SnoBotics981/CAD-MfgResources/ThingiVerse/Soldering_Iron_Stand_-_DotScott1_Remix-2088796/images/182017c3a1575a4c88928a121a70b45b_preview_featured.jpg

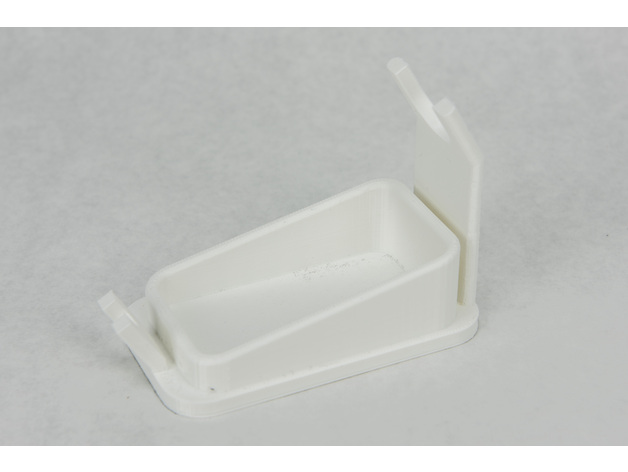
ThingiVerse/Soldering_Iron_Stand_-_DotScott1_Remix-2088796/images/182017c3a1575a4c88928a121a70b45b_preview_featured.jpg
