SnoBotics981/CAD-MfgResources/ThingiVerse/Soldering_Iron_Stand_-_DotScott1_Remix-2088796/images/7b276ec3d47ab2f74ebd15a16277fafa_preview_featured.jpg

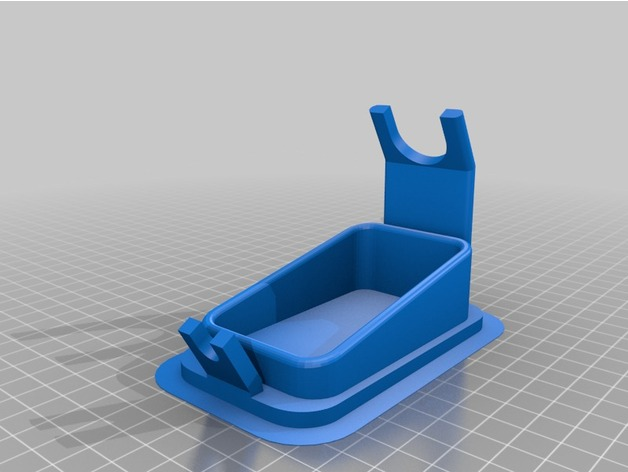
ThingiVerse/Soldering_Iron_Stand_-_DotScott1_Remix-2088796/images/7b276ec3d47ab2f74ebd15a16277fafa_preview_featured.jpg
