SnoBotics981/CAD-MfgResources/README.md

# CAD-MgfResources
This will contain all of the part files from manufactures, which would include Andy-Mark, BostonGears, McMaster-Carr, etc.
