SnoBotics981/CAD-MfgResources/VexRobotics/2017 3CimBallShifter/JVN-DesignCalc.20160126.xlsx

Sheet: READ-ME
JVN DesignCalc - Gearing & Motor Calculator
Release 1/26/2016
Note, this calculator is provided as a design reference ONLY.
I can NOT guarantee the performance of every specific configuration designed by a team.
Contact jvn@vex.com for assistance.
Notes:
 | Drop down cells, used to choose between specifically available options. Click and choose from a list.
 | Entry cells, used to input values specific to the designer's robot. Type custom data.
Release History: |  | http://www.chiefdelphi.com/media/papers/3188?
2015-12-27 | Initial 2016 Release
 | Incorporates the "tested" motor values from motors.vex.com
 | Includes drop-downs to select motors directly from gearing sheets (or you can still enter your own numbers).
 | Includes sheets for design of drivetrains using VEXpro and WCP gearboxes (with drop-down selection of gearing options)
 | Includes a sheet for articulated drives (Butterfly, Octocanum, etc) with different wheel types, and varied gearing between wheels.
 | Some sheets have been simplified for inexperienced users.
 | Sheets have been tweaked to make it easier to have "multiple iterations" on the same worksheet.
2016-01-26 | Added RS-550 Motor Data from motors.vex.com
 | Changed the Motor selection lookup formula on the "non VEXpro" sheets to better allow for multiple iterations on the same sheet
 | Added additional "All MiniCIM" motor selection options on VEXpro sheets
 | Fixed some formatting that no one else would notice but was driving me nuts
 | Added a release history

Sheet: Custom 2-Speed Drive
2-Speed Drivetrain
 |  | Free Speed (RPM) | Stall Torque (N*m) | Stall Current (Amp) | Free Current (Amp) | "Real Life" Speed Loss Constant | Drivetrain Efficiency
 | CIM | 5330 | 2.41 | 131 | 2.7 | 81% | 90%
 | # Gearboxes in Drivetrain | # Motors per Gearbox |  | Total Robot Weight (lbs) | Weight on Driven Wheels | Wheel Dia. (in) | Wheel Coeff
 | 2 | 2 |  | 154 | 100% | 4 | 1.1
 | Driving Gear | Driven Gear |  | High Speed Driving Gear | High Speed Driven Gear | Drivetrain High Gear Free-Speed | Drivetrain High Gear "Real Life" Speed | "Pushing" Current Draw per Motor
 | 12 | 40 |  | 40 | 44 | 12.69 ft/s | 10.28 ft/s | 79.89 Amps
 | 1 | 1 |  |  |  | 7.33 : 1 | <-- High Gear
 | 12 | 24
 |  |  |  | Low Speed Driving Gear | Low Speed Driven Gear | Drivetrain Low Gear Free-Speed | Drivetrain Low Gear "Real Life" Speed | "Pushing" Current Draw per Motor
 | 2.27 x | <--Shifter Spread |  | 24 | 60 | 5.58 ft/s | 4.52 ft/s | 36.66 Amps
 |  |  |  |  |  | 16.67 : 1 | <-- Low Gear

Sheet: VEXpro 3-CIM Ball Shifter
VEXpro 3-CIM Ball Shifter Drivetrain
 |  |  |  |  |  | http://www.vexrobotics.com/vexpro/motion/gearboxes/3cimballshifter.html
 | Choose Gearbox Motors: | Free Speed (RPM) | Stall Torque (N*m) | Stall Current (Amp) | Free Current (Amp)
 | 2 CIM | 5330 | 4.82 | 262 | 5.4
 |  | Wheel Dia. (in) | Wheel Coeff of Friction | Total Robot Weight (lbs) | Weight on Driven Wheels
 |  | 4 | 1.1 | 154 | 100%
 | Select VEXpro Gearbox Options:
 | Choose Motor Pinions: | Standard 12-tooth Pinion [50:12]
 | Choose Low Gear Option: | Low Gear Option 1 (2.16x Shifter Spread) [50:34]
 | Choose 3rd Stage Gearing: | 3rd Stage Option 1 [64:20]
 |  | Driving Gear | Driven Gear
 | External Reduction: | 1 | 1
 | Drivetrain Outputs:
 |  | Drivetrain Free-Speed | Drivetrain "Real Life" Speed | "Pushing" Current Draw per Gearbox | Overal Ratio
 | High Gear Outputs: | 10.26 ft/s | 8.31 ft/s | 130.27 Amps | 9.07 : 1
 | Low Gear Outputs | 4.74 ft/s | 3.84 ft/s | 63.14 Amps | 19.61 : 1
 | Chosen Gearing Config:
 |  | Driving Gear | Driven Gear
 | Initial Gearing Stage: | 12 | 50
 | High Gear Stage: | 50 | 34
 | Low Gear Stage: | 34 | 50
 | 3rd Gearbox Stage: | 20 | 64
 | External Stage: | 1 | 1
 | High-Low Spread: | 2.16 x

Sheet: VEXpro 2-CIM Ball Shifter
VEXpro 2-CIM Ball Shifter Drivetrain
 |  |  |  |  |  | http://www.vexrobotics.com/vexpro/motion/gearboxes/ball-shifter.html
 | Choose Gearbox Motors: | Free Speed (RPM) | Stall Torque (N*m) | Stall Current (Amp) | Free Current (Amp)
 | 2 CIM | 5330 | 4.82 | 262 | 5.4
 |  | Wheel Dia. (in) | Wheel Coeff of Friction | Total Robot Weight (lbs) | Weight on Driven Wheels
 |  | 4 | 1.1 | 154 | 100%
 | Select VEXpro Gearbox Options:
 | Choose Motor Pinions: | Standard 12-tooth Pinion [40:12]
 | Choose 3rd Stage Gearing: | 3rd Stage Option 1 [50:34]
 |  | Driving Gear | Driven Gear
 | External Reduction: | 1 | 1
 | Drivetrain Outputs:
 |  | Drivetrain Free-Speed | Drivetrain "Real Life" Speed | "Pushing" Current Draw per Gearbox | Overal Ratio
 | High Gear Outputs: | 17.25 ft/s | 13.97 ft/s | 215.36 Amps | 5.39 : 1
 | Low Gear Outputs | 7.59 ft/s | 6.15 ft/s | 97.78 Amps | 12.25 : 1
 | Chosen Gearing Config:
 |  | Driving Gear | Driven Gear
 | Initial Gearing Stage: | 12 | 40
 | High Gear Stage: | 40 | 44
 | Low Gear Stage: | 24 | 60
 | 3rd Gearbox Stage: | 34 | 50
 | External Stage: | 1 | 1
 | High-Low Spread: | 2.27 x

Sheet: WCP DS
WCP DS Gearbox Drivetrain
 |  |  |  |  |  | http://www.vexrobotics.com/vexpro/motion/gearboxes/wcp-ds.html
 | Choose Gearbox Motors: | Free Speed (RPM) | Stall Torque (N*m) | Stall Current (Amp) | Free Current (Amp)
 | 3 CIM | 5330 | 7.23 | 393 | 8.1
 |  | Wheel Dia. (in) | Wheel Coeff of Friction | Total Robot Weight (lbs) | Weight on Driven Wheels
 |  | 4 | 1.1 | 154 | 100%
 | Select WCP DS Gearbox Options:
 | Choose Initial Reduction: | 12:42
 | Choose Low Gear Option: | 24:50
 | Choose High Gear Option: | 30:44
 |  | Driving Gear | Driven Gear
 | External Reduction: | 1 | 1
 | Drivetrain Outputs:
 |  | Drivetrain Free-Speed | Drivetrain "Real Life" Speed | "Pushing" Current Draw per Gearbox | Overal Ratio
 | High Gear Outputs: | 18.12 ft/s | 14.68 ft/s | 228.65 Amps | 5.13 : 1
 | Low Gear Outputs | 12.76 ft/s | 10.33 ft/s | 163.37 Amps | 7.29 : 1
 | Chosen Gearing Config:
 |  | Driving Gear | Driven Gear
 | Initial Gearing Stage: | 12 | 42
 | Low Gear Stage: | 24 | 50
 | High Gear Stage: | 30 | 44
 | External Stage: | 1 | 1
 | High-Low Spread: | 1.42 x

Sheet: Custom 1-Speed Drive
1-Speed Drivetrain
 |  | Free Speed (RPM) | Stall Torque (N*m) | Stall Current (Amp) | Free Current (Amp) | Speed Loss Constant | Drivetrain Efficiency
 | CIM | 5330 | 2.41 | 131 | 2.7 | 81% | 90%
 | # Gearboxes in Drivetrain | # Motors per Gearbox |  | Total Weight (lbs) | Weight on Driven Wheels | Wheel Dia. (in) | Wheel Coeff
 | 2 | 2 |  | 154 | 100% | 4 | 1.1
 | Driving Gear | Driven Gear |  | Drivetrain Free-Speed | Drivetrain Adjusted Speed | "Pushing" Current Draw per Motor
 | 12 | 40 |  | 6.66 ft/s | 5.39 ft/s | 43.23 Amps
 | 14 | 40 |  | 13.97 : 1 | <-- Overall Gear Ratio
 | 15 | 22
 | 1 | 1

Sheet: VEXpro SS,DR
VEXpro Single Speed, Double Reduction Drivetrain
 |  |  |  |  |  | http://www.vexrobotics.com/vexpro/motion/gearboxes/single-speed-double-reduction.html
 | Choose Gearbox Motors: | Free Speed (RPM) | Stall Torque (N*m) | Stall Current (Amp) | Free Current (Amp)
 | 2 CIM | 5330 | 4.82 | 262 | 5.4
 |  | Wheel Dia. (in) | Wheel Coeff of Friction | Total Robot Weight (lbs) | Weight on Driven Wheels
 |  | 4 | 1.1 | 154 | 100%
 | Select VEXpro Gearbox Options:
 | Choose Motor Pinions: | Standard 12-tooth Pinion [40:12]
 | Choose 2nd Stage Gearing: | Standard 2nd Stage [40:14]
 |  | Driving Gear | Driven Gear
 | Additional External Reduction: | 1 | 1
 | Drivetrain Outputs:
 |  | Drivetrain Free-Speed | Drivetrain "Real Life" Speed | "Pushing" Current Draw per Gearbox | Overal Ratio
 |  | 9.77 ft/s | 7.91 ft/s | 124.27 Amps | 9.52 : 1
 | Chosen Gearing Config:
 |  | Driving Gear | Driven Gear
 | Initial Gearing Stage: | 12 | 40
 | 2nd Gearbox Stage: | 14 | 40
 | External Stage: | 1 | 1

Sheet: WCP SS
WCP SS Gearbox Drivetrain
 |  |  |  |  |  | http://www.vexrobotics.com/vexpro/motion/gearboxes/wcp-ss.html
 | Choose Gearbox Motors: | Free Speed (RPM) | Stall Torque (N*m) | Stall Current (Amp) | Free Current (Amp)
 | 3 CIM | 5330 | 7.23 | 393 | 8.1
 |  | Wheel Dia. (in) | Wheel Coeff of Friction | Total Robot Weight (lbs) | Weight on Driven Wheels
 |  | 4 | 1.1 | 154 | 100%
 | Select VEXpro Gearbox Options:
 | Choose Motor Pinions: | 11-tooth Pinion [50:11]
 | Choose 2nd Stage Gearing: | 2nd Stage Option 1 [40:34]
 |  | Driving Gear | Driven Gear
 | Additional External Reduction: | 1 | 1
 | Drivetrain Outputs:
 |  | Drivetrain Free-Speed | Drivetrain "Real Life" Speed | "Pushing" Current Draw per Gearbox | Overal Ratio
 |  | 17.40 ft/s | 14.09 ft/s | 219.81 Amps | 5.35 : 1
 | Chosen Gearing Config:
 |  | Driving Gear | Driven Gear
 | Initial Gearing Stage: | 11 | 50
 | 2nd Gearbox Stage: | 34 | 40
 | External Stage: | 1 | 1

Sheet: Articulating Drive
Articulating Drivetrain
 |  | Free Speed (RPM) | Stall Torque (N*m) | Stall Current (Amp) | Free Current (Amp) | Speed Loss Constant | Drivetrain Efficiency
 | CIM | 5330 | 2.41 | 131 | 2.7 | 81% | 90%
 | # Gearboxes in Drivetrain | # Motors per Gearbox |  | Total Weight (lbs) | Weight on Driven Wheels | Robot (lbs) | Bumpers (lbs) | Battery (lbs)
 | 4 | 1 |  | 154 | 100% | 120 | 20 | 14
 | Drivetrain Config:
 | Primary Wheel Dia. (in) | Primary Coeff |  | Driving Gear | Driven Gear | Primary Free-Speed (ft/s) | Primary Adjusted Speed (ft/s) | "Pushing" Current Draw per Motor
 | 4 | 1.1 |  | 12 | 64 | 17.44 | 14.13 | 108.84 Amps
 |  |  |  | 1 | 1
 | Secondary Wheel Dia. (in) | Secondary Coeff |  | Driving Gear | Driven Gear | Secondary Free-Speed (ft/s) | Secondary Adjusted Speed (ft/s) | "Pushing" Current Draw per Motor
 | 4 | 1.2 |  | 12 | 64 | 7.48 | 6.05 | 52.32 Amps
 |  |  |  | 18 | 42 | 2.333333333 | <--"Shifter" Spread

Sheet: Rotary Mechanism
Rotary Mechanism
 |  | Free Speed (RPM) | Stall Torque (N*m) | Stall Current (Amp) | Free Current (Amp)
 | BAG Motor | 13180 | 0.43 | 53 | 1.8
 | # Motors per Gearbox | Gearbox Efficiency |  | Arm Load (lbs) | Arm Length (in)
 | 1 | 65% |  | 10 | 40
 | Driving Gear | Driven Gear |  | Arm Rotational Speed | Arm Time to move 90-degrees
 | 1 | 10 | No Load: | 169.5 deg/s | 0.53 sec
 | 1 | 10 | Loaded: | 110.7 deg/s | 0.81 sec
 | 18 | 84
 | 1 | 1
 | 466.67 : 1 | <-- Overall Ratio |  | Current Draw per Motor (loaded) | Stall Load
 |  |  |  | 13.33 amps | 28.86 lbs

Sheet: Linear Mechanism
Linear Mechanism
 |  | Free Speed (RPM) | Stall Torque (N*m) | Stall Current (Amp) | Free Current (Amp)
 | BAG Motor | 13180 | 0.43 | 53 | 1.8
 | # Motors per Gearbox | Gearbox Efficiency | Travel Distance (in) | Applied Load (lbs) | Pulley Diameter (in)
 | 1 | 80% | 48 | 154 | 2
 | Driving Gear | Driven Gear |  | Elevator Linear Speed | Arm Time to move Travel Distance
 | 1 | 10 | No Load: | 13.8 in/s | 3.48 sec
 | 1 | 10 | Loaded: | 6.8 in/s | 7.04 sec
 | 1 | 1
 | 1 | 1
 | 100.00 : 1 | <-- Overall Ratio |  | Current Draw per Motor (loaded) | Stall Load
 |  |  |  | 22.52 amps | 304.45 lbs

Sheet: Intake Mechanism
Intake Mechanism
 |  | Free Speed (RPM) | Stall Torque (N*m) | Stall Current (Amp) | Free Current (Amp)
 | BAG Motor | 13180 | 0.43 | 53 | 1.8
 | # Motors per Gearbox | Gearbox Efficiency | Travel Distance (in) | # Intake Sides (1 or 2) | Roller Diameter (in) | Drag Load (lb)
 | 1 | 80% | 40 | 1 | 2 | 10
 | Driving Gear | Driven Gear |  | Intake Linear Speed | Intake Time to move Travel Distance
 | 1 | 10 | No Load: | 138.0 in/s | 0.29 sec
 | 1 | 1 | Loaded: | 92.6 in/s | 0.43 sec
 | 1 | 1
 | 1 | 1
 | 10.00 : 1 | <-- Overall Ratio |  | Current Draw per Motor (loaded) | Stall Drag Load
 |  |  |  | 28.71 amps | 30.45 lbs

Sheet: DATA
Motor Specifications
All specifications listed at 12V based on empirical testing by VEX Robotics, "combined motor" specs calculated using Paul Copioli's "Useful Calculations" spreadsheet.
For testing details refer to: motors.vex.com |  |  |  |  |  | Specs used for VEXpro & WCP Gearbox Calculators
 | Free Speed (RPM) | Stall Torque (N-m) | Stall Current (Amp) | Free Current (Amp) | Power (W) |  | Free Speed (RPM) | Stall Torque (N*m) | Stall Current (Amp) | Free Current (Amp) | Power (W)
CIM | 5330 | 2.41 | 131.00 | 2.70 | 336.29 | 1 Mini CIM | 5840 | 1.41 | 89.00 | 3.00 | 215.58
Mini CIM | 5840 | 1.41 | 89.00 | 3.00 | 215.58 | 1 CIM | 5330 | 2.41 | 131.00 | 2.70 | 336.29
BAG Motor | 13180 | 0.43 | 53.00 | 1.80 | 148.37 | 2 Mini CIM | 5840 | 2.82 | 178.00 | 6.00 | 431.15
775pro | 18730 | 0.71 | 134.00 | 0.70 | 348.15 | 1 CIM + 1 Mini CIM (Copioli) | 5508 | 3.82 | 220 | 8.16 | 550.84
AM 775 | 5800 | 0.28 | 18.00 | 1.60 | 42.52 | 3 Mini CIM | 5840 | 4.23 | 267 | 9 | 646.73
AM 9015 | 14270 | 0.36 | 71 | 3.7 | 134.49 | 2 CIM | 5330 | 4.82 | 262.00 | 5.40 | 672.58
1 CIM + 1 Mini CIM (Copioli) | 5508 | 3.82 | 220 | 8.16 | 550.84 | 1 CIM + 2 Mini CIM (Copioli) | 5593 | 5.23 | 309 | 9.62 | 765.80
1 CIM + 2 Mini CIM (Copioli) | 5593 | 5.23 | 309 | 9.62 | 765.80 | 2 CIM + 1 Mini CIM (Copioli) | 5437 | 6.23 | 351 | 9.15 | 886.78
2 CIM + 1 Mini CIM (Copioli) | 5437 | 6.23 | 351 | 9.15 | 886.78 | 3 CIM | 5330 | 7.23 | 393.00 | 8.10 | 1008.87
BB RS-775-18 | 13050 | 0.72 | 97.00 | 2.70 | 245.99
BB RS-550 | 19000 | 0.38 | 84.00 | 0.40 | 189.02
 |  |  |  |  | 0.00 | 1 Mini CIM | 5840 | 1.41 | 89.00 | 3.00 | 215.58
 |  |  |  |  | 0.00 | 1 CIM | 5330 | 2.41 | 131.00 | 2.70 | 336.29
 |  |  |  |  | 0.00 | 2 Mini CIM | 5840 | 2.82 | 178.00 | 6.00 | 431.15
 |  |  |  |  | 0.00 | 1 CIM + 1 Mini CIM (Copioli) | 5508 | 3.82 | 220 | 8.16 | 550.84
 |  |  |  |  | 0.00 | 2 CIM | 5330 | 4.82 | 262.00 | 5.40 | 672.58
WCP - DS Gear Options
Input Stage
11:42 | 11 | 42
12:42 | 12 | 42
13:42 | 13 | 42
13:40 | 13 | 40
14:42 | 14 | 42
14:40 | 14 | 40
Low Gear Options
14:60 | 14 | 60
24:50 | 24 | 50
High Gear Options
24:50 | 24 | 50
30:44 | 30 | 44
34:40 | 34 | 40
3-CIM Ball Shifter
Initial Stage
Standard 12-tooth Pinion [50:12] | 12 | 50
Optional 11-tooth Pinion [50:11] | 11 | 50
High Gear | 50 | 34
Low Gear Option 1 (2.16x Shifter Spread) [50:34] | 34 | 50
Low Gear Option 2 (2.65x Shifter Spread) [54:30] | 30 | 54
Low Gear Option 3 (3.68x Shifter Spread) [60:24] | 24 | 60
NO 3rd Stage Gearing | 1 | 1
3rd Stage Option 1 [64:20] | 20 | 64
3rd Stage Option 2 [60:24] | 24 | 60
3rd Stage Option 3 [54:30] | 30 | 54
3rd Stage Option 4 [50:34] | 34 | 50
2-CIM Ball Shifter
Initial Stage
Standard 12-tooth Pinion [40:12] | 12 | 40
Optional 11-tooth Pinion [40:11] | 11 | 40
NO 3rd Stage Gearing | 1 | 1
3rd Stage Option 1 [50:34] | 34 | 50
3rd Stage Option 2 [54:30] | 30 | 54
3rd Stage Option 3 [60:24] | 24 | 60
3rd Stage Option 4 [64:20] | 20 | 64
Standard 2nd Stage [40:14] | 14 | 40
Optional 2nd Stage [34:20] | 20 | 34
Optional 2nd Stage [30:24] | 24 | 30
WCP - SS Gear Options
Input Stage
11-tooth Pinion [50:11] | 11 | 50
12-tooth Pinion [50:12] | 12 | 50
13-tooth Pinion [50:13] | 13 | 50
14-tooth Pinion [50:14] | 14 | 50
Second Stage
2nd Stage Option 1 [40:34] | 34 | 40
2nd Stage Option 2 [44:30] | 30 | 44
2nd Stage Option 3 [50:24] | 24 | 50
2nd Stage Option 4 [54:20] | 20 | 54
2nd Stage Option 5 [60:14] | 14 | 60
