SnoBotics981/CAD-MfgResources/Andy-Mark/Pixy Camera/PixyCam+Pinout+Graphic.pdf

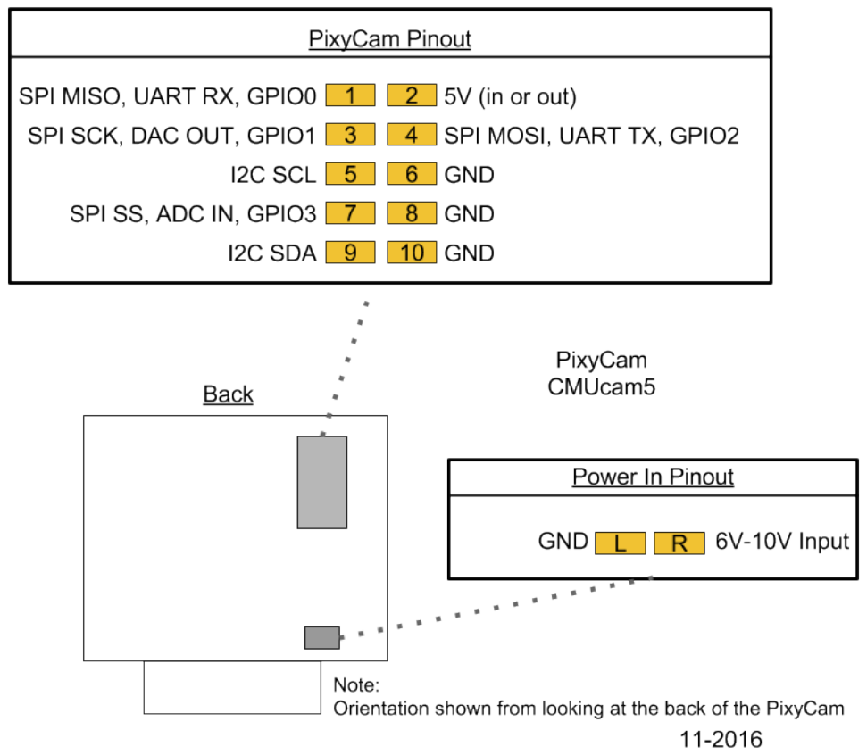
[picture p6: page 1]
