SnoBotics981/CAD-MfgResources/Andy-Mark/2018 Kit Bot/AM14U3_2018BumperAttach.pdf

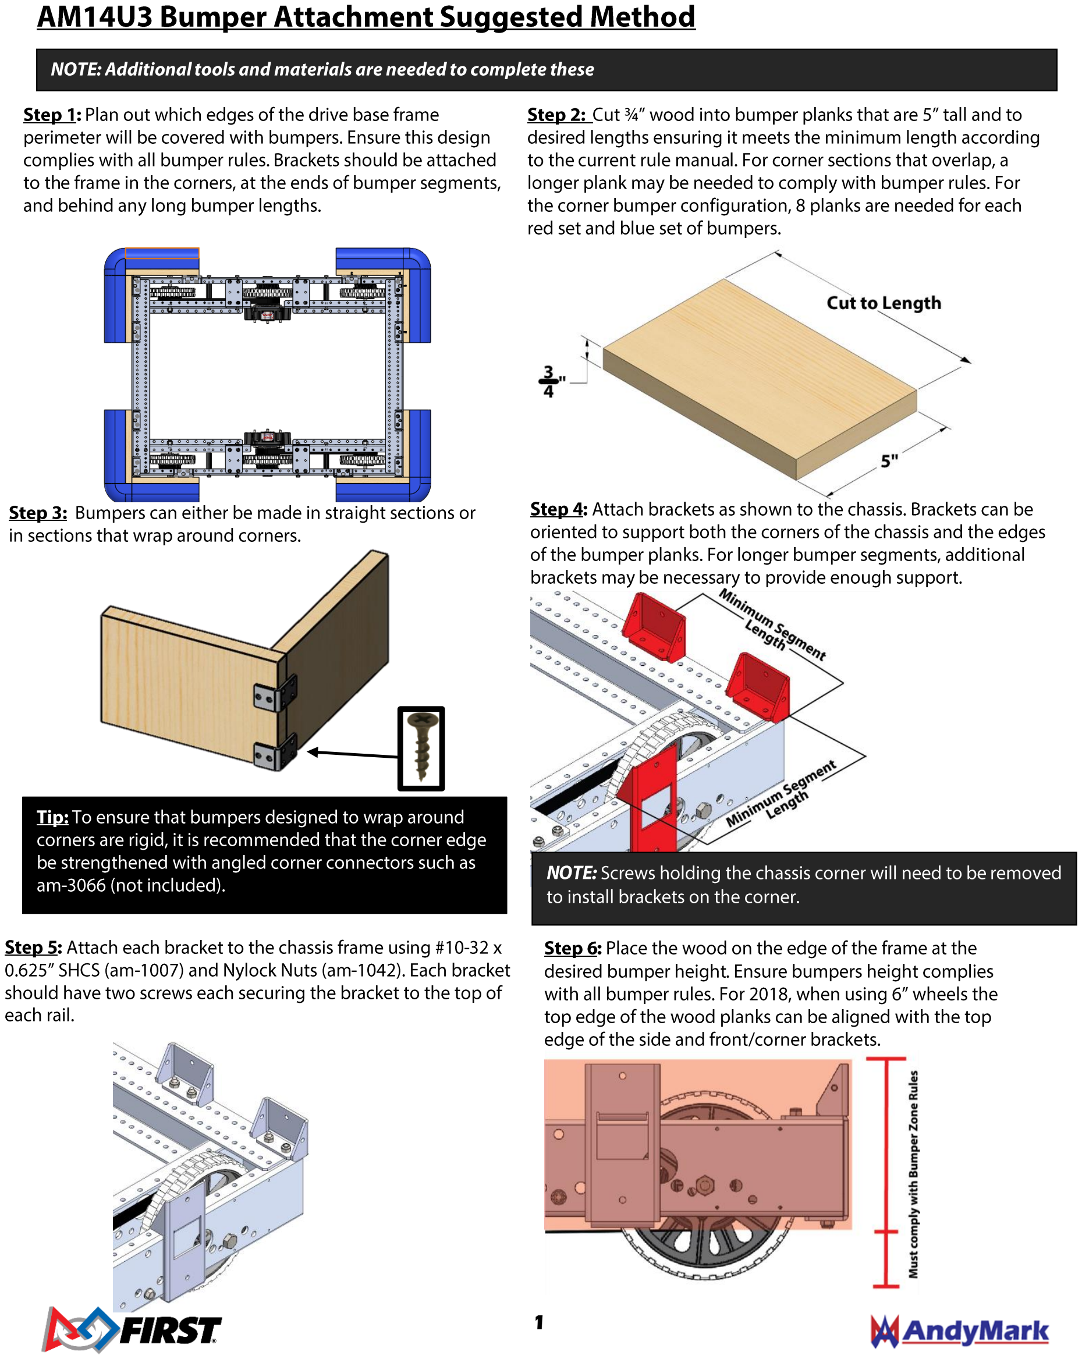
[picture p7: page 1]

1

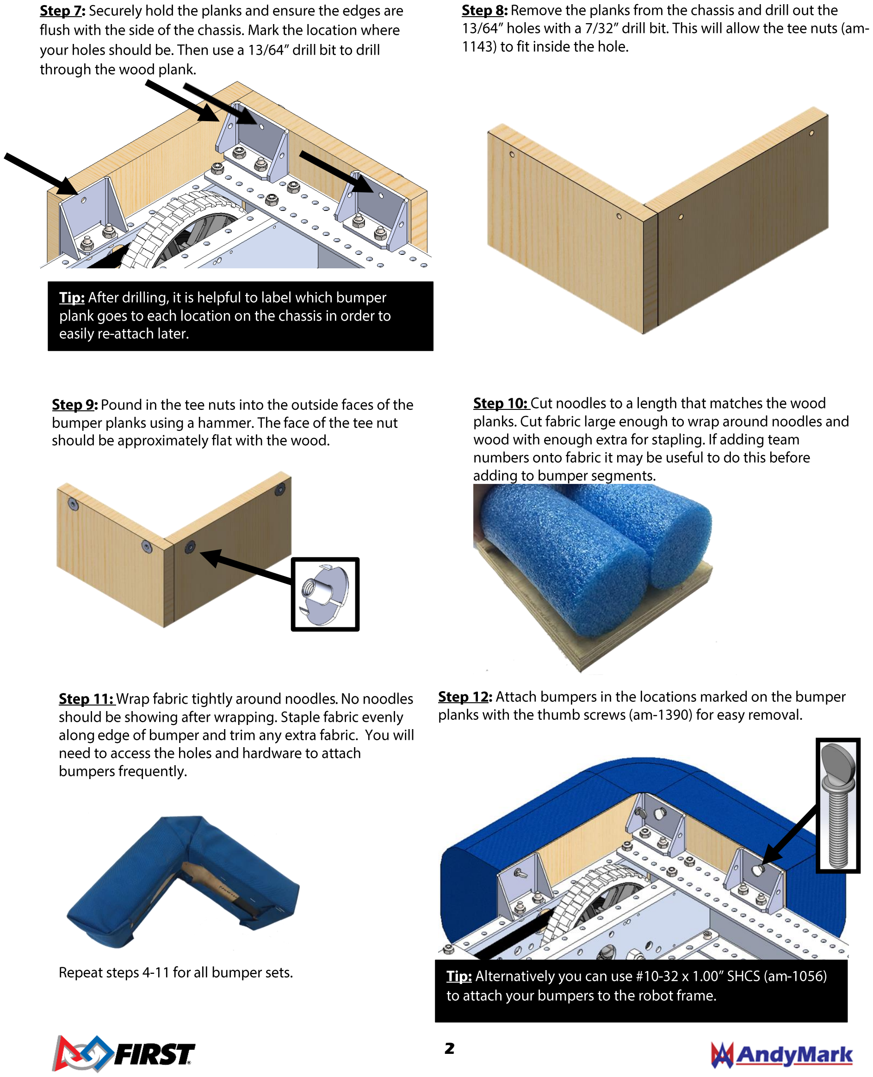
[picture p8: page 2]

2
