SnoBotics981/CAD-MfgResources/Andy-Mark/AM14U3BumperKit/am-3676+AM14U3_2018BumperAttach.pdf

1


2
