SnoBotics981/CAD-MfgResources/Andy-Mark/Pixy Camera/ProgramExample.pdf

Pixy_Example.png (PNG Image, 445 × 234 pixels) | http://files.andymark.com/Graphics/Pixy_Example.png

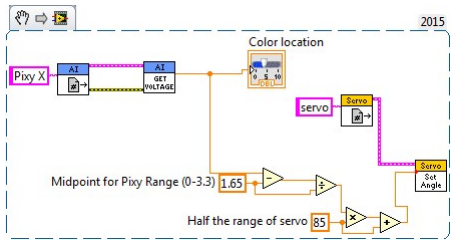
[picture p9: figure]

1 of 1 | 8/9/2017 7:49 AM
