SnoBotics981/CAD-MfgResources/Andy-Mark/2017 Kit Bot Chassis/16-01.png

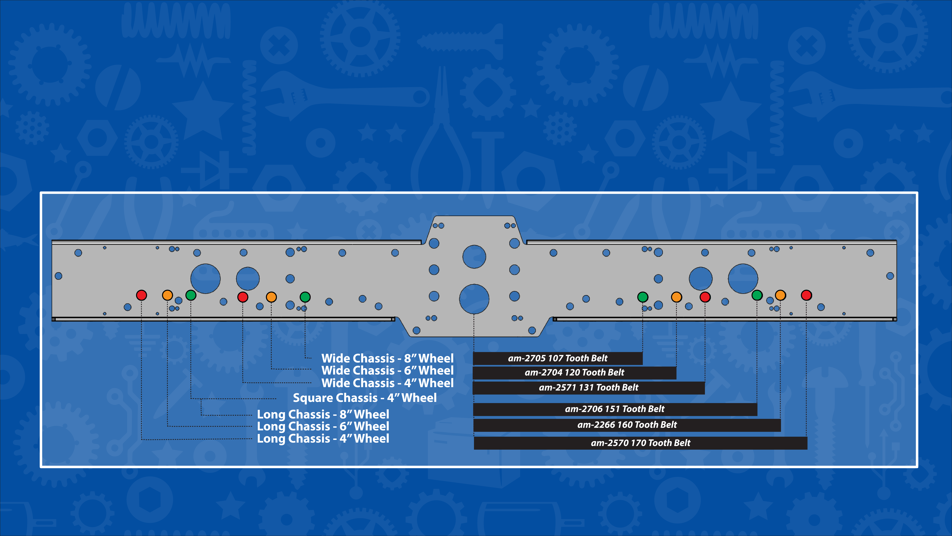
Andy-Mark/2017 Kit Bot Chassis/16-01.png
