SnoBotics981/CAD-MfgResources/McMaster-Carr/Aluminum Slip-On Rail Fitting/4699t291s.gif

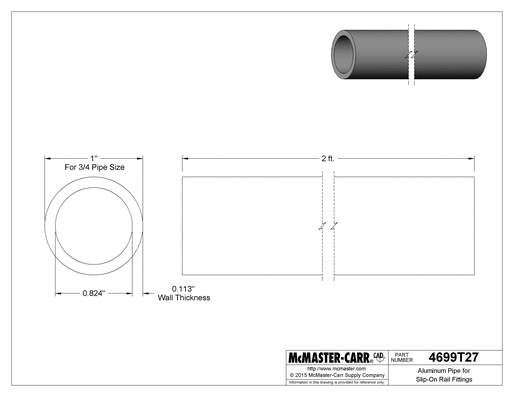
McMaster-Carr/Aluminum Slip-On Rail Fitting/4699t291s.gif
