SnoBotics981/CAD-MfgResources/McMaster-Carr/Nut/8_32_Nut/Low-Strength Steel Hex Nut, Zinc-Plated, 8-32 Thread Size _ McMaster-Carr_files/90480a009l.gif

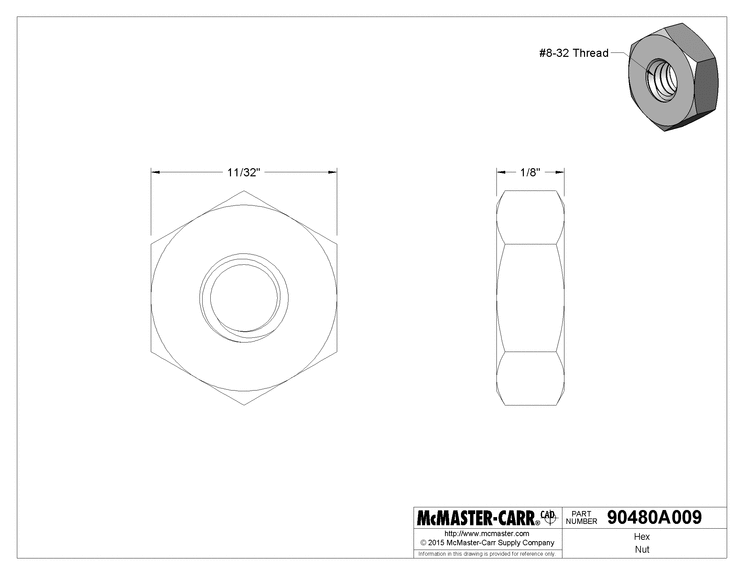
McMaster-Carr/Nut/8_32_Nut/Low-Strength Steel Hex Nut, Zinc-Plated, 8-32 Thread Size _ McMaster-Carr_files/90480a009l.gif
