SnoBotics981/CAD-MfgResources/ThingiVerse/2019_FRC_Battery_Handle/images/206ea4fa08b359686b6bfd9d1267fd34_preview_featured.jpg

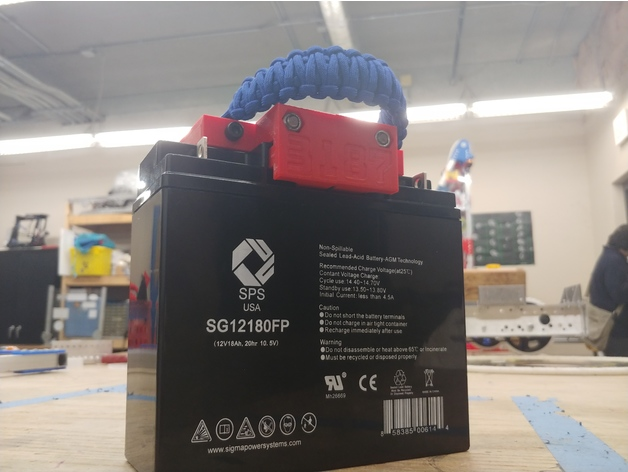
ThingiVerse/2019_FRC_Battery_Handle/images/206ea4fa08b359686b6bfd9d1267fd34_preview_featured.jpg
