SnoBotics981/CAD-MfgResources/ThingiVerse/2019_FRC_Battery_Handle/images/f3ccdd27d2000e3f9255a7e3e2c48800_preview_featured.jpg

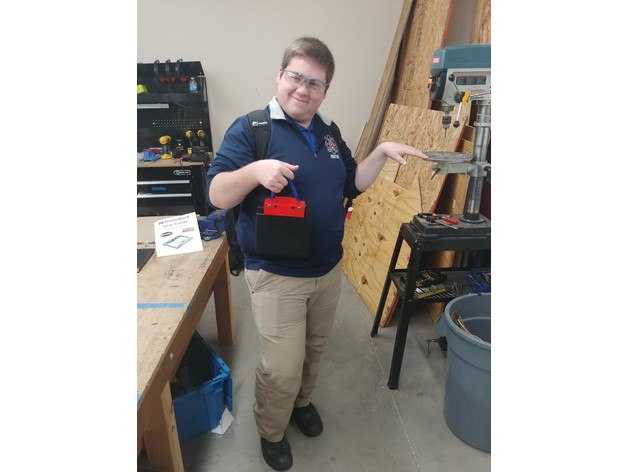
ThingiVerse/2019_FRC_Battery_Handle/images/f3ccdd27d2000e3f9255a7e3e2c48800_preview_featured.jpg
