SnoBotics981/CAD-MfgResources/ThingiVerse/Customized Containers/images/1cbbcfded8d56e56f810397a6b7f5251_preview_featured.jpg

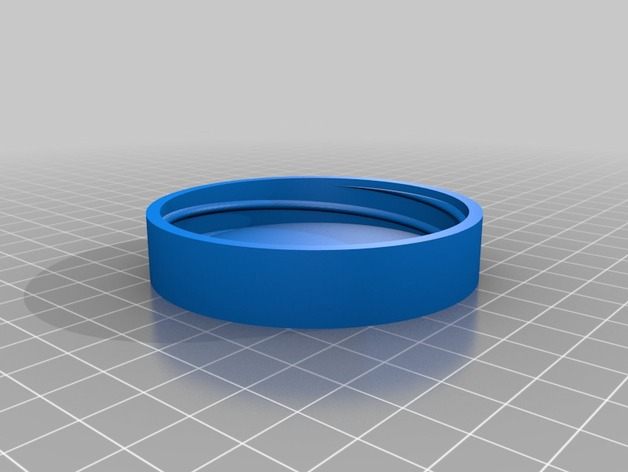
ThingiVerse/Customized Containers/images/1cbbcfded8d56e56f810397a6b7f5251_preview_featured.jpg
