SnoBotics981/CAD-MfgResources/ThingiVerse/Customized Containers/images/7fcee140ac5466b9864879e9003e2eb7_preview_featured.jpg

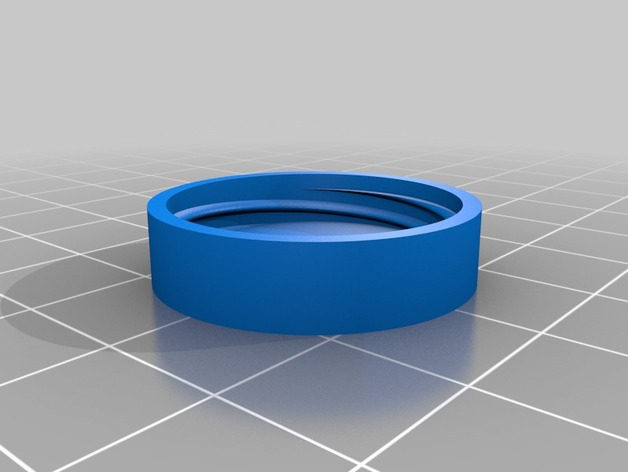
ThingiVerse/Customized Containers/images/7fcee140ac5466b9864879e9003e2eb7_preview_featured.jpg
