SnoBotics981/CAD-MfgResources/ThingiVerse/Customized Containers/images/40x30_cut_preview_featured.jpg

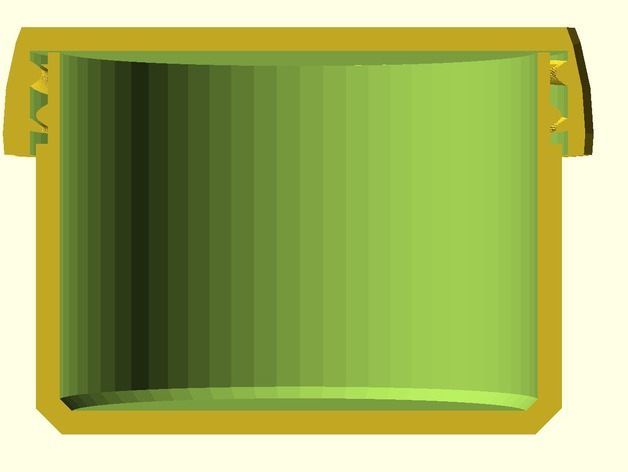
ThingiVerse/Customized Containers/images/40x30_cut_preview_featured.jpg
