SnoBotics981/CAD-MfgResources/ThingiVerse/Customized Containers/images/81c618c97ff7945d2bcece413d6ca728_preview_featured.jpg

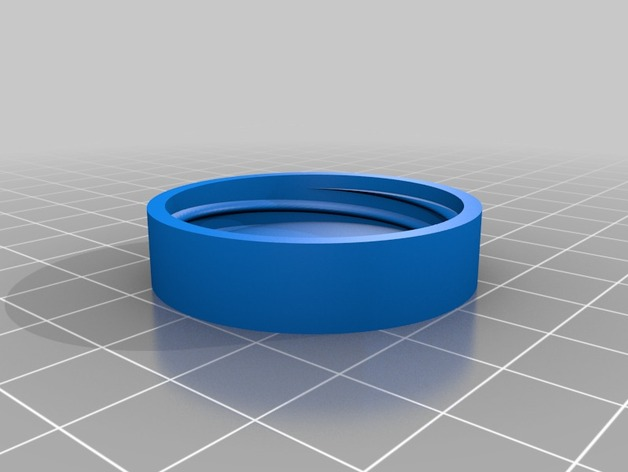
ThingiVerse/Customized Containers/images/81c618c97ff7945d2bcece413d6ca728_preview_featured.jpg
