SnoBotics981/CAD-MfgResources/ThingiVerse/Customized Containers/images/00589475ceabfa14e679b2aa7c6348ed_preview_featured.jpg

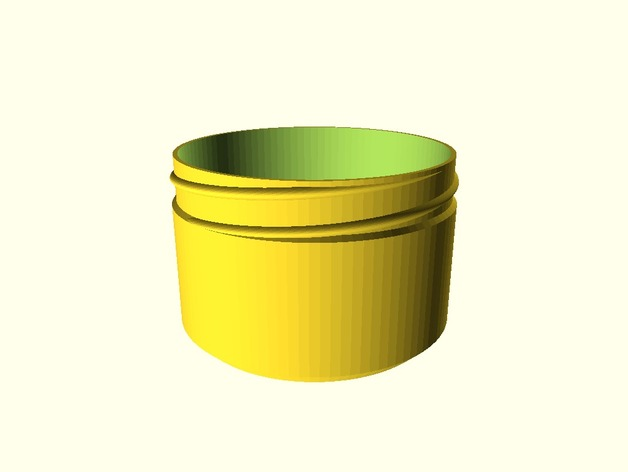
ThingiVerse/Customized Containers/images/00589475ceabfa14e679b2aa7c6348ed_preview_featured.jpg
