SnoBotics981/CAD-MfgResources/ThingiVerse/Customized Containers/images/6516588138d93ec0d59faace3177b5e7_preview_featured.jpg

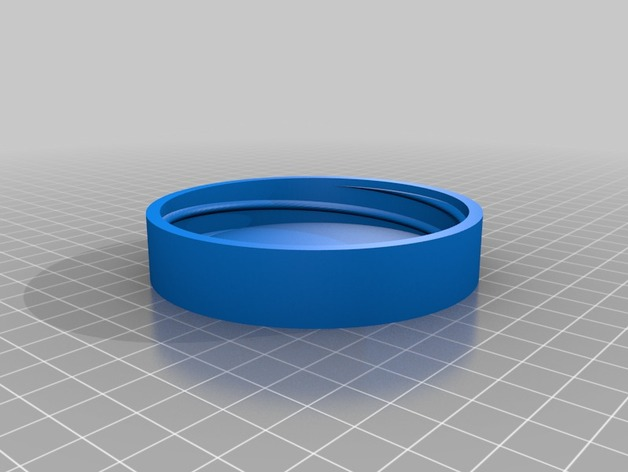
ThingiVerse/Customized Containers/images/6516588138d93ec0d59faace3177b5e7_preview_featured.jpg
