SnoBotics981/CAD-MfgResources/ThingiVerse/Customized Containers/images/Container20x20_preview_featured.jpg

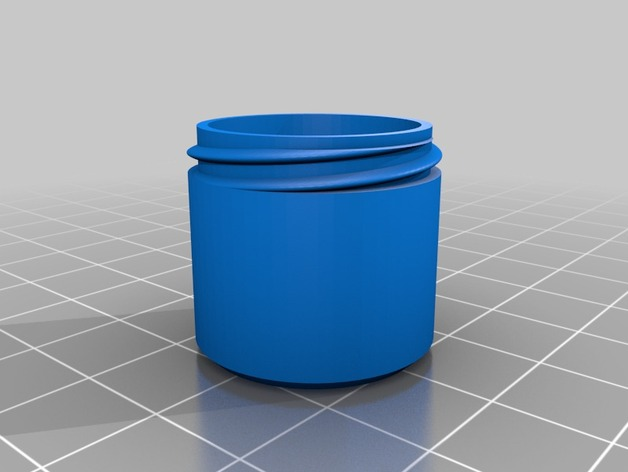
ThingiVerse/Customized Containers/images/Container20x20_preview_featured.jpg
