SnoBotics981/CAD-MfgResources/ThingiVerse/Customized Containers/images/Container20x30_preview_featured.jpg

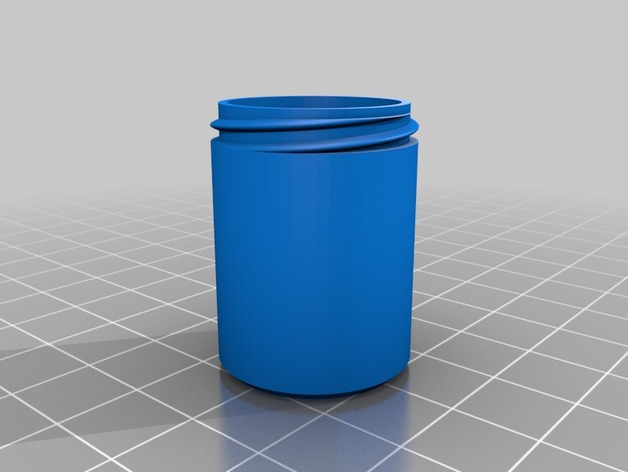
ThingiVerse/Customized Containers/images/Container20x30_preview_featured.jpg
