SnoBotics981/CAD-MfgResources/ThingiVerse/Customized Containers/images/DSC01001_preview_featured.JPG

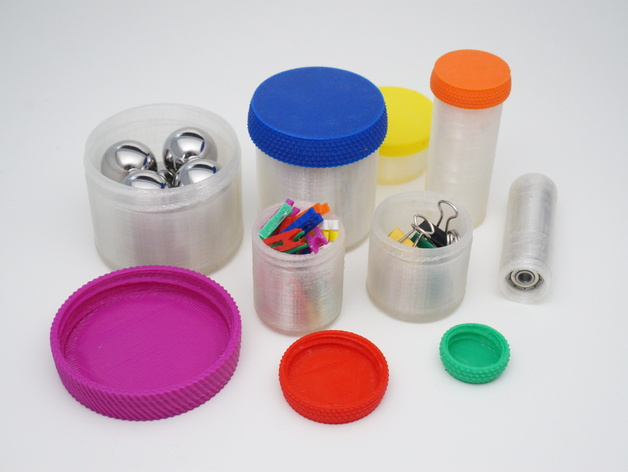
ThingiVerse/Customized Containers/images/DSC01001_preview_featured.JPG
