SnoBotics981/CAD-MfgResources/ThingiVerse/Customized Containers/images/DSC01179_preview_featured.JPG

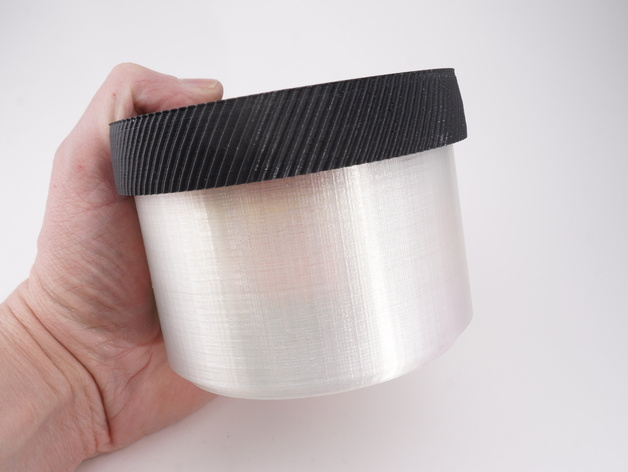
ThingiVerse/Customized Containers/images/DSC01179_preview_featured.JPG
