SnoBotics981/CAD-MfgResources/ThingiVerse/Customized Containers/images/FireShot_Screen_Capture_001_-_App__Customizer_-_Thingiverse_-_www_thingiverse_com_apps_customizer_run_thing_id612709code03528fcbb53eafbcb6782c053b501a66_preview_featured.jpg

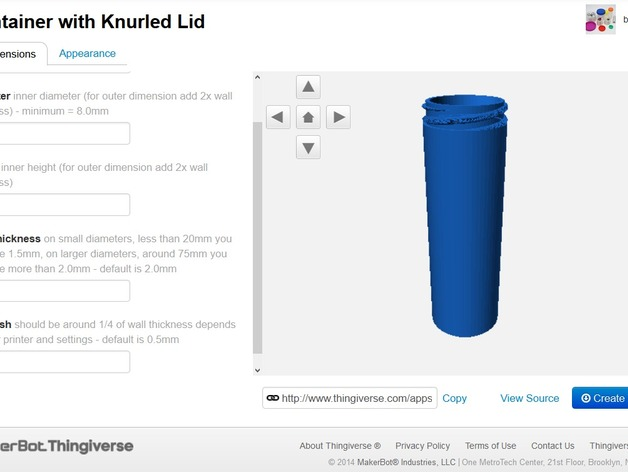
ThingiVerse/Customized Containers/images/FireShot_Screen_Capture_001_-_App__Customizer_-_Thingiverse_-_www_thingiverse_com_apps_customizer_run_thing_id612709code03528fcbb53eafbcb6782c053b501a66_previ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
