SnoBotics981/CAD-MfgResources/ThingiVerse/Customized Containers/images/Lid25_double_knurled_preview_featured.jpg

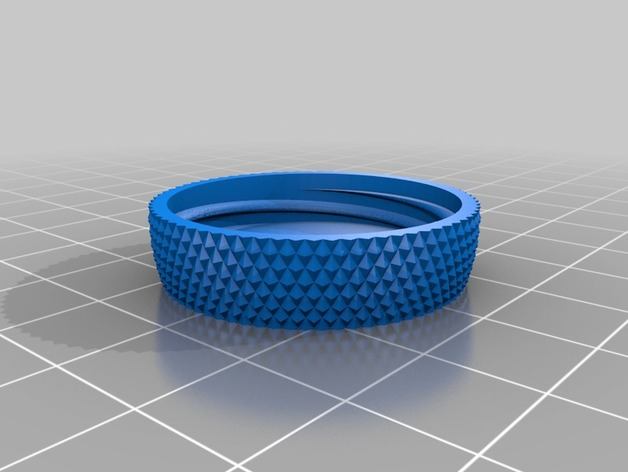
ThingiVerse/Customized Containers/images/Lid25_double_knurled_preview_featured.jpg
