SnoBotics981/CAD-MfgResources/ThingiVerse/Customized Containers/images/Lid40_double_knurled_preview_featured.jpg

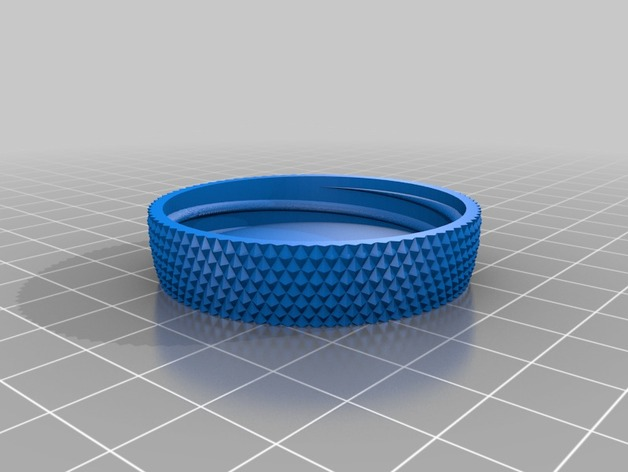
ThingiVerse/Customized Containers/images/Lid40_double_knurled_preview_featured.jpg
