SnoBotics981/CAD-MfgResources/ThingiVerse/FIRST RobotRio Mounting Bracket/images/IMG_1240_preview_featured.JPG

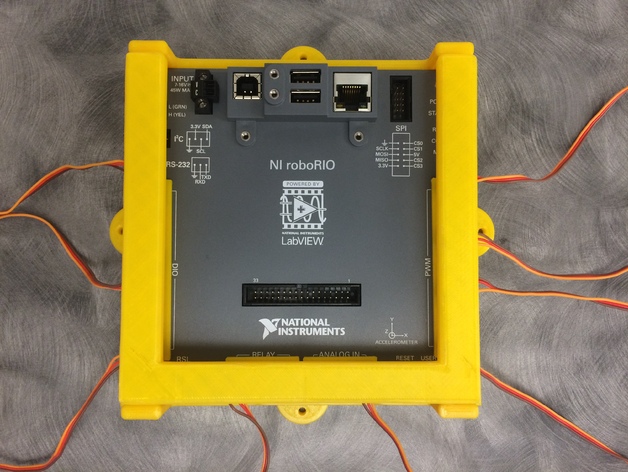
ThingiVerse/FIRST RobotRio Mounting Bracket/images/IMG_1240_preview_featured.JPG
