SnoBotics981/CAD-MfgResources/ThingiVerse/FIRST RobotRio Mounting Bracket/images/IMG_1242_preview_featured.JPG

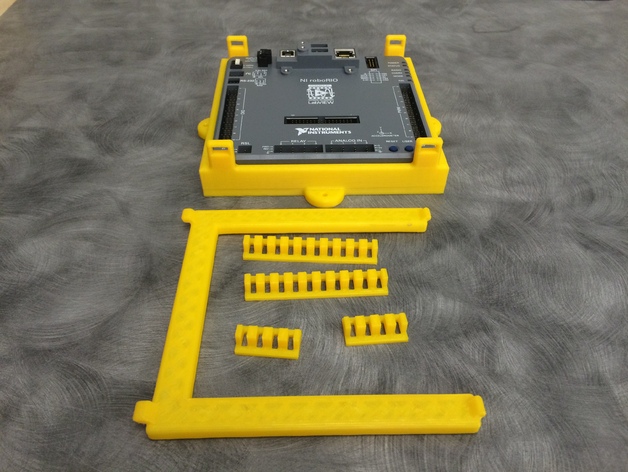
ThingiVerse/FIRST RobotRio Mounting Bracket/images/IMG_1242_preview_featured.JPG
