SnoBotics981/CAD-MfgResources/ThingiVerse/FIRST RobotRio Mounting Bracket/images/Robo_Rio_Mount_preview_featured.jpg

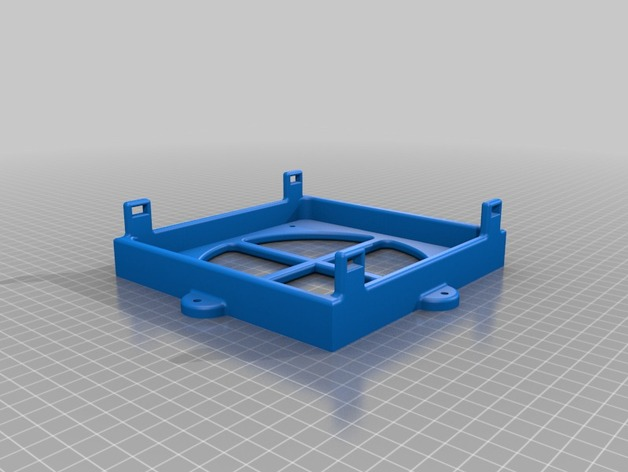
ThingiVerse/FIRST RobotRio Mounting Bracket/images/Robo_Rio_Mount_preview_featured.jpg
