SnoBotics981/CAD-MfgResources/ThingiVerse/FIRST RobotRio Mounting Bracket/images/Robo_Rio_S_Cable_Alignment_preview_featured.jpg

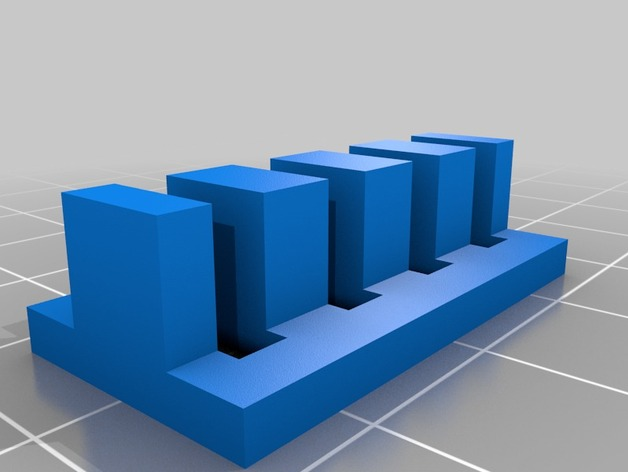
ThingiVerse/FIRST RobotRio Mounting Bracket/images/Robo_Rio_S_Cable_Alignment_preview_featured.jpg
