SnoBotics981/CAD-MfgResources/ThingiVerse/Grinder-double_gear-V2.0/images/0a725a010b92bdbcccfef97328199cdc_preview_featured.jpg

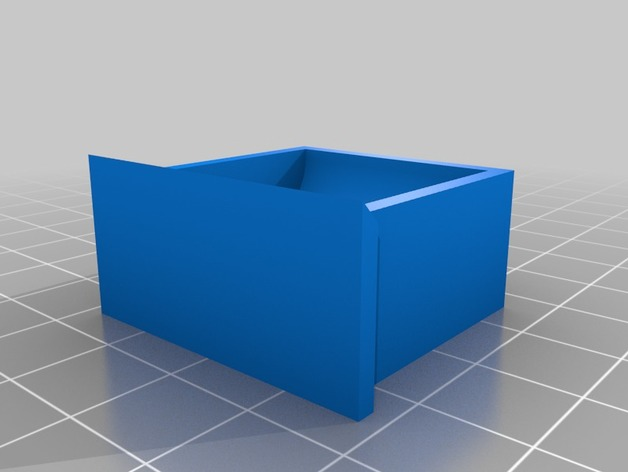
ThingiVerse/Grinder-double_gear-V2.0/images/0a725a010b92bdbcccfef97328199cdc_preview_featured.jpg
