SnoBotics981/CAD-MfgResources/ThingiVerse/Grinder-double_gear-V2.0/images/2de40e0d504f583cda7465979f958a98_preview_featured.jpg

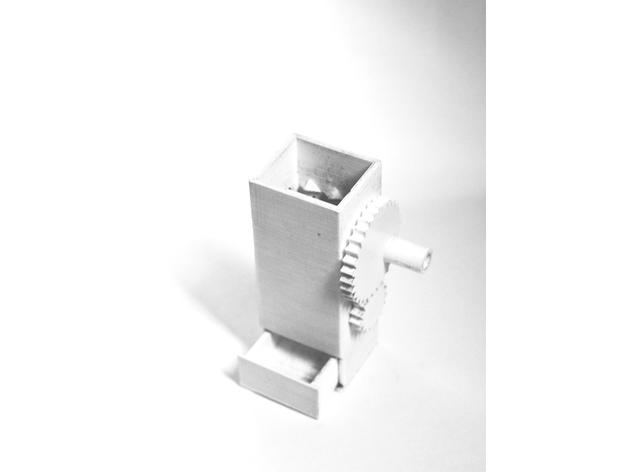
ThingiVerse/Grinder-double_gear-V2.0/images/2de40e0d504f583cda7465979f958a98_preview_featured.jpg
