SnoBotics981/CAD-MfgResources/ThingiVerse/Grinder-double_gear-V2.0/images/3fb5ed13afe8714a7e5d13ee506003dd_preview_featured.jpg

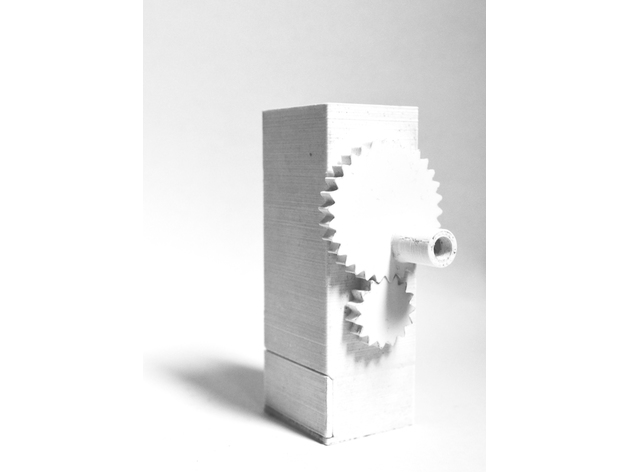
ThingiVerse/Grinder-double_gear-V2.0/images/3fb5ed13afe8714a7e5d13ee506003dd_preview_featured.jpg
