SnoBotics981/CAD-MfgResources/ThingiVerse/Grinder-double_gear-V2.0/images/4efdd2f969559e8b1c92e99f32ded48e_preview_featured.jpg

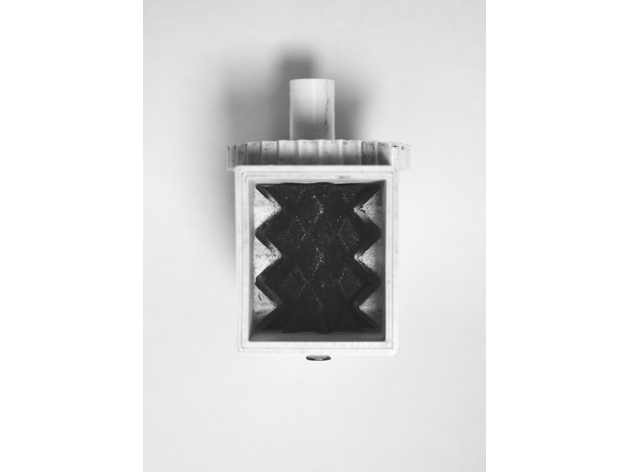
ThingiVerse/Grinder-double_gear-V2.0/images/4efdd2f969559e8b1c92e99f32ded48e_preview_featured.jpg
