SnoBotics981/CAD-MfgResources/ThingiVerse/Grinder-double_gear-V2.0/images/58f7d8c99e5e17ae856188f63aca0ae0_preview_featured.jpg

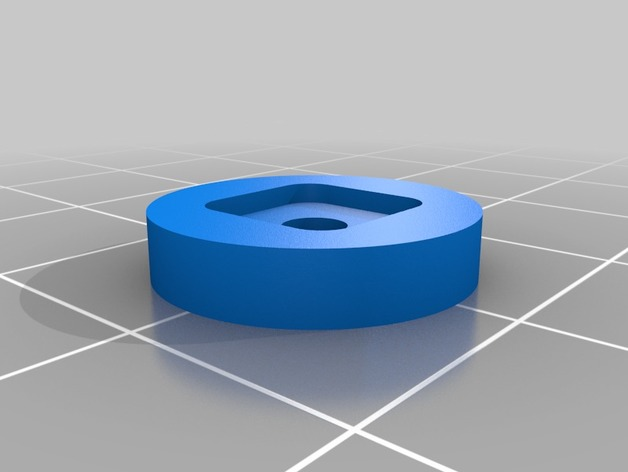
ThingiVerse/Grinder-double_gear-V2.0/images/58f7d8c99e5e17ae856188f63aca0ae0_preview_featured.jpg
