SnoBotics981/CAD-MfgResources/ThingiVerse/Grinder-double_gear-V2.0/images/afde334444551083962e0342d9d4b11c_preview_featured.jpg

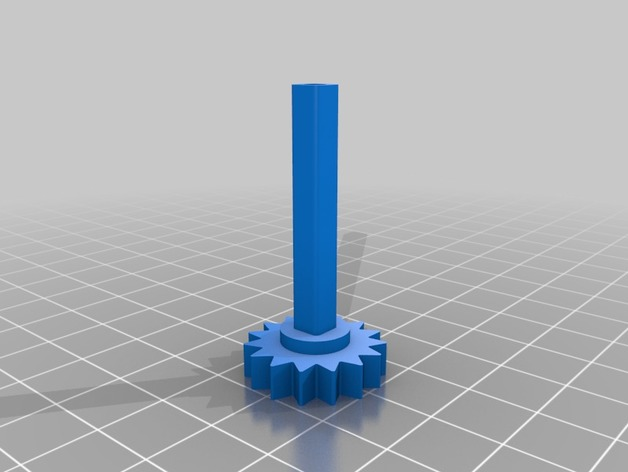
ThingiVerse/Grinder-double_gear-V2.0/images/afde334444551083962e0342d9d4b11c_preview_featured.jpg
