SnoBotics981/CAD-MfgResources/ThingiVerse/MoreNutsAndBolts/images/bc195ffd0f0c1a2eec79d7846d707670_preview_featured.jpg

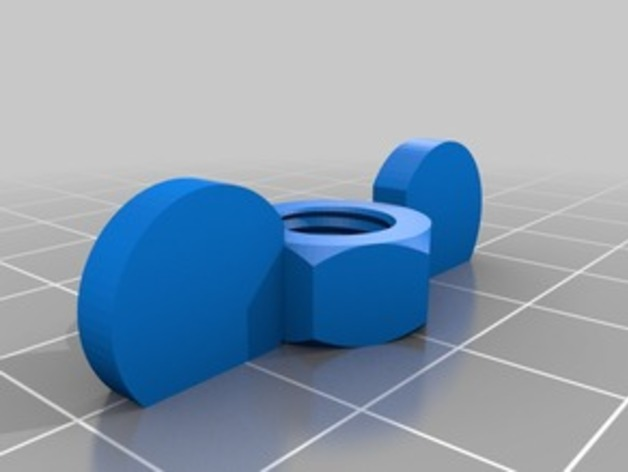
ThingiVerse/MoreNutsAndBolts/images/bc195ffd0f0c1a2eec79d7846d707670_preview_featured.jpg
