SnoBotics981/CAD-MfgResources/ThingiVerse/MoreNutsAndBolts/images/d94c9a457e7840ba6ab9e169804fac46_preview_featured.jpg

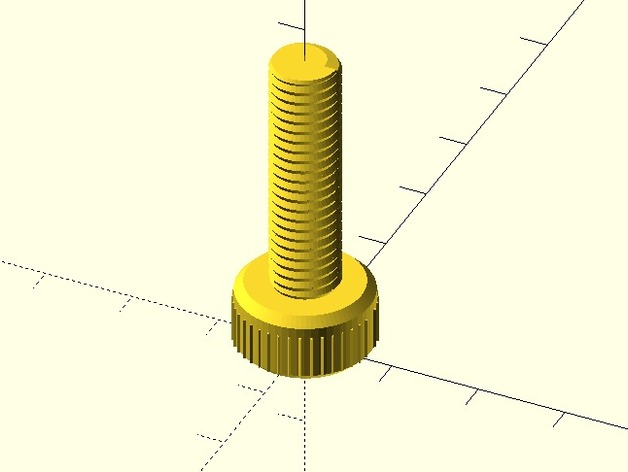
ThingiVerse/MoreNutsAndBolts/images/d94c9a457e7840ba6ab9e169804fac46_preview_featured.jpg
