SnoBotics981/CAD-MfgResources/ThingiVerse/Raspberry_Pi_Camera_Module_v2.1_Model/images/39dfe9fc88fe56e69931ca8c697a2412_preview_featured.jpg

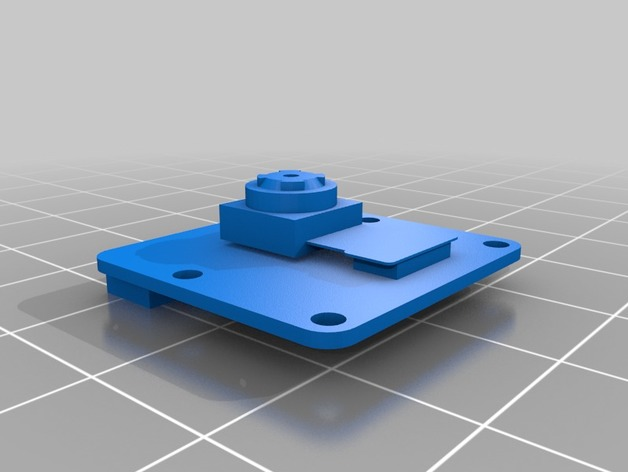
ThingiVerse/Raspberry_Pi_Camera_Module_v2.1_Model/images/39dfe9fc88fe56e69931ca8c697a2412_preview_featured.jpg
