SnoBotics981/CAD-MfgResources/ThingiVerse/Raspberry_Pi_Camera_Module_v2.1_Model/images/eb591de792d66d9c783585bb06df0e10_preview_featured.jpg

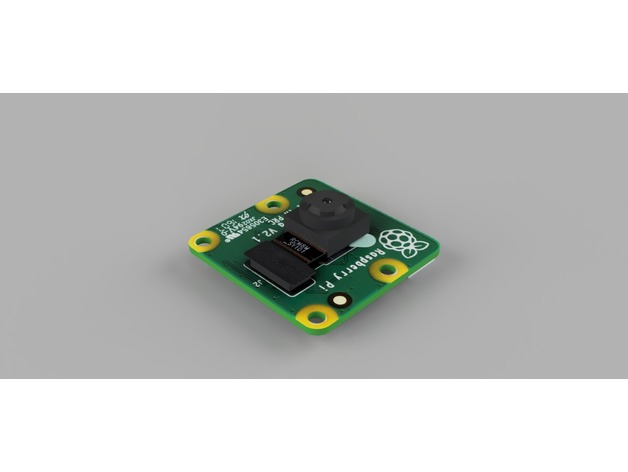
ThingiVerse/Raspberry_Pi_Camera_Module_v2.1_Model/images/eb591de792d66d9c783585bb06df0e10_preview_featured.jpg
