SnoBotics981/CAD-MfgResources/ThingiVerse/Raspberry_Pi_Camera_Telescope_Mount/images/0fc412980b228b62bb257dc644bc2367_preview_featured.JPG

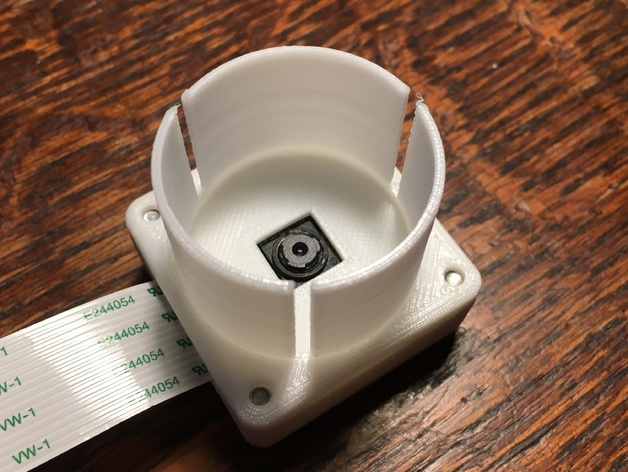
ThingiVerse/Raspberry_Pi_Camera_Telescope_Mount/images/0fc412980b228b62bb257dc644bc2367_preview_featured.JPG
