SnoBotics981/CAD-MfgResources/ThingiVerse/Raspberry_Pi_Camera_Telescope_Mount/images/540ac28b406e892bbc70e56524d75db1_preview_featured.jpg

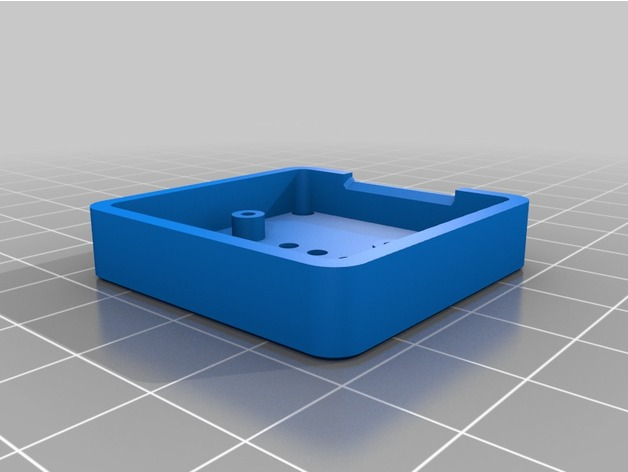
ThingiVerse/Raspberry_Pi_Camera_Telescope_Mount/images/540ac28b406e892bbc70e56524d75db1_preview_featured.jpg
