SnoBotics981/CAD-MfgResources/ThingiVerse/Raspberry_Pi_Camera_Telescope_Mount/images/c668496a40904934d6a608dfb324cf0f_preview_featured.JPG

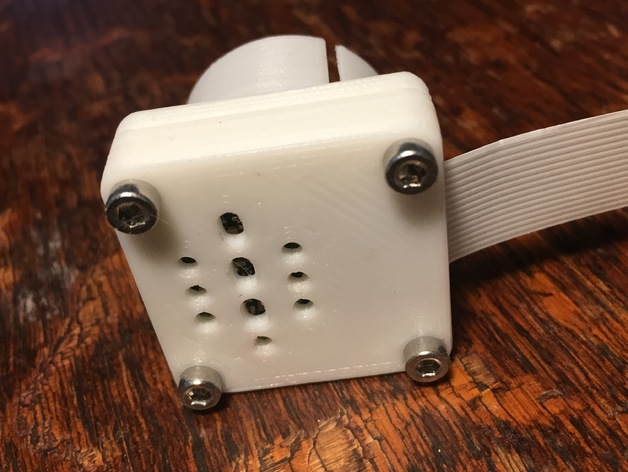
ThingiVerse/Raspberry_Pi_Camera_Telescope_Mount/images/c668496a40904934d6a608dfb324cf0f_preview_featured.JPG
