SnoBotics981/CAD-MfgResources/ThingiVerse/Raspberry_Pi_Camera_Telescope_Mount/images/ef5b00c8dafa852a0fbb97d20bc246e7_preview_featured.jpg

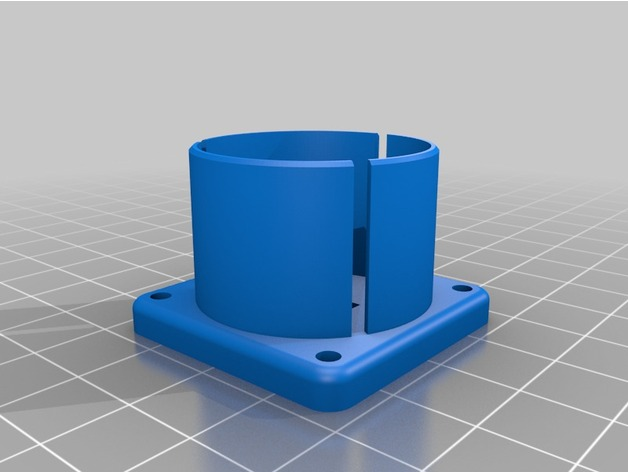
ThingiVerse/Raspberry_Pi_Camera_Telescope_Mount/images/ef5b00c8dafa852a0fbb97d20bc246e7_preview_featured.jpg
