SnoBotics981/CAD-MfgResources/ThingiVerse/Raspberry_Pi_Camera_Telescope_Mount/images/f875ba27d6fd900ded62d3f79e951cb3_preview_featured.JPG

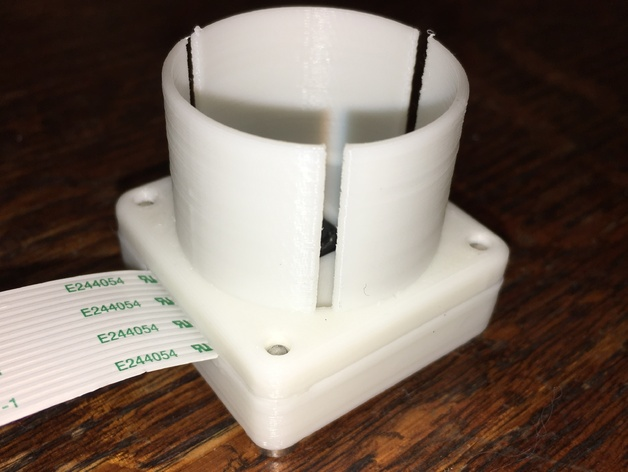
ThingiVerse/Raspberry_Pi_Camera_Telescope_Mount/images/f875ba27d6fd900ded62d3f79e951cb3_preview_featured.JPG
