SnoBotics981/CAD-MfgResources/ThingiVerse/Raspberry_Pi_Camera_V2.1_Lens_Adjustment_Spanner/images/482ab2ae203172da16afec6aaf31dfed_preview_featured.jpg

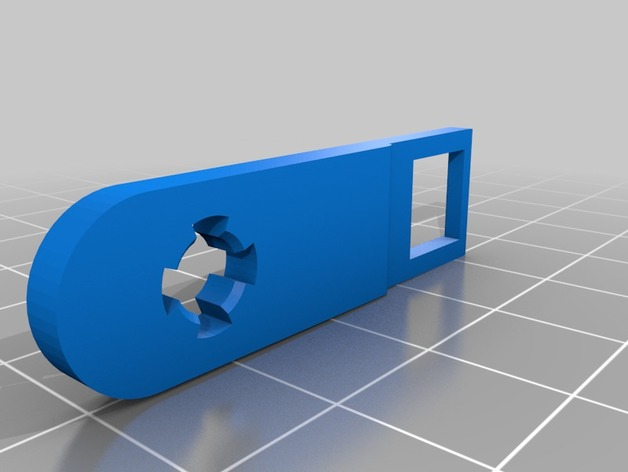
ThingiVerse/Raspberry_Pi_Camera_V2.1_Lens_Adjustment_Spanner/images/482ab2ae203172da16afec6aaf31dfed_preview_featured.jpg
