SnoBotics981/CAD-MfgResources/ThingiVerse/Raspberry_Pi_Camera_V2.1_Lens_Adjustment_Spanner/images/bbb03b292dd03d1585be57fd5368ff41_preview_featured.jpg

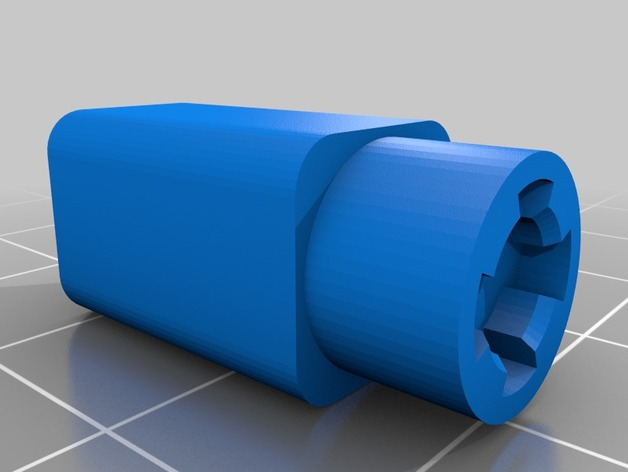
ThingiVerse/Raspberry_Pi_Camera_V2.1_Lens_Adjustment_Spanner/images/bbb03b292dd03d1585be57fd5368ff41_preview_featured.jpg
