SnoBotics981/CAD-MfgResources/ThingiVerse/Raspberry_Pi_Camera_v.2_Focus_Tool/images/951f12eb1faea14d5e273cb0fa5fc984_preview_featured.jpg

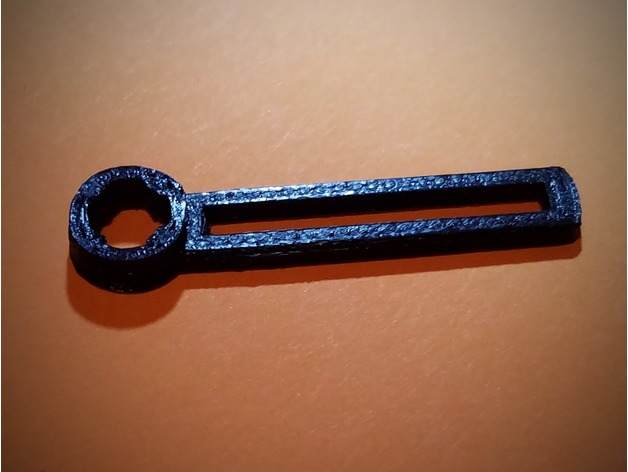
ThingiVerse/Raspberry_Pi_Camera_v.2_Focus_Tool/images/951f12eb1faea14d5e273cb0fa5fc984_preview_featured.jpg
