SnoBotics981/CAD-MfgResources/ThingiVerse/Raspberry_Pi_Camera_v.2_Focus_Tool/images/b0d9536b075a41105d3452cc18c7a461_preview_featured.jpg

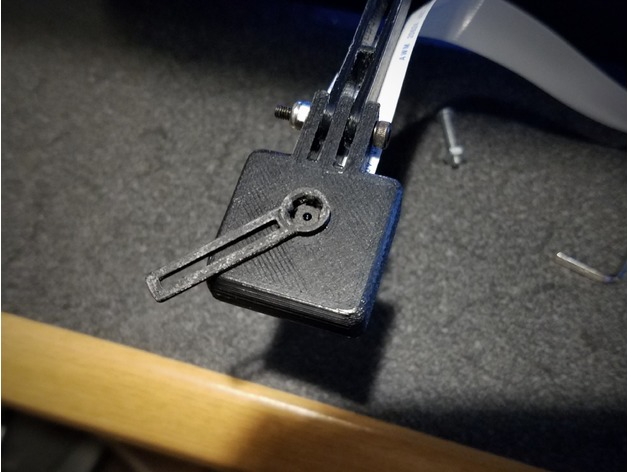
ThingiVerse/Raspberry_Pi_Camera_v.2_Focus_Tool/images/b0d9536b075a41105d3452cc18c7a461_preview_featured.jpg
