SnoBotics981/CAD-MfgResources/ThingiVerse/Raspberry_Pi_Camera_v.2_Focus_Tool/images/b174944eaf3dacd31da5442d577cf97e_preview_featured.jpg

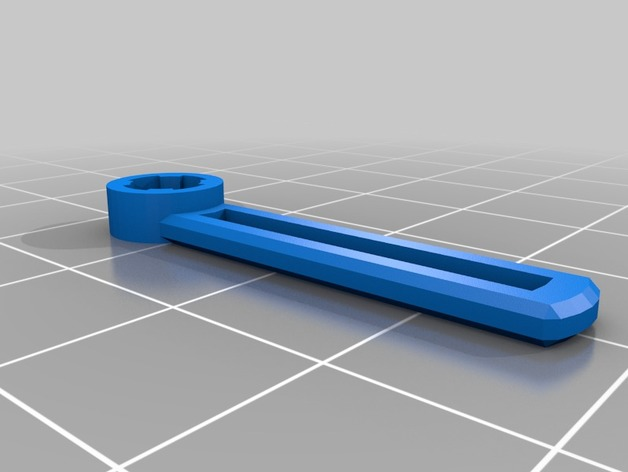
ThingiVerse/Raspberry_Pi_Camera_v.2_Focus_Tool/images/b174944eaf3dacd31da5442d577cf97e_preview_featured.jpg
