SnoBotics981/CAD-MfgResources/ThingiVerse/ScadThreadingLibrary/images/41be3a376b82c9bed386450634c8cf01_preview_featured.jpg

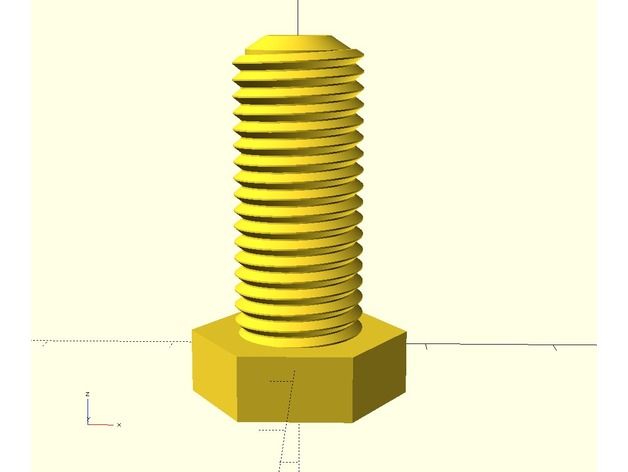
ThingiVerse/ScadThreadingLibrary/images/41be3a376b82c9bed386450634c8cf01_preview_featured.jpg
