SnoBotics981/CAD-MfgResources/ThingiVerse/ScadThreadingLibrary/images/251e2f2e2748fd65d6e557c3c6b60952_preview_featured.jpg

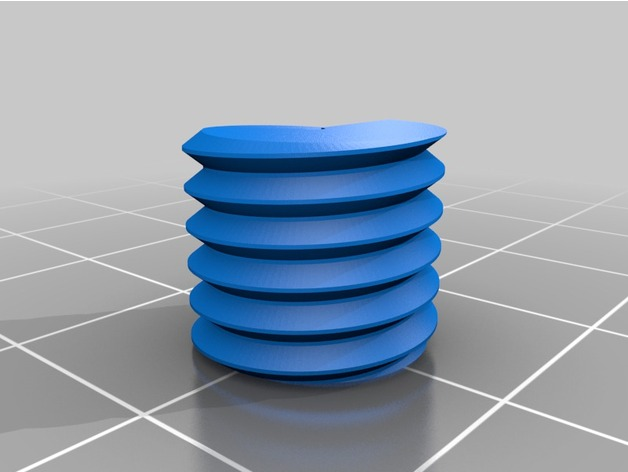
ThingiVerse/ScadThreadingLibrary/images/251e2f2e2748fd65d6e557c3c6b60952_preview_featured.jpg
