SnoBotics981/CAD-MfgResources/ThingiVerse/ScadThreadingLibrary/images/319fb829a406aa7a3d282b7b3a396705_preview_featured.jpg

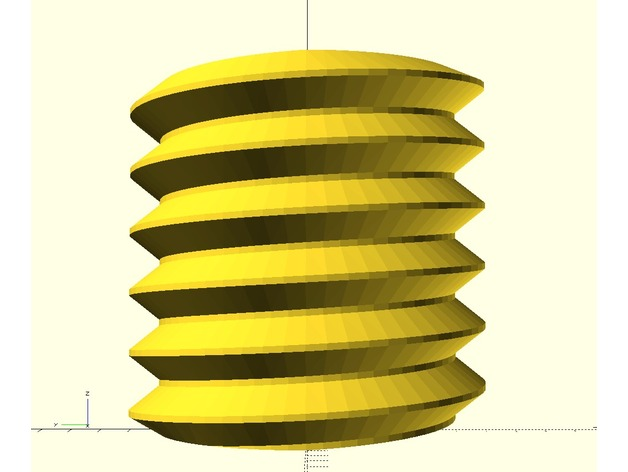
ThingiVerse/ScadThreadingLibrary/images/319fb829a406aa7a3d282b7b3a396705_preview_featured.jpg
