SnoBotics981/CAD-MfgResources/PTC/FTC 2014/Base_Set_Parts_List.xlsx

Sheet: Modeled
Matrix Base Kit
Part Number | Part Description | Model Name
01-0003 | L shaped beam – 3 hole | matrix_01-0003_2012.prt
01-0005 | L shaped beam – 5 hole | matrix_01-0005_2012.prt
01-0007 | L shaped beam – 7 hole | matrix_01-0007_2012.prt
01-0009 | L shaped beam – 9 hole | matrix_01-0009_2012.prt
01-0021 | L shaped beam – 21 hole | matrix_01-0021_2012.prt
01-0029 | L shaped beam – 29 hole | matrix_01-0029_2012.prt
01-0037 | L shaped beam – 37 hole | matrix_01-0037_2012.prt
02-0003 | Flat beam – 3 hole | matrix_02-0003_2012.prt
02-0005 | Flat beam – 5 hole | matrix_02-0005_2012.prt
02-0009 | Flat beam – 9 hole | matrix_02-0009_2012.prt
02-0011 | Flat beam – 11 hole | matrix_02-0011_2012.prt
03-0001 | Beam joiner – straight | matrix_03-0001_2012.prt
03-0004 | Beam joiner – right angle - 4 hole | matrix_03-0004_2012.prt
03-0005 | Beam joiner – 3D right angle - 4 hole | matrix_03-0005_2012.prt
03-0031 | Large beam joiner - Straight | matrix_03-0031_2012.prt
03-0032 | Large beam joiner - right angle | matrix_03-0032_2012.prt
03-0033 | Large beam joiner - 3D | matrix_03-0033_2012.prt
04-0303 | 3 x 3 gusset plate | matrix_04-0303_2012.prt
04-0305 | 3 x 5 gusset plate | matrix_04-0305_2012.prt
04-0307 | 3 x 7 gusset plate | matrix_04-0307_2012.prt
04-0309 | 3 x 9 gusset plate | matrix_04-0309_2012.prt
04-0505 | 5 x 5 gusset plate | matrix_04-0505_2012.prt
04-0921 | 9 x 21 gusset plate | matrix_04-0921_2012.prt
05-0303 | 3 x 3 flanged plate - short edge | matrix_05-0303_2012.prt
05-0307 | 3 x 7 flanged plate - short edge | matrix_05-0307_2012.prt
05-0309 | 3 x 9 flanged plate - short edge | matrix_05-0309_2012.prt
06-0005 | 3 x 5 flanged plate - long edge | matrix_06-0005_2012.prt
06-0009 | 3 x 9 flanged plate - long edge | matrix_06-0009_2012.prt
06-0013 | 3 x 13 flanged plate - long edge | matrix_06-0013_2012.prt
06-0017 | 3 x 17 flanged plate - long edge | matrix_06-0017_2012.prt
06-0021 | 3 x 21 flanged plate - long edge | matrix_06-0021_2012.prt
06-0029 | 3 x 29 flanged plate - long edge | matrix_06-0029_2012.prt
06-0037 | 3 x 37 flanged plate - long edge | matrix_06-0037_2012.prt
06-0049 | 3 x 49 flanged plate - long edge | matrix_06-0049_2012.prt
07-0002 | Servo plate – short edge flanged | matrix_07-0002_2012.prt
07-0004 | Bearing plate | matrix_07-0004_2012.prt
07-0005 | Motor plate - double flanged | matrix_07-0005_2012.prt
07-0006 | Connector Plate - 32mm | matrix_07-0006_2012.prt
07-0007 | Motor plate brace | matrix_07-0007_2012.prt
08-0003 | Axle collar | matrix_08-0003_2012.prt
08-0005 | Thin 4 hole wheel | matrix_08-0005_2012.prt
09-0001 | 32mm x M4 hex standoff spacer | matrix_09-0001_2012.prt
09-0003 | 16mm x M4 hex standoff spacer | matrix_09-0003_2012.prt
09-0004 | 3 hole joiner block | matrix_09-0004_2012.prt
10-0052 | 52mm D shaft | matrix_10-0052_2012.prt
10-0080 | 80mm D shaft | matrix_10-0080_2012.prt
10-0132 | 132mm D shaft | matrix_10-0132_2012.prt
10-0164 | 164mm D shaft | matrix_10-0164_2012.prt
11-3104 | 4mm M3 button head cap screw | matrix_11-3104_2012.prt
11-3204 | 4.5mm M3 set screw - flat point | matrix_11-3204_2012.prt
11-3304 | 4mm M3 shoulder screw | matrix_11-3304_2012.prt
11-3305 | 5mm M3 shoulder screw | matrix_11-3305_2012.prt
11-3306 | 6mm M3 shoulder screw | matrix_11-3306_2012.prt
11-3401 | 3mm washer | matrix_11-3401_2012.prt
11-3501 | M3 hex nut | matrix_11-3501_2012.prt
11-4108 | 8mm M4 button head cap screw | matrix_11-4108_2012.prt
11-4116 | 16mm M4 button head cap screw | matrix_11-4116_2012.prt
11-4402 | 4mm nylon washer | matrix_11-4402_2012.prt
11-4501 | M4 hex nut | matrix_11-4501_2012.prt
11-4502 | M4 hex nut with tooth washer | matrix_11-4502_2012.prt
11-4503 | M4 hex nut with nylon lock | matrix_11-4503_2012.prt
11-6001 | Snap rivet black- short | matrix_11-6001_2012.prt
11-6002 | Snap rivet white- medium | matrix_11-6002_2012.prt
11-6003 | Snap rivet black- long | matrix_11-6003_2012.prt
12-0024 | 24 tooth gear | matrix_12-0024_2012.asm
12-0040 | 40 tooth gear | matrix_12-0040_2012.asm
12-0056 | 56 tooth gear | matrix_12-0056_2012.asm
13-0001 | 96mm tired wheel | matrix_13-0001_2012.asm
13-0002 | Servo horn wheel | matrix_13-0002_2012.prt
13-0003 | 48mm caster Wheel | matrix_13-0003_2012.prt
13-0004 | 8mm spacer - molded | matrix_13-0004_2012.prt
13-0005 | 4mm spacer - molded | matrix_13-0005_2012.prt
13-0006 | Set screw alignment ring | matrix_13-0006_2012.prt
14-0001 | Motor | matrix_motor_2012.asm
14-0002 | Servo | matrix_servo_2012.prt
14-0003 | Controller | matrix_14-0003_2012.prt
14-0004 | Battery | matrix_14-0004_2012.prt
31-0013 | XL L beam - 13 hole | matrix_31-0013_2012.prt
31-0017 | XL L beam - 17 hole | matrix_31-0017_2012.prt
31-0021 | XL L beam - 21 hole | matrix_31-0021_2012.prt
31-0029 | XL L beam - 29 hole | matrix_31-0029_2012.prt
31-0037 | XL L beam - 37 hole | matrix_31-0037_2012.prt
31-0049 | XL L beam - 49 hole | matrix_31-0049_2012.prt
KITS (The kits consist of parts from the above list)
50-0001 | Motor Kit
50-0002 | Servo Kit
50-0003 | Fastner Kit
50-0004 | Gear Kit
50-0005 | Caster Wheel Kit
50-0006 | Axle Collar Kit
50-0007 | 4 Hole Wheel Kit
50-0008 | 96mm Wheel Kit
50-0014 | Axle Kit
50-0015 | Tool Kit
50-0016 | Joiner Block Kit
50-0018 | Snap Rivet Kit - Short
50-0019 | Snap Rivet Kit - Medium
50-0020 | Snap Rivet Kit - Long
50-0021 | Servo Ext. Wire Kit

Sheet: Not Modeled
Part Number | Part Description | Notes
14-0005 | Battery charger | NOT NEEDED
14-0006 | Servo ext wire - 200mm | NOT NEEDED
14-0007 | Servo ext wire - 450mm | NOT NEEDED
15-0006 | Nut driver - 7mm | NOT NEEDED
15-0007 | Ball driver - 1.5mm | NOT NEEDED
15-0008 | Ball driver - 2.0mm | NOT NEEDED
15-0009 | Ball driver - 2.5mm | NOT NEEDED
15-0010 | Metric Combination Wrench- 7mm | NOT NEEDED
15-0011 | Metric Combination Wrench- 5.5mm | NOT NEEDED
