SnoBotics981/CAD-MfgResources/Andy-Mark/2013 Chassis/Long Design/Design Data/GOST/en-US/PartsListGroup1.xls

Sheet: Лист 1
Инв. № подл |  |  |  | Подп. и дата | Взам. инв. № | Инв. № дубл. |  |  | Подп. и дата
Формат | Зона | Поз. | Обозначение |  |  |  | Наименование |  |  |  |  |  | Кол. на исполнение
 |  |  |  |  |  |  |  |  |  |  |  | Лит.
 |  |  |  |  |  |  |  |  |  |  |  | Код
 |  |  |  |  |  |  |  | Изм. | Лист | № докум | Подпись |  | Дата
 |  |  |  |  |  |  |  | Разраб.
 |  |  |  |  |  |  |  | Пров.
 |  |  |  |  |  |  |  | Н.контр
 |  |  |  |  |  |  |  | Утв.
 |  |  |  |  |  |  |  |  |  |  |  |  |  | Копировал

Sheet: Лист 2
Инв. № подл |  |  |  | Подп. и дата | Взам. инв. № | Инв. № дубл. |  |  | Подп. и дата
Формат | Зона | Поз. | Обозначение |  |  |  | Наименование |  |  |  |  | Кол. на исполнение
 |  |  |  |  |  |  |  | Изм. | Лист | № докум. | Подп. | Дата
 |  |  |  |  |  |  |  |  |  |  |  |  | Копировал
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
