SnoBotics981/CAD-MfgResources/Andy-Mark/LiftMechanism/am-3844+2x1+Elevator+Assembly+Example.STEP

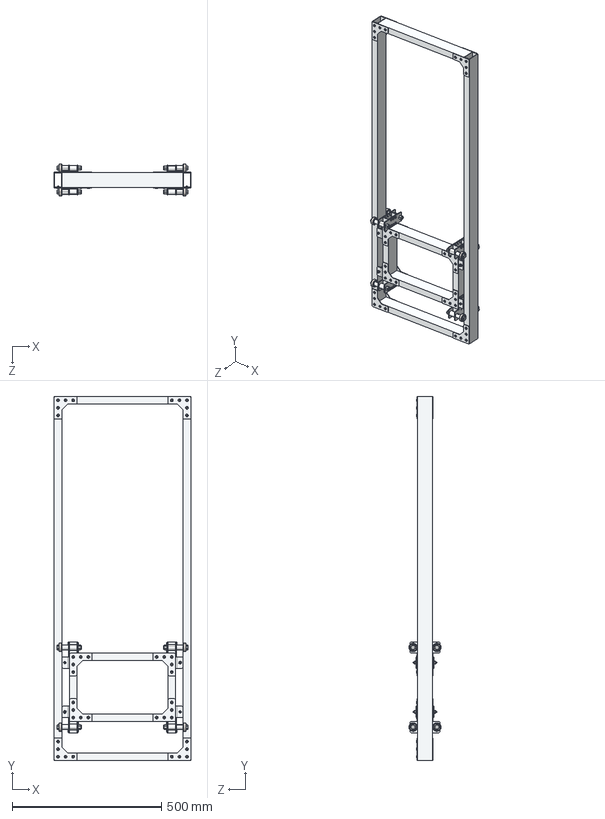
[picture p62: CAD file, 2018-06-26]
Andy-Mark/LiftMechanism/am-3844+2x1+Elevator+Assembly+Example.STEP
457.2 x 1219.2 x 108.2 mm
Example Fixed Tube x 2
Large Bearing Block Plate x 4
Small Bearing Block Plate x 4
1614Z Bearing x 8
AS75-18-64 Aluminum Spacer x 8
187 pop rivet x 88
3-8-16 NyLock Nut - Mcm 95615A140_95615A140 x 8
am-0602 .250 x .192 x 2.14 Brass Tube x 4
13RS075051 .750 x .260 x 1.00 Spacer x 8
0.25 Flat Washer_Preferred Wide FW 0.25 x 8
10-32 Nylock Nut x 4
SHCS 10-32 x 2.75_HX-SHCS 0.19-32x2.75x0.875-C x 4
AS62-18-56 Aluminum Spacer x 8
375-16 x 3 Hex Bolt_HFBOLT 0.375-16x2.5x1-C x 8
Example Bearing Tube x 2
Example Cross Carriage Tube x 2
Example Cross Frame Tube x 2
REV-21-1002 90 Degree Bracket x 16
