SnoBotics981/CAD-MfgResources/Andy-Mark/Wheels/8 in Diameter/Pneumatic Hub Asm.STEP

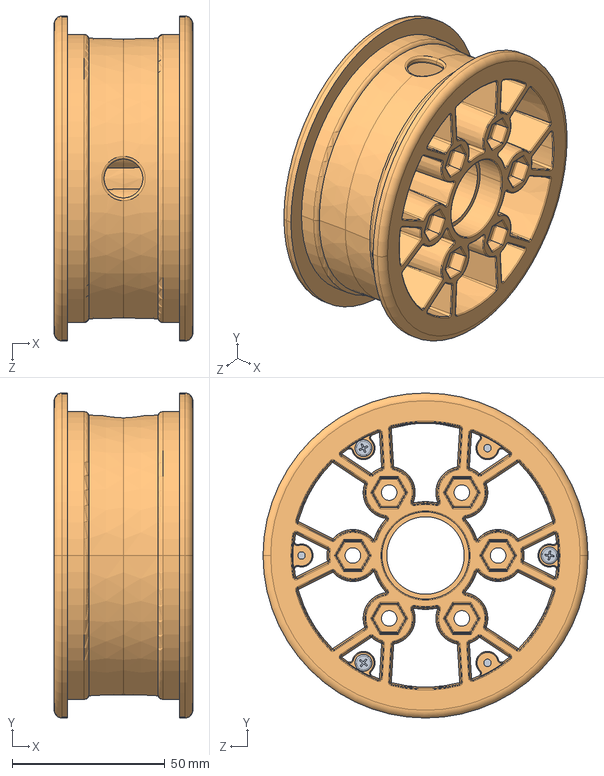
[picture p63: CAD file, 2018-06-26]
Andy-Mark/Wheels/8 in Diameter/Pneumatic Hub Asm.STEP
45.5 x 106.6 x 106.6 mm
#4x1.00, Plastic Thread Rolling Screw, Pan Head, Cross Recessed, Zinc Plated (Plastic Applications)_Fastenal__5E0B_15FCAA x 6
Hub x 2
