SnoBotics981/CAD-MfgResources/VexRobotics/Gear Kit PN 276-2184/DIFFERENTIAL-ASSY.STEP

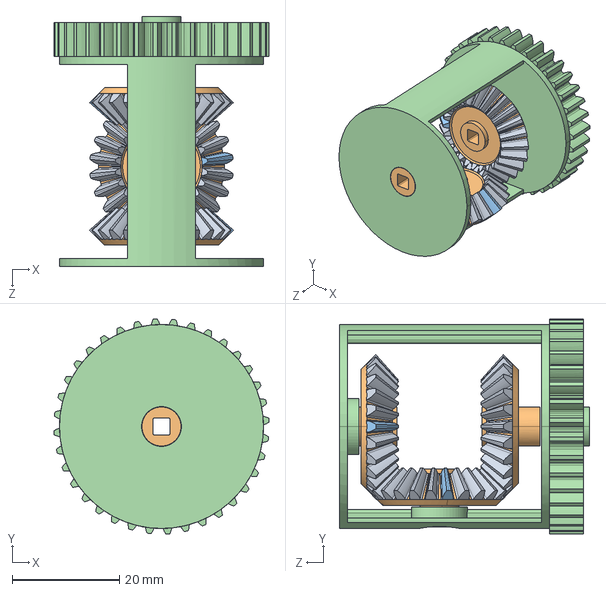
[picture p64: CAD file, 2015-07-15]
VexRobotics/Gear Kit PN 276-2184/DIFFERENTIAL-ASSY.STEP
40.2 x 40.2 x 46.8 mm
Bevel-Gear x 3
Differential-Housing
