SnoBotics981/CAD-MfgResources/VexRobotics/Gear Kit PN 276-2184/WORM-ASSY.STEP

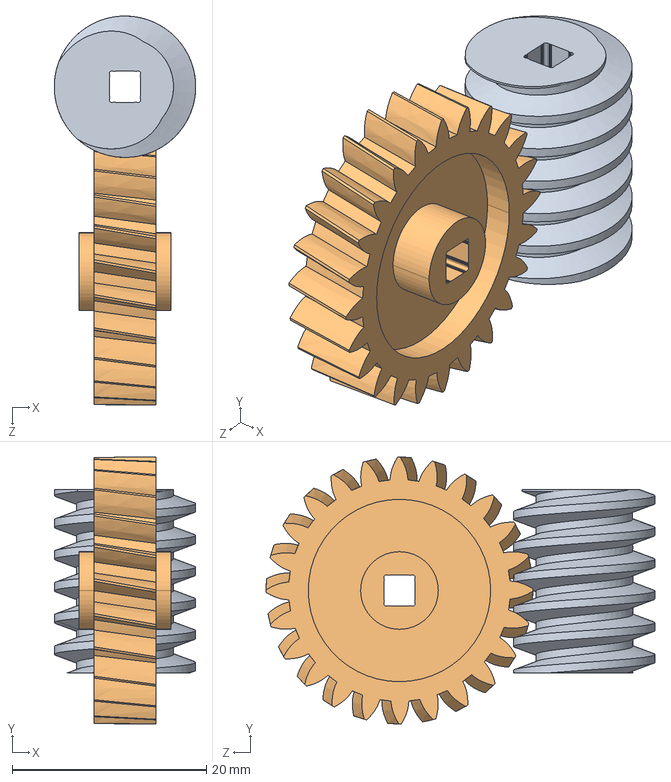
[picture p65: CAD file, 2015-07-15]
VexRobotics/Gear Kit PN 276-2184/WORM-ASSY.STEP
14.6 x 27.5 x 40.1 mm
WORM
Worm-Wheel
