SnoBotics981/CAD-MfgResources/VexRobotics/Gear Kit PN 276-2184/Vex Advanced Gear Kit/BEVEL-ASSY.STEP

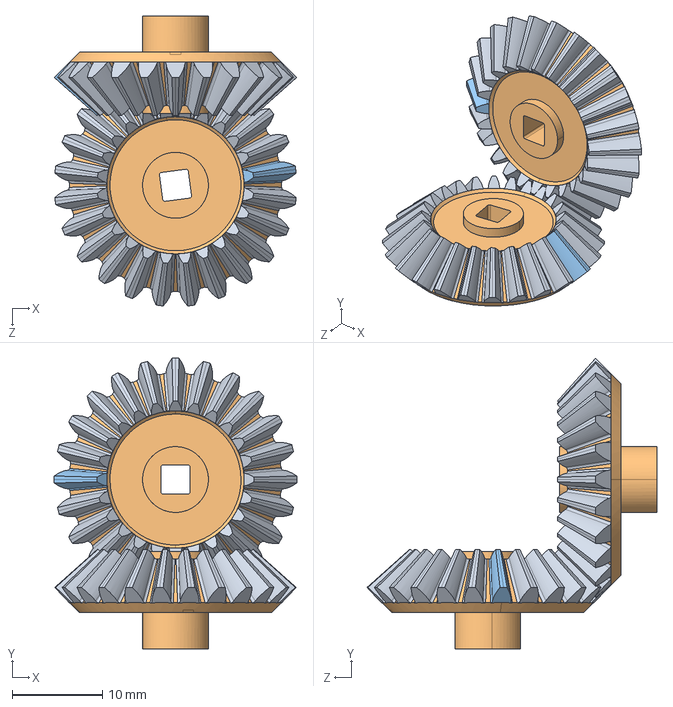
[picture p66: CAD file, 2015-07-15]
VexRobotics/Gear Kit PN 276-2184/Vex Advanced Gear Kit/BEVEL-ASSY.STEP
26.9 x 32.2 x 32.1 mm
Bevel-Gear x 2
