SnoBotics981/CAD-MfgResources/VexRobotics/Gear Kit PN 276-2184/RACK-ASSY.STEP

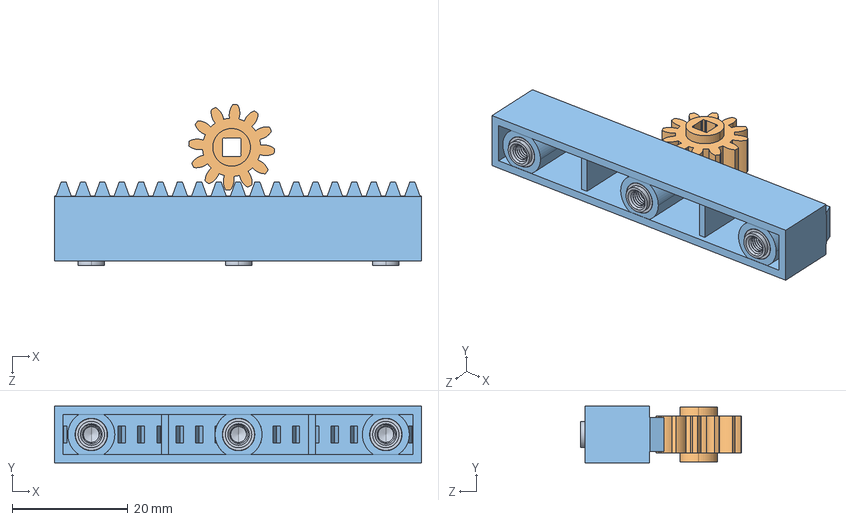
[picture p67: CAD file, 2015-07-15]
VexRobotics/Gear Kit PN 276-2184/RACK-ASSY.STEP
63.3 x 9.80 x 27.8 mm
INSERT-NUT x 3
12-TOOTH-GEAR
RACK
