SnoBotics981/CAD-MfgResources/Andy-Mark/2017 RhinoBumperKit/am-3358BumperKitforRhino.STEP

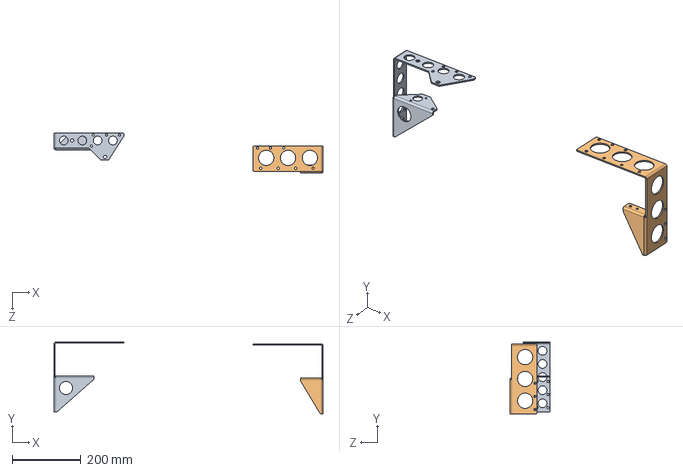
[picture p68: CAD file, 2018-06-26]
Andy-Mark/2017 RhinoBumperKit/am-3358BumperKitforRhino.STEP
782.3 x 208.6 x 117.2 mm
am-3352 Rhino Front Left Bumper Bracket
am-3354 Rhino Back Left Bumper Bracket
