SnoBotics981/CAD-MfgResources/Andy-Mark/2020 Kit Bot/am-2954 AM14U2 2x3 Hole Bracket.STEP

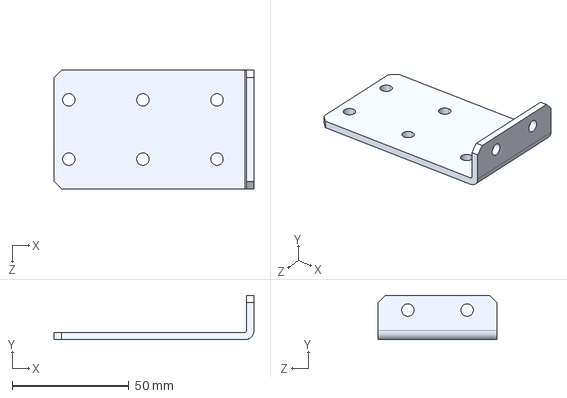
[picture p69: CAD file, 2020-01-10]
Andy-Mark/2020 Kit Bot/am-2954 AM14U2 2x3 Hole Bracket.STEP
85.7 x 19.1 x 50.8 mm
