SnoBotics981/CAD-MfgResources/Andy-Mark/625-key-hub.stp

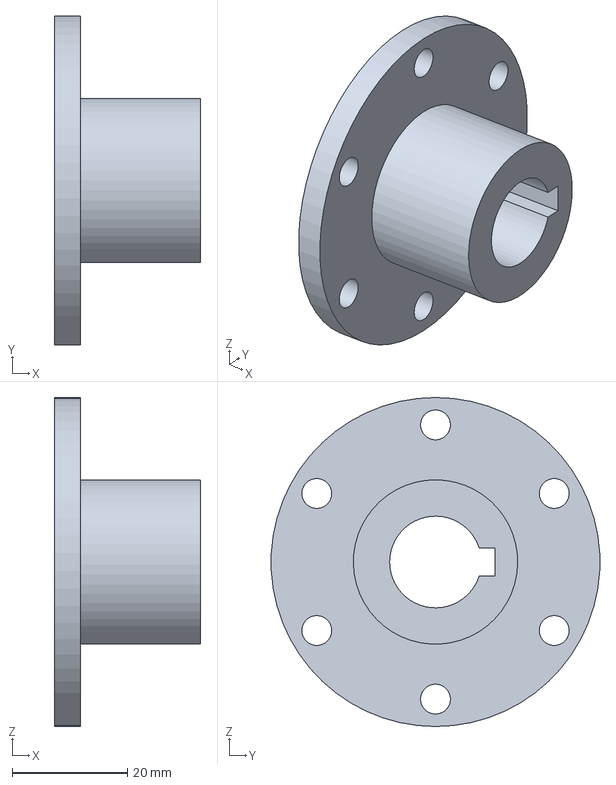
[picture p70: CAD file, 2015-07-15]
Andy-Mark/625-key-hub.stp
25.4 x 57.1 x 57.1 mm
