SnoBotics981/CAD-MfgResources/Andy-Mark/ArmJointForPvcPipe/am-2699ArmJointForPVC_Pipe.STEP

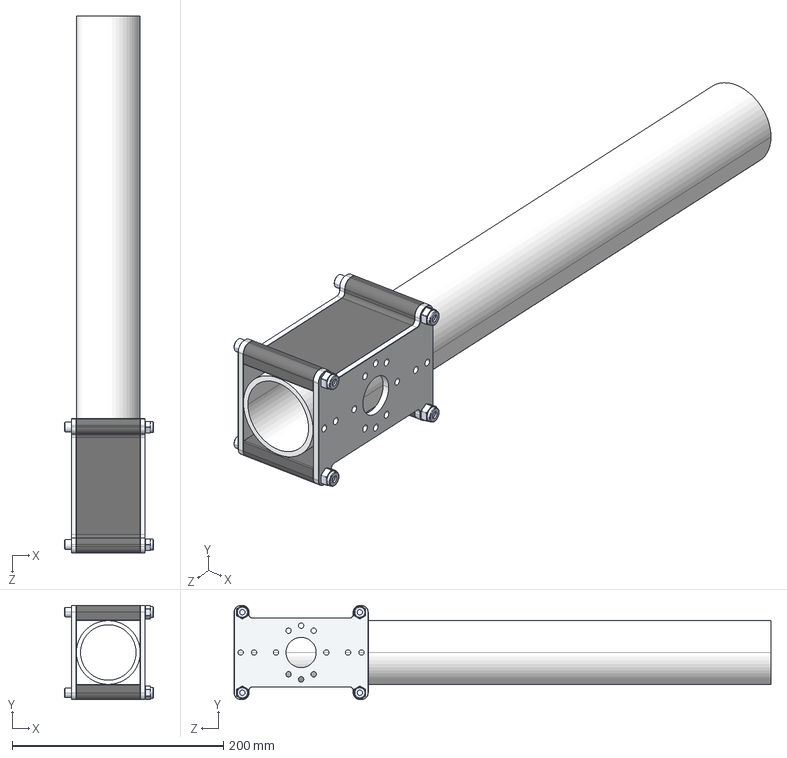
[picture p71: CAD file, 2018-06-26]
Andy-Mark/ArmJointForPvcPipe/am-2699ArmJointForPVC_Pipe.STEP
83.9 x 89.0 x 508.0 mm
2in PVC
EX Spacer Plate x 2
Joint Plate x 2
SHCS 14-20 x 3 x 4
14-20_nylock_nut x 4
