SnoBotics981/CAD-MfgResources/Andy-Mark/Ball Intake Systems/Ball Intake System AM-3312/am-3311a Intake Motor Mount Bracket.STEP

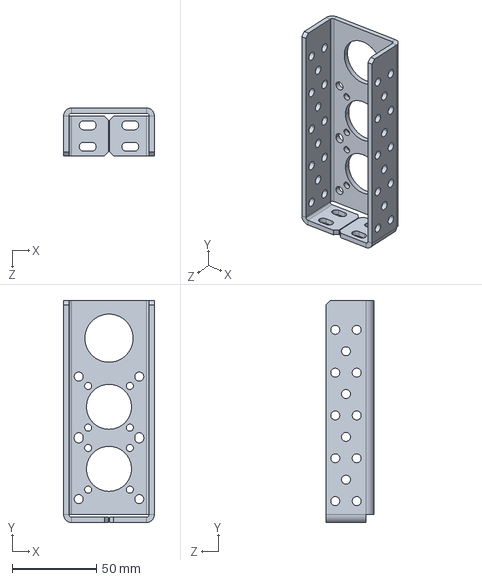
[picture p72: CAD file, 2020-01-10]
Andy-Mark/Ball Intake Systems/Ball Intake System AM-3312/am-3311a Intake Motor Mount Bracket.STEP
53.8 x 131.7 x 28.6 mm
