SnoBotics981/CAD-MfgResources/Andy-Mark/BatterBracket/am-2718-Battery+Tray.STEP

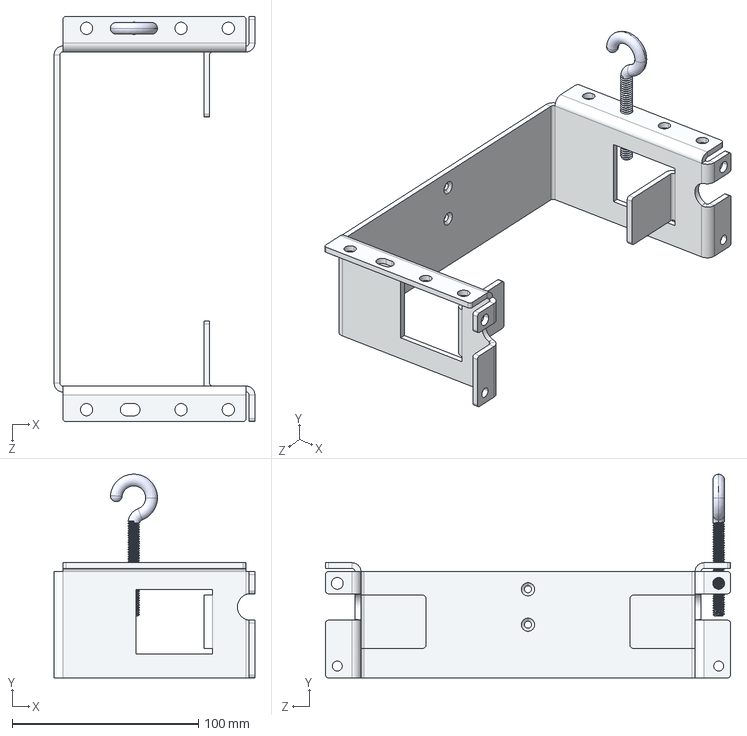
[picture p73: CAD file, 2018-06-26]
Andy-Mark/BatterBracket/am-2718-Battery+Tray.STEP
108.0 x 109.5 x 217.7 mm
Battery Bracket
14-20 Open Eye Bolt 9490T4
