SnoBotics981/CAD-MfgResources/Andy-Mark/Bearing/am-2986 FR8ZZ Hex Bearing.STEP

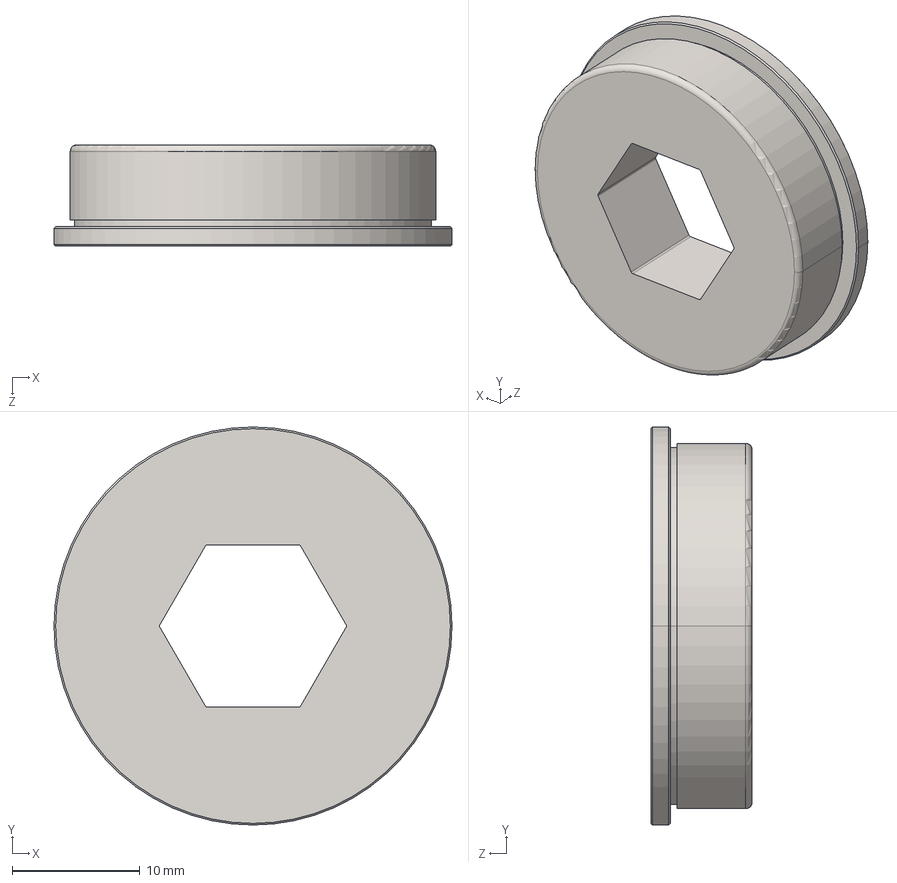
[picture p74: CAD file, 2020-01-07]
Andy-Mark/Bearing/am-2986 FR8ZZ Hex Bearing.STEP
31.1 x 31.1 x 7.93 mm
