SnoBotics981/CAD-MfgResources/Andy-Mark/Collar/am-2099+Collar+Clamp,+0.5''+Bore,+Aluminum.STEP

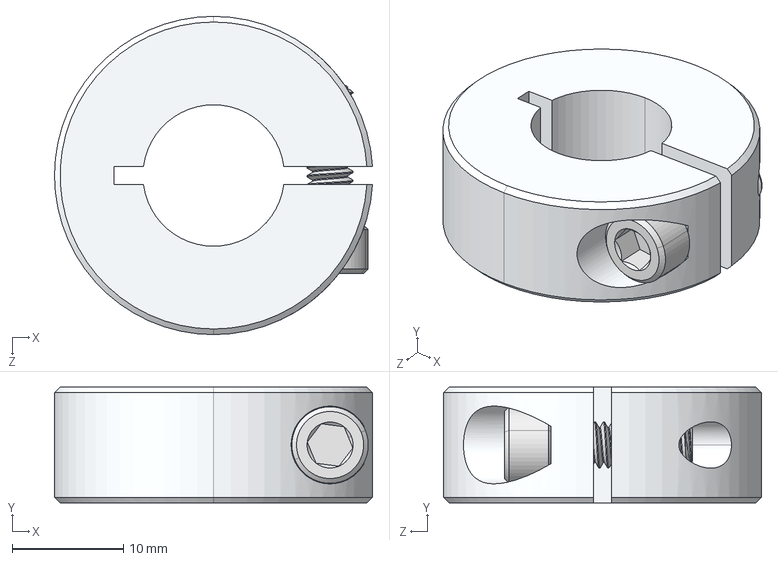
[picture p75: CAD file, 2018-06-26]
Andy-Mark/Collar/am-2099+Collar+Clamp,+0.5''+Bore,+Aluminum.STEP
28.6 x 10.4 x 28.6 mm
am-2099 Clamp Only
am-2099 Screw Only_91251A194
