SnoBotics981/CAD-MfgResources/Andy-Mark/GearBox/am-2923+PG27+With+Encoder.STEP

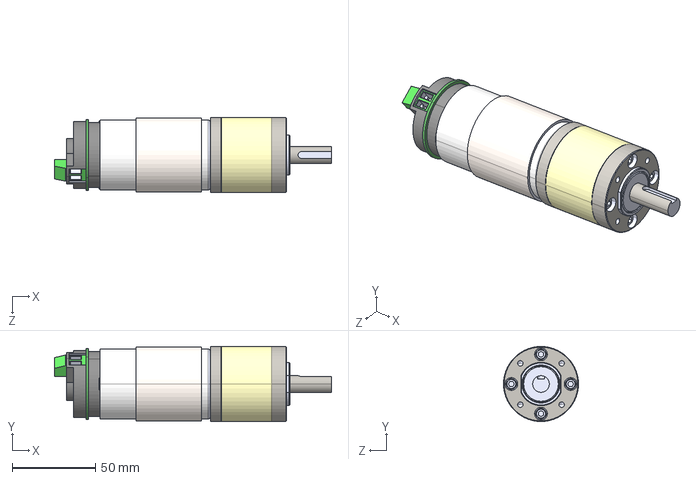
[picture p76: CAD file, 2018-06-26]
Andy-Mark/GearBox/am-2923+PG27+With+Encoder.STEP
166.1 x 45.0 x 45.0 mm
PG27 with longer backshaft
Hall Effect Encoder for PG Gearboxes
