SnoBotics981/CAD-MfgResources/Andy-Mark/GearBox/BevelBox/am-3840+1.1+LJ+BevelBox+Gearbox.STEP

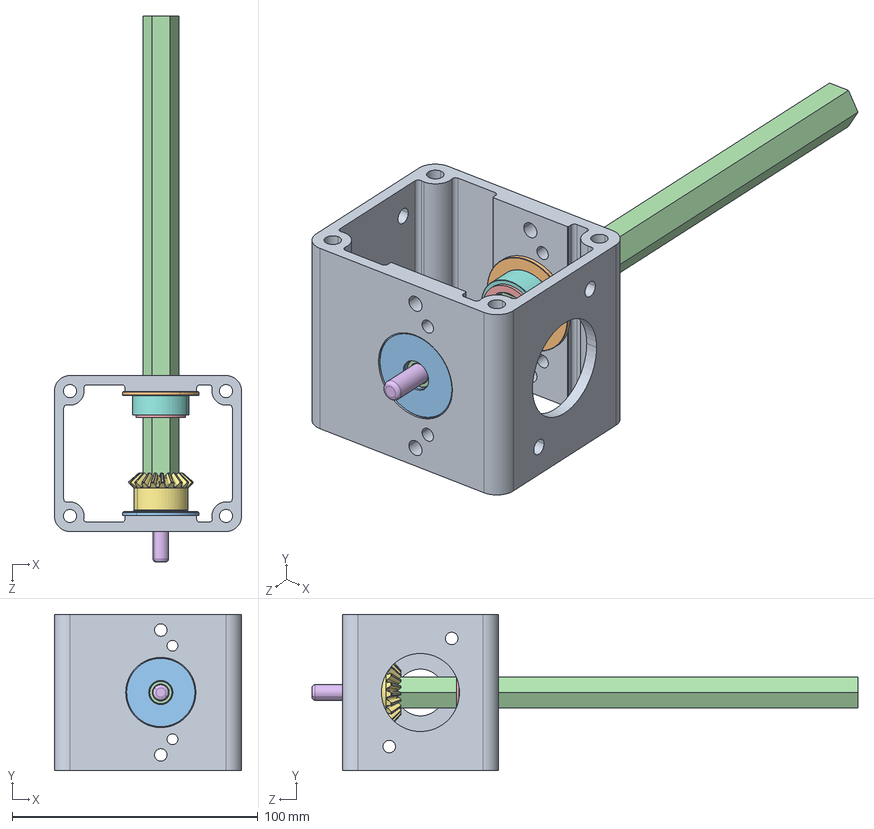
[picture p77: CAD file, 2018-06-26]
Andy-Mark/GearBox/BevelBox/am-3840+1.1+LJ+BevelBox+Gearbox.STEP
76.2 x 63.5 x 222.2 mm
LJ Housing V2
FR8ZZ Hex Bearing
FR6ZZ-L Bearing
3 Stage Evo Shifter Long Hex Output Shaft
.500 in 97431A340_SIDE-MOUNT EXTERNAL RETAINING RING E-STYLE_97431A340
dowel pin_ai_Magnet
am-3772 1.25, 20T, 500 Hex Bore
am-1445 1.1 LJ BevelBox Output Shaft Spacer
am-1444 Shim Washer For Shortening .625in Dia Screw Shoulder_0.016 Thick_18-8 Stainess Steel_94773A691
