SnoBotics981/CAD-MfgResources/Andy-Mark/GearBox/CIM-Sport/am-3785+-+CIM+Sport+16T+Pinion+Gear.STEP

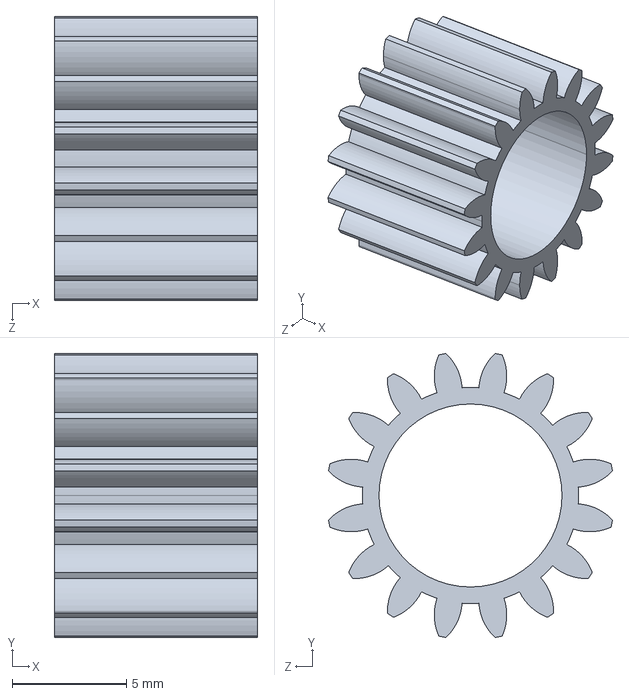
[picture p78: CAD file, 2018-08-28]
Andy-Mark/GearBox/CIM-Sport/am-3785+-+CIM+Sport+16T+Pinion+Gear.STEP
8.89 x 12.4 x 12.4 mm
