SnoBotics981/CAD-MfgResources/Andy-Mark/GearBox/DeCiMate-AM-3745/am-3745+DeCIMate+Ver1.3.STEP

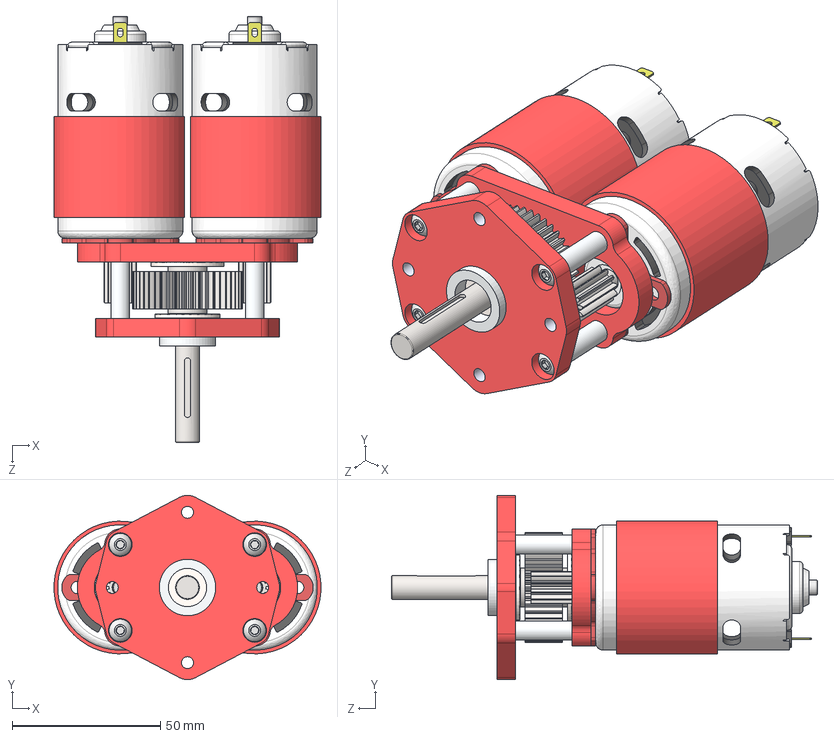
[picture p79: CAD file, 2018-06-26]
Andy-Mark/GearBox/DeCiMate-AM-3745/am-3745+DeCIMate+Ver1.3.STEP
90.1 x 62.3 x 143.9 mm
2 775 to CIM Output Motor Plate
2 775 to CIM Output Output Plate
775 RedLine x 2
12T 32dp 775Pro Pinion Gear x 2
8mm Round Bearing
775 Vent Plate Spacer x 2
45T 32DP Gear 375 Hex Bore
.172 ID .25 OD .75 Long Aluminum Spacer x 4
.375 Round Flanged Bearing
2 775 to CIM Output Output Shaft
.509 ID .75 OD .1875 Long Aluminum Spacer
BHCS M4-0.7 x 35 - McM 91239A158_91239A158 x 4
