SnoBotics981/CAD-MfgResources/Andy-Mark/GearBox/LJBevelGearbox-AM-2622/am-2622 LJ Bevelbox.STEP

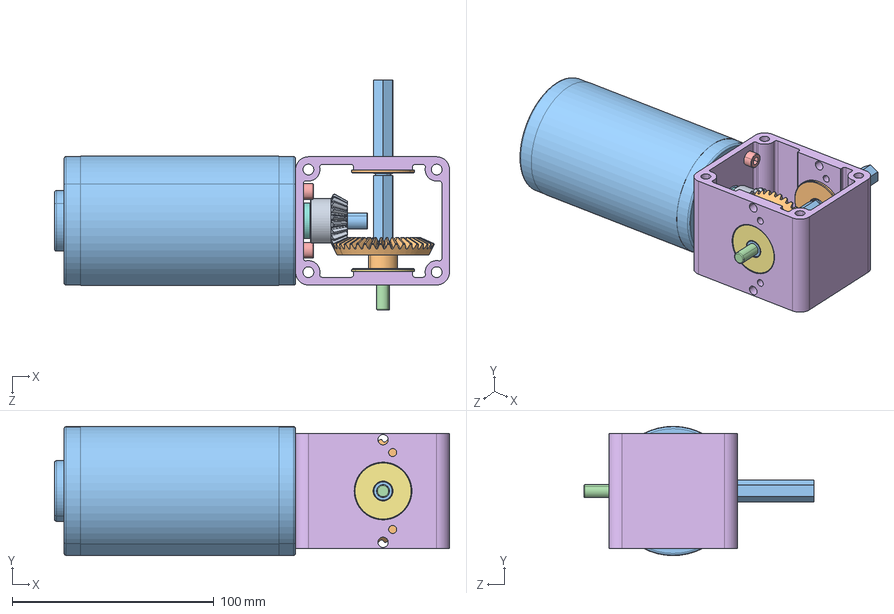
[picture p80: CAD file, 2018-06-26]
Andy-Mark/GearBox/LJBevelGearbox-AM-2622/am-2622 LJ Bevelbox.STEP
195.6 x 64.0 x 114.1 mm
20t 1-25mod bevel gear
40t 1-25mod bevel gear
CIM Motor SW
250x1000 dowel
SHCS 10-32 x 0.75 x 2
LJ Housing
FR6ZZ-L Bearing
5-16 thick brass washer 11128567
8mm_spring_clip am-0033
FR6ZZ-L Hex Bearing
375 Hex Output Shaft
