SnoBotics981/CAD-MfgResources/Andy-Mark/GearBox/SuperSonicShifter-AM-3039_45/am-3039_Super_Sonic_Shifter.STEP

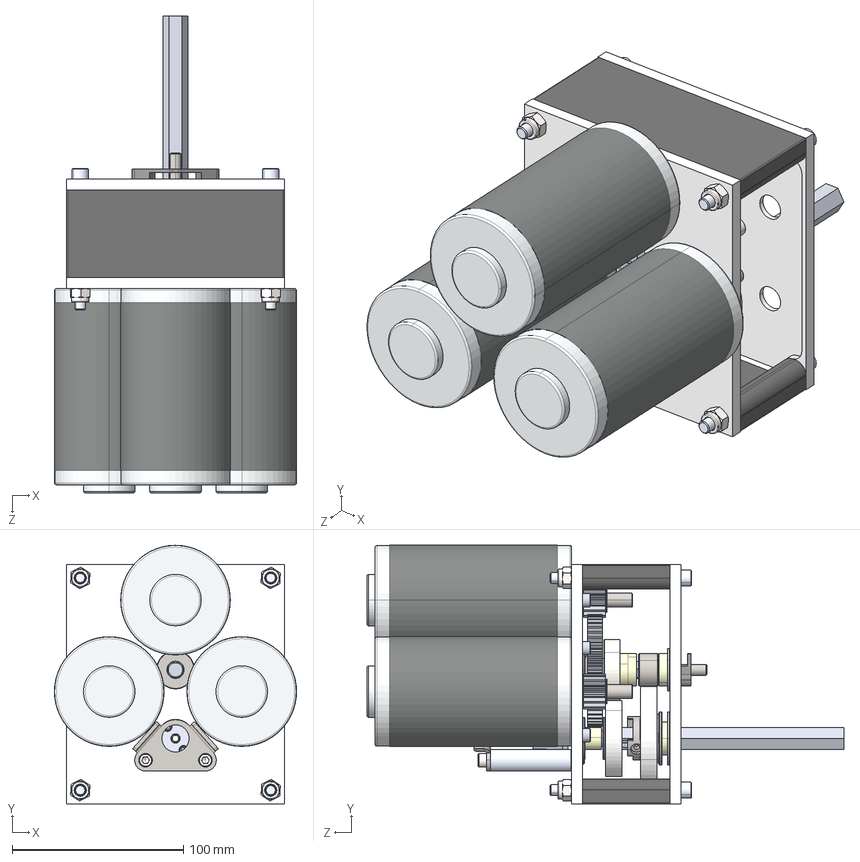
[picture p81: CAD file, 2018-06-26]
Andy-Mark/GearBox/SuperSonicShifter-AM-3039_45/am-3039_Super_Sonic_Shifter.STEP
141.3 x 150.9 x 278.3 mm
CIM Motor SW1 x 3
FR6ZZ Bearing1 x 3
Toughbox 50T Large Cluster
28T Medium Cluster Gear
15T Hex Bore Gear
35T Small Output Gear am-0023
48T Large Output Gear am-0022
fr6
Dog Gear
FR8ZZ Hex Bearing b x 2
Motor plate
Spacer Rev1-2 x 2
SHCS 14-20 x 3 x 4
250-20 Nylock Nut x 4
Shaft Plate w- 3rd stage opt
Output shaft
1.867 Spacer x 2
Cylender mount plate
10-32x2250_shcs_HX-SHCS 0.19-32x1.375x1-C x 2
500-e-klip
0.125t x 500 hex spacer
375ID x 375t spacer - SPS-0500-0375-0375
Spacer am-1181 x 3
Shift Block 2
Shift Cap
Shifter Shaft Rev1 3CIM Shifter
0.1875 e-clip_97431A280
R3 Bearing_smart
4-40x0250_shcs_smart x 2
Shift Shaft Spacer am-0300
Toughbox d29a
input-encoder shaft
250x1000 dowel
8mm spring clip x 3
5-16 washer x 6
SHCS 10-32 x 0.625 x 6
Toughbox d09 x 3
