SnoBotics981/CAD-MfgResources/Andy-Mark/GearBox/ToughBoxMini/am-2566a Short 500 Hex Steel Output Shaft with Magnet for Toughbox Series.STEP

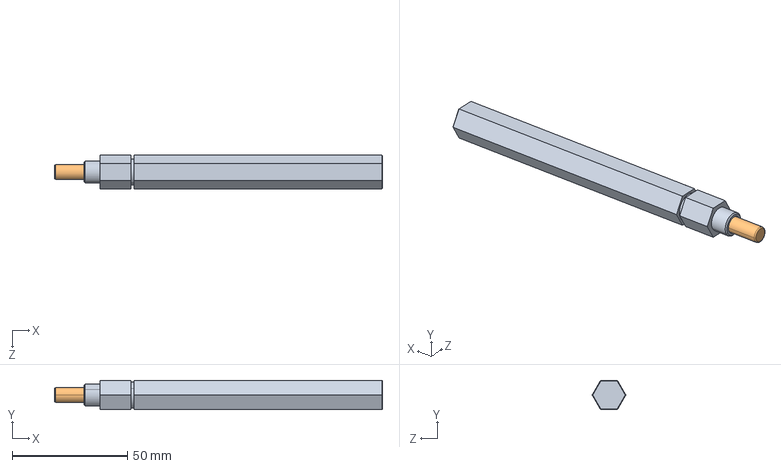
[picture p82: CAD file, 2020-01-26]
Andy-Mark/GearBox/ToughBoxMini/am-2566a Short 500 Hex Steel Output Shaft with Magnet for Toughbox Series.STEP
142.3 x 12.7 x 14.7 mm
sc-2566a TB Output Shaft Hex AM14U mag
250x1000 dowel
