SnoBotics981/CAD-MfgResources/Andy-Mark/GearBox/WormBox-AM-0917/WD Worm Shaft.stl

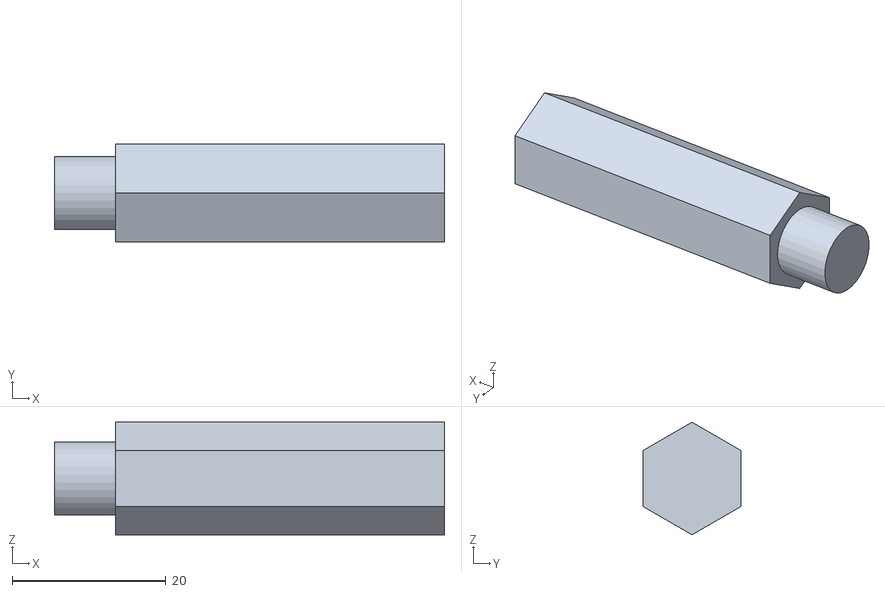
[picture p83: CAD file, 2018-06-26]
Andy-Mark/GearBox/WormBox-AM-0917/WD Worm Shaft.stl
50.8 x 12.7 x 14.7
