SnoBotics981/CAD-MfgResources/Andy-Mark/Hubs/am-0320a_8mm_Key_Hub.STEP

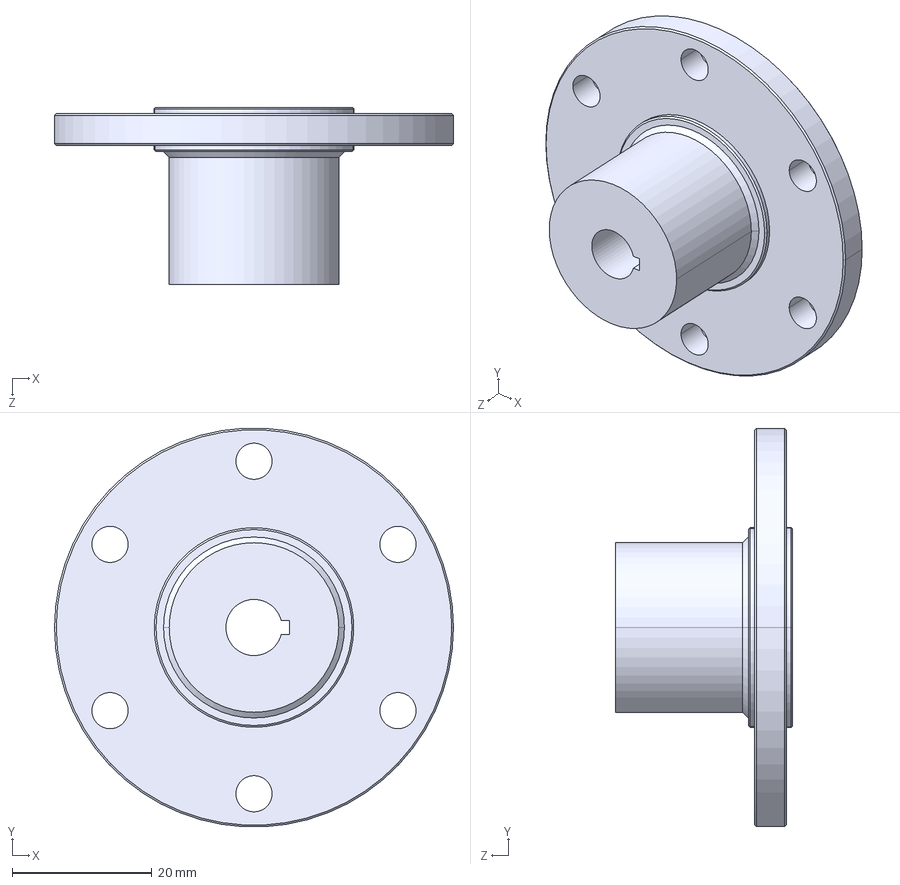
[picture p84: CAD file, 2018-06-26]
Andy-Mark/Hubs/am-0320a_8mm_Key_Hub.STEP
57.2 x 57.1 x 25.4 mm
