SnoBotics981/CAD-MfgResources/Andy-Mark/LightRing/am-3596LedRing.STEP

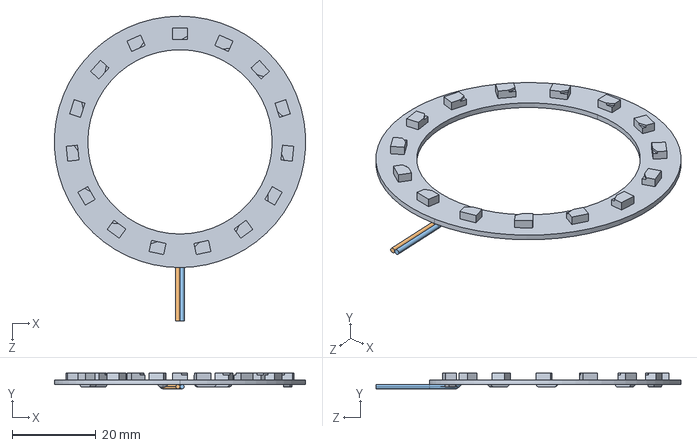
[picture p85: CAD file, 2019-11-12]
Andy-Mark/LightRing/am-3596LedRing.STEP
59.9 x 3.73 x 72.7 mm
