SnoBotics981/CAD-MfgResources/Andy-Mark/MotorMounts/am-4244 1IN Bent Bearing Side Mount Gusset.STEP

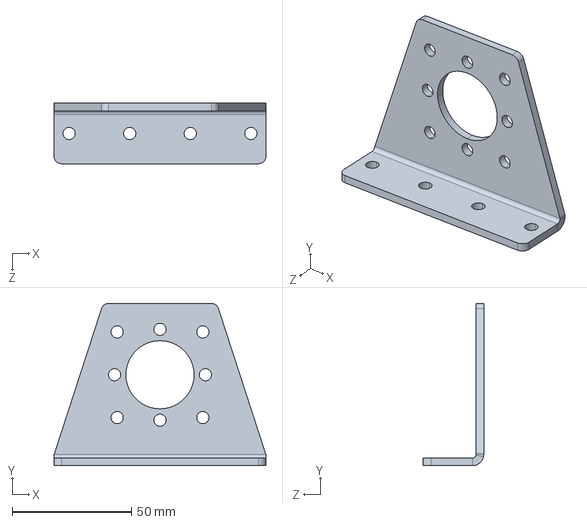
[picture p86: CAD file, 2022-01-17]
Andy-Mark/MotorMounts/am-4244 1IN Bent Bearing Side Mount Gusset.STEP
88.9 x 68.0 x 25.4 mm
