SnoBotics981/CAD-MfgResources/Andy-Mark/Motors/am-0255 2.5inch CIM Motor.STEP

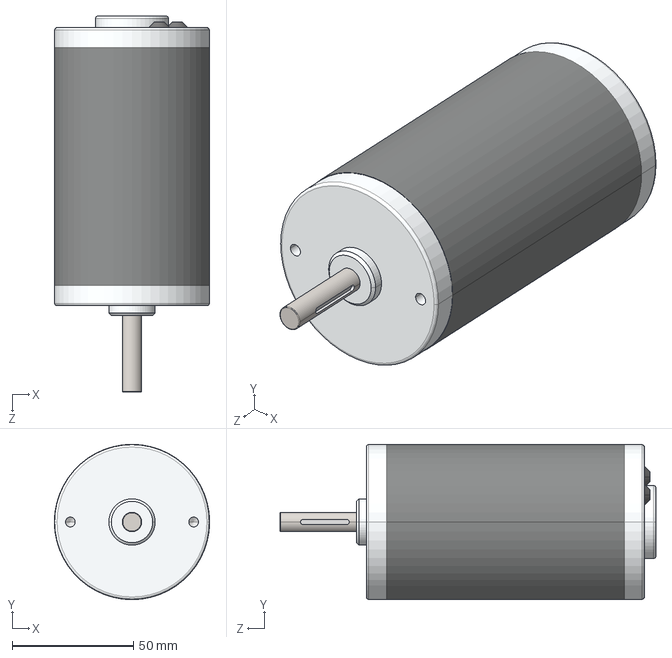
[picture p87: CAD file, 2018-06-26]
Andy-Mark/Motors/am-0255 2.5inch CIM Motor.STEP
64.0 x 64.0 x 154.9 mm
