SnoBotics981/CAD-MfgResources/Andy-Mark/Motors/SnowBlowerMotor/am-2235a Snow Blower Motor With Hex Shaft.STEP

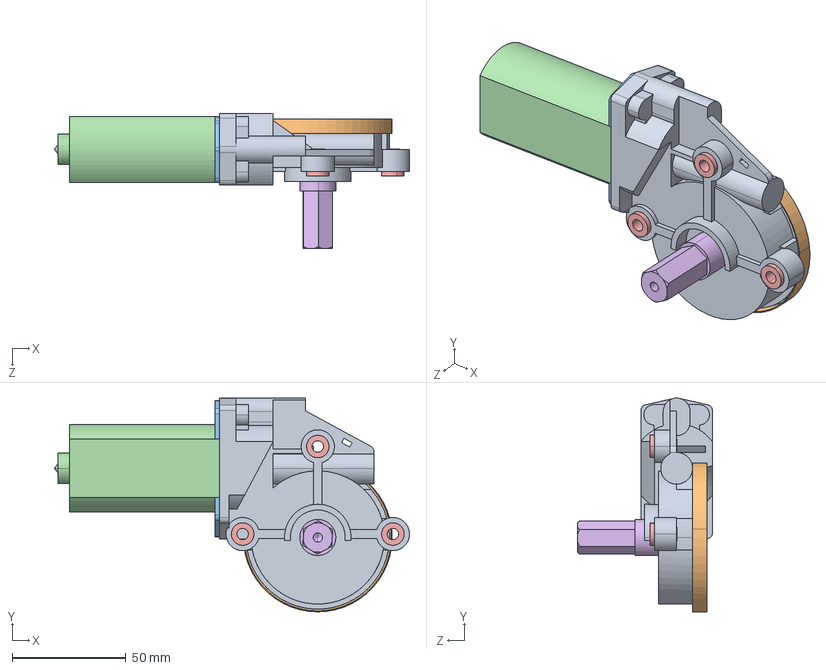
[picture p88: CAD file, 2020-01-15]
Andy-Mark/Motors/SnowBlowerMotor/am-2235a Snow Blower Motor With Hex Shaft.STEP
156.0 x 93.9 x 59.3 mm
AM-2235 gearbox housing
AM-2235 gear cap
AM-2235 motor
AM-2235 threaded insert x 3
AM-2235a hex output shaft
