SnoBotics981/CAD-MfgResources/Andy-Mark/Pixy Camera/Thingiverse-820353-Case/Pixy_Case_Back.stl

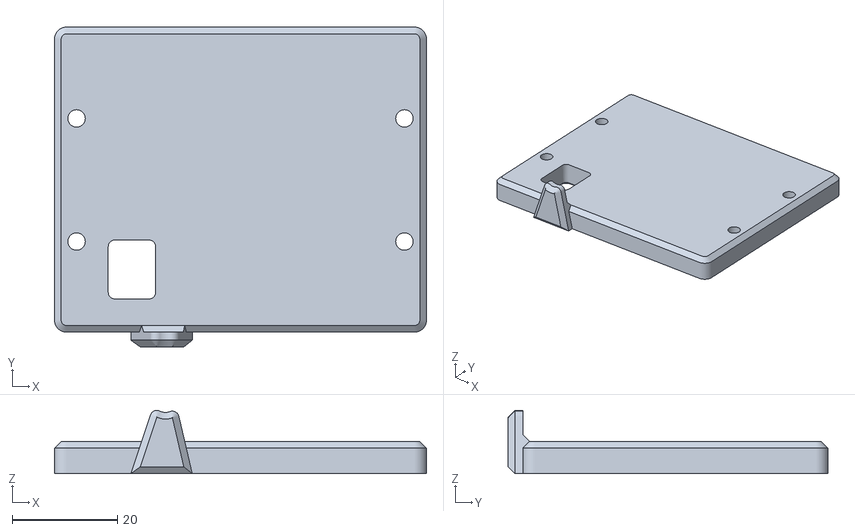
[picture p89: CAD file, 2018-06-26]
Andy-Mark/Pixy Camera/Thingiverse-820353-Case/Pixy_Case_Back.stl
70.6 x 60.7 x 12.0
