SnoBotics981/CAD-MfgResources/Andy-Mark/RatchetingGearbox/Modulox Winch_rev3.stp

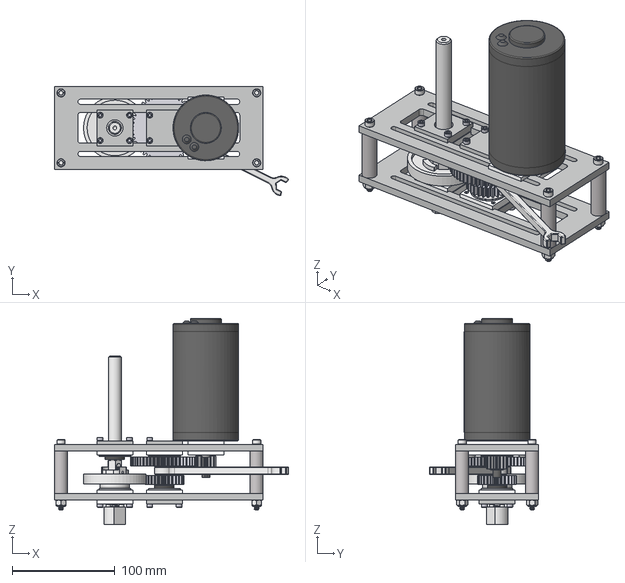
[picture p90: CAD file, 2018-06-26]
Andy-Mark/RatchetingGearbox/Modulox Winch_rev3.stp
227.8 x 106.4 x 200.8 mm
