SnoBotics981/CAD-MfgResources/Andy-Mark/Sprockets/35 Chain/1_2_inch_hex_hub/s35-15he-500h.STEP

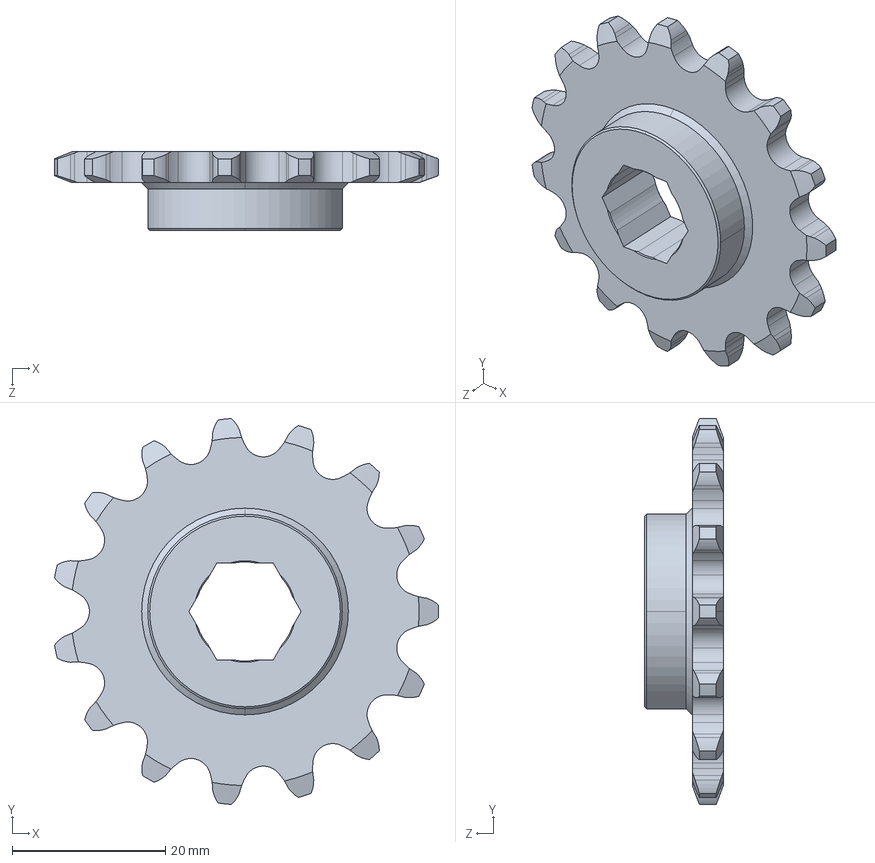
[picture p91: CAD file, 2018-06-26]
Andy-Mark/Sprockets/35 Chain/1_2_inch_hex_hub/s35-15he-500h.STEP
50.1 x 50.4 x 10.3 mm
