SnoBotics981/CAD-MfgResources/Andy-Mark/Wheels/4 in Diameter/am-3480+4IN+500Hex+Bore+Compliant+Wheel.STEP

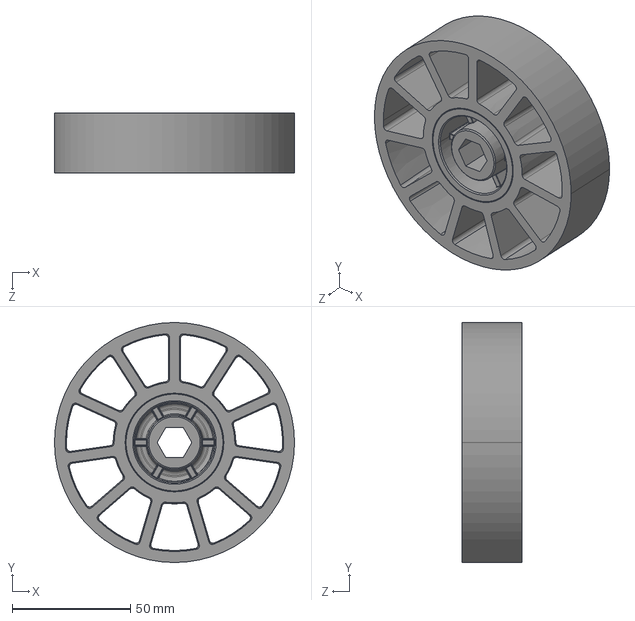
[picture p92: CAD file, 2018-06-26]
Andy-Mark/Wheels/4 in Diameter/am-3480+4IN+500Hex+Bore+Compliant+Wheel.STEP
101.6 x 101.6 x 25.4 mm
4IN Compliant Wheel FINAL Overmold
2in Wheel Intergrated 0500 HEX Hub
