SnoBotics981/CAD-MfgResources/BostonGear/miterGears/L112Y.stp

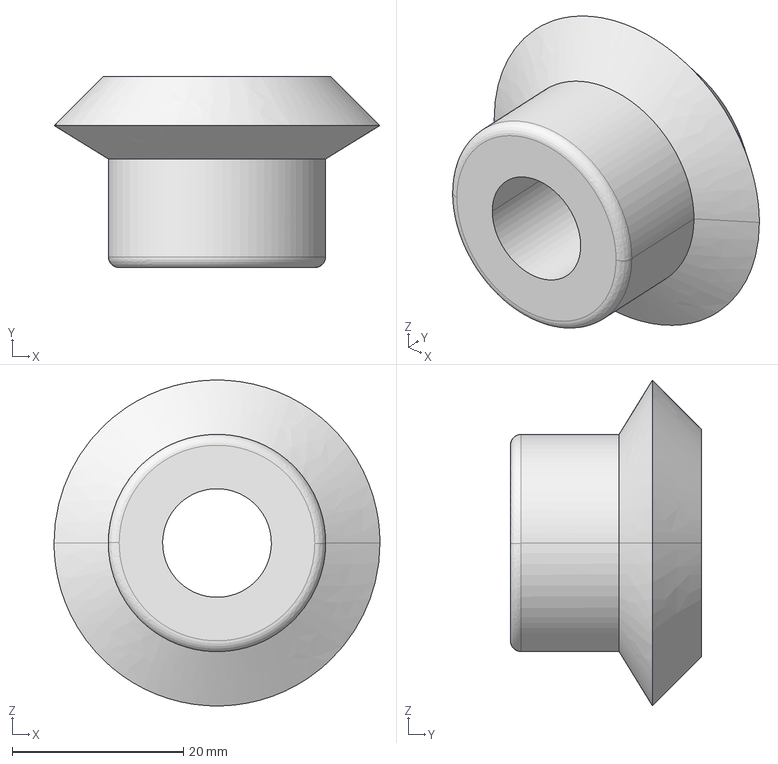
[picture p93: CAD file, 2015-07-15]
BostonGear/miterGears/L112Y.stp
38.1 x 22.4 x 38.1 mm
