SnoBotics981/CAD-MfgResources/BostonGear/wormAndWormGear/LUHB.stp

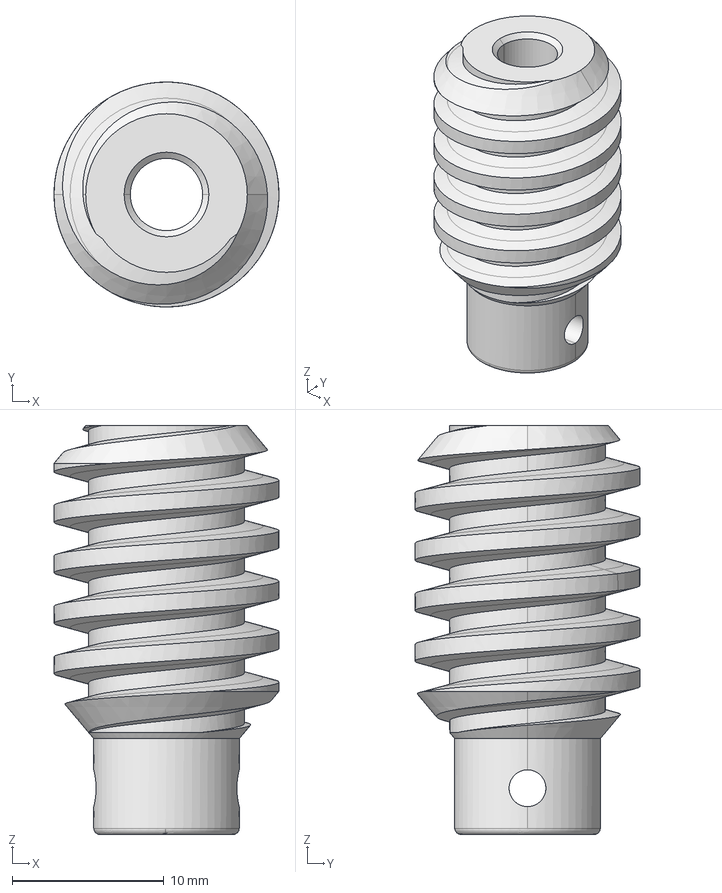
[picture p94: CAD file, 2015-07-15]
BostonGear/wormAndWormGear/LUHB.stp
14.8 x 14.8 x 26.9 mm
