SnoBotics981/CAD-MfgResources/RevRobotics/cadParts/REV-29-1221.STEP

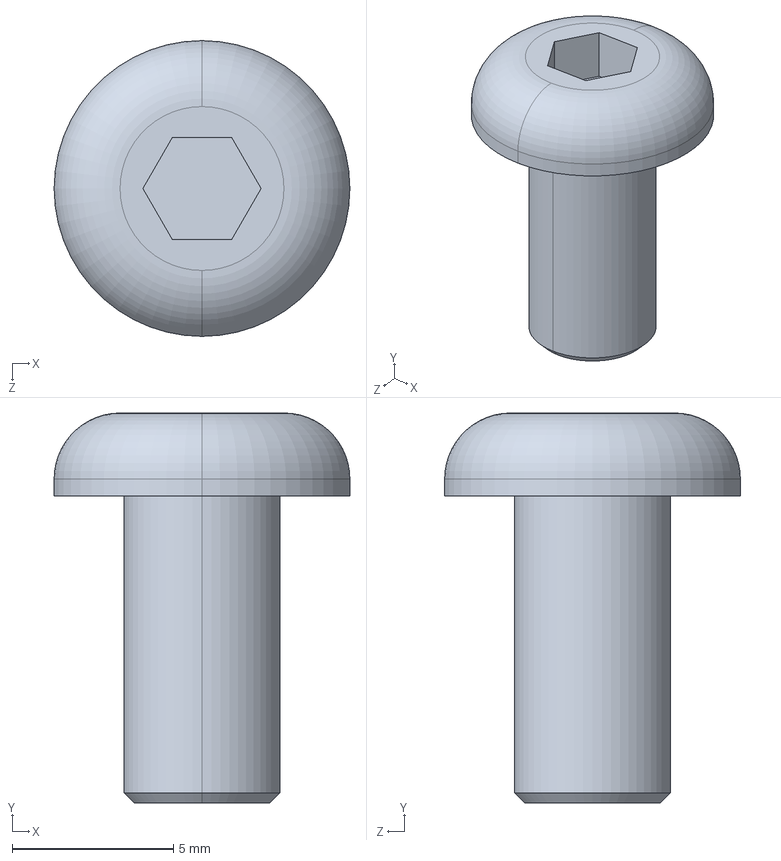
[picture p95: CAD file, 2019-02-25]
RevRobotics/cadParts/REV-29-1221.STEP
9.17 x 12.1 x 9.17 mm
