SnoBotics981/CAD-MfgResources/RevRobotics/LiftMechanism/3DPrintableLiftAccessories/MagneticLimitSwitchOffsetPlate.STEP

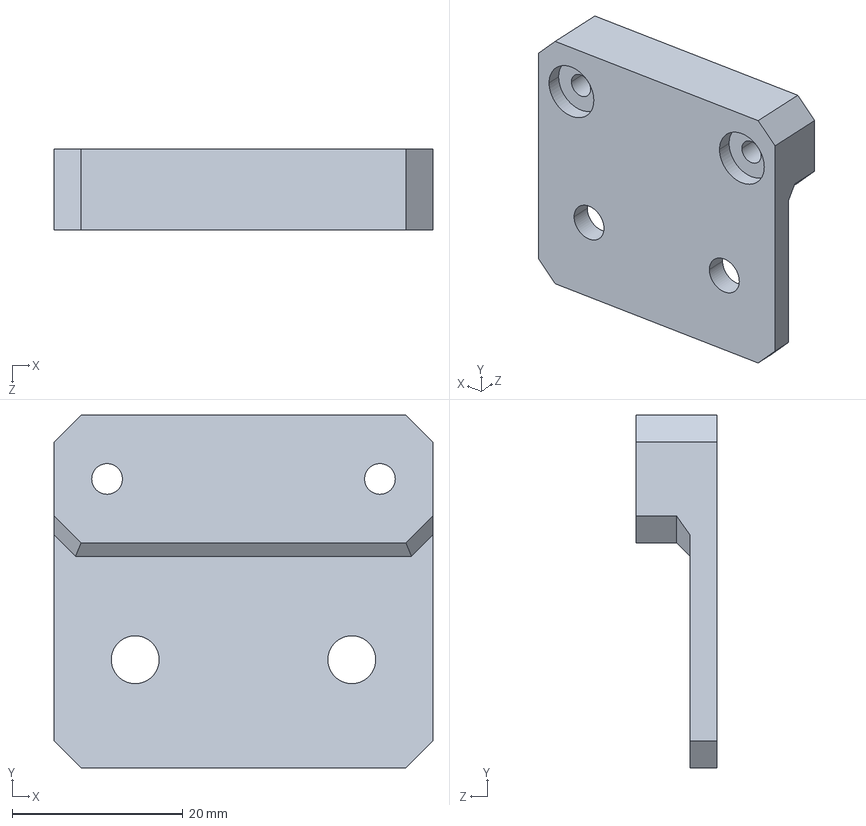
[picture p96: CAD file, 2018-06-25]
RevRobotics/LiftMechanism/3DPrintableLiftAccessories/MagneticLimitSwitchOffsetPlate.STEP
44.5 x 41.4 x 9.52 mm
