SnoBotics981/CAD-MfgResources/RevRobotics/LiftMechanism/REV-21-1578.STEP

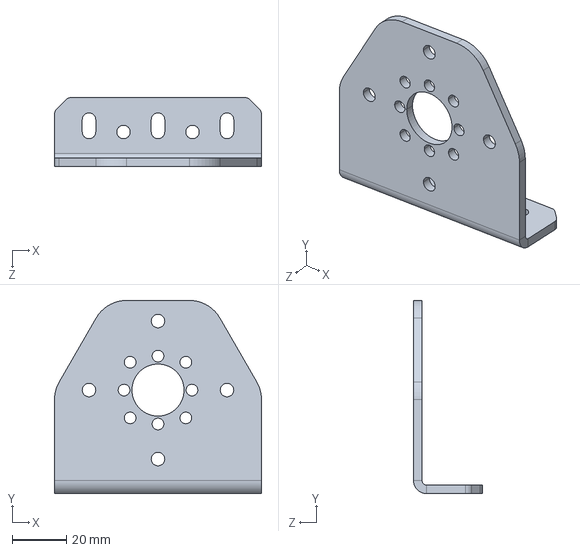
[picture p97: CAD file, 2019-02-06]
RevRobotics/LiftMechanism/REV-21-1578.STEP
76.2 x 71.1 x 25.4 mm
