SnoBotics981/CAD-MfgResources/ThingiVerse/2019_FRC_Battery_Handle/files/Center_Spacer.STL

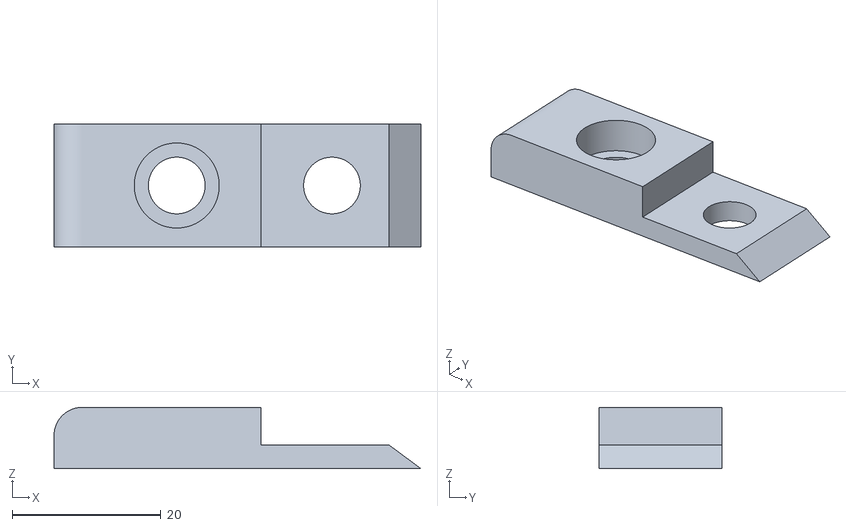
[picture p98: CAD file, 2019-12-20]
ThingiVerse/2019_FRC_Battery_Handle/files/Center_Spacer.STL
49.4 x 16.5 x 8.26
