SnoBotics981/CAD-MfgResources/ThingiVerse/Aveeno_Lotion_Bottle_Coupling/Aveeno_Lotion_Bottle_Coupling.stl

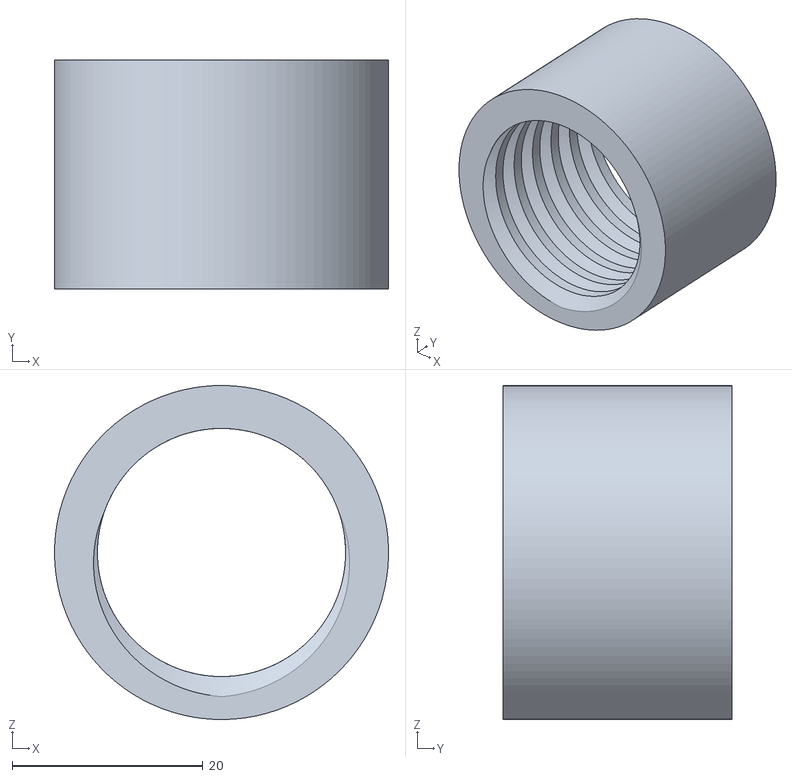
[picture p99: CAD file, 2018-06-25]
ThingiVerse/Aveeno_Lotion_Bottle_Coupling/Aveeno_Lotion_Bottle_Coupling.stl
35.0 x 24.0 x 35.0
