SnoBotics981/CAD-MfgResources/ThingiVerse/Battery Cap/files/Positive_Cap_545.stl

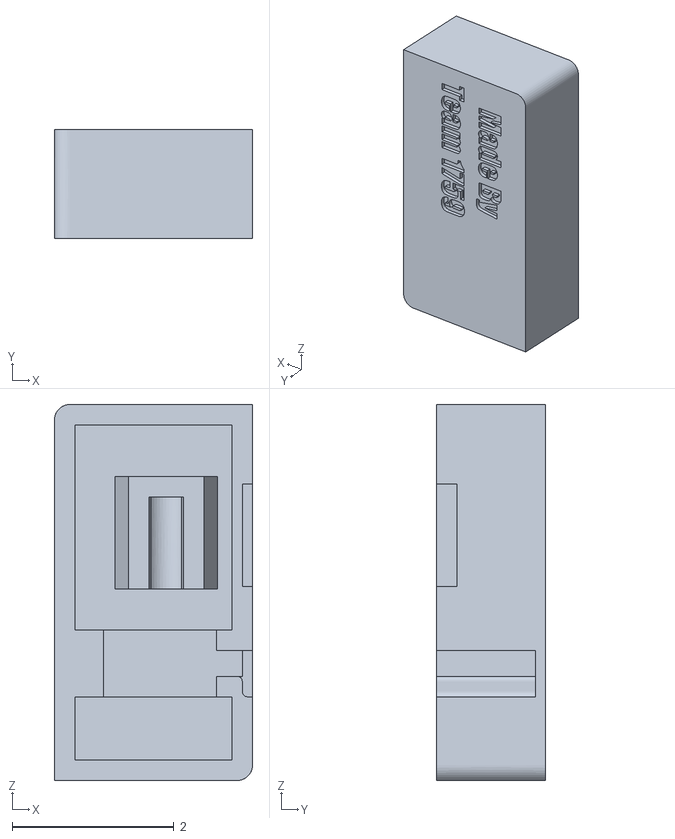
[picture p100: CAD file, 2018-06-25]
ThingiVerse/Battery Cap/files/Positive_Cap_545.stl
2.45 x 1.35 x 4.66
