SnoBotics981/CAD-MfgResources/ThingiVerse/Battery Flag - Cap/Battery_Cap_Blank.stl

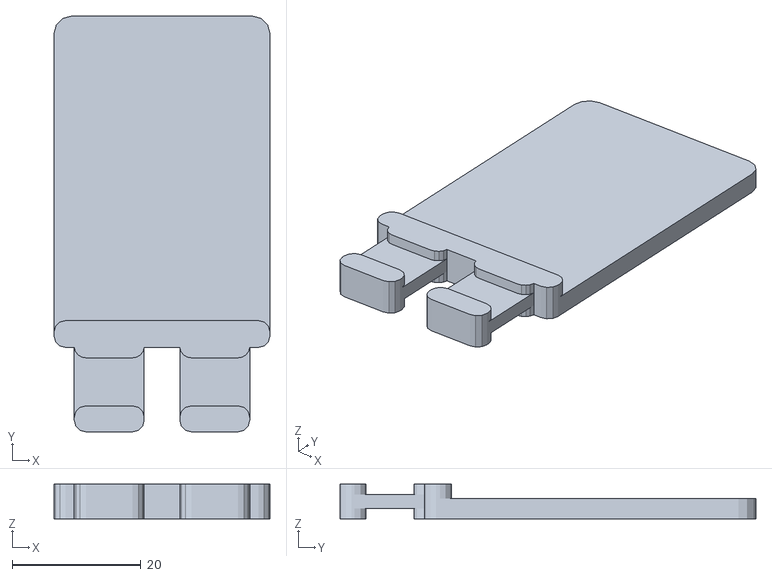
[picture p101: CAD file, 2018-06-25]
ThingiVerse/Battery Flag - Cap/Battery_Cap_Blank.stl
33.6 x 64.7 x 5.39
