SnoBotics981/CAD-MfgResources/ThingiVerse/CakeDecoratingStand-845304/rotor_2.stl

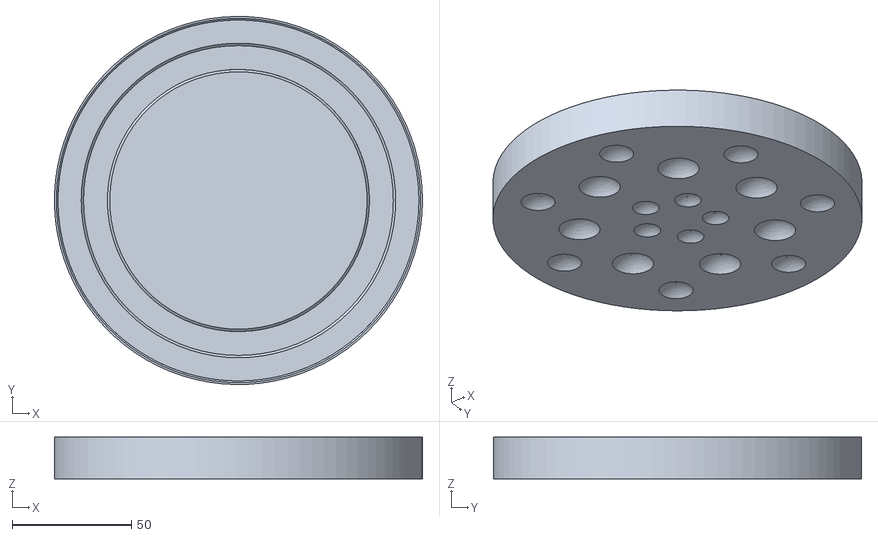
[picture p102: CAD file, 2018-06-25]
ThingiVerse/CakeDecoratingStand-845304/rotor_2.stl
154.4 x 154.5 x 17.5
