SnoBotics981/CAD-MfgResources/ThingiVerse/Customizable_Smooth_One_Two_Ended_Measuring_Spoon/two-ended-measuring-spoon_10ml_4ml.stl

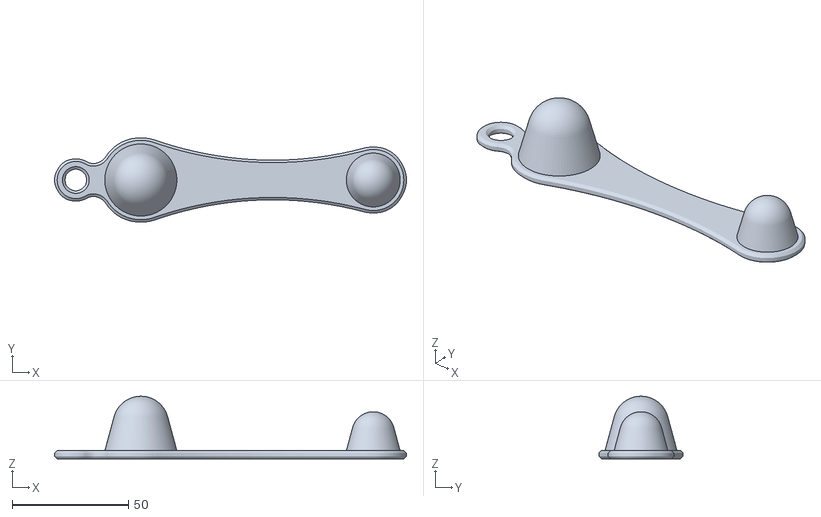
[picture p103: CAD file, 2018-07-29]
ThingiVerse/Customizable_Smooth_One_Two_Ended_Measuring_Spoon/two-ended-measuring-spoon_10ml_4ml.stl
151.5 x 36.2 x 26.9
