SnoBotics981/CAD-MfgResources/ThingiVerse/Customized Containers/files/Lid25_right_knurled.stl

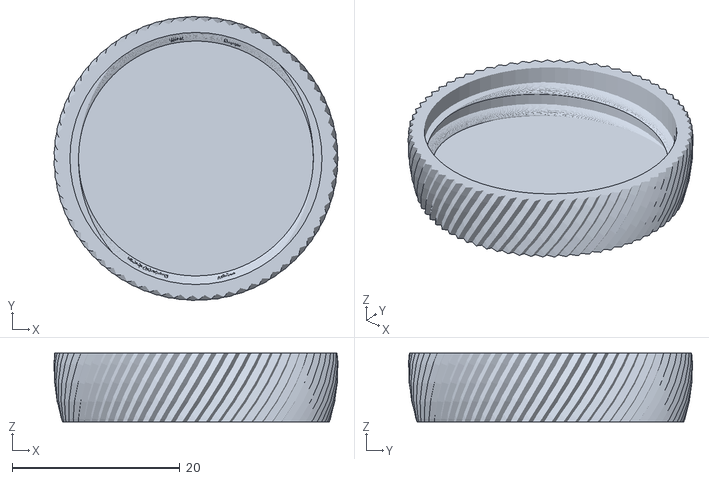
[picture p104: CAD file, 2019-01-23]
ThingiVerse/Customized Containers/files/Lid25_right_knurled.stl
33.8 x 33.8 x 8.17
