SnoBotics981/CAD-MfgResources/ThingiVerse/FIRST RobotRio Mounting Bracket/files/Robo_Rio_Bracket.stl

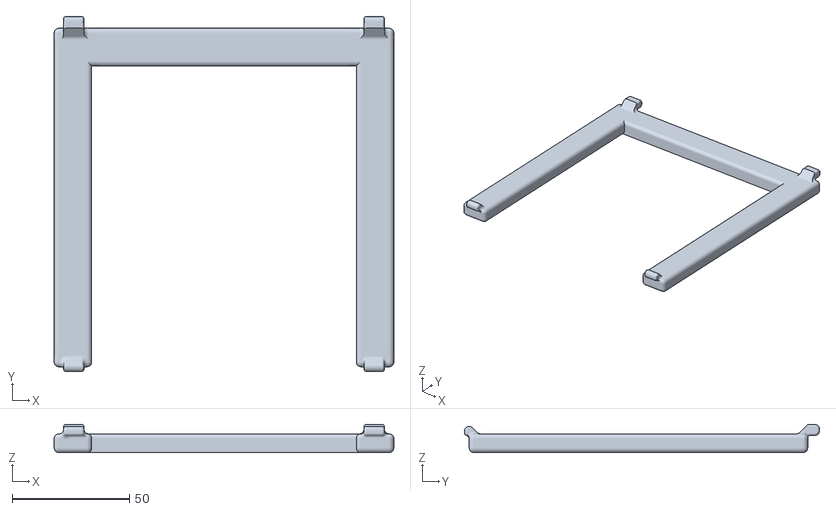
[picture p105: CAD file, 2018-06-25]
ThingiVerse/FIRST RobotRio Mounting Bracket/files/Robo_Rio_Bracket.stl
144.7 x 151.2 x 12.0
