SnoBotics981/CAD-MfgResources/ThingiVerse/Grinder-double_gear-V2.0/files/07_bout_haut.stl

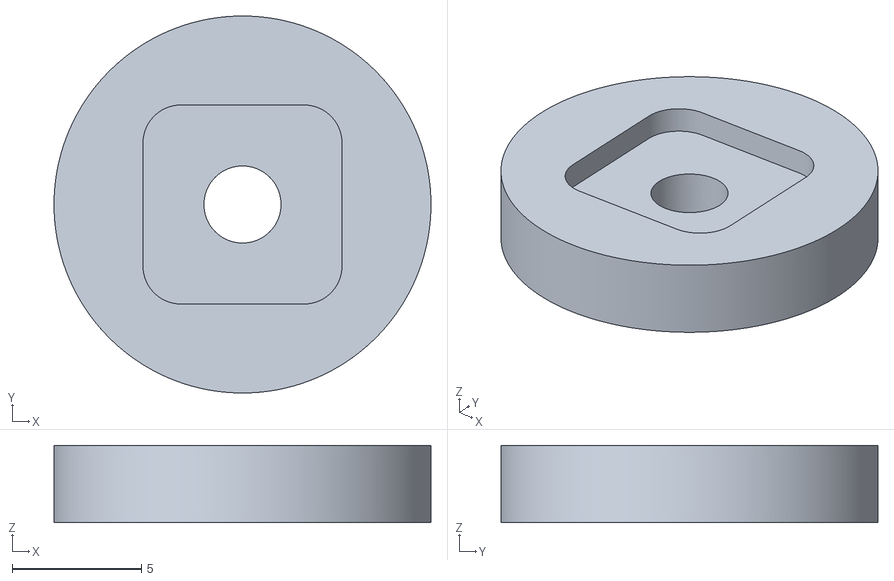
[picture p106: CAD file, 2018-08-04]
ThingiVerse/Grinder-double_gear-V2.0/files/07_bout_haut.stl
14.6 x 14.6 x 3.00
