SnoBotics981/CAD-MfgResources/ThingiVerse/Meade_motorized_focus_system-3557659/files/SmallGear_M4.stl

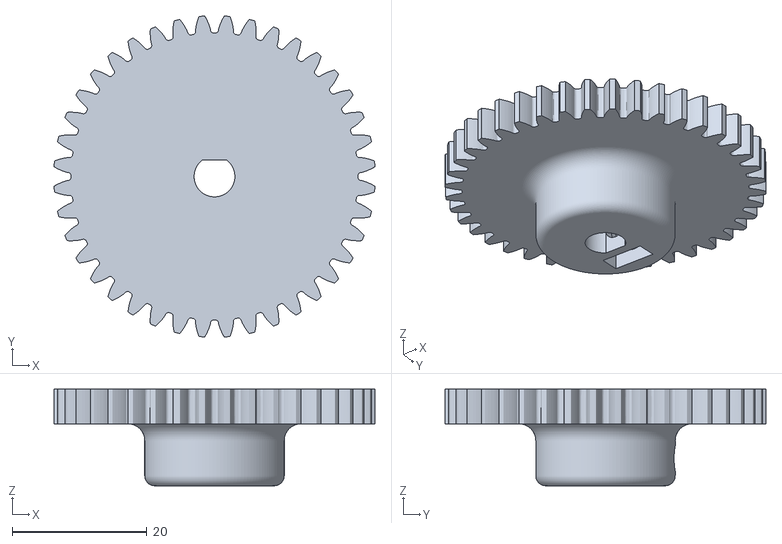
[picture p107: CAD file, 2019-07-18]
ThingiVerse/Meade_motorized_focus_system-3557659/files/SmallGear_M4.stl
47.6 x 47.6 x 14.3
