SnoBotics981/CAD-MfgResources/ThingiVerse/Measuring_Cup/150_ml.stl

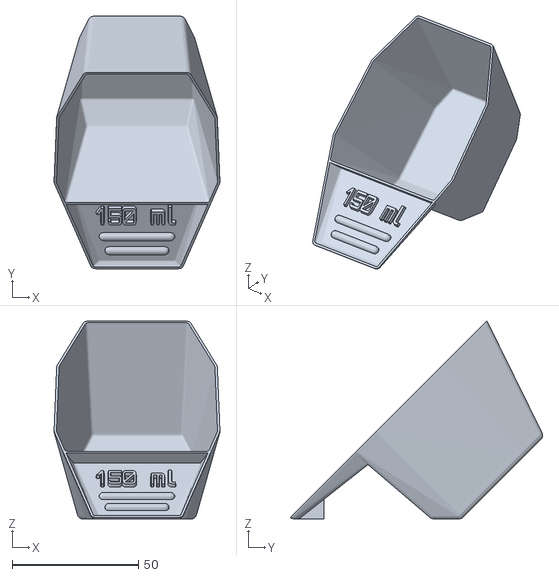
[picture p108: CAD file, 2018-07-29]
ThingiVerse/Measuring_Cup/150_ml.stl
65.7 x 100.1 x 78.4
