SnoBotics981/CAD-MfgResources/ThingiVerse/Parametric_Measuring_Spoon/MeasSpoon_3_5tsp_150_handle.stl

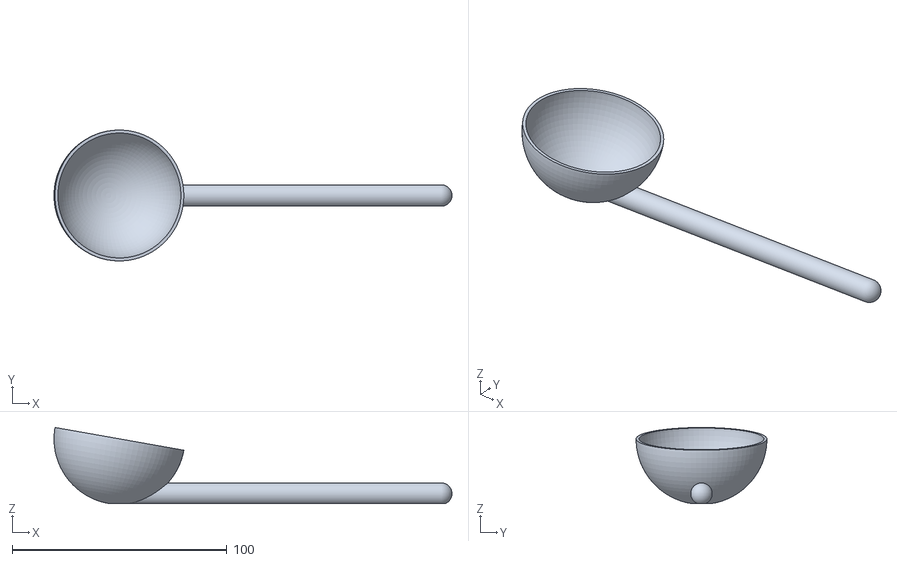
[picture p109: CAD file, 2022-03-09]
ThingiVerse/Parametric_Measuring_Spoon/MeasSpoon_3_5tsp_150_handle.stl
185.5 x 61.0 x 35.4
