SnoBotics981/CAD-MfgResources/ThingiVerse/RachetAndPawls/thinkfun_ratchet_set_WHEEL.stl

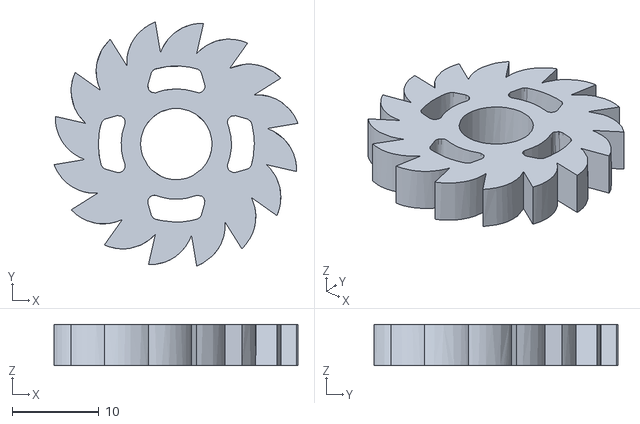
[picture p110: CAD file, 2018-06-25]
ThingiVerse/RachetAndPawls/thinkfun_ratchet_set_WHEEL.stl
28.2 x 28.2 x 4.77
