SnoBotics981/CAD-MfgResources/ThingiVerse/Raspberry_Pi_Camera_Module_v2.1_Model/files/RPi_Camera_V2.1.stl

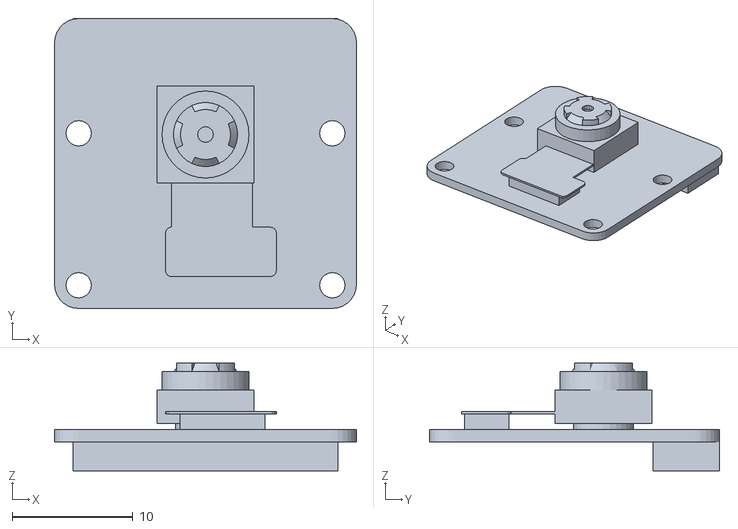
[picture p111: CAD file, 2019-01-23]
ThingiVerse/Raspberry_Pi_Camera_Module_v2.1_Model/files/RPi_Camera_V2.1.stl
25.0 x 24.0 x 8.90
