SnoBotics981/CAD-MfgResources/ThingiVerse/Raspberry_Pi_Camera_Telescope_Mount/files/rpi-cam-tube.stl

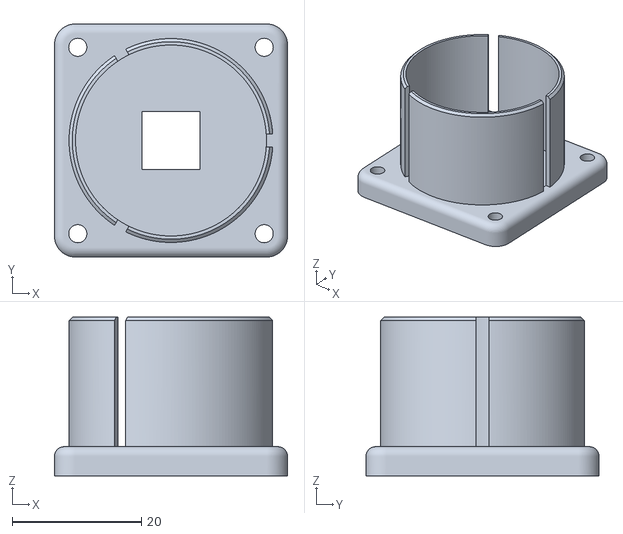
[picture p112: CAD file, 2018-12-05]
ThingiVerse/Raspberry_Pi_Camera_Telescope_Mount/files/rpi-cam-tube.stl
36.0 x 36.0 x 24.5
