SnoBotics981/CAD-MfgResources/ThingiVerse/Raspberry_Pi_Camera_v.2_Focus_Tool/files/RPi_Camera_Focus_Tool.stl

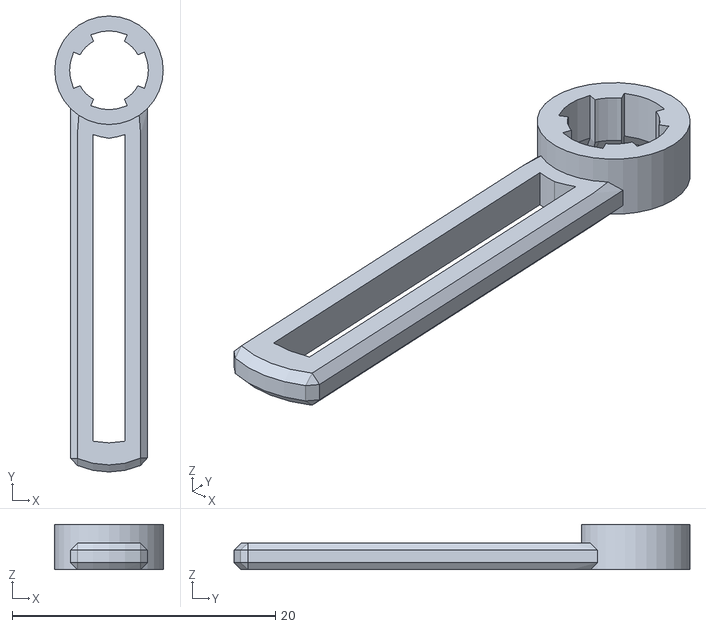
[picture p113: CAD file, 2018-12-05]
ThingiVerse/Raspberry_Pi_Camera_v.2_Focus_Tool/files/RPi_Camera_Focus_Tool.stl
8.25 x 34.7 x 3.43
