SnoBotics981/CAD-MfgResources/ThingiVerse/Raspberry_Pi_Camera_V2.1_Lens_Adjustment_Spanner/files/raspy_cam_wrench_C.6a.obj

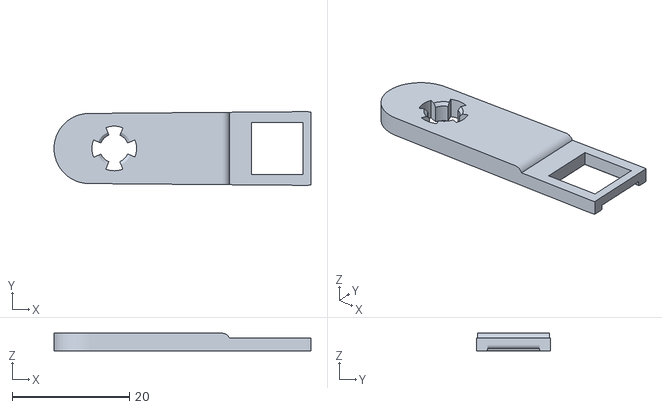
[picture p114: CAD file, 2018-12-05]
ThingiVerse/Raspberry_Pi_Camera_V2.1_Lens_Adjustment_Spanner/files/raspy_cam_wrench_C.6a.obj
43.8 x 12.6 x 3.00
