SnoBotics981/CAD-MfgResources/ThingiVerse/RoboRio/files/Robo_Rio_Mount.stl

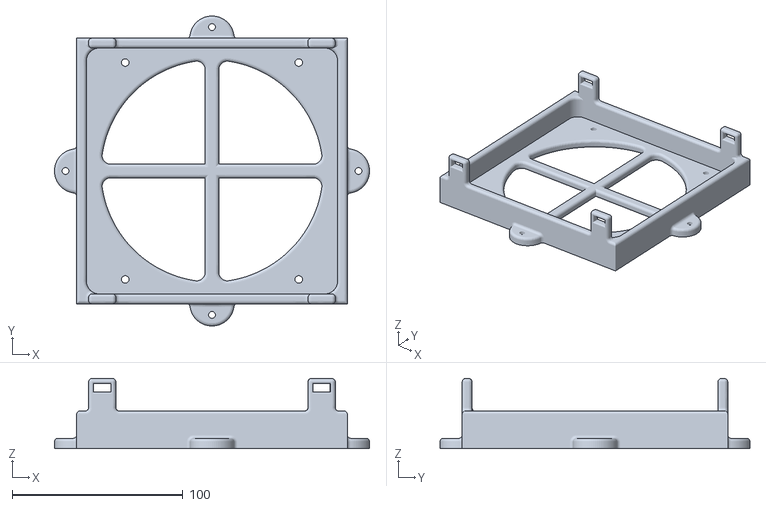
[picture p115: CAD file, 2018-06-25]
ThingiVerse/RoboRio/files/Robo_Rio_Mount.stl
184.5 x 181.5 x 41.0
