SnoBotics981/CAD-MfgResources/ThingiVerse/ScadThreadingLibrary/files/M12.stl

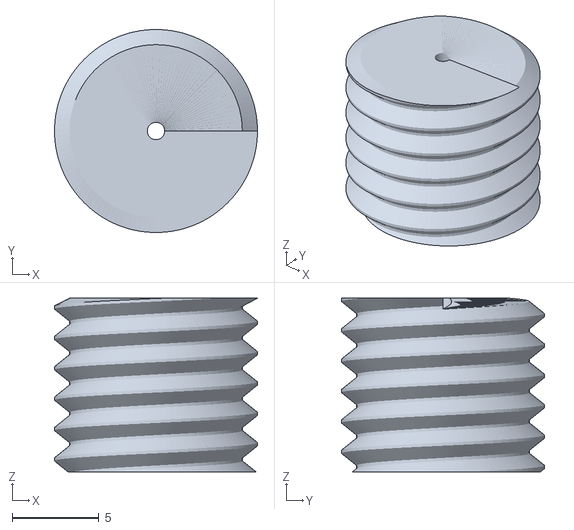
[picture p116: CAD file, 2018-06-25]
ThingiVerse/ScadThreadingLibrary/files/M12.stl
11.7 x 11.7 x 10.0
