SnoBotics981/CAD-MfgResources/ThingiVerse/Soldering_Iron_Stand_-_DotScott1_Remix-2088796/files/Soldering_Iron_Stand_WithSupport.STL

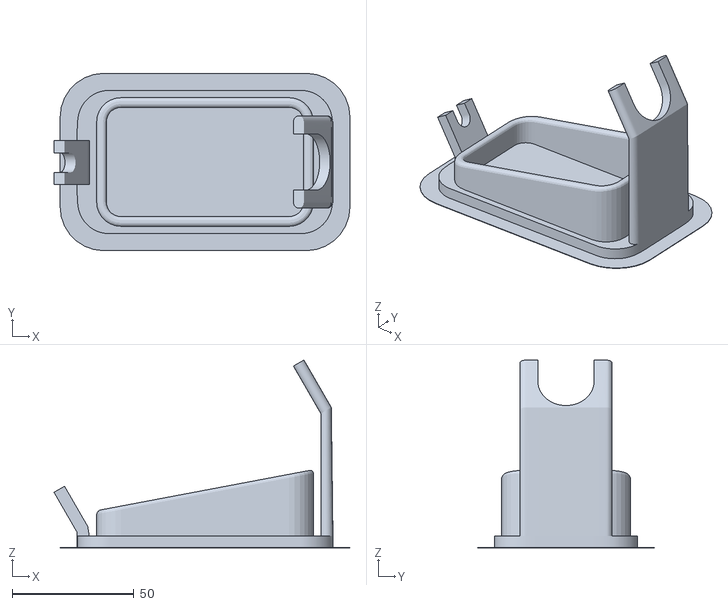
[picture p117: CAD file, 2019-02-17]
ThingiVerse/Soldering_Iron_Stand_-_DotScott1_Remix-2088796/files/Soldering_Iron_Stand_WithSupport.STL
121.5 x 72.8 x 77.2
