SnoBotics981/CAD-MfgResources/ThingiVerse/SprayCanNozzels/spraycan_cap.stl

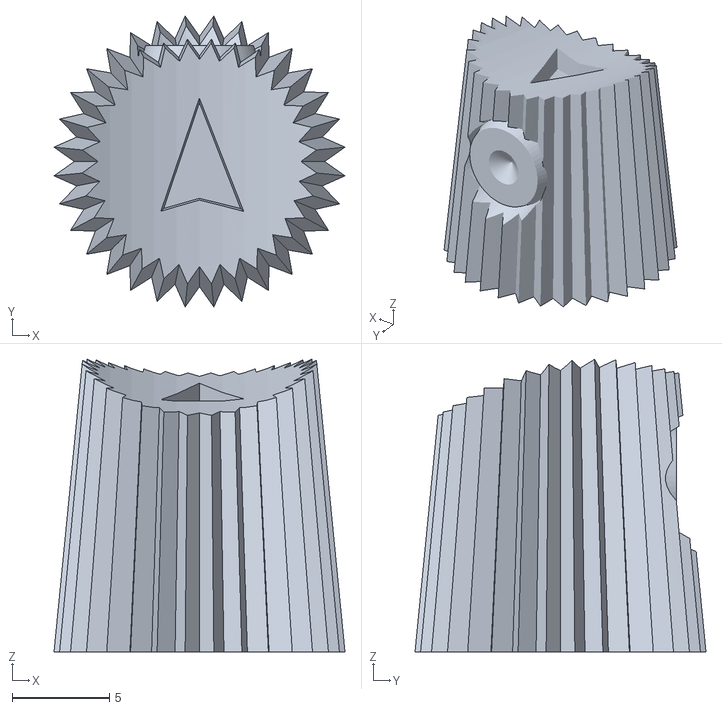
[picture p118: CAD file, 2018-07-13]
ThingiVerse/SprayCanNozzels/spraycan_cap.stl
14.9 x 14.9 x 15.0
