SnoBotics981/CAD-MfgResources/ThingiVerse/WindowMotorAdapter/0981-rds-WA-0002-v003.stl

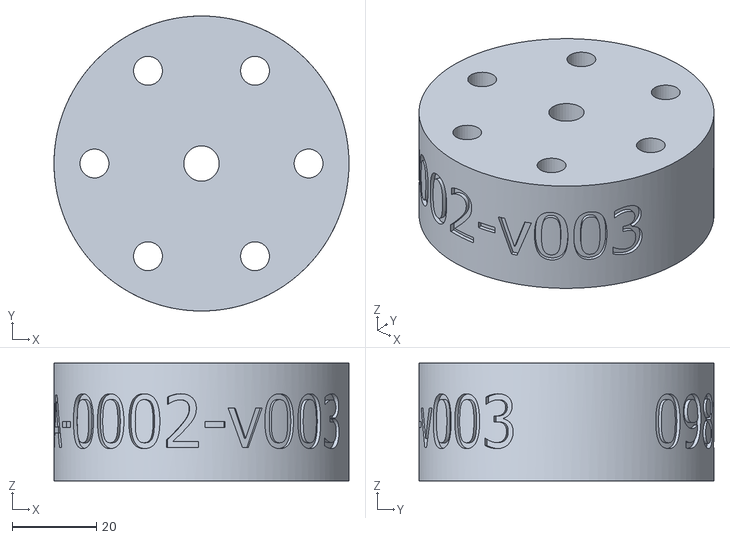
[picture p119: CAD file, 2018-07-29]
ThingiVerse/WindowMotorAdapter/0981-rds-WA-0002-v003.stl
70.0 x 70.0 x 28.0
