SnoBotics981/CAD-MfgResources/VexRobotics/#25 Sprockets/16 Teeth/217-2642-STEP-20140807.STEP

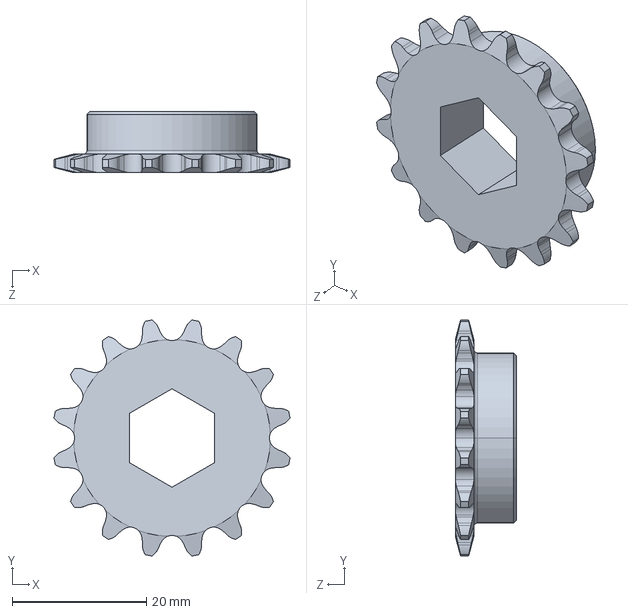
[picture p120: CAD file, 2018-06-25]
VexRobotics/#25 Sprockets/16 Teeth/217-2642-STEP-20140807.STEP
35.2 x 35.2 x 9.18 mm
