SnoBotics981/CAD-MfgResources/VexRobotics/#25 Sprockets/18 Teeth/217-3488-STEP.STEP

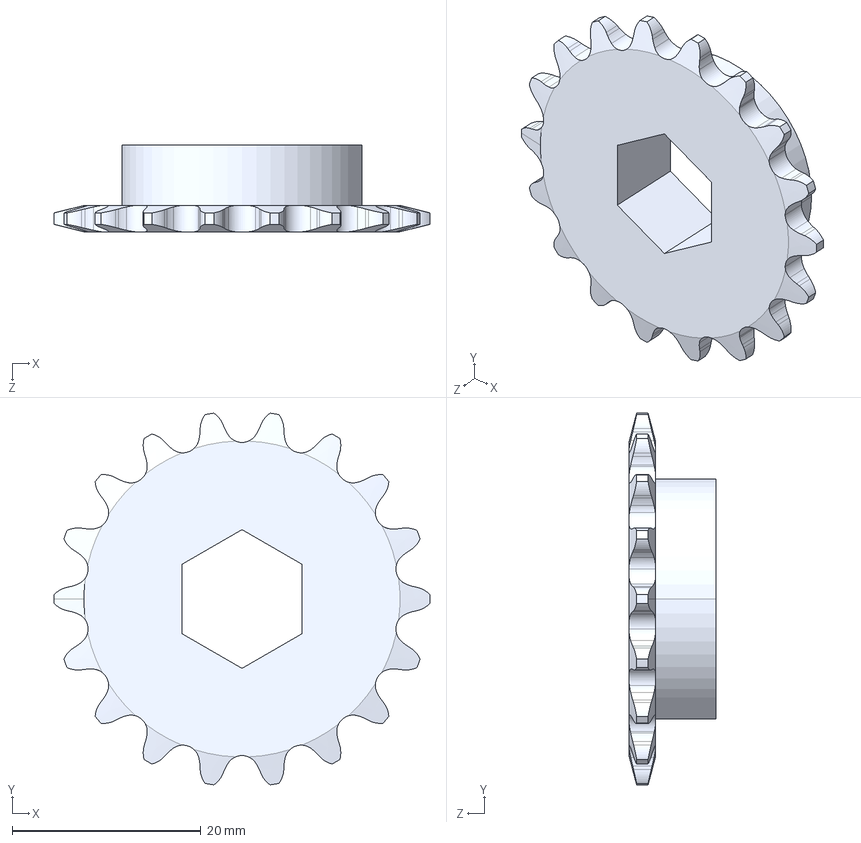
[picture p121: CAD file, 2018-06-25]
VexRobotics/#25 Sprockets/18 Teeth/217-3488-STEP.STEP
39.8 x 39.4 x 9.18 mm
