SnoBotics981/CAD-MfgResources/VexRobotics/#25 Sprockets/66 Teeth/217-2628.20121204.STEP

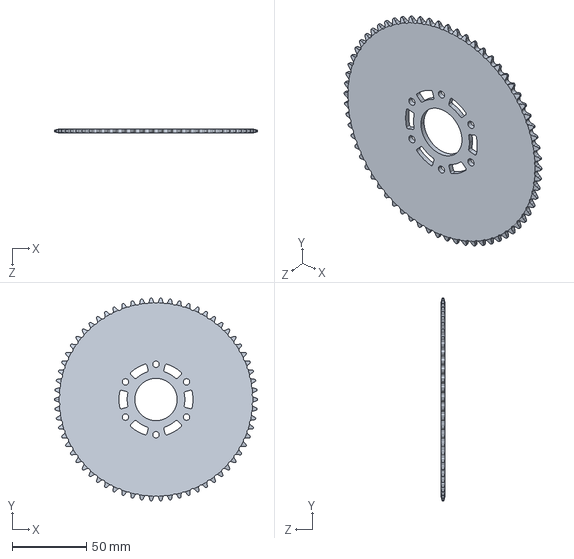
[picture p122: CAD file, 2018-06-25]
VexRobotics/#25 Sprockets/66 Teeth/217-2628.20121204.STEP
137.1 x 137.0 x 2.79 mm
