SnoBotics981/CAD-MfgResources/VexRobotics/#25 Sprockets/72 Teeth/217-2627.20121204.STEP

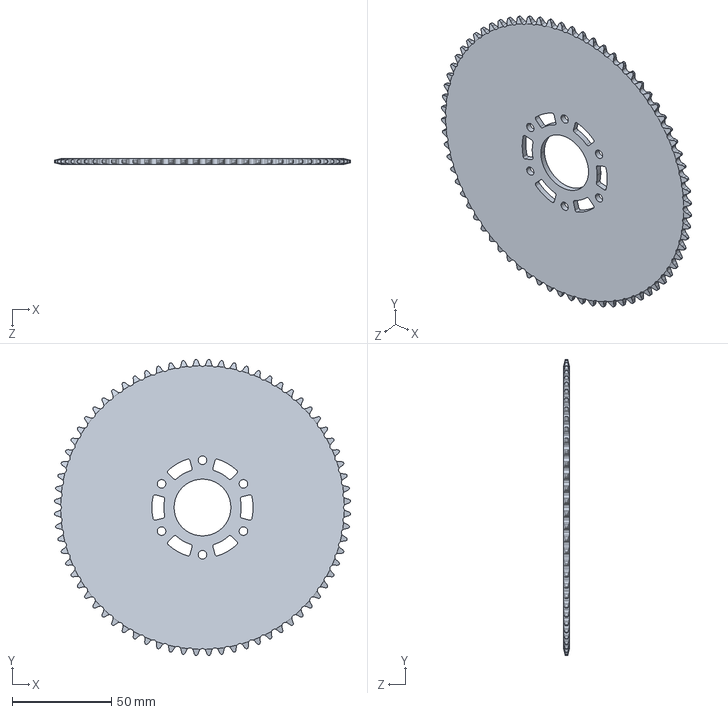
[picture p123: CAD file, 2018-06-25]
VexRobotics/#25 Sprockets/72 Teeth/217-2627.20121204.STEP
149.1 x 149.1 x 2.79 mm
