SnoBotics981/CAD-MfgResources/VexRobotics/15t Bevel Gear with 3_8 Hex Bore/217-3344-STEP.STEP

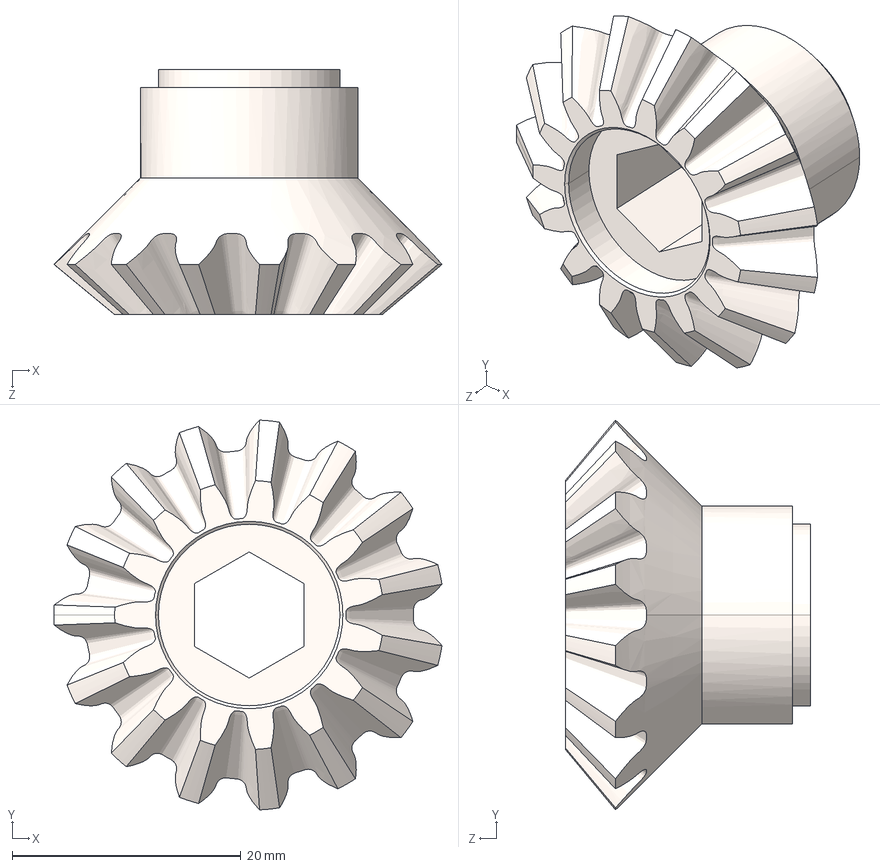
[picture p124: CAD file, 2015-07-15]
VexRobotics/15t Bevel Gear with 3_8 Hex Bore/217-3344-STEP.STEP
33.9 x 34.1 x 21.5 mm
