SnoBotics981/CAD-MfgResources/VexRobotics/217-2817-STEP/217-2817-STEP.STEP

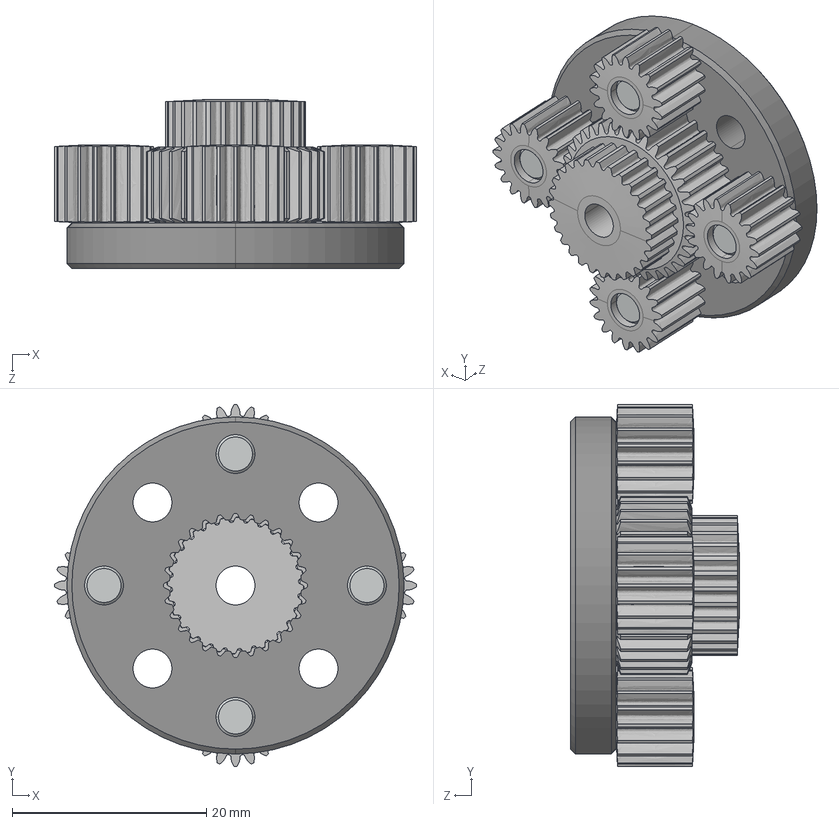
[picture p125: CAD file, 2015-07-15]
VexRobotics/217-2817-STEP/217-2817-STEP.STEP
37.3 x 37.3 x 17.4 mm
217-2724-001 Rev1_Sun_Driver01
217-2724-002 Rev1
217-2724-003 Rev1_Planet_Revolving_Follower01 x 4
217-2625-010 Rev1 x 4
