SnoBotics981/CAD-MfgResources/VexRobotics/217-2818-STEP/217-2818-STEP.STEP

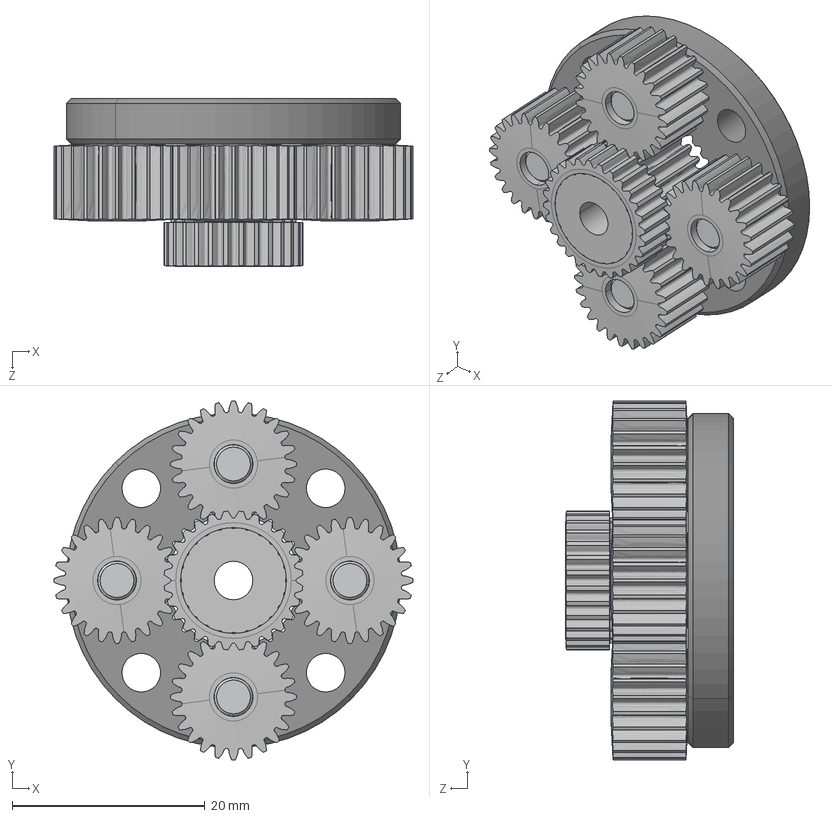
[picture p126: CAD file, 2015-07-15]
VexRobotics/217-2818-STEP/217-2818-STEP.STEP
37.3 x 37.3 x 17.4 mm
217-2725-001 Rev1_24t Sun
217-2725-002 Rev1_24t Planet x 4
217-2724-002 Rev1
217-2625-010 Rev1 x 4
