SnoBotics981/CAD-MfgResources/VexRobotics/217-2820-STEP/217-2820-STEP.STEP

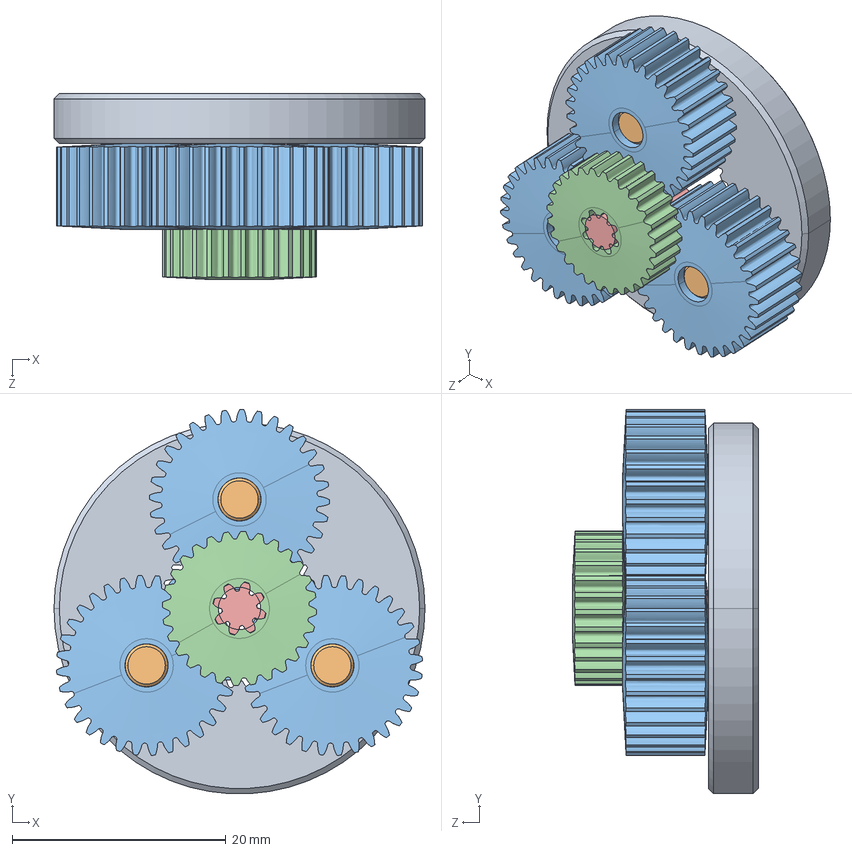
[picture p127: CAD file, 2015-07-15]
VexRobotics/217-2820-STEP/217-2820-STEP.STEP
34.7 x 35.9 x 17.4 mm
217-2625-008 Rev1
217-2625-010 Rev1 x 3
217-2625-005 Rev1_Planet_Revolving_Follower01 x 3
217-2625-007 Rev1_Sun_Driver01
