SnoBotics981/CAD-MfgResources/VexRobotics/217-2822-550MountingPlate-STEP/217-2822-550 Mounting Plate STEP.STEP

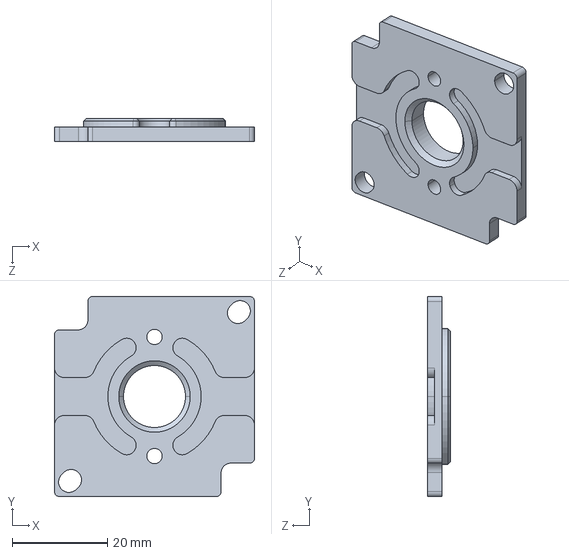
[picture p128: CAD file, 2015-07-15]
VexRobotics/217-2822-550MountingPlate-STEP/217-2822-550 Mounting Plate STEP.STEP
42.0 x 42.0 x 4.80 mm
