SnoBotics981/CAD-MfgResources/VexRobotics/217-2822-775MountingPlate-STEP/217-2822-775 Mounting Plate STEP.STEP

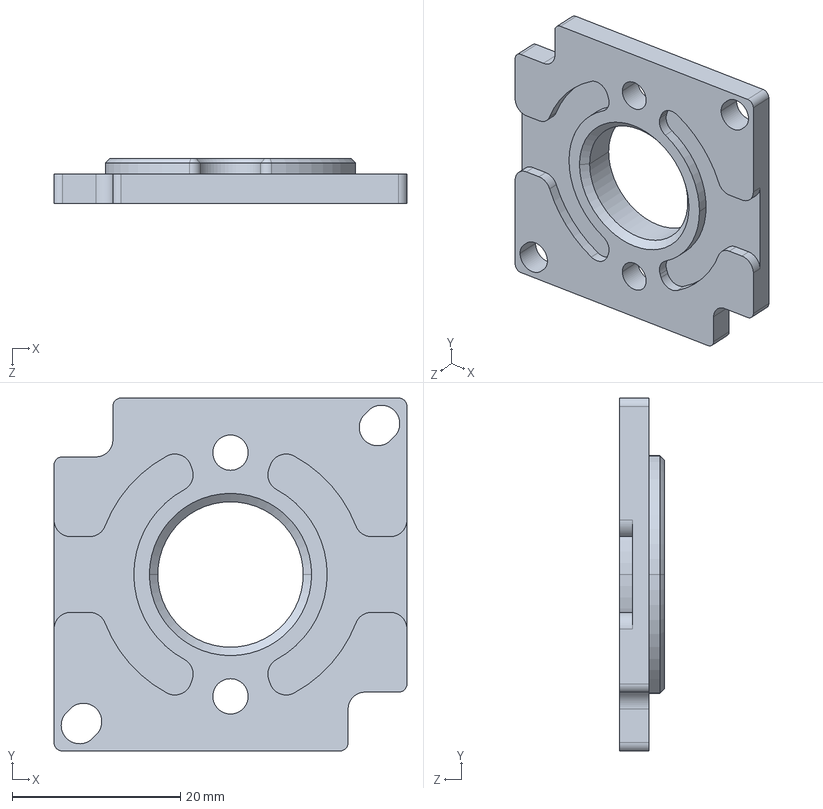
[picture p129: CAD file, 2015-07-15]
VexRobotics/217-2822-775MountingPlate-STEP/217-2822-775 Mounting Plate STEP.STEP
42.0 x 42.0 x 5.30 mm
