SnoBotics981/CAD-MfgResources/VexRobotics/217-2822-AM-9015MountingPlate-STEP/217-2822-AM-9015 Mounting Plate STEP.STEP

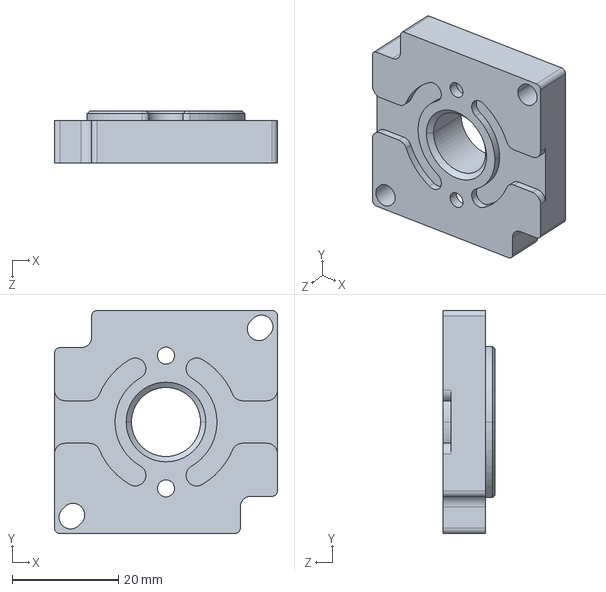
[picture p130: CAD file, 2015-07-15]
VexRobotics/217-2822-AM-9015MountingPlate-STEP/217-2822-AM-9015 Mounting Plate STEP.STEP
42.0 x 42.0 x 9.80 mm
