SnoBotics981/CAD-MfgResources/VexRobotics/217-2822-BAGMountingPlate-STEP/217-2822-BAG Mounting Plate STEP.STEP

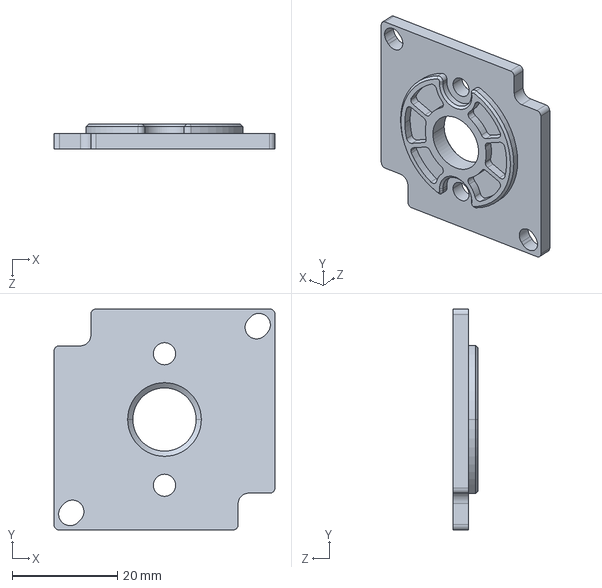
[picture p131: CAD file, 2015-07-15]
VexRobotics/217-2822-BAGMountingPlate-STEP/217-2822-BAG Mounting Plate STEP.STEP
42.0 x 42.0 x 4.80 mm
