SnoBotics981/CAD-MfgResources/VexRobotics/217-2893-STEP/217-2893.20121205.STEP

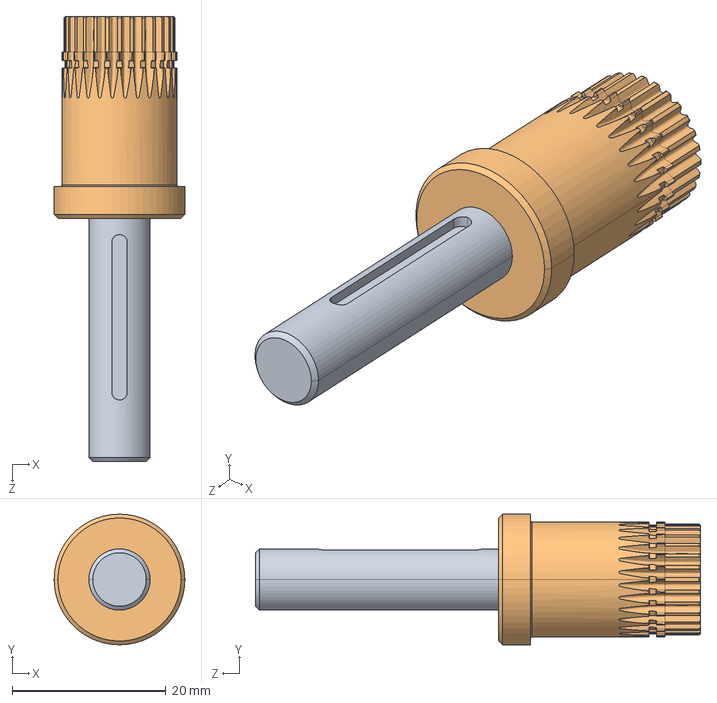
[picture p132: CAD file, 2015-07-15]
VexRobotics/217-2893-STEP/217-2893.20121205.STEP
17.0 x 17.0 x 57.8 mm
