SnoBotics981/CAD-MfgResources/VexRobotics/217-2895-STEP/217-2895.20121205.STEP

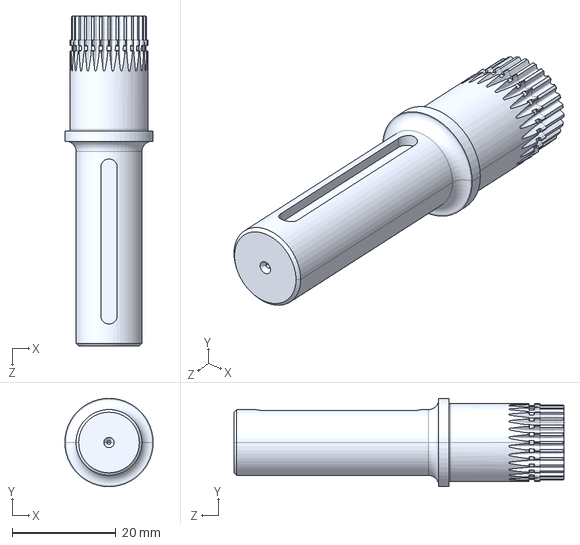
[picture p133: CAD file, 2015-07-15]
VexRobotics/217-2895-STEP/217-2895.20121205.STEP
17.0 x 17.0 x 63.5 mm
