SnoBotics981/CAD-MfgResources/VexRobotics/217-2897-STEP/217-2897.20121205.STEP

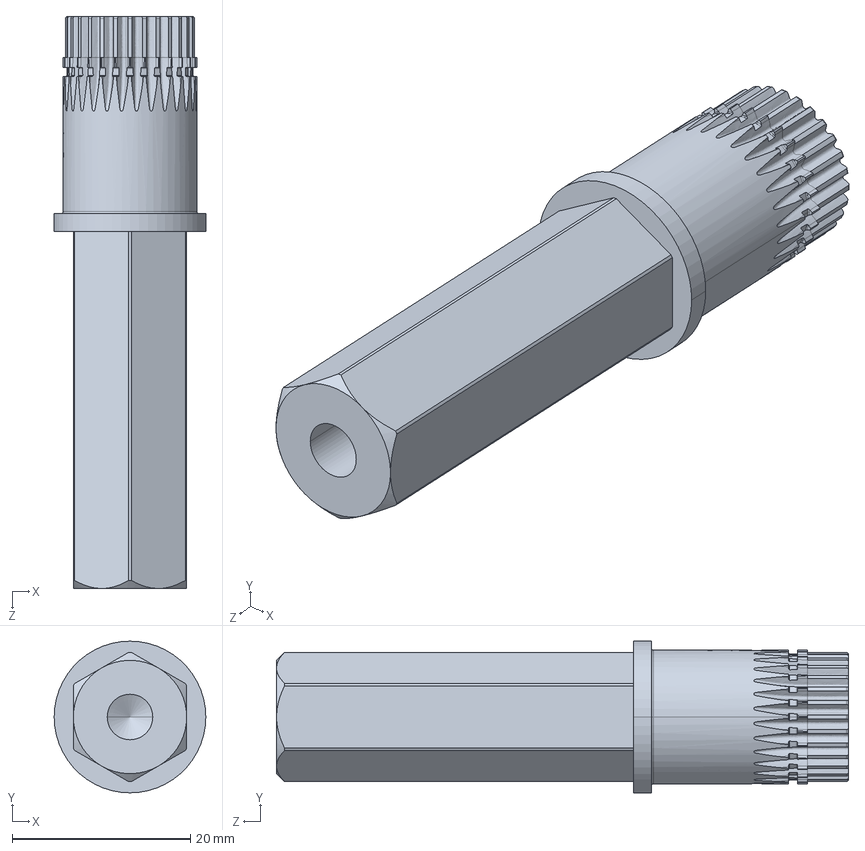
[picture p134: CAD file, 2015-07-15]
VexRobotics/217-2897-STEP/217-2897.20121205.STEP
17.0 x 17.0 x 64.1 mm
