SnoBotics981/CAD-MfgResources/VexRobotics/217-3102-STEP/217-3102-STEP.STEP

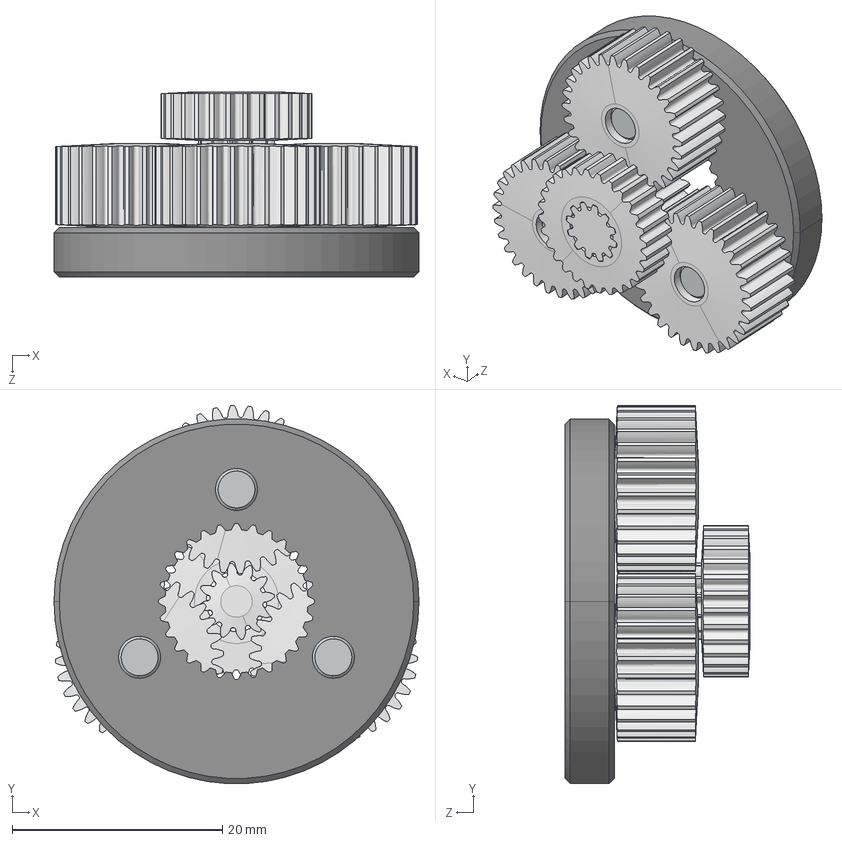
[picture p135: CAD file, 2015-07-15]
VexRobotics/217-3102-STEP/217-3102-STEP.STEP
34.7 x 36.0 x 17.6 mm
217-3102-003 Rev1_Planet_Revolving_Follower01 x 3
217-3102-005 Rev1_Sun_Driver01
217-3102-001 Rev1
217-2625-010 Rev1 x 3
