SnoBotics981/CAD-MfgResources/VexRobotics/217-3106-STEP/217-3106-STEP.STEP

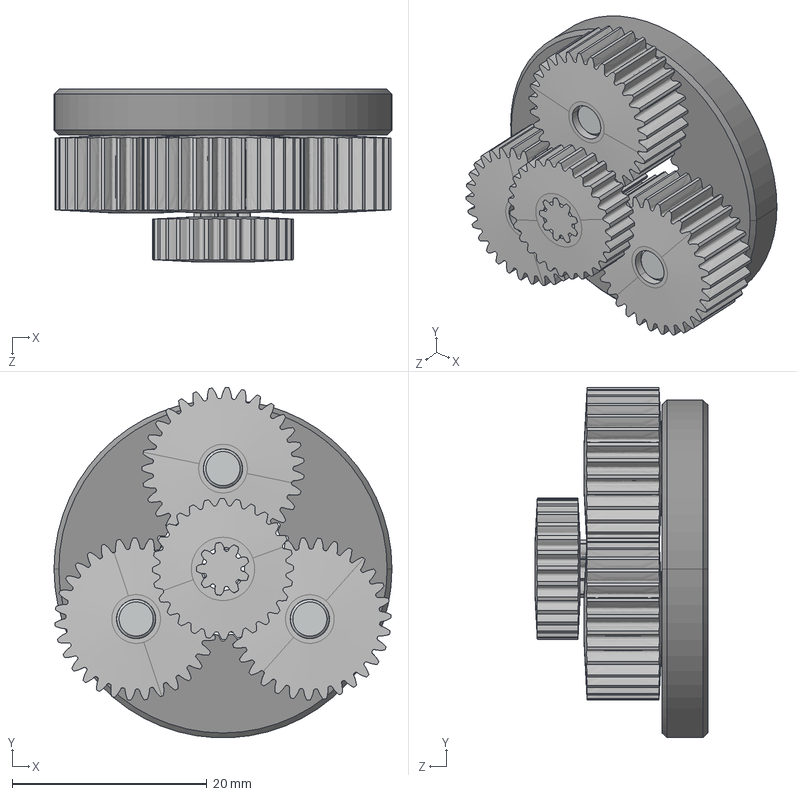
[picture p136: CAD file, 2015-07-15]
VexRobotics/217-3106-STEP/217-3106-STEP.STEP
34.7 x 36.0 x 17.7 mm
217-3106-002 Rev1_Planet_Revolving_Follower01 x 3
217-3106-003 Rev1
217-3106-001 Rev1_Sun_Driver01
217-2625-010 Rev1 x 3
