SnoBotics981/CAD-MfgResources/VexRobotics/217-3351-STEP/217-3351-STEP.STEP

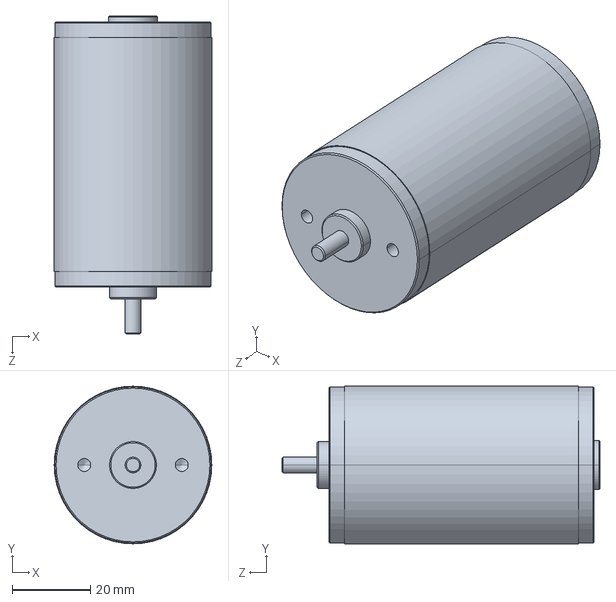
[picture p137: CAD file, 2015-07-15]
VexRobotics/217-3351-STEP/217-3351-STEP.STEP
40.4 x 40.4 x 81.5 mm
