SnoBotics981/CAD-MfgResources/VexRobotics/217-4018-STEP-20140806/217-4018-STEP-20140806.STEP

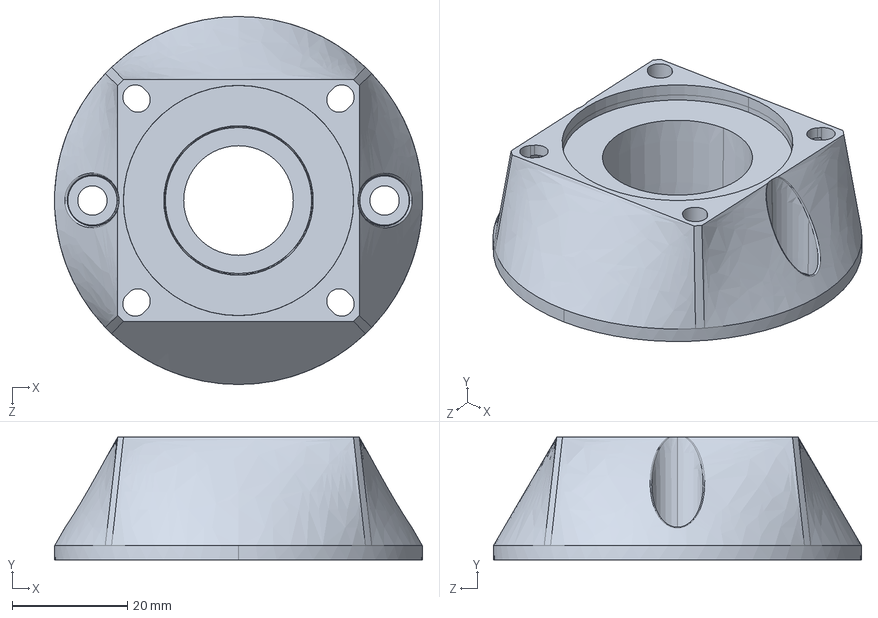
[picture p138: CAD file, 2015-07-15]
VexRobotics/217-4018-STEP-20140806/217-4018-STEP-20140806.STEP
64.0 x 21.4 x 64.0 mm
