SnoBotics981/CAD-MfgResources/VexRobotics/Bevel Gearbox Bracket PN 275-1189/VL-BEVEL-BRK-20150422.STEP

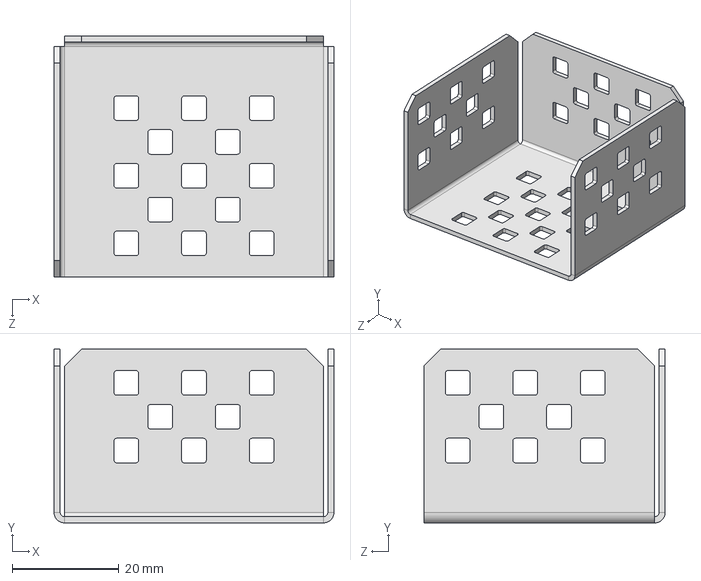
[picture p139: CAD file, 2015-07-15]
VexRobotics/Bevel Gearbox Bracket PN 275-1189/VL-BEVEL-BRK-20150422.STEP
52.6 x 32.6 x 45.3 mm
