SnoBotics981/CAD-MfgResources/VexRobotics/Collars/1_2_Hex/217-4106-STEP-20140806.STEP

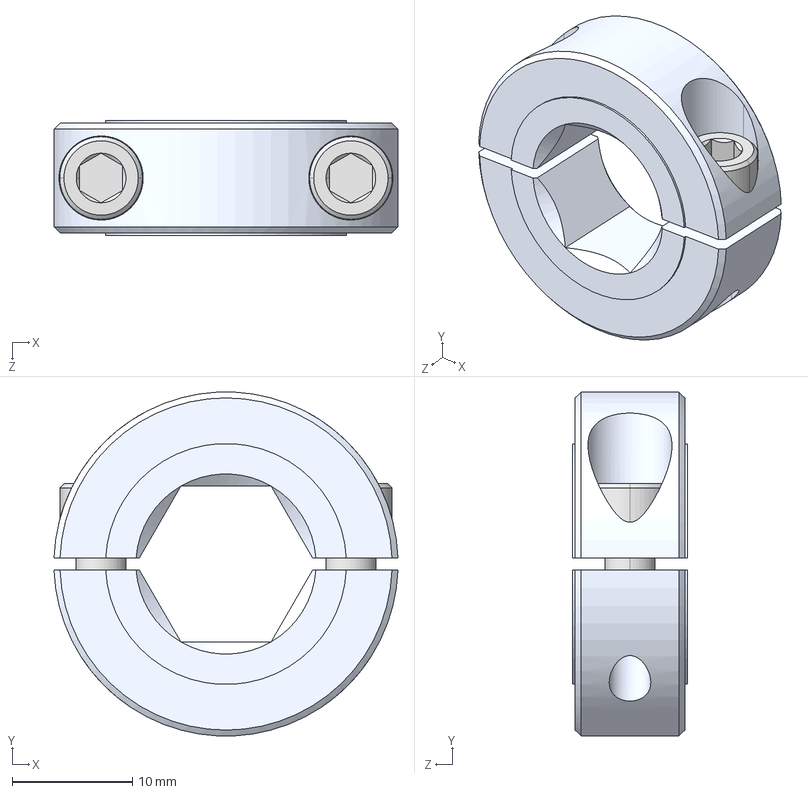
[picture p140: CAD file, 2018-06-25]
VexRobotics/Collars/1_2_Hex/217-4106-STEP-20140806.STEP
28.6 x 28.5 x 9.53 mm
217-4106-002 Rev2
217-4106-001 Rev2
217-4106-003 Rev2_90128A192 x 2
