SnoBotics981/CAD-MfgResources/VexRobotics/Hubs/217-2590-STEP-20140805.STEP

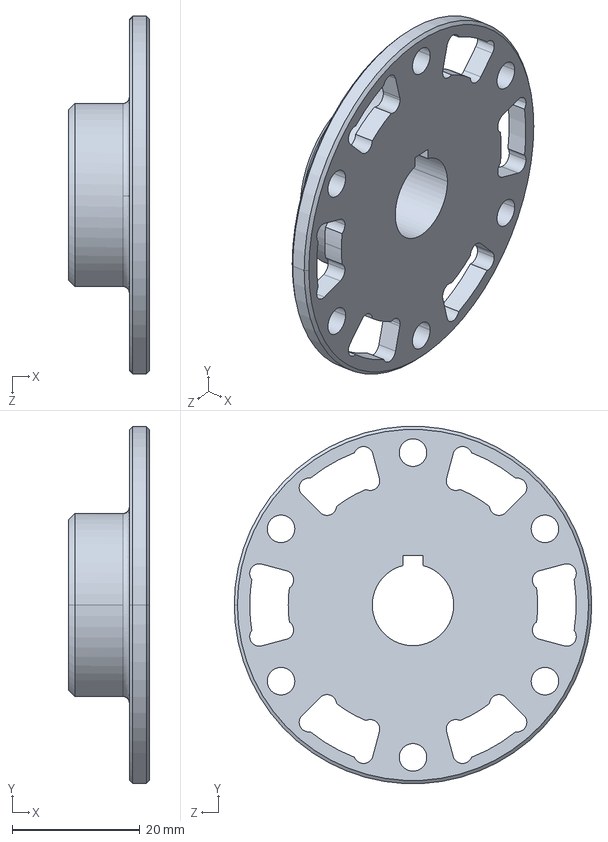
[picture p141: CAD file, 2015-07-15]
VexRobotics/Hubs/217-2590-STEP-20140805.STEP
12.7 x 55.8 x 55.9 mm
