SnoBotics981/CAD-MfgResources/VexRobotics/MOTION-MODEL-PACK/RUBBER-LINK.STEP

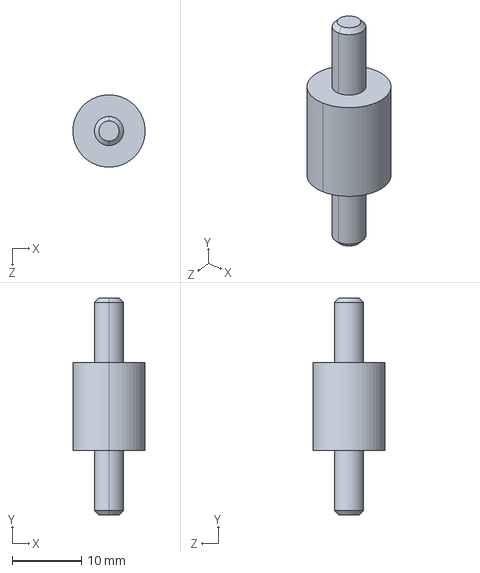
[picture p142: CAD file, 2015-07-15]
VexRobotics/MOTION-MODEL-PACK/RUBBER-LINK.STEP
10.4 x 31.2 x 10.4 mm
