SnoBotics981/CAD-MfgResources/VexRobotics/Motors/MiniCim/Mini_CIM_Motor_217-3371.STEP

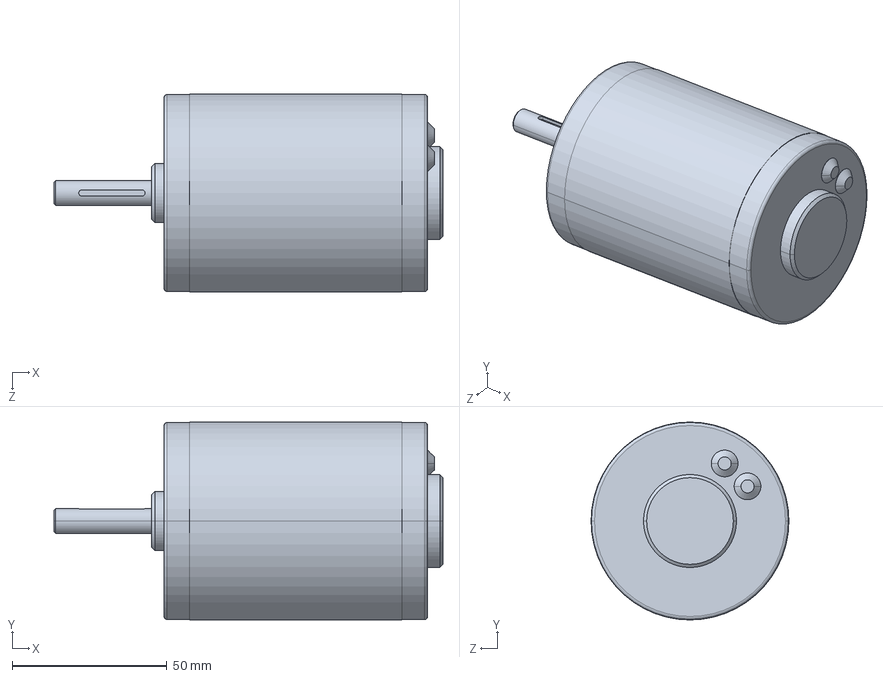
[picture p143: CAD file, 2015-07-15]
VexRobotics/Motors/MiniCim/Mini_CIM_Motor_217-3371.STEP
125.8 x 64.0 x 64.0 mm
