SnoBotics981/CAD-MfgResources/VexRobotics/PLATE-5-25-STEP-08282007/VL-PLATE-5-25 RevA.STEP

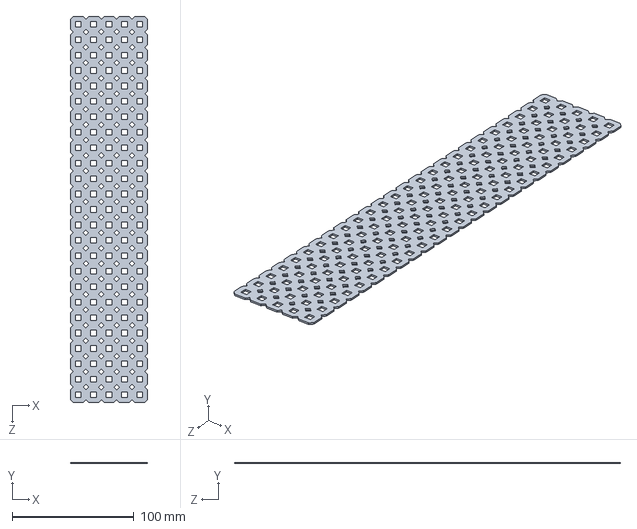
[picture p144: CAD file, 2018-06-25]
VexRobotics/PLATE-5-25-STEP-08282007/VL-PLATE-5-25 RevA.STEP
63.5 x 1.17 x 317.5 mm
