SnoBotics981/CAD-MfgResources/Andy-Mark/2020 Kit Bot/am-14U4_FO AM14U4 Frame Only.STEP

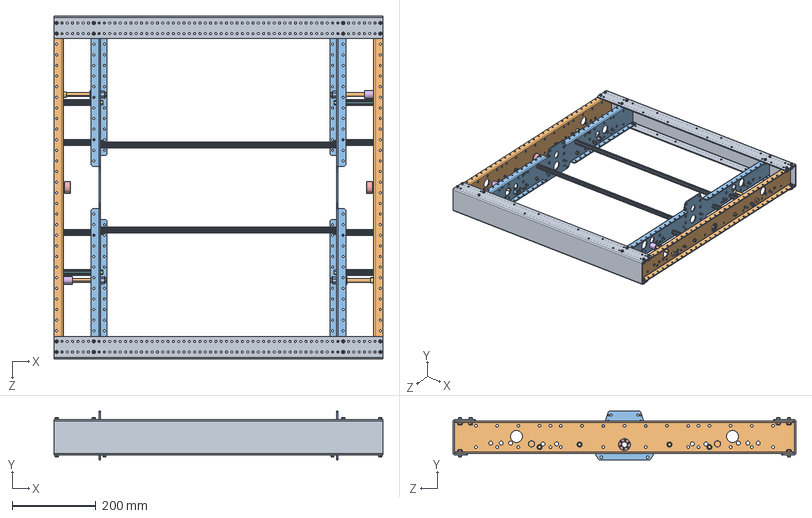
[picture p146: CAD file, 2020-01-10]
Andy-Mark/2020 Kit Bot/am-14U4_FO AM14U4 Frame Only.STEP
787.4 x 116.3 x 820.7 mm
am-xxxx AM14U4 End Plate x 2
am-3921 AM14U4 Outside Plate x 2
am-3922 AM14U4 Inside Plate x 2
10-32x0500_shcs_HX-SHCS 0.19-32x1.375x1-C x 24
10-32 Nylock Nut 1_90631A411 x 24
FHTS 0.25-20-0.75_FHTS 0.25-20-G-0.75-C x 20
3.375in Churro x 8
22.25in Churro x 2
375-16 x 4.25 Hex Bolt_HFBOLT 0.375-16x2.5x1-C x 4
3-8-16 NyLock Nut - Mcm 95615A140_95615A140 x 4
am-1305 500 Hex Spacer x 2
am-1307 850 long 380 id x 4
am-1306 spacer 0280 WashersUSA 13RS052001 x 4
