SnoBotics981/CAD-MfgResources/Andy-Mark/GearBox/CIM-Sport/am-3786+CIM+Mount+Side+Mount.STEP

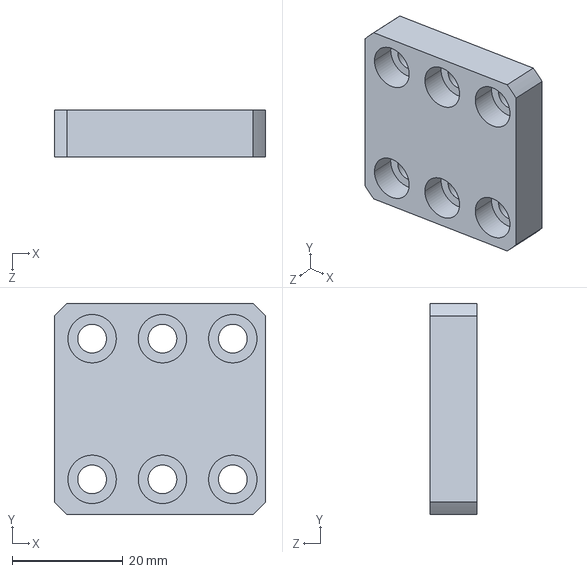
[picture p147: CAD file, 2018-08-28]
Andy-Mark/GearBox/CIM-Sport/am-3786+CIM+Mount+Side+Mount.STEP
38.1 x 38.1 x 8.41 mm
