SnoBotics981/CAD-MfgResources/Andy-Mark/GearBox/ToughBoxMini/am-0153a Toughbox® Series, Keyed Output Shaft with Magnet.STEP

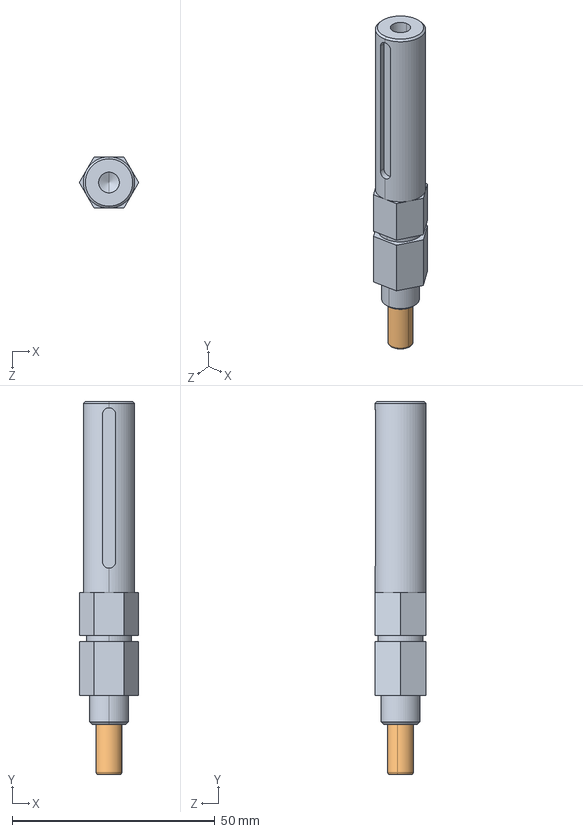
[picture p148: CAD file, 2020-01-26]
Andy-Mark/GearBox/ToughBoxMini/am-0153a Toughbox® Series, Keyed Output Shaft with Magnet.STEP
14.7 x 92.0 x 12.7 mm
am-0153a TB Output Shaft with Magnet
250x1000_dowel
