SnoBotics981/CAD-MfgResources/Andy-Mark/Hubs/am-0985a 10mm key hub.STEP

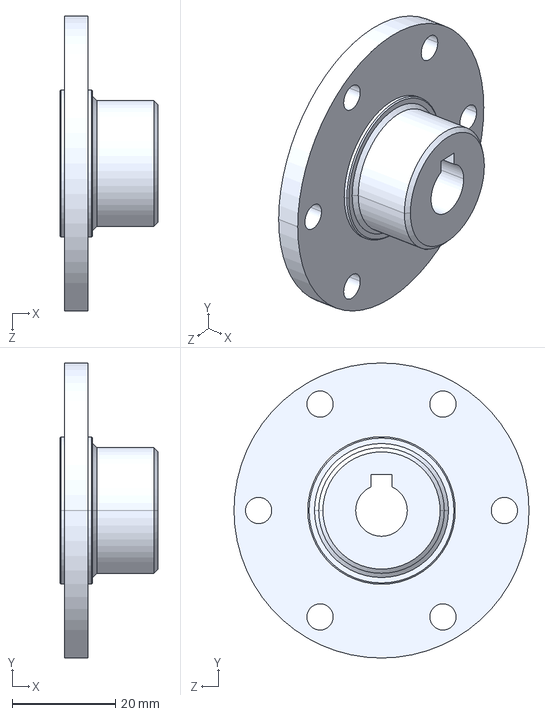
[picture p149: CAD file, 2015-07-15]
Andy-Mark/Hubs/am-0985a 10mm key hub.STEP
19.1 x 57.2 x 57.2 mm
