SnoBotics981/CAD-MfgResources/Andy-Mark/MotorMounts/am-2373 Snow Blower Motor Mount.STEP

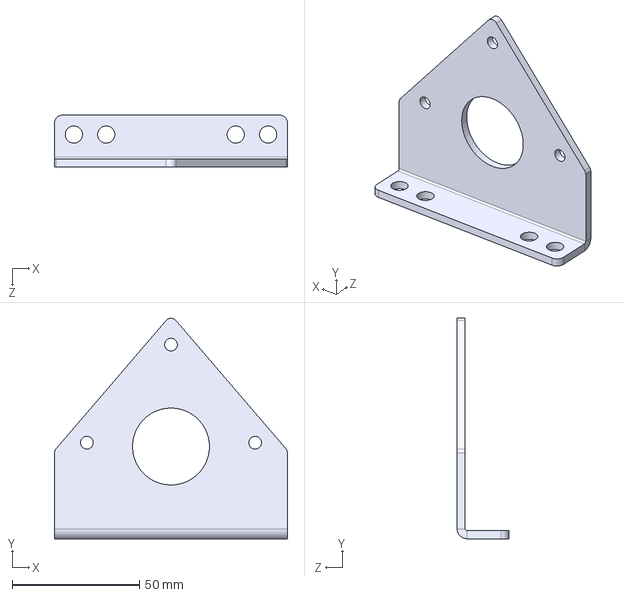
[picture p150: CAD file, 2020-01-07]
Andy-Mark/MotorMounts/am-2373 Snow Blower Motor Mount.STEP
91.4 x 86.5 x 20.3 mm
