SnoBotics981/CAD-MfgResources/Andy-Mark/Motors/SnowBlowerMotor/AM-2235.STEP

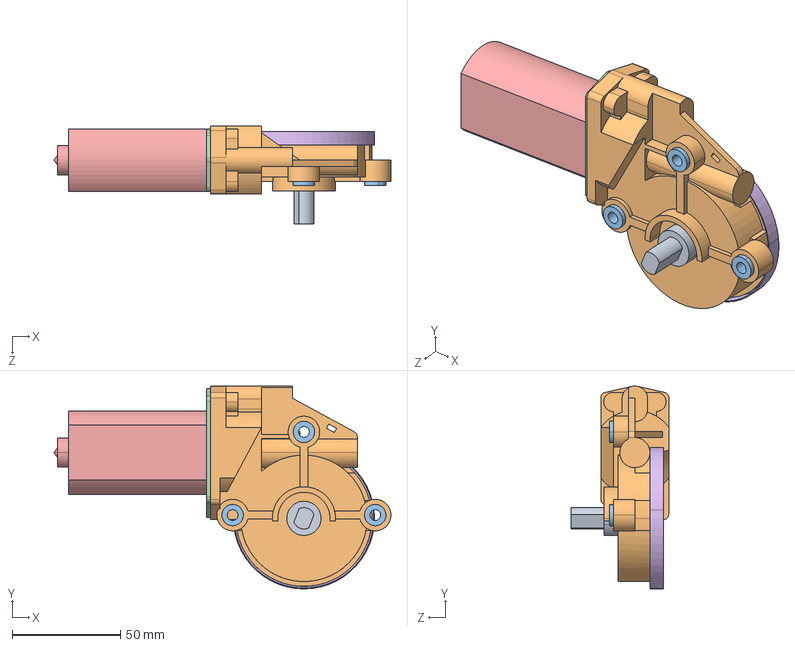
[picture p151: CAD file, 2018-06-26]
Andy-Mark/Motors/SnowBlowerMotor/AM-2235.STEP
156.0 x 93.9 x 45.2 mm
AM-2235 output shaft
AM-2235 gearbox housing
AM-2235 threaded insert x 3
AM-2235 motor
AM-2235 gear cap
