SnoBotics981/CAD-MfgResources/Andy-Mark/PG71BracketAM-2197.STEP

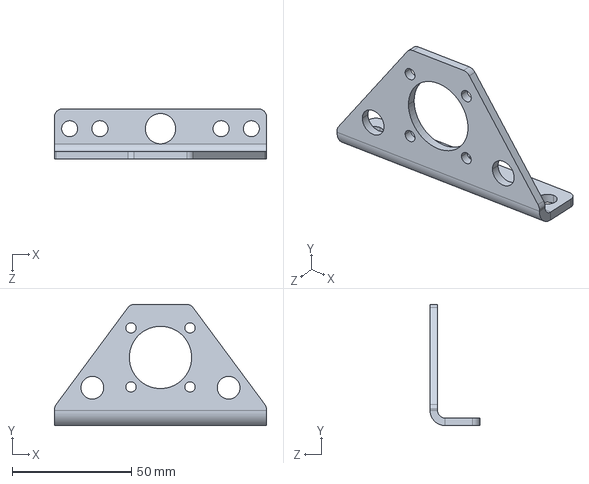
[picture p152: CAD file, 2015-07-15]
Andy-Mark/PG71BracketAM-2197.STEP
88.9 x 50.8 x 21.0 mm
