SnoBotics981/CAD-MfgResources/Andy-Mark/Pixy Camera/Thingiverse-820353-Case/Pixy_Case.stl

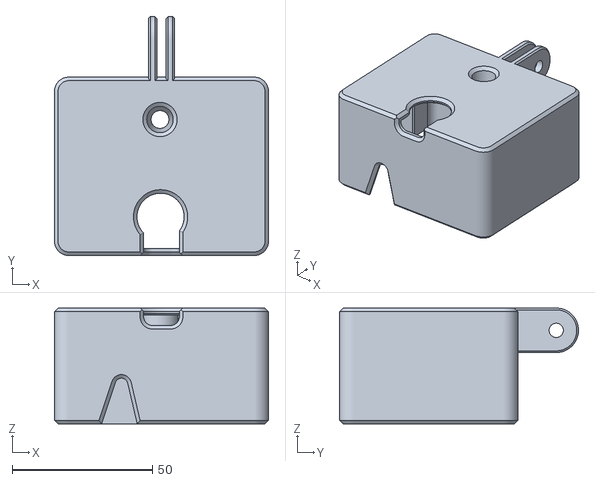
[picture p153: CAD file, 2018-06-26]
Andy-Mark/Pixy Camera/Thingiverse-820353-Case/Pixy_Case.stl
76.2 x 85.1 x 41.3
