SnoBotics981/CAD-MfgResources/Andy-Mark/RatchetingGearbox/Ri3D1.0_WinchGearbox_Rev2.stp

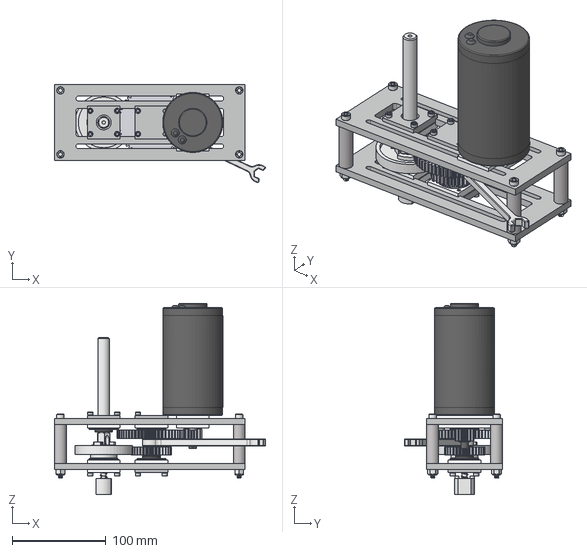
[picture p154: CAD file, 2018-06-26]
Andy-Mark/RatchetingGearbox/Ri3D1.0_WinchGearbox_Rev2.stp
224.8 x 104.5 x 204.0 mm
