SnoBotics981/CAD-MfgResources/Andy-Mark/Wheels/4 in Diameter/4 in HiGrip Wheel.STEP

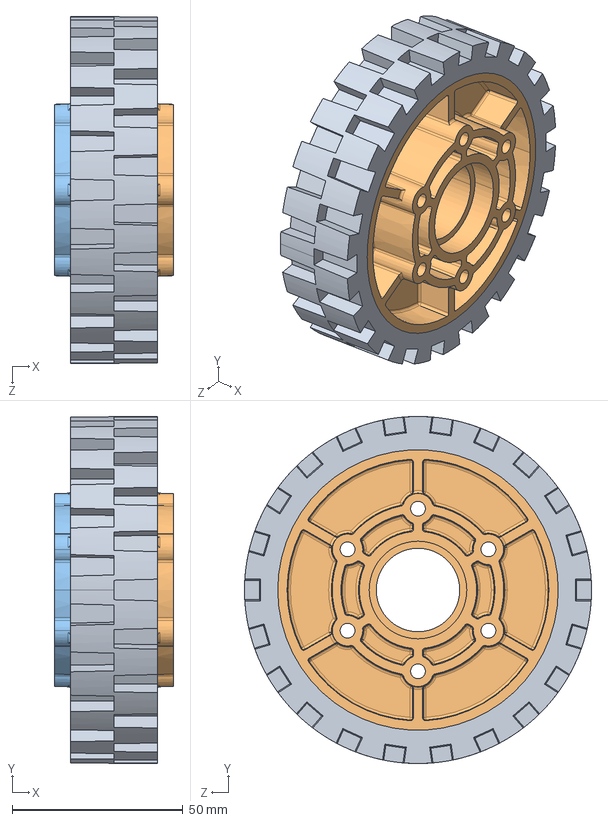
[picture p155: CAD file, 2018-06-26]
Andy-Mark/Wheels/4 in Diameter/4 in HiGrip Wheel.STEP
34.9 x 101.6 x 101.6 mm
4 in tread
4in 2013 Hub
