SnoBotics981/CAD-MfgResources/BostonGear/wormAndWormGear/g1036.stp

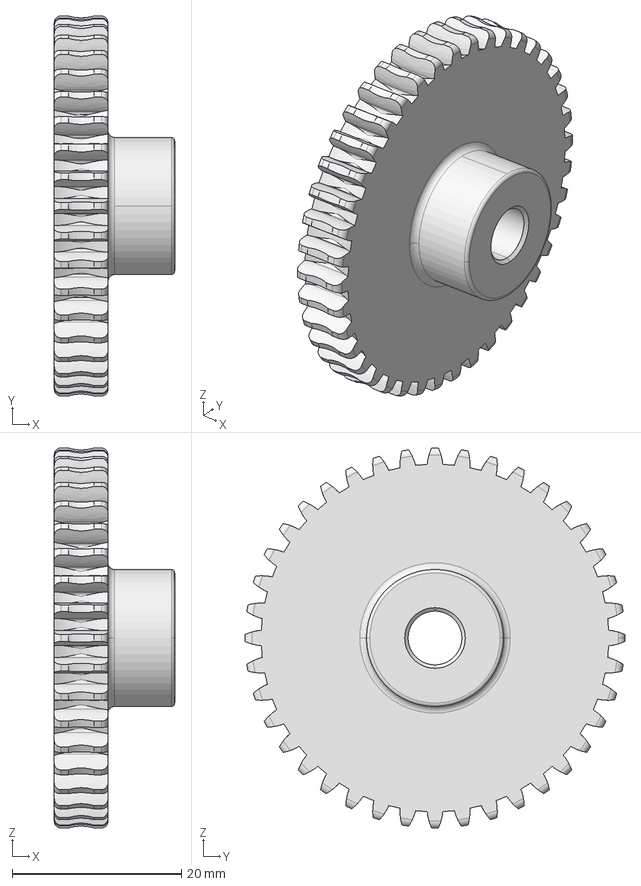
[picture p156: CAD file, 2015-07-15]
BostonGear/wormAndWormGear/g1036.stp
14.2 x 44.9 x 44.9 mm
