SnoBotics981/CAD-MfgResources/RevRobotics/cadParts/REV-29-1016.STEP

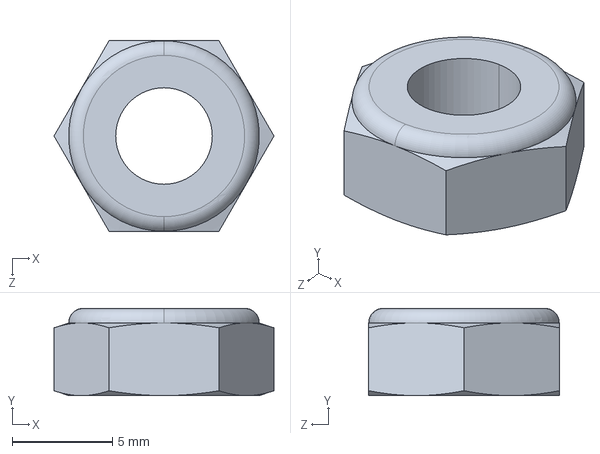
[picture p157: CAD file, 2019-02-25]
RevRobotics/cadParts/REV-29-1016.STEP
11.0 x 4.37 x 9.52 mm
