SnoBotics981/CAD-MfgResources/RevRobotics/LiftMechanism/3DPrintableLiftAccessories/StringRunner.STEP

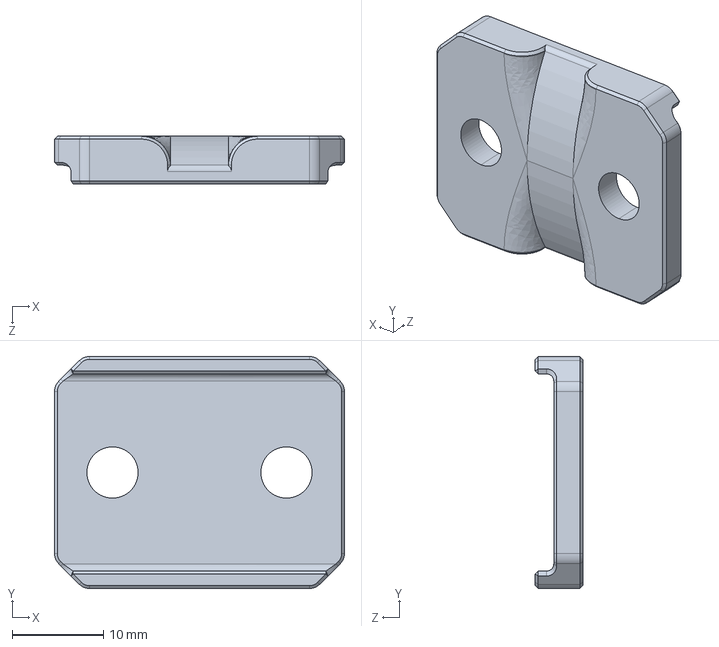
[picture p158: CAD file, 2018-06-25]
RevRobotics/LiftMechanism/3DPrintableLiftAccessories/StringRunner.STEP
31.8 x 25.4 x 5.21 mm
