SnoBotics981/CAD-MfgResources/RevRobotics/LiftMechanism/REV-25-1238.STEP

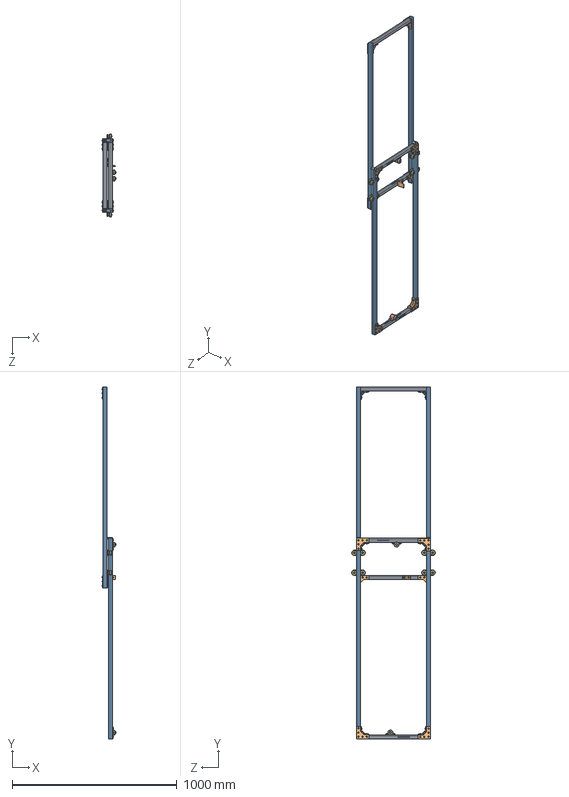
[picture p159: CAD file, 2018-06-25]
RevRobotics/LiftMechanism/REV-25-1238.STEP
83.2 x 2136.8 x 507.8 mm
REV-21-1000 Cross member x 4
REV-21-1002 x 10
10-32 0.375 inch Long x 50
10-32 Slim Nylock Nut x 140
REV-21-1031 x 2
93985A309_TYPE 416 SS TIGHT-TOLERANCE SHOULDER SCREW_93985A309 x 2
REV-29-1014 x 10
Steel Split Lock Washer 0.375 inch Size x 4
10-32 0.5 inch Long x 30
REV-21-1203 x 7
REV-21-1000 x 4
REV-21-1032 x 4
REV-21-1029 x 4
REV-21-1030 x 4
socket button head cap screw_ai_SBHCSCREW 0.25-20x1.125-HX-N x 8
#10-32 0.5 Inch Flat-head Socket Cap Screw x 10
REV-21-1202-2 x 2
