SnoBotics981/CAD-MfgResources/ThingiVerse/Customizable_Smooth_One_Two_Ended_Measuring_Spoon/1tbsp_1tsp_us_flat.stl

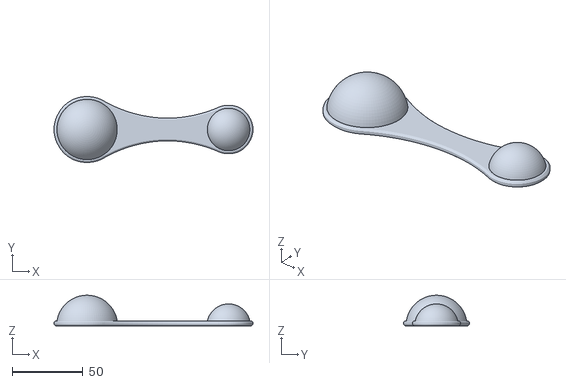
[picture p160: CAD file, 2018-07-29]
ThingiVerse/Customizable_Smooth_One_Two_Ended_Measuring_Spoon/1tbsp_1tsp_us_flat.stl
140.6 x 46.4 x 21.6
