SnoBotics981/CAD-MfgResources/ThingiVerse/Customized Containers/files/Lid60_double_knurled.stl

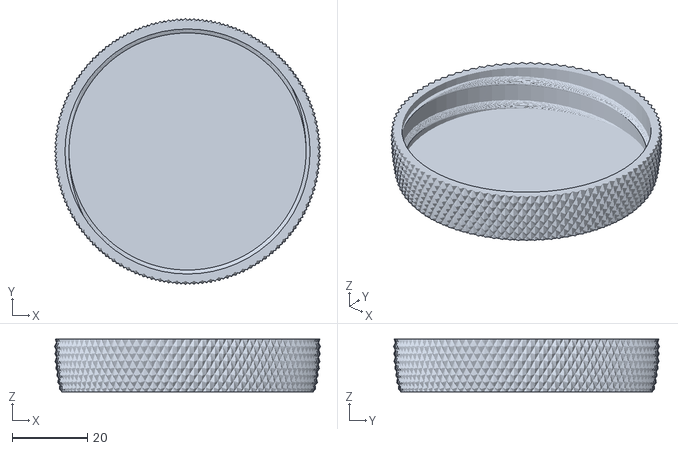
[picture p161: CAD file, 2019-01-23]
ThingiVerse/Customized Containers/files/Lid60_double_knurled.stl
70.6 x 70.6 x 14.0
