SnoBotics981/CAD-MfgResources/ThingiVerse/FIRST RobotRio Mounting Bracket/files/Robo_Rio_L_Cable_Alignment.stl

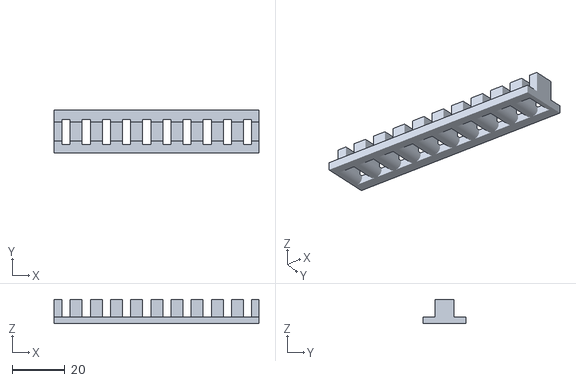
[picture p162: CAD file, 2018-06-25]
ThingiVerse/FIRST RobotRio Mounting Bracket/files/Robo_Rio_L_Cable_Alignment.stl
77.5 x 16.2 x 9.14
