SnoBotics981/CAD-MfgResources/ThingiVerse/Grinder-double_gear-V2.0/files/09_tirroir_v2.stl

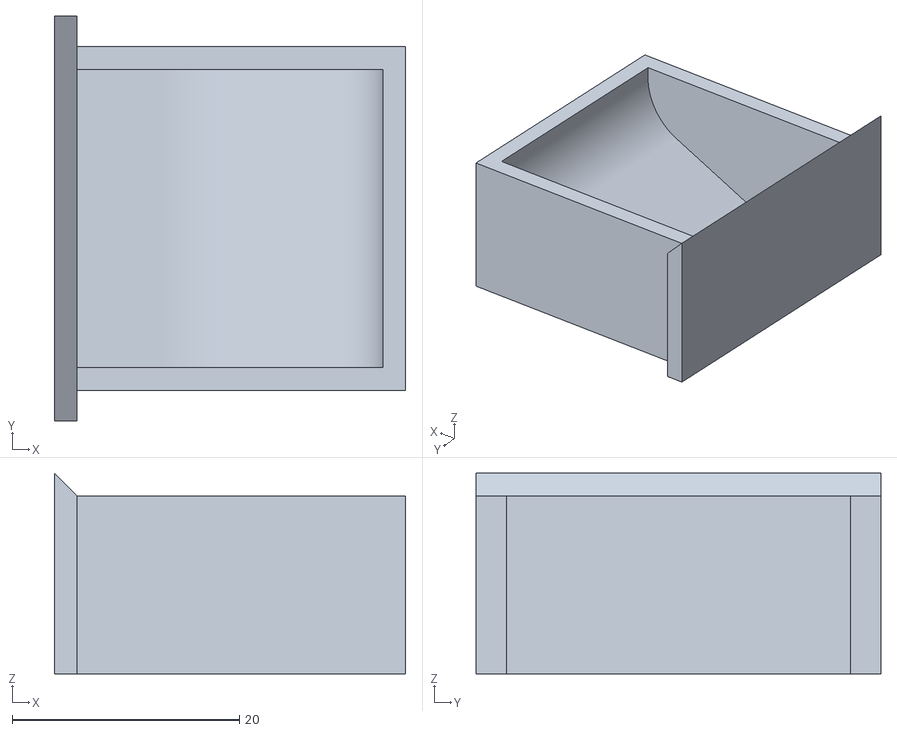
[picture p163: CAD file, 2018-08-04]
ThingiVerse/Grinder-double_gear-V2.0/files/09_tirroir_v2.stl
30.9 x 35.6 x 17.7
