SnoBotics981/CAD-MfgResources/ThingiVerse/Meade_motorized_focus_system-3557659/files/Meade-mount_plate_Spaced.stl

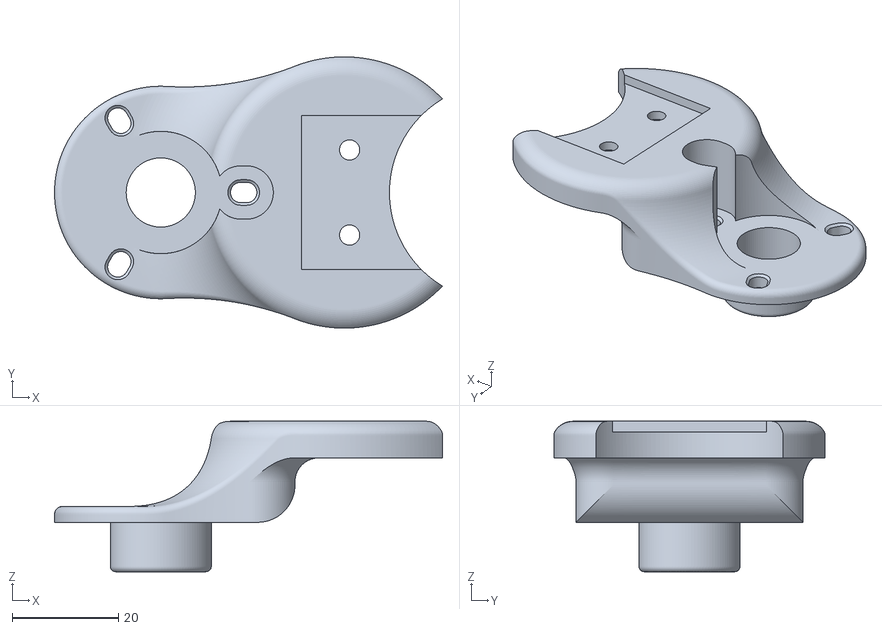
[picture p164: CAD file, 2019-07-18]
ThingiVerse/Meade_motorized_focus_system-3557659/files/Meade-mount_plate_Spaced.stl
72.9 x 51.0 x 28.3
