SnoBotics981/CAD-MfgResources/ThingiVerse/Measuring_Cup/us_2_fl_oz.stl

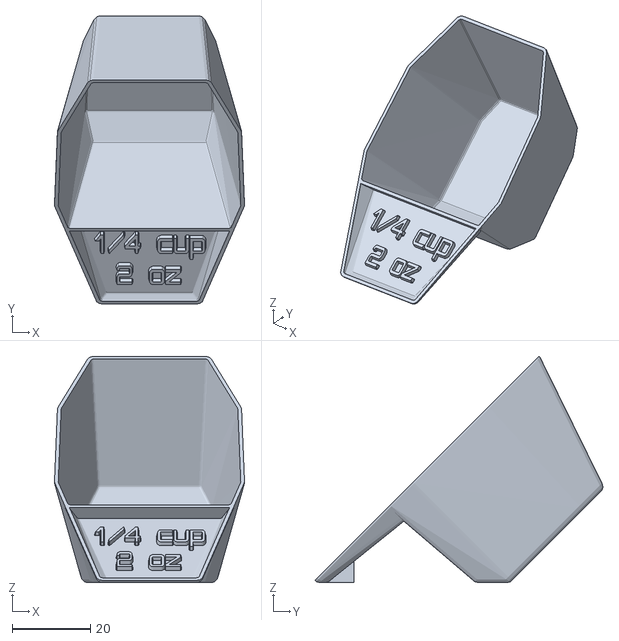
[picture p165: CAD file, 2018-07-29]
ThingiVerse/Measuring_Cup/us_2_fl_oz.stl
48.7 x 73.8 x 58.0
