SnoBotics981/CAD-MfgResources/ThingiVerse/Parametric_Measuring_Spoon/MeasSpoon_7tsp_150_handle.stl

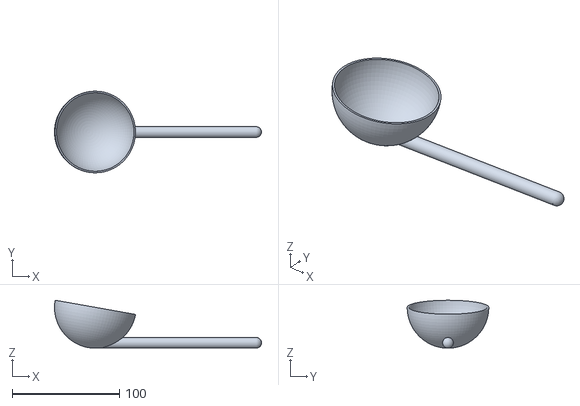
[picture p166: CAD file, 2022-03-09]
ThingiVerse/Parametric_Measuring_Spoon/MeasSpoon_7tsp_150_handle.stl
193.0 x 76.1 x 44.3
