SnoBotics981/CAD-MfgResources/ThingiVerse/Raspberry_Pi_Camera_Module_v2.1_Model/files/RPi_Camera_Module_v2.igs

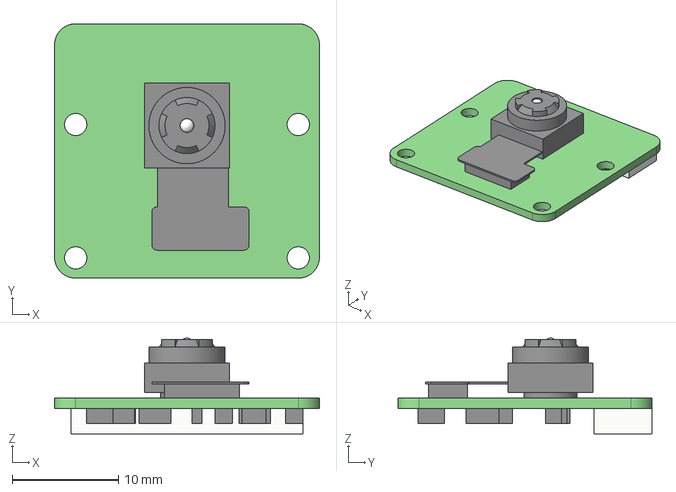
[picture p167: CAD file, 2019-01-23]
ThingiVerse/Raspberry_Pi_Camera_Module_v2.1_Model/files/RPi_Camera_Module_v2.igs
25.0 x 24.0 x 9.05 mm
