SnoBotics981/CAD-MfgResources/ThingiVerse/Raspberry_Pi_Camera_V2.1_Lens_Adjustment_Spanner/files/RPi_Camera_Lens_Socket_wrench.6.stl

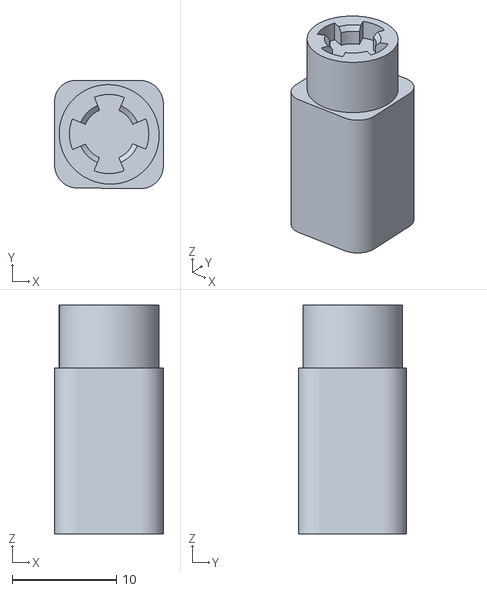
[picture p169: CAD file, 2018-12-05]
ThingiVerse/Raspberry_Pi_Camera_V2.1_Lens_Adjustment_Spanner/files/RPi_Camera_Lens_Socket_wrench.6.stl
10.4 x 10.4 x 22.0
