SnoBotics981/CAD-MfgResources/ThingiVerse/RoboRio/files/Robo_Rio_S_Cable_Alignment.stl

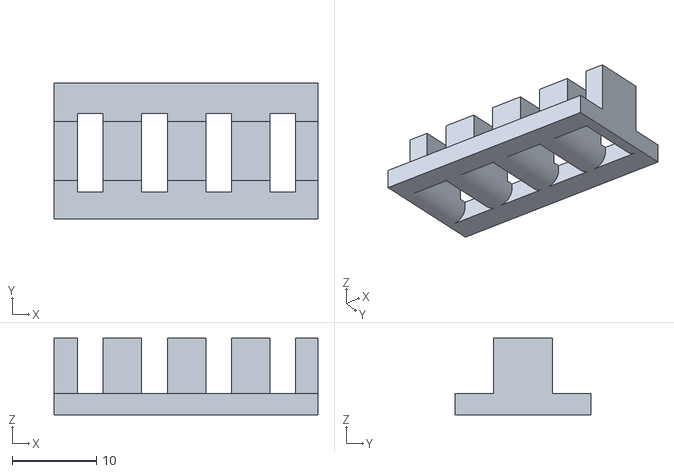
[picture p170: CAD file, 2018-06-25]
ThingiVerse/RoboRio/files/Robo_Rio_S_Cable_Alignment.stl
31.4 x 16.2 x 9.14
