SnoBotics981/CAD-MfgResources/ThingiVerse/Soldering_Iron_Stand_-_DotScott1_Remix-2088796/files/Soldering_Iron_Stand_NoSupport.STL

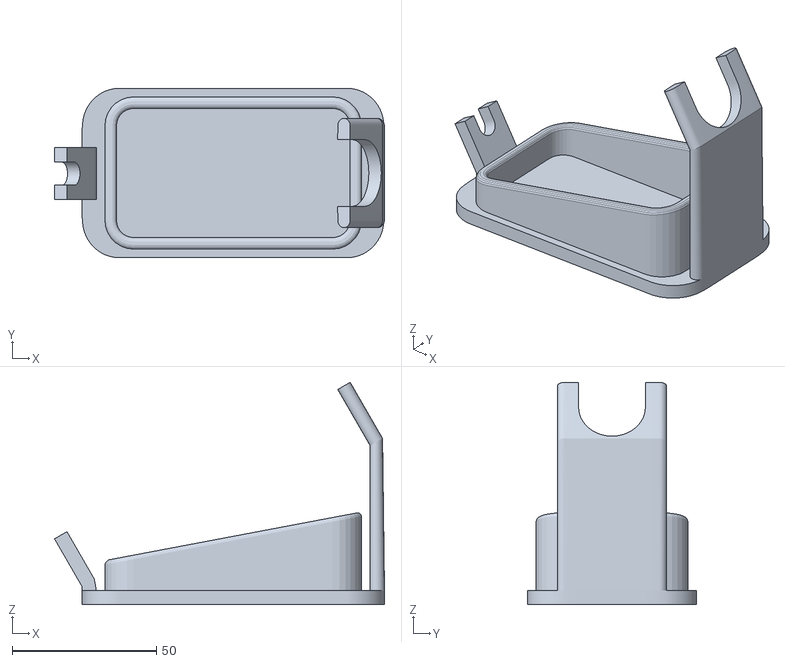
[picture p171: CAD file, 2019-02-17]
ThingiVerse/Soldering_Iron_Stand_-_DotScott1_Remix-2088796/files/Soldering_Iron_Stand_NoSupport.STL
114.5 x 58.8 x 77.2
