SnoBotics981/CAD-MfgResources/VexRobotics/Collars/1_2_Hex/217-2737.20121205.STEP

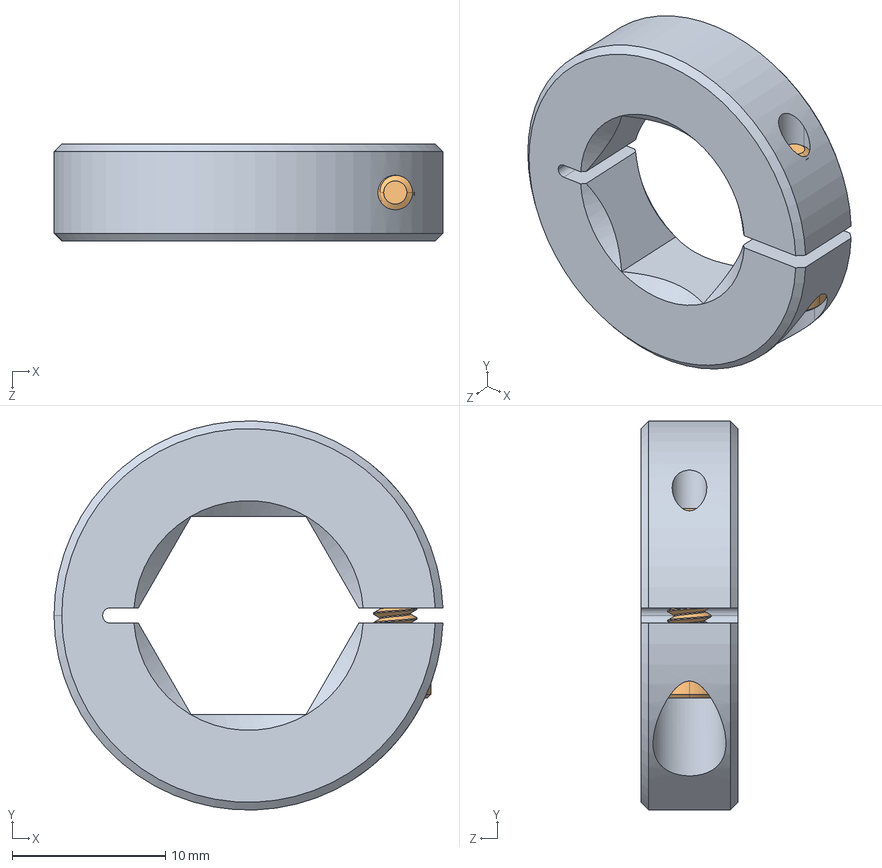
[picture p172: CAD file, 2018-06-25]
VexRobotics/Collars/1_2_Hex/217-2737.20121205.STEP
25.4 x 25.4 x 6.35 mm
