SnoBotics981/CAD-MfgResources/VexRobotics/MOTION-MODEL-PACK/SHAFT-4000.STEP

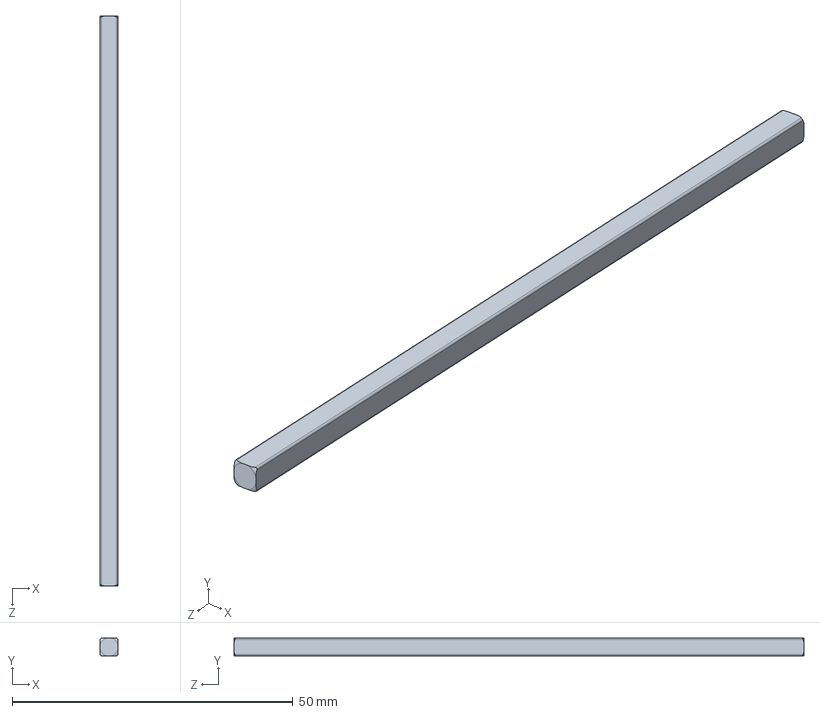
[picture p173: CAD file, 2015-07-15]
VexRobotics/MOTION-MODEL-PACK/SHAFT-4000.STEP
3.18 x 3.18 x 101.6 mm
