SnoBotics981/CAD-MfgResources/VexRobotics/VEX-EDR-High-Strength-Gear-Inserts-STEP/VEX-EDR-High-Strength-Gear-Inserts-STEP/square-insert.STEP

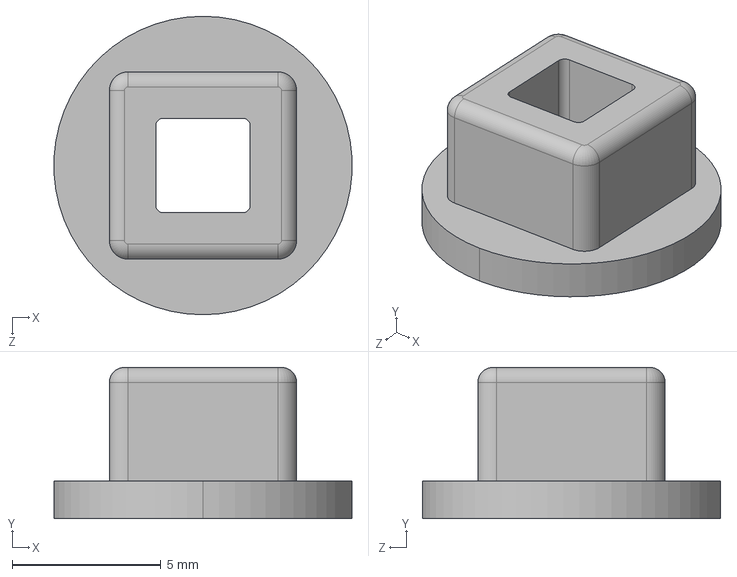
[picture p174: CAD file, 2015-07-15]
VexRobotics/VEX-EDR-High-Strength-Gear-Inserts-STEP/VEX-EDR-High-Strength-Gear-Inserts-STEP/square-insert.STEP
10.0 x 5.08 x 10.0 mm
