SnoBotics981/CAD-MfgResources/Andy-Mark/2020 Kit Bot/am-3975 AM14U4 Cross Plate XL.STEP

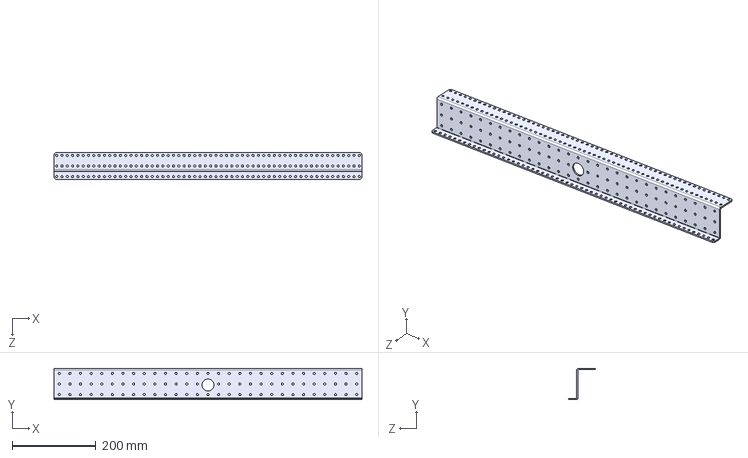
[picture p175: CAD file, 2020-01-10]
Andy-Mark/2020 Kit Bot/am-3975 AM14U4 Cross Plate XL.STEP
736.6 x 74.5 x 63.5 mm
