SnoBotics981/CAD-MfgResources/Andy-Mark/Ball Intake Systems/Ball Intake System AM-3312/am-3155+2in+Wheel+Intergrated+500+HEX.STEP

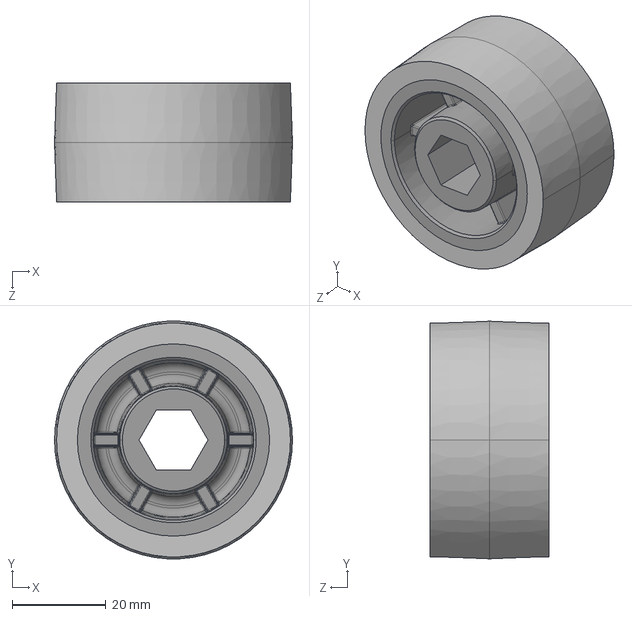
[picture p177: CAD file, 2018-06-26]
Andy-Mark/Ball Intake Systems/Ball Intake System AM-3312/am-3155+2in+Wheel+Intergrated+500+HEX.STEP
50.8 x 50.7 x 25.4 mm
2in Wheel Intergrated 0500 HEX Hub
2in Tread
