SnoBotics981/CAD-MfgResources/Andy-Mark/GearBox/ToughBoxMini/Toughbox-d28.stp

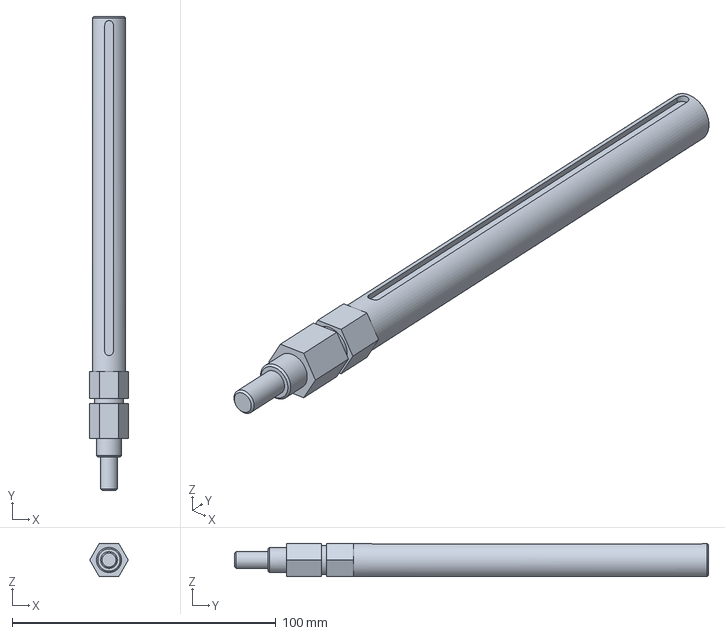
[picture p178: CAD file, 2018-06-26]
Andy-Mark/GearBox/ToughBoxMini/Toughbox-d28.stp
14.7 x 179.8 x 12.7 mm
