SnoBotics981/CAD-MfgResources/Andy-Mark/Hubs/am-0215a 250_hub.STEP

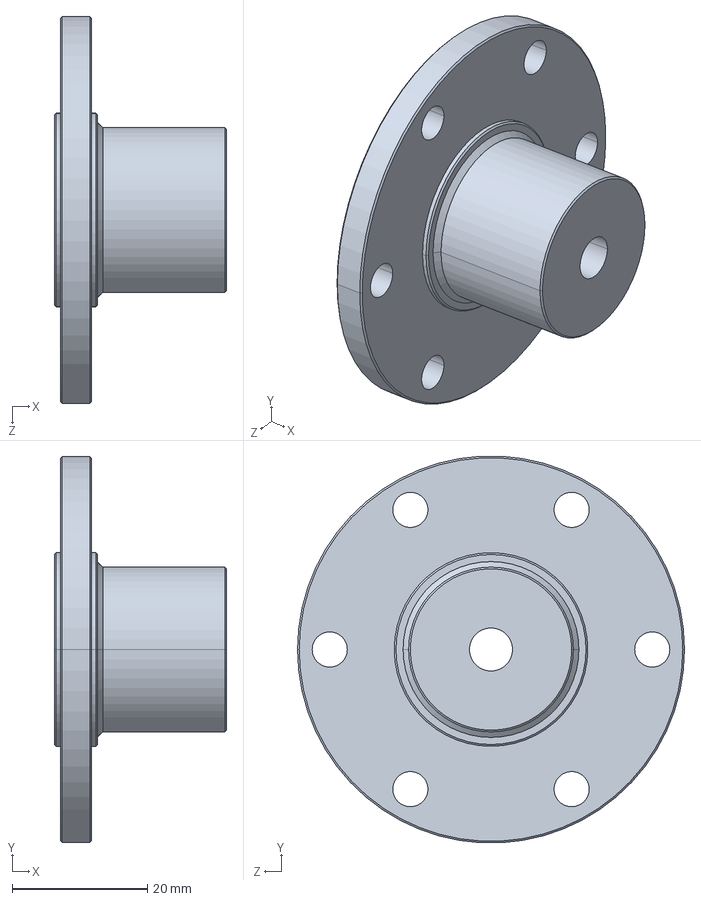
[picture p179: CAD file, 2015-07-15]
Andy-Mark/Hubs/am-0215a 250_hub.STEP
25.4 x 57.1 x 57.2 mm
