SnoBotics981/CAD-MfgResources/Andy-Mark/MotorMounts/am-3029+REV+-+PG+Motor+Bracket.STEP

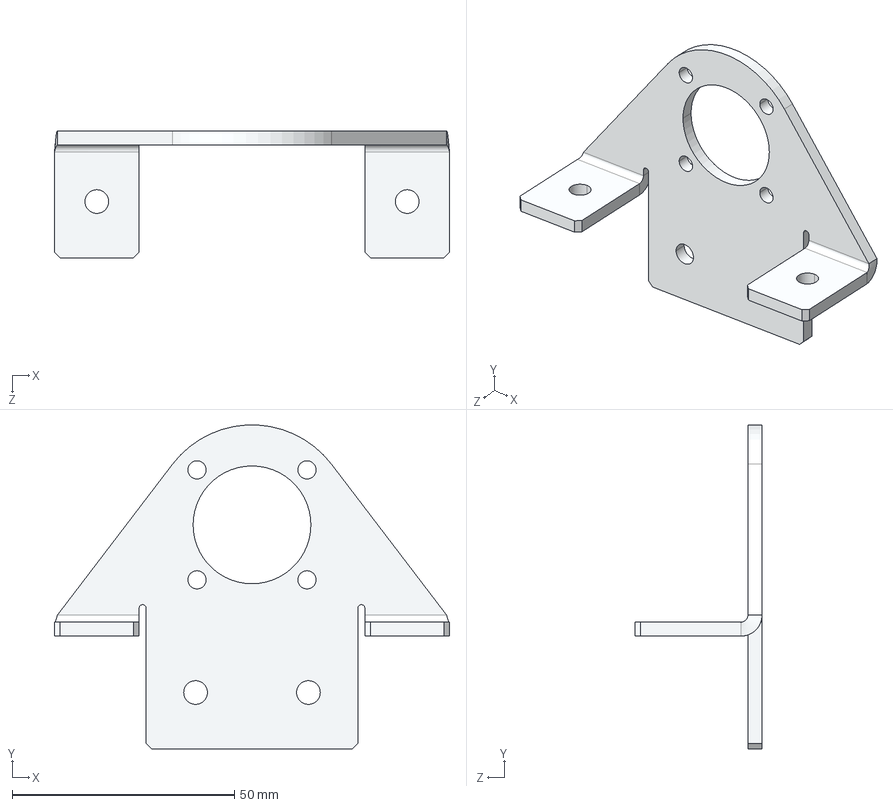
[picture p180: CAD file, 2018-06-26]
Andy-Mark/MotorMounts/am-3029+REV+-+PG+Motor+Bracket.STEP
88.9 x 72.9 x 28.6 mm
