SnoBotics981/CAD-MfgResources/Andy-Mark/Motors/SnowBlowerMotor/am-2279+10mm+DD+Bore+Hub.STEP

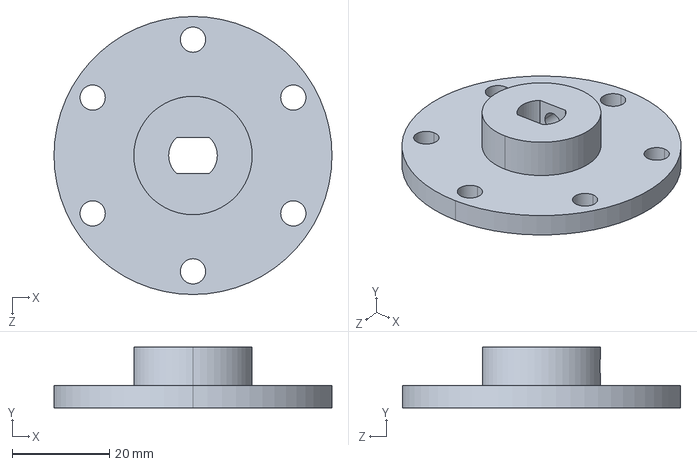
[picture p181: CAD file, 2018-06-26]
Andy-Mark/Motors/SnowBlowerMotor/am-2279+10mm+DD+Bore+Hub.STEP
57.1 x 12.4 x 57.1 mm
