SnoBotics981/CAD-MfgResources/Andy-Mark/Pixy Camera/Thingiverse-820353-Case/Pixy_Case_Spec_Clevis_Support_Feature.stl

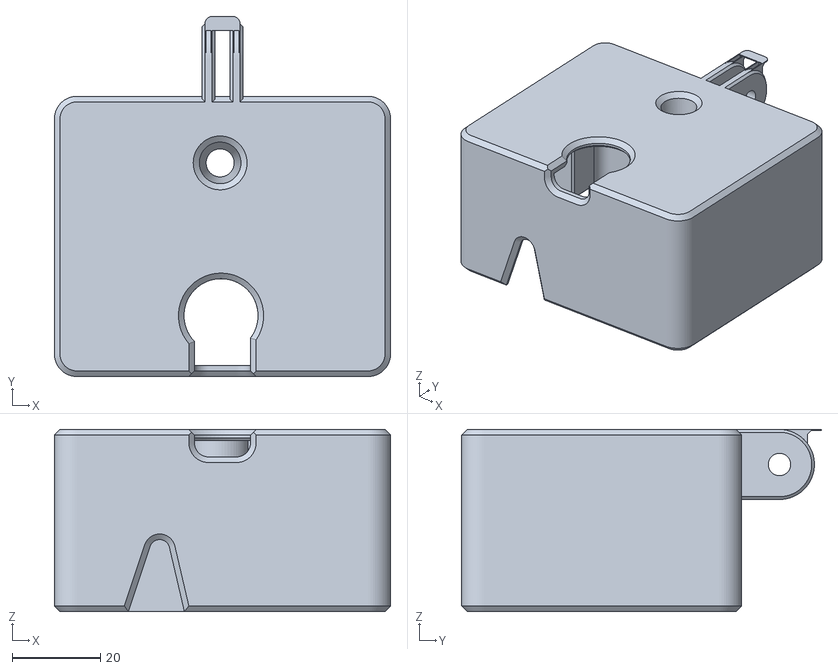
[picture p182: CAD file, 2018-06-26]
Andy-Mark/Pixy Camera/Thingiverse-820353-Case/Pixy_Case_Spec_Clevis_Support_Feature.stl
76.2 x 81.6 x 41.3
