SnoBotics981/CAD-MfgResources/RevRobotics/cadParts/REV-21-1000.STEP

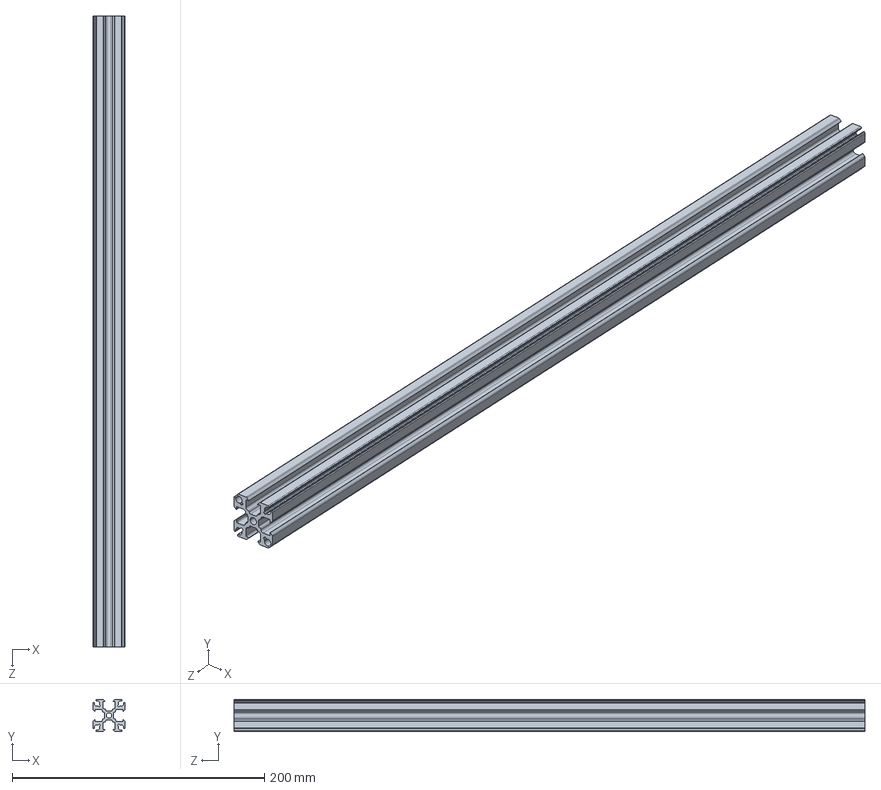
[picture p183: CAD file, 2019-02-25]
RevRobotics/cadParts/REV-21-1000.STEP
25.4 x 25.4 x 500.0 mm
