SnoBotics981/CAD-MfgResources/RevRobotics/LiftMechanism/3DPrintableLiftAccessories/MagnetOffsetPlate.STEP

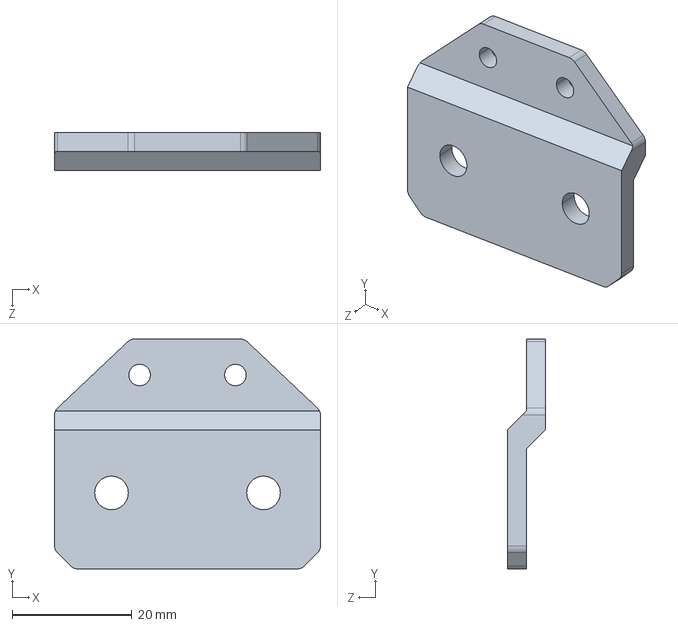
[picture p184: CAD file, 2018-06-25]
RevRobotics/LiftMechanism/3DPrintableLiftAccessories/MagnetOffsetPlate.STEP
44.5 x 38.4 x 6.35 mm
