SnoBotics981/CAD-MfgResources/RevRobotics/LiftMechanism/REV-25-1238-1239.STEP

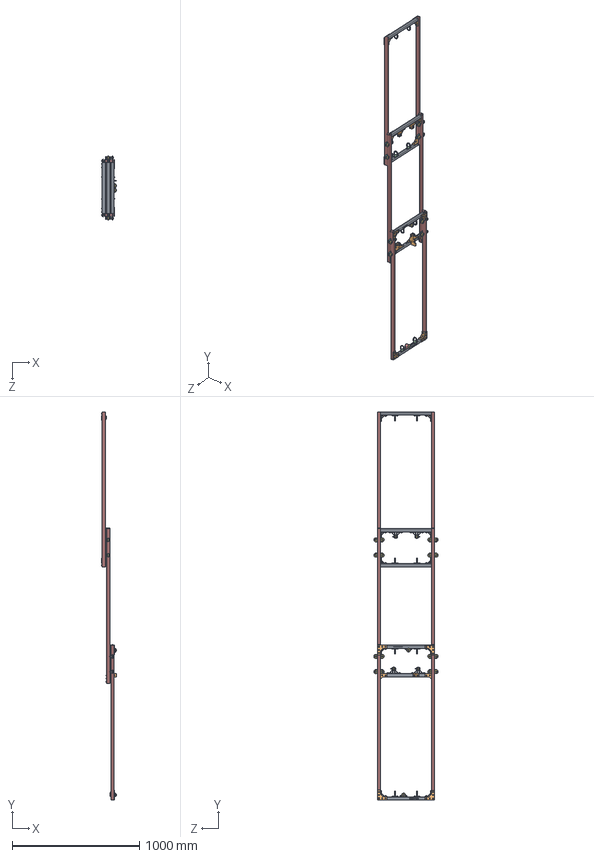
[picture p185: CAD file, 2018-06-25]
RevRobotics/LiftMechanism/REV-25-1238-1239.STEP
119.0 x 3054.8 x 507.8 mm
REV-21-1000 Cross member x 6
REV-21-1002 x 14
10-32 0.375 inch Long x 86
10-32 Slim Nylock Nut x 220
REV-21-1031 x 2
93985A309_TYPE 416 SS TIGHT-TOLERANCE SHOULDER SCREW_93985A309 x 2
REV-29-1014 x 22
Steel Split Lock Washer 0.375 inch Size x 4
10-32 0.5 inch Long x 62
REV-21-1203 x 19
3076T350_TIE-DOWN RING x 8
REV-21-1000 x 6
Bearing Delrin Spacer x 4
10-32 1.5 inch Long x 4
REV-21-1032 x 8
REV-21-1029 x 8
REV-21-1030 x 8
socket button head cap screw_ai_SBHCSCREW 0.25-20x1.125-HX-N x 16
#10-32 0.5 Inch Flat-head Socket Cap Screw x 20
REV-21-1202-2 x 4
