SnoBotics981/CAD-MfgResources/ThingiVerse/Customizable_Smooth_One_Two_Ended_Measuring_Spoon/two-ended-measuring-spoon_20ml_8ml.stl

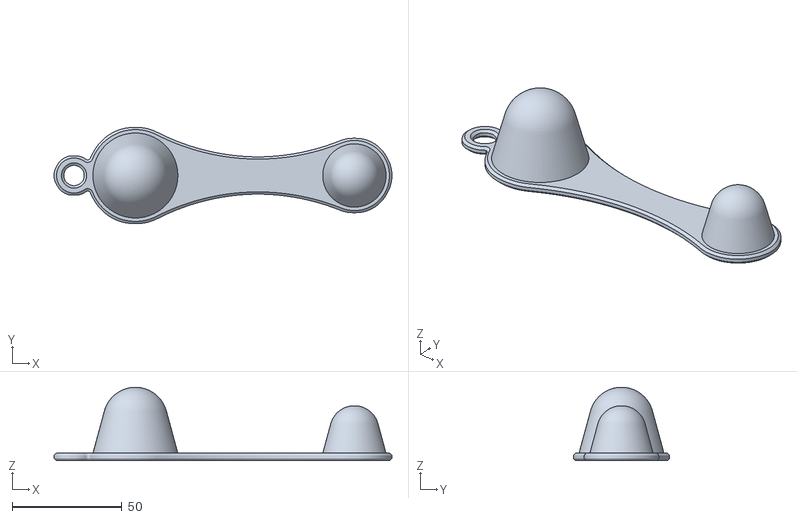
[picture p186: CAD file, 2018-07-29]
ThingiVerse/Customizable_Smooth_One_Two_Ended_Measuring_Spoon/two-ended-measuring-spoon_20ml_8ml.stl
154.3 x 43.9 x 33.5
