SnoBotics981/CAD-MfgResources/ThingiVerse/Customized Containers/files/Lid20_left_knurled.stl

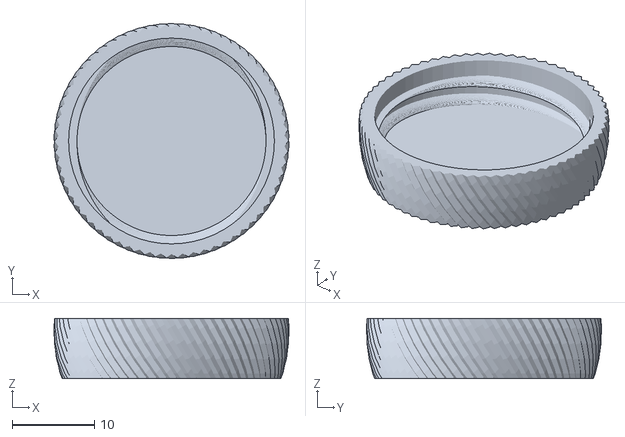
[picture p187: CAD file, 2019-01-23]
ThingiVerse/Customized Containers/files/Lid20_left_knurled.stl
28.6 x 28.6 x 7.33
