SnoBotics981/CAD-MfgResources/ThingiVerse/Grinder-double_gear-V2.0/files/05_petite_roue.stl

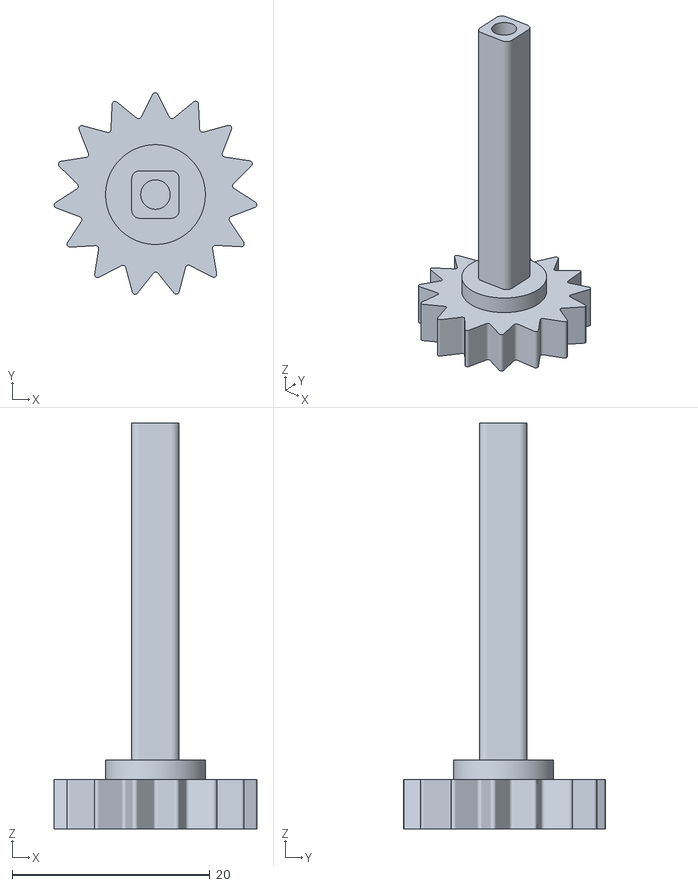
[picture p188: CAD file, 2018-08-04]
ThingiVerse/Grinder-double_gear-V2.0/files/05_petite_roue.stl
20.5 x 20.4 x 41.1
