SnoBotics981/CAD-MfgResources/ThingiVerse/Measuring_Cup/us_0.33_fl_oz.stl

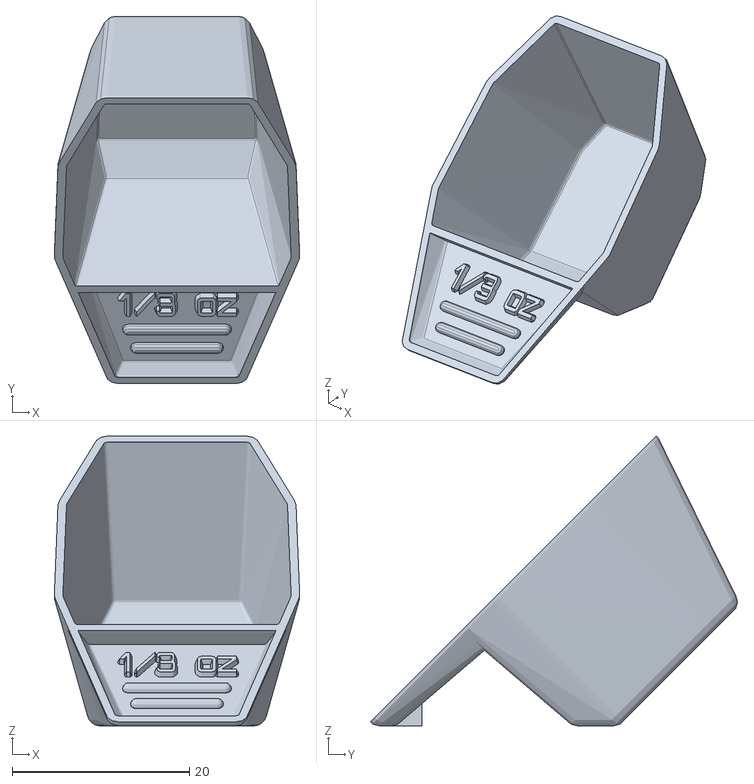
[picture p189: CAD file, 2018-07-29]
ThingiVerse/Measuring_Cup/us_0.33_fl_oz.stl
27.7 x 41.4 x 32.7
