SnoBotics981/CAD-MfgResources/ThingiVerse/Parametric_Measuring_Spoon/MeasSpoon_12_5ml_100_handle.stl

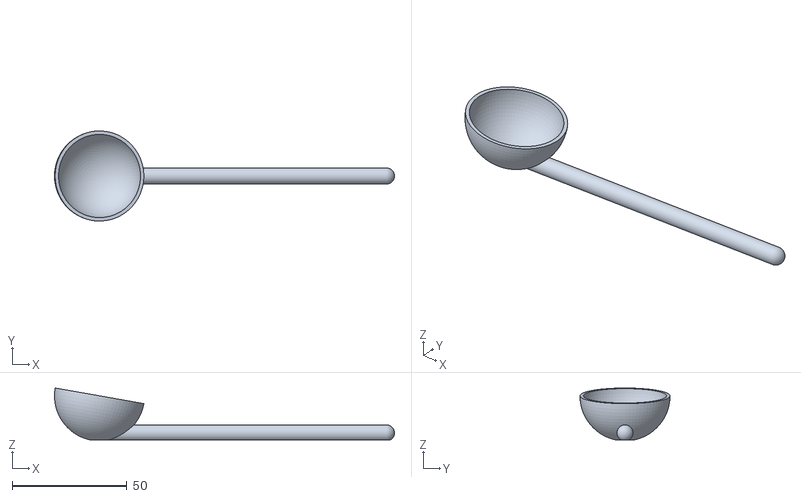
[picture p190: CAD file, 2020-01-22]
ThingiVerse/Parametric_Measuring_Spoon/MeasSpoon_12_5ml_100_handle.stl
148.1 x 39.2 x 22.6
