SnoBotics981/CAD-MfgResources/ThingiVerse/SprayCanNozzels/WD40_Cap_fixed.stl

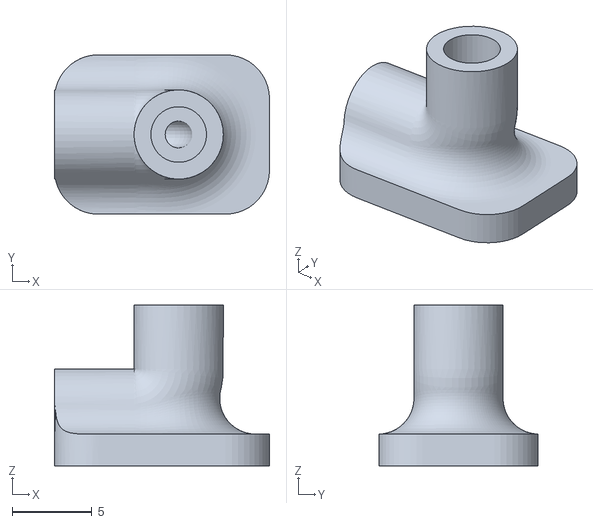
[picture p191: CAD file, 2018-07-13]
ThingiVerse/SprayCanNozzels/WD40_Cap_fixed.stl
13.5 x 10.0 x 10.1
