SnoBotics981/CAD-MfgResources/(list of files, cad)

Other CAD files:
Andy-Mark/2013 Chassis/Long Design/Templates/am_gb.dwg
Andy-Mark/2013 Chassis/Wide Design/Templates/BSI.dwg
Andy-Mark/Pressure Sensor/REV-11-1107-Pressure-Sensor.step
VexRobotics/ThunderHex/217-4396-STEP-20141219.STEP
Andy-Mark/2013 Chassis/Long Design/Templates/am_din.dwg
Andy-Mark/2013 Chassis/Wide Design/Templates/JIS.dwg
ThingiVerse/Battery Cap/files/Negative_Cap_545.stl
ThingiVerse/SprayCanNozzels/spraycan_cap_1_5mm_hole2.stl
Andy-Mark/2013 Chassis/Long Design/Templates/BSI.dwg
Andy-Mark/2013 Chassis/Wide Design/Templates/am_din.dwg
ThingiVerse/Raspberry_Pi_Camera_V2.1_Lens_Adjustment_Spanner/files/raspy_cam_wrench_C.6.obj
ThingiVerse/MoreNutsAndBolts/files/8mm_wing_nut.scad
ThingiVerse/NutsAndBolts/files/Nut_Job.scad
ThingiVerse/ScadThreadingLibrary/files/threadlib_solid.scad
Andy-Mark/2013 Chassis/Long Design/10-24 Hex Washer Rolling x 1.25_93882A213.ipt
Andy-Mark/2013 Chassis/Long Design/10-32 Nylock Nut.ipt
Andy-Mark/2013 Chassis/Long Design/125 x 124 x 700 Machine Key.ipt
Andy-Mark/2013 Chassis/Long Design/14-20 Nylock Nut_97135A210.ipt
Andy-Mark/2013 Chassis/Long Design/1614Z Bearing.ipt
Andy-Mark/2013 Chassis/Long Design/1800x375 brass spacer.ipt
Andy-Mark/2013 Chassis/Long Design/185x385 washer 17W06272.ipt
Andy-Mark/2013 Chassis/Long Design/250 Washer.ipt
Andy-Mark/2013 Chassis/Long Design/375-16 Hex Nut_HNUT 0.3750-16-D-C.ipt
Andy-Mark/2013 Chassis/Long Design/375-16 x 6 Hex Bolt_HFBOLT 0.375-16x5x1-C.ipt
Andy-Mark/2013 Chassis/Long Design/39 tooth HTD Double Pulley.ipt
Andy-Mark/2013 Chassis/Long Design/42 tooth HTD Pulley half.ipt
Andy-Mark/2013 Chassis/Long Design/5-16 washer.ipt
Andy-Mark/2013 Chassis/Long Design/500 E-klip.ipt
Andy-Mark/2013 Chassis/Long Design/500 Washer am-1001.ipt
Andy-Mark/2013 Chassis/Long Design/520mm belt on 39&42 pulley.ipt
Andy-Mark/2013 Chassis/Long Design/6 HiGrip Asm.iam
Andy-Mark/2013 Chassis/Long Design/6 HiGrip Tread.ipt
Andy-Mark/2013 Chassis/Long Design/6 HiGrip and 42 HTD Pulley and Bearings.iam
Andy-Mark/2013 Chassis/Long Design/800mm belt on 42&42 pulley.ipt
Andy-Mark/2013 Chassis/Long Design/820x375 brass spacer.ipt
Andy-Mark/2013 Chassis/Long Design/8mm spring clip.ipt
Andy-Mark/2013 Chassis/Long Design/Anchor Stud.ipt
Andy-Mark/2013 Chassis/Long Design/BHCS 14-20 x 0.5.ipt
Andy-Mark/2013 Chassis/Long Design/C-Base2LongTBMini6HiGripBelts.iam
Andy-Mark/2013 Chassis/Long Design/C-Channel 2-23.ipt
Andy-Mark/2013 Chassis/Long Design/C-Channel 2.ipt
Andy-Mark/2013 Chassis/Long Design/CB2 Axle Assembly.iam
Andy-Mark/2013 Chassis/Long Design/CB2 Long.iam
Andy-Mark/2013 Chassis/Long Design/CIM Motor SW.ipt
Andy-Mark/2013 Chassis/Long Design/Corner Extrusion_1.ipt
Andy-Mark/2013 Chassis/Long Design/CrossHex13.25 - Copy.ipt
Andy-Mark/2013 Chassis/Long Design/CrossHexNut0990.ipt
Andy-Mark/2013 Chassis/Long Design/Design Data/AIT/Mold Design/Mold Design Stop Pin.ipt
Andy-Mark/2013 Chassis/Long Design/Design Data/Cable & Harness/en-US/harness.iam
Andy-Mark/2013 Chassis/Long Design/Design Data/Tube & Pipe/en-US/piping runs.iam
Andy-Mark/2013 Chassis/Long Design/FHTS 0.25-20-0.75_FHTS 0.25-20-G-0.75-C.ipt
Andy-Mark/2013 Chassis/Long Design/FR6ZZ Bearing.ipt
Andy-Mark/2013 Chassis/Long Design/FR8ZZ Bearing.ipt
Andy-Mark/2013 Chassis/Long Design/Long CB2 w Connects.iam
Andy-Mark/2013 Chassis/Long Design/R6ZZ Bearing.ipt
Andy-Mark/2013 Chassis/Long Design/SHCS 10-32 x 0.625.ipt
Andy-Mark/2013 Chassis/Long Design/SHCS 14-20 x 1.75.ipt
Andy-Mark/2013 Chassis/Long Design/TB Mini w motor pulley cross hex.iam
Andy-Mark/2013 Chassis/Long Design/TM Flat Shaft Plate.ipt
Andy-Mark/2013 Chassis/Long Design/Templates/ANSI (mm).dwg
Andy-Mark/2013 Chassis/Long Design/Templates/ANSI (mm).idw
Andy-Mark/2013 Chassis/Long Design/Templates/BSI.idw
Andy-Mark/2013 Chassis/Long Design/Templates/DIN.dwg
Andy-Mark/2013 Chassis/Long Design/Templates/DIN.idw
Andy-Mark/2013 Chassis/Long Design/Templates/GB.dwg
Andy-Mark/2013 Chassis/Long Design/Templates/GB.idw
Andy-Mark/2013 Chassis/Long Design/Templates/GOST.dwg
Andy-Mark/2013 Chassis/Long Design/Templates/GOST.idw
Andy-Mark/2013 Chassis/Long Design/Templates/ISO.dwg
Andy-Mark/2013 Chassis/Long Design/Templates/ISO.idw
Andy-Mark/2013 Chassis/Long Design/Templates/JIS.dwg
Andy-Mark/2013 Chassis/Long Design/Templates/JIS.idw
Andy-Mark/2013 Chassis/Long Design/Templates/Mold Design (DIN).iam
Andy-Mark/2013 Chassis/Long Design/Templates/Mold Design (mm).iam
Andy-Mark/2013 Chassis/Long Design/Templates/Sheet Metal (DIN).ipt
Andy-Mark/2013 Chassis/Long Design/Templates/Sheet Metal (mm).ipt
Andy-Mark/2013 Chassis/Long Design/Templates/Standard (DIN).iam
Andy-Mark/2013 Chassis/Long Design/Templates/Standard (DIN).ipn
Andy-Mark/2013 Chassis/Long Design/Templates/Standard (DIN).ipt
Andy-Mark/2013 Chassis/Long Design/Templates/Standard (mm).iam
Andy-Mark/2013 Chassis/Long Design/Templates/Standard (mm).ipn
Andy-Mark/2013 Chassis/Long Design/Templates/Standard (mm).ipt
Andy-Mark/2013 Chassis/Long Design/Templates/Weldment (ANSI - mm).iam
Andy-Mark/2013 Chassis/Long Design/Templates/Weldment (BSI).iam
Andy-Mark/2013 Chassis/Long Design/Templates/Weldment (DIN).iam
Andy-Mark/2013 Chassis/Long Design/Templates/Weldment (GB).iam
Andy-Mark/2013 Chassis/Long Design/Templates/Weldment (ISO).iam
Andy-Mark/2013 Chassis/Long Design/Templates/Weldment (JIS).iam
Andy-Mark/2013 Chassis/Long Design/Templates/am_bsi.dwg
Andy-Mark/2013 Chassis/Long Design/Templates/am_iso.dwg
Andy-Mark/2013 Chassis/Long Design/Templates/am_jis.dwg
Andy-Mark/2013 Chassis/Long Design/Toughbox Mini 2.iam
Andy-Mark/2013 Chassis/Long Design/Toughbox d03.ipt
Andy-Mark/2013 Chassis/Long Design/Toughbox d05.ipt
Andy-Mark/2013 Chassis/Long Design/Toughbox d06.ipt
Andy-Mark/2013 Chassis/Long Design/Toughbox d07.ipt
Andy-Mark/2013 Chassis/Long Design/Toughbox d08.ipt
Andy-Mark/2013 Chassis/Long Design/Toughbox d09.ipt
Andy-Mark/2013 Chassis/Wide Design/Design Data/AIT/Mold Design/Mold Design Stop Pin.ipt
Andy-Mark/2013 Chassis/Wide Design/Design Data/Cable & Harness/en-US/harness.iam
Andy-Mark/2013 Chassis/Wide Design/Design Data/Tube & Pipe/en-US/piping runs.iam
Andy-Mark/2013 Chassis/Wide Design/Templates/ANSI (mm).dwg
Andy-Mark/2013 Chassis/Wide Design/Templates/ANSI (mm).idw
Andy-Mark/2013 Chassis/Wide Design/Templates/BSI.idw
Andy-Mark/2013 Chassis/Wide Design/Templates/DIN.dwg
Andy-Mark/2013 Chassis/Wide Design/Templates/DIN.idw
Andy-Mark/2013 Chassis/Wide Design/Templates/GB.dwg
Andy-Mark/2013 Chassis/Wide Design/Templates/GB.idw
Andy-Mark/2013 Chassis/Wide Design/Templates/GOST.dwg
Andy-Mark/2013 Chassis/Wide Design/Templates/GOST.idw
Andy-Mark/2013 Chassis/Wide Design/Templates/ISO.dwg
Andy-Mark/2013 Chassis/Wide Design/Templates/ISO.idw
Andy-Mark/2013 Chassis/Wide Design/Templates/JIS.idw
Andy-Mark/2013 Chassis/Wide Design/Templates/Mold Design (DIN).iam
Andy-Mark/2013 Chassis/Wide Design/Templates/Mold Design (mm).iam
Andy-Mark/2013 Chassis/Wide Design/Templates/Sheet Metal (DIN).ipt
Andy-Mark/2013 Chassis/Wide Design/Templates/Sheet Metal (mm).ipt
Andy-Mark/2013 Chassis/Wide Design/Templates/Standard (DIN).iam
Andy-Mark/2013 Chassis/Wide Design/Templates/Standard (DIN).ipn
Andy-Mark/2013 Chassis/Wide Design/Templates/Standard (DIN).ipt
Andy-Mark/2013 Chassis/Wide Design/Templates/Standard (mm).iam
Andy-Mark/2013 Chassis/Wide Design/Templates/Standard (mm).ipn
Andy-Mark/2013 Chassis/Wide Design/Templates/Standard (mm).ipt
Andy-Mark/2013 Chassis/Wide Design/Templates/Weldment (ANSI - mm).iam
Andy-Mark/2013 Chassis/Wide Design/Templates/Weldment (BSI).iam
Andy-Mark/2013 Chassis/Wide Design/Templates/Weldment (DIN).iam
Andy-Mark/2013 Chassis/Wide Design/Templates/Weldment (GB).iam
Andy-Mark/2013 Chassis/Wide Design/Templates/Weldment (ISO).iam
Andy-Mark/2013 Chassis/Wide Design/Templates/Weldment (JIS).iam
Andy-Mark/2013 Chassis/Wide Design/Templates/am_bsi.dwg
Andy-Mark/2013 Chassis/Wide Design/Templates/am_gb.dwg
Andy-Mark/2013 Chassis/Wide Design/Templates/am_iso.dwg
Andy-Mark/2013 Chassis/Wide Design/Templates/am_jis.dwg
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
