SnoBotics981/CAD-MfgResources/Andy-Mark/LiftMechanism/am-3844+2x1+Elevator+Assembly+Guide.pdf

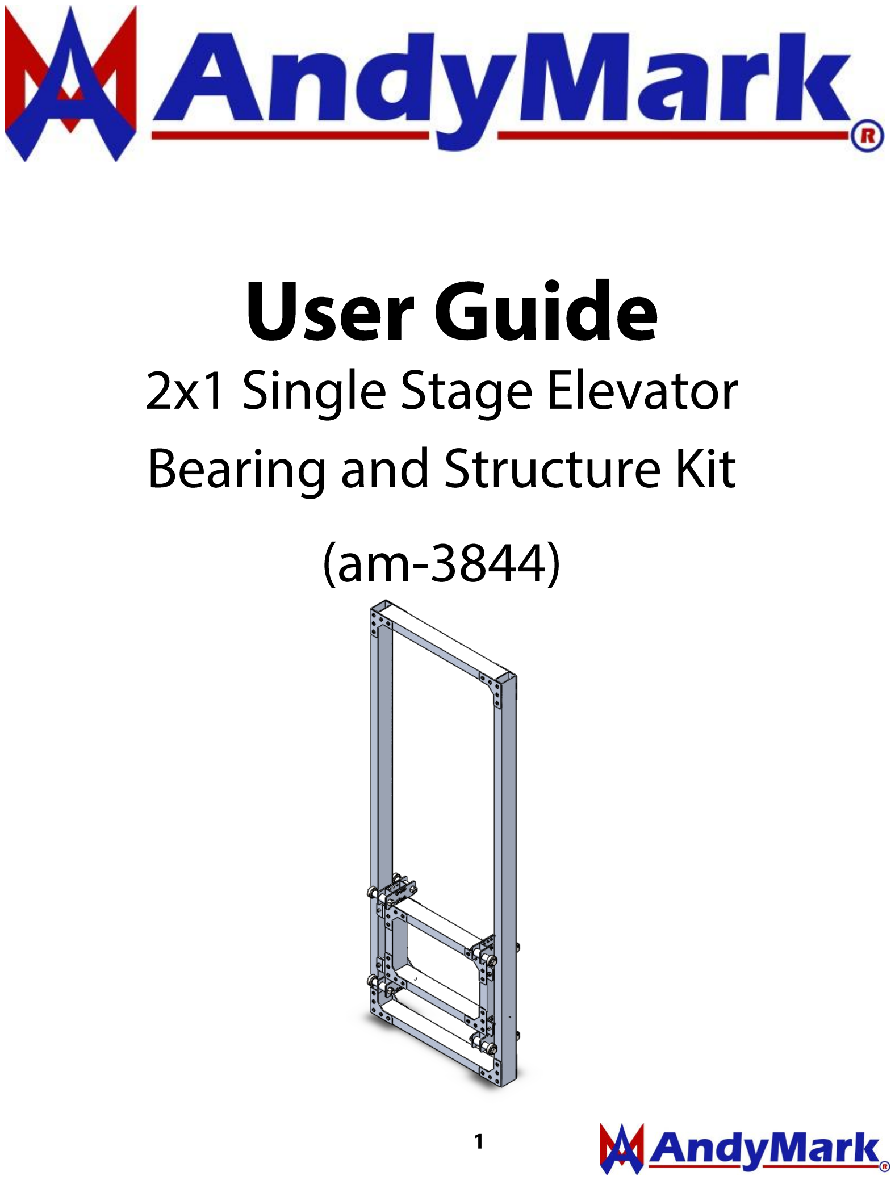
[picture p192: page 1]

## BOM & Tools

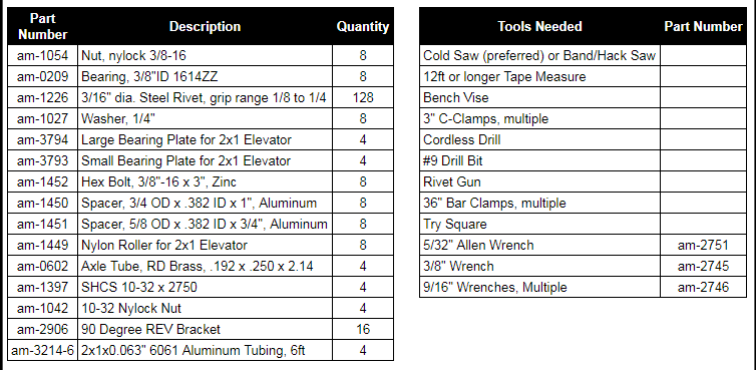
[picture p193: figure]

Note: The following cutting diagrams are for a single stage elevator system. This guide is written with minimum required dimensions, as this elevator bearing system was designed to adapt to many different size needs and constraints of FIRST Robotics Competition teams. Before cutting tubes, you must determine your desired length of travel and desired MAX width of your elevator. The dimensions below are the minimum required lengths for each tube, and also notes the important relationship between the length of the Carriage Horizontal Tubes and the length of the Frame Horizontal Tubes.

## Tube Cutting Guide

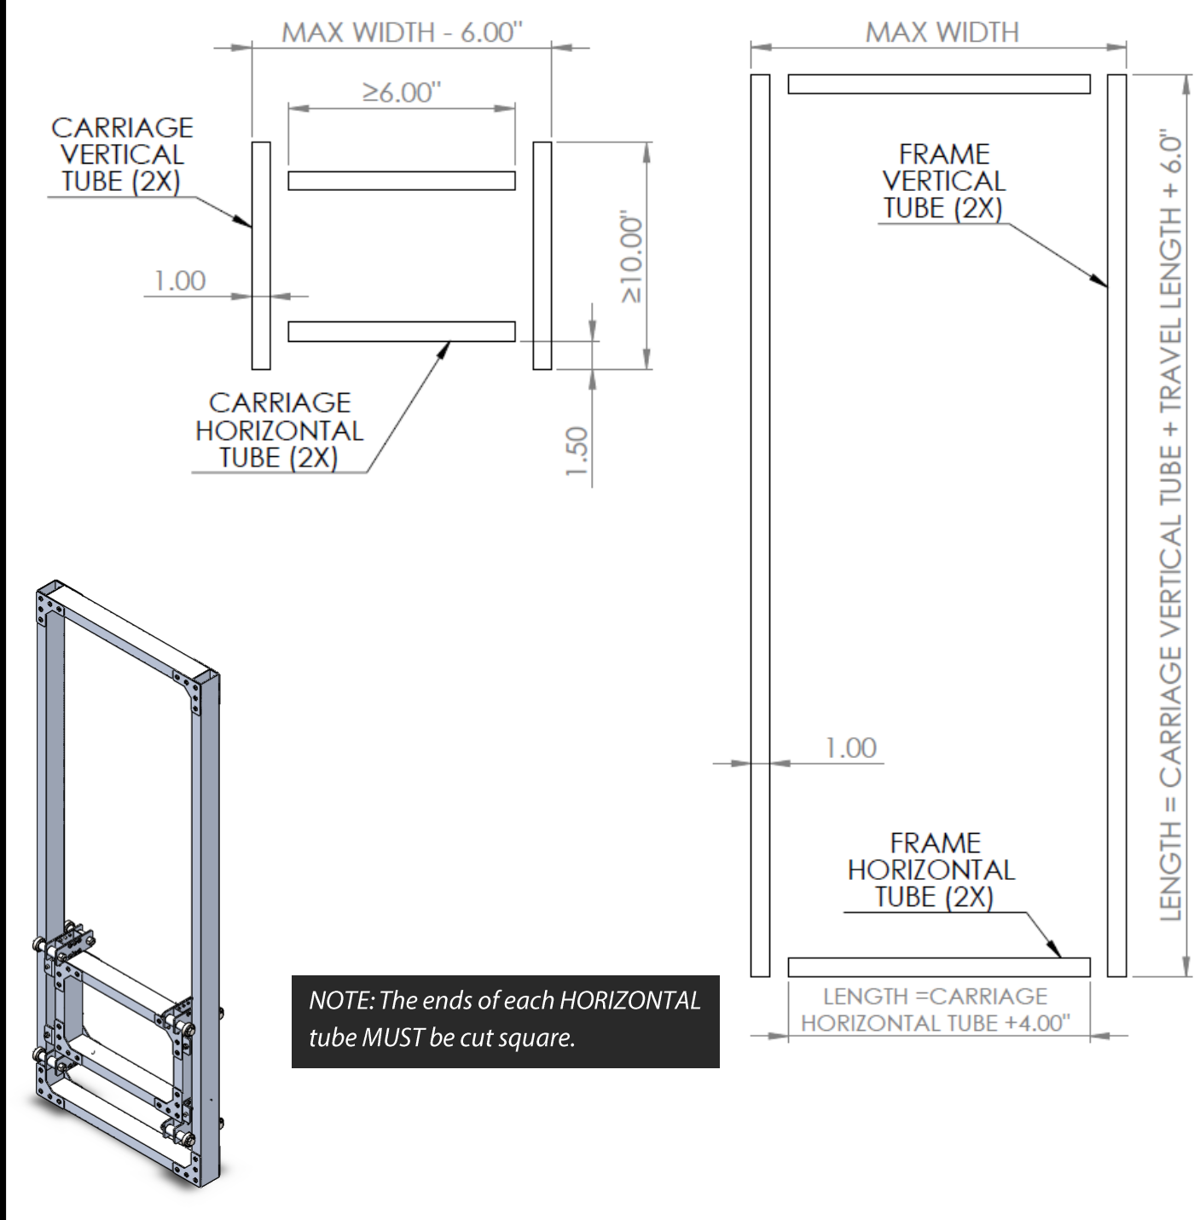
[picture p194: figure]

Step 3: Slide one Small Bearing Plate (am-3793) onto the 3/8" bolts, and secure with the 3/8-16 Lock Nuts (am-1054)
Step 2: Use a Try Square to ensure the bottom of the Corner Bearing Assembly is perpendicular with the 1" wide faces of the Carriage Vertical Tube. Align the inside surface of the notch (as shown with arrows,) with the outside surfaces of the Tube.
Step 1: Slide one Corner Bearing Assembly onto one Carriage Vertical Tube, and line up the top of the assembly with the end of the tube. This should be a somewhat snug fit.
Step 3: Match drill the rivet holes with a #9 (0.196") drill bit through the Large Bearing Plate into the nearest side of the Tube in the locations shown with a red dot.
Step 4: Rivet the Large Bearing Plate in place with six 3/16" x 1/4" Steel Rivets (am-1226)

## Corner Bearing Assembly

Step 1: Slide one 1614Z Bearing (am-0209) and one 3/4" long Aluminum Spacer(am-1451) onto two 3/8"x 3" bolt (am-1452).
Step 2: Slide one Large Bearing Plate (am-3794) and two 1" Long Aluminum Spacers (am-1450) onto the two 3/8" x 3" Bolts.

4X

## Carriage Assembly

## Carriage Assembly Continued

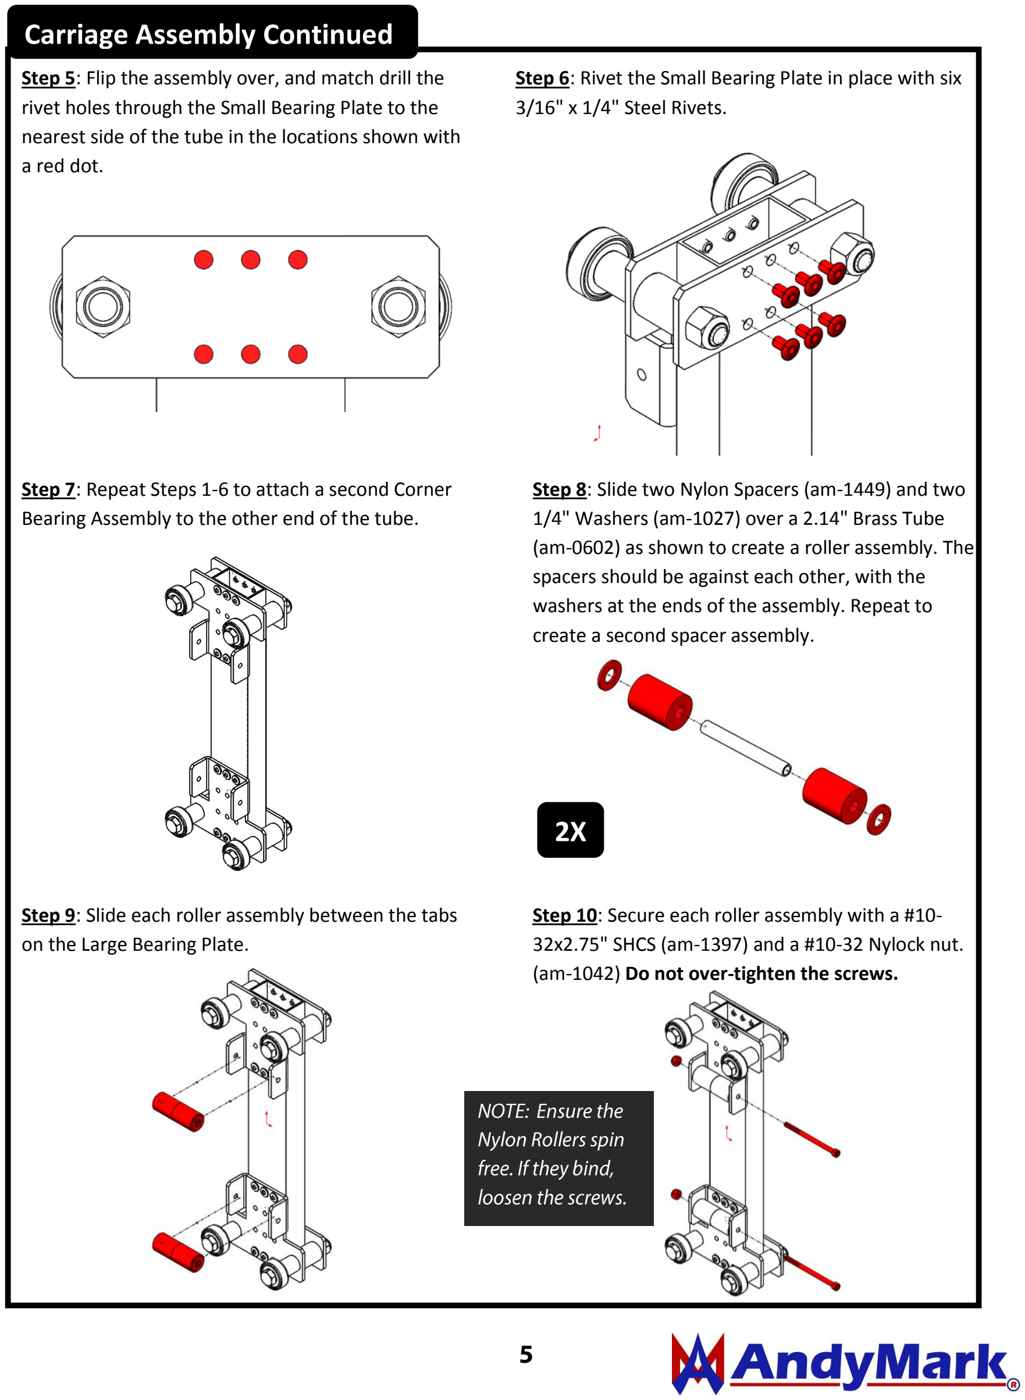
[picture p195: page 5]

Step 5: Flip the assembly over, and match drill the rivet holes through the Small Bearing Plate to the nearest side of the tube in the locations shown with a red dot.
Step 6: Rivet the Small Bearing Plate in place with six 3/16" x 1/4" Steel Rivets.
Step 7: Repeat Steps 1-6 to attach a second Corner Bearing Assembly to the other end of the tube.
Step 9: Slide each roller assembly between the tabs on the Large Bearing Plate.
Step 10: Secure each roller assembly with a #10-32x2.75" SHCS (am-1397) and a #10-32 Nylock nut. (am-1042) Do not over-tighten the screws.

2X

Step 8: Slide two Nylon Spacers (am-1449) and two 1/4" Washers (am-1027) over a 2.14" Brass Tube (am-0602) as shown to create a roller assembly. The spacers should be against each other, with the washers at the ends of the assembly. Repeat to create a second spacer assembly.

## Carriage Assembly Continued

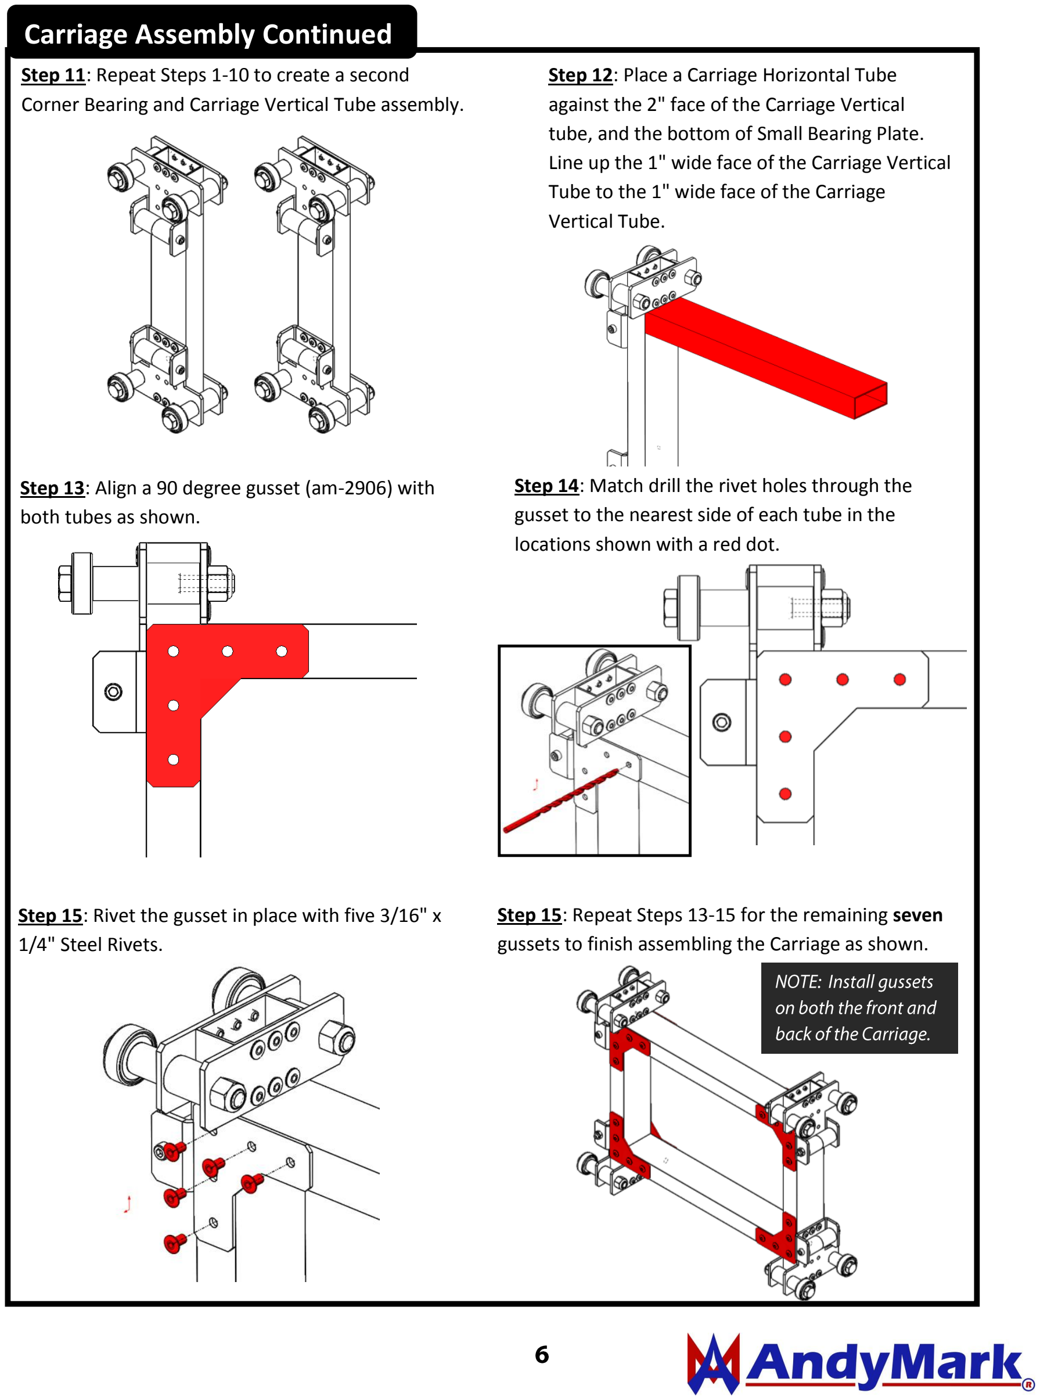
[picture p196: page 6]

Step 12: Place a Carriage Horizontal Tube against the 2" face of the Carriage Vertical tube, and the bottom of Small Bearing Plate. Line up the 1" wide face of the Carriage Vertical Tube to the 1" wide face of the Carriage Vertical Tube.
Step 11: Repeat Steps 1-10 to create a second Corner Bearing and Carriage Vertical Tube assembly.
Step 13: Align a 90 degree gusset (am-2906) with both tubes as shown.
Step 14: Match drill the rivet holes through the gusset to the nearest side of each tube in the locations shown with a red dot.
Step 15: Rivet the gusset in place with five 3/16" x 1/4" Steel Rivets.
Step 15: Repeat Steps 13-15 for the remaining seven gussets to finish assembling the Carriage as shown.

## Frame Assembly

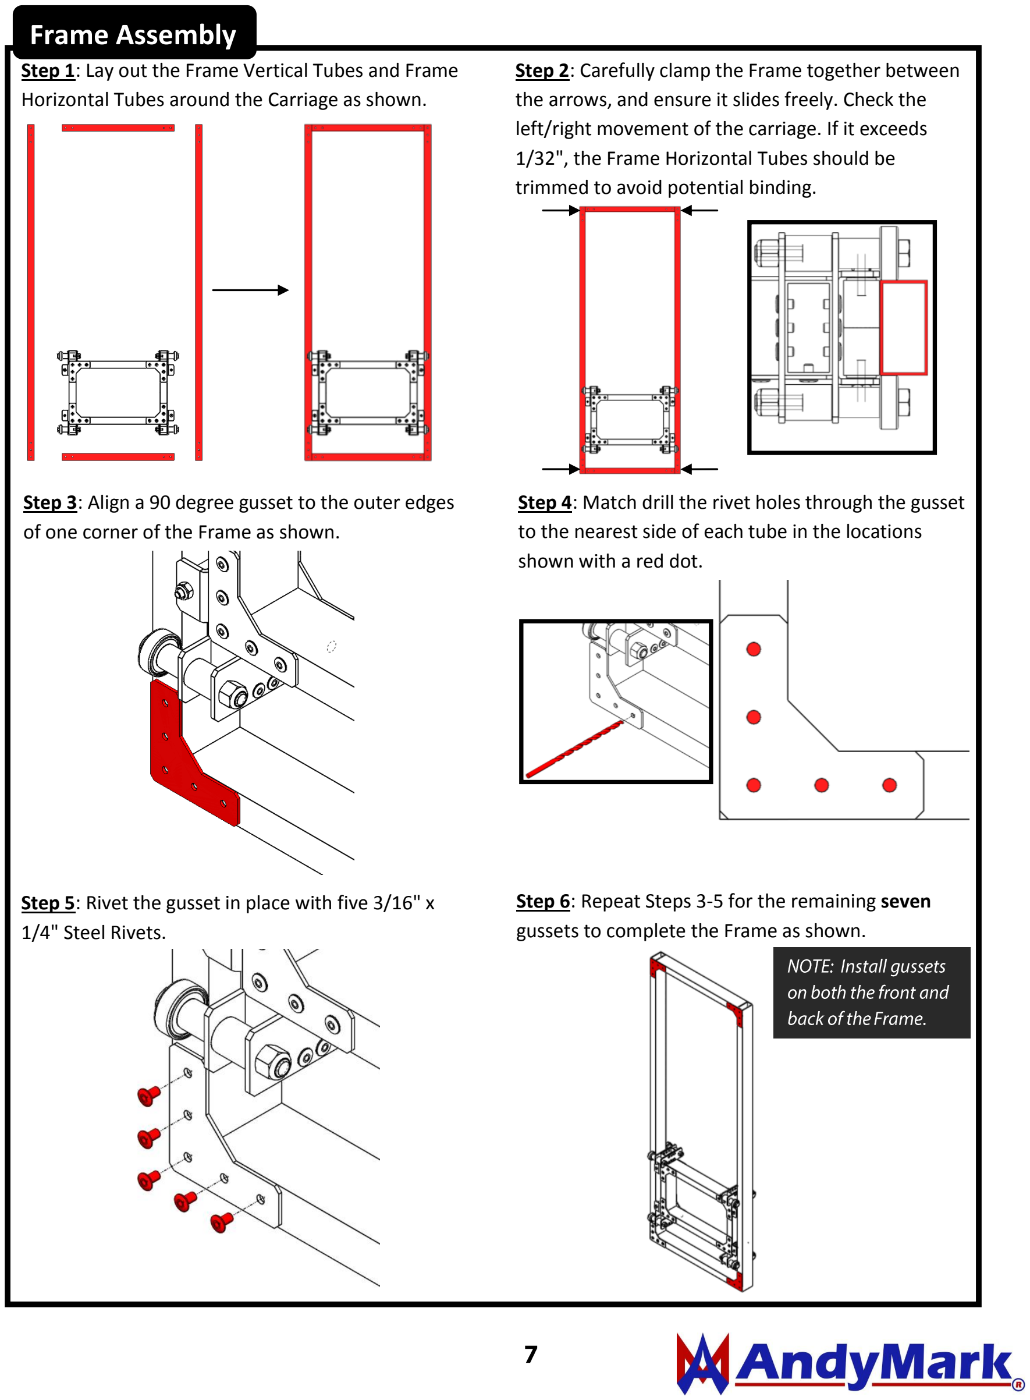
[picture p197: page 7]

Step 1: Lay out the Frame Vertical Tubes and Frame Horizontal Tubes around the Carriage as shown.
Step 2: Carefully clamp the Frame together between the arrows, and ensure it slides freely. Check the left/right movement of the carriage. If it exceeds 1/32", the Frame Horizontal Tubes should be trimmed to avoid potential binding.
Step 3: Align a 90 degree gusset to the outer edges of one corner of the Frame as shown.
Step 4: Match drill the rivet holes through the gusset to the nearest side of each tube in the locations shown with a red dot.
Step 5: Rivet the gusset in place with five 3/16" x 1/4" Steel Rivets.
Step 6: Repeat Steps 3-5 for the remaining seven gussets to complete the Frame as shown.
