SnoBotics981/CAD-MfgResources/Andy-Mark/Pixy Camera/PixyCamUserGuide.pdf

Wiring:

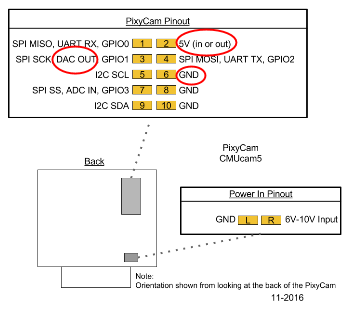
[picture p198: figure]

DAC OUT - wired to your S on the Analog In
5V (in or out) - wired to the 5V line on the Analog In
GND - wired to Ground on the Analog In

Pixy Setup:
http://www.cmucam.org/projects/cmucam5/wiki/Install_PixyMon_on_Windows_Vista_7_8

Install PixyMon. Connect Camera over USB to computer. Click Interface and then select Analog/digital X. Click Apply. Unplug USB. Analog should start moving.

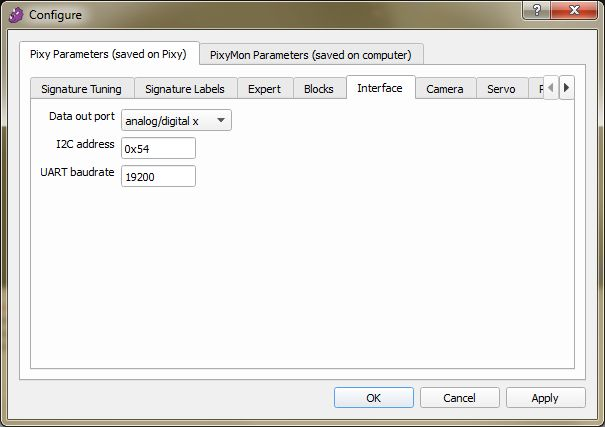
[picture p199: figure]

More Info about voltages:
http://cmucam.org/projects/cmucam5/wiki/Porting_Guidehttps://www.youtube.com/channel/UCZWJf3quTMb-lxg2rn-g6DA/videos
