SnoBotics981/CAD-MfgResources/VexRobotics/PlanetaryGearboxInstructions/217-3195-Base-Kit-20141126.pdf

## VEXpro 3 CIM Ball Shifter Base Kit

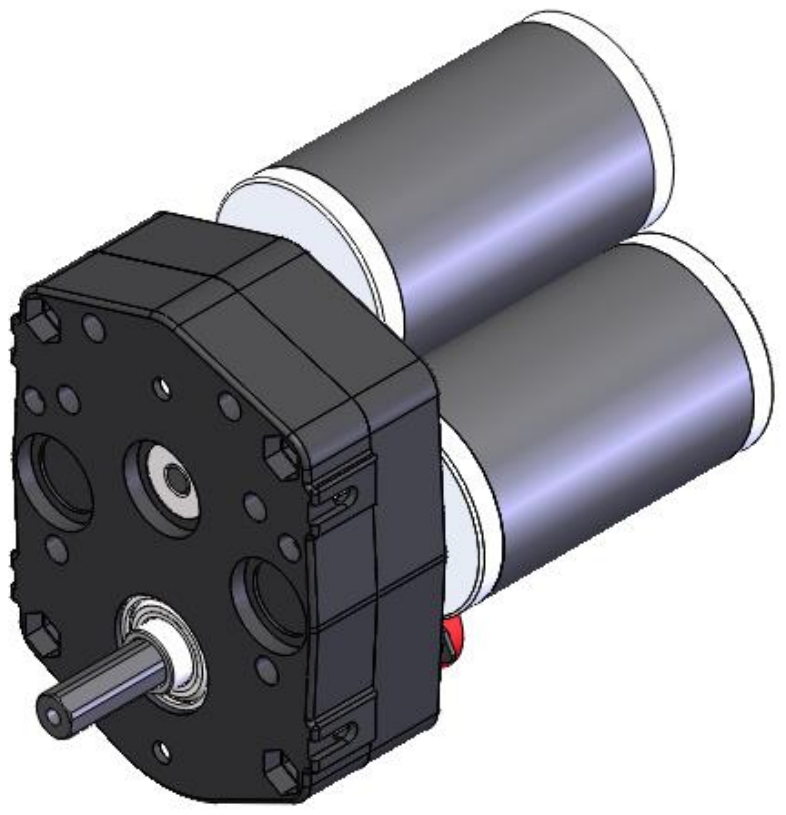
[picture p200: figure]

Copyright 2014, VEX Robotics Inc.
2014-11-26

# VEXpro 3 CIM Ball Shifter

# Base Kit

## Assembly Instructions

## VEXpro 3 CIM Ball Shifter Base Kit

### Step 1 (Grayhill Series 63R Encoder):

If using a Grayhill Series 63R encoder, use (4X) 8-32 x 3/8” screws to attach (2X) 8-32 x 1-1/2” and (2X) 8-32 x 3/4" standoffs to the back shifter housing. The use of Loctite is recommended with all screws that do not have a Nylock Patch.

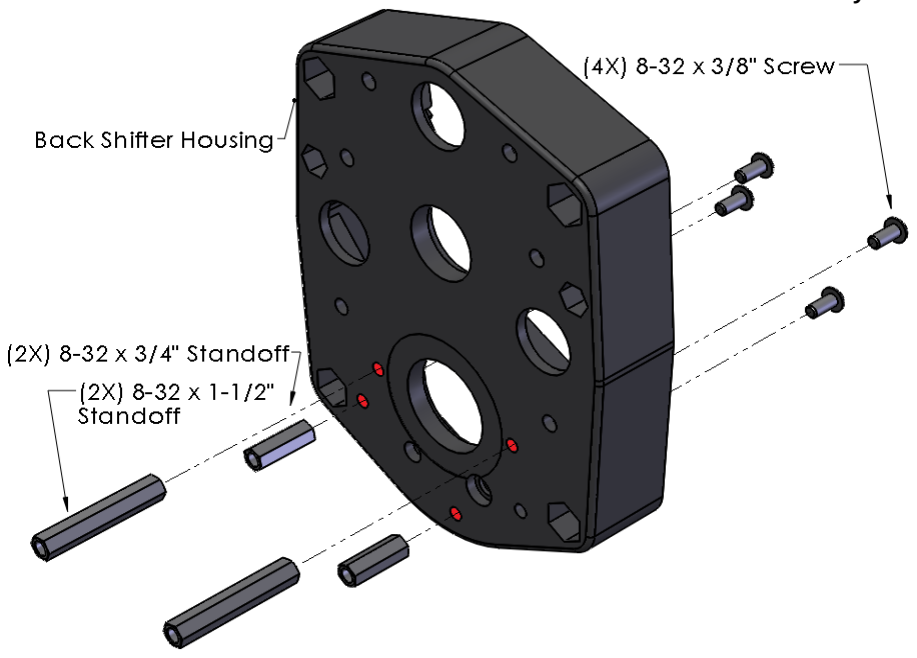
[picture p201: figure]

### Step 2:

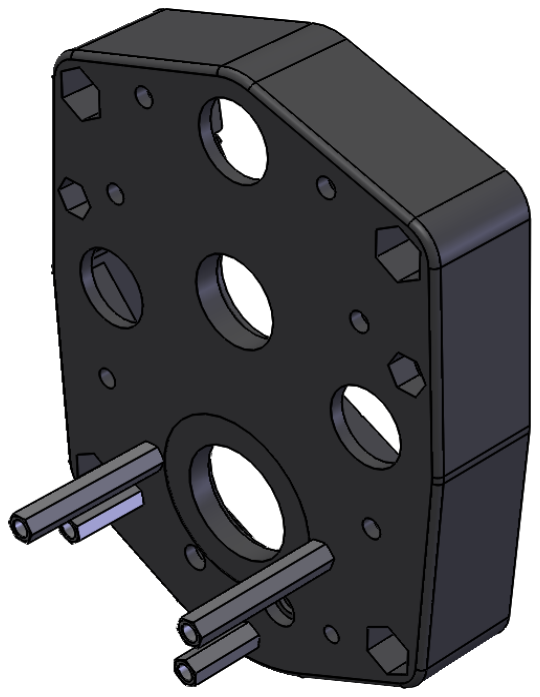
[picture p202: figure]

Insert (6X) 10-32 x 1/2" screws into the back shifter housing. These will be used later to mount the 3 CIM motors. Only use (4X) screws if 2 CIMs are being mounted.

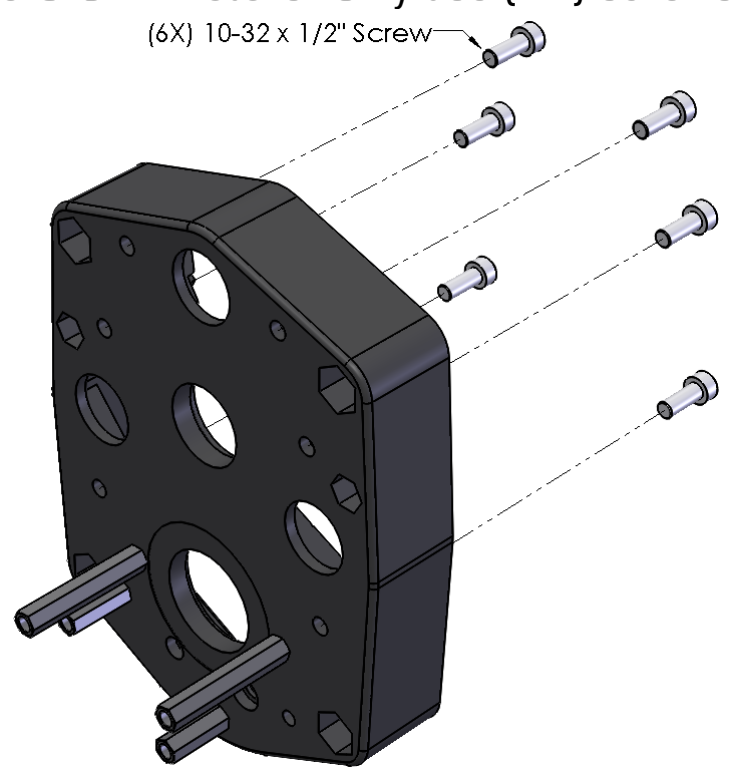
[picture p203: figure]
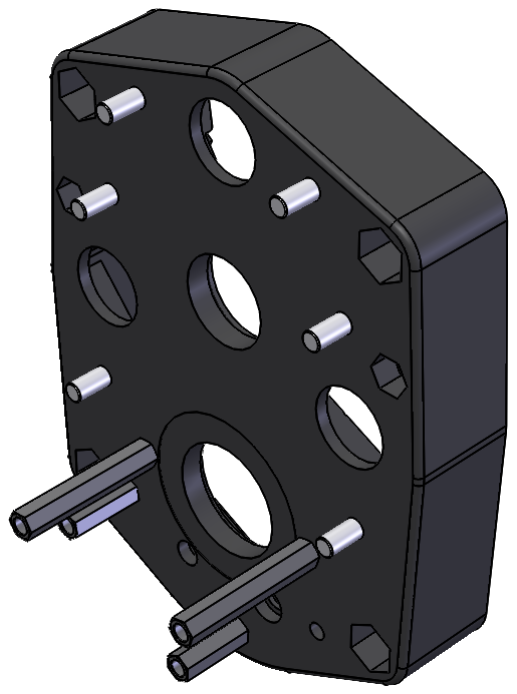
[picture p204: figure]

Note: The screws are not retained in this step, but may be impossible to install later depending on the user selected gear ratio.

## VEXpro 3 CIM Ball Shifter Base Kit

### Step 3:

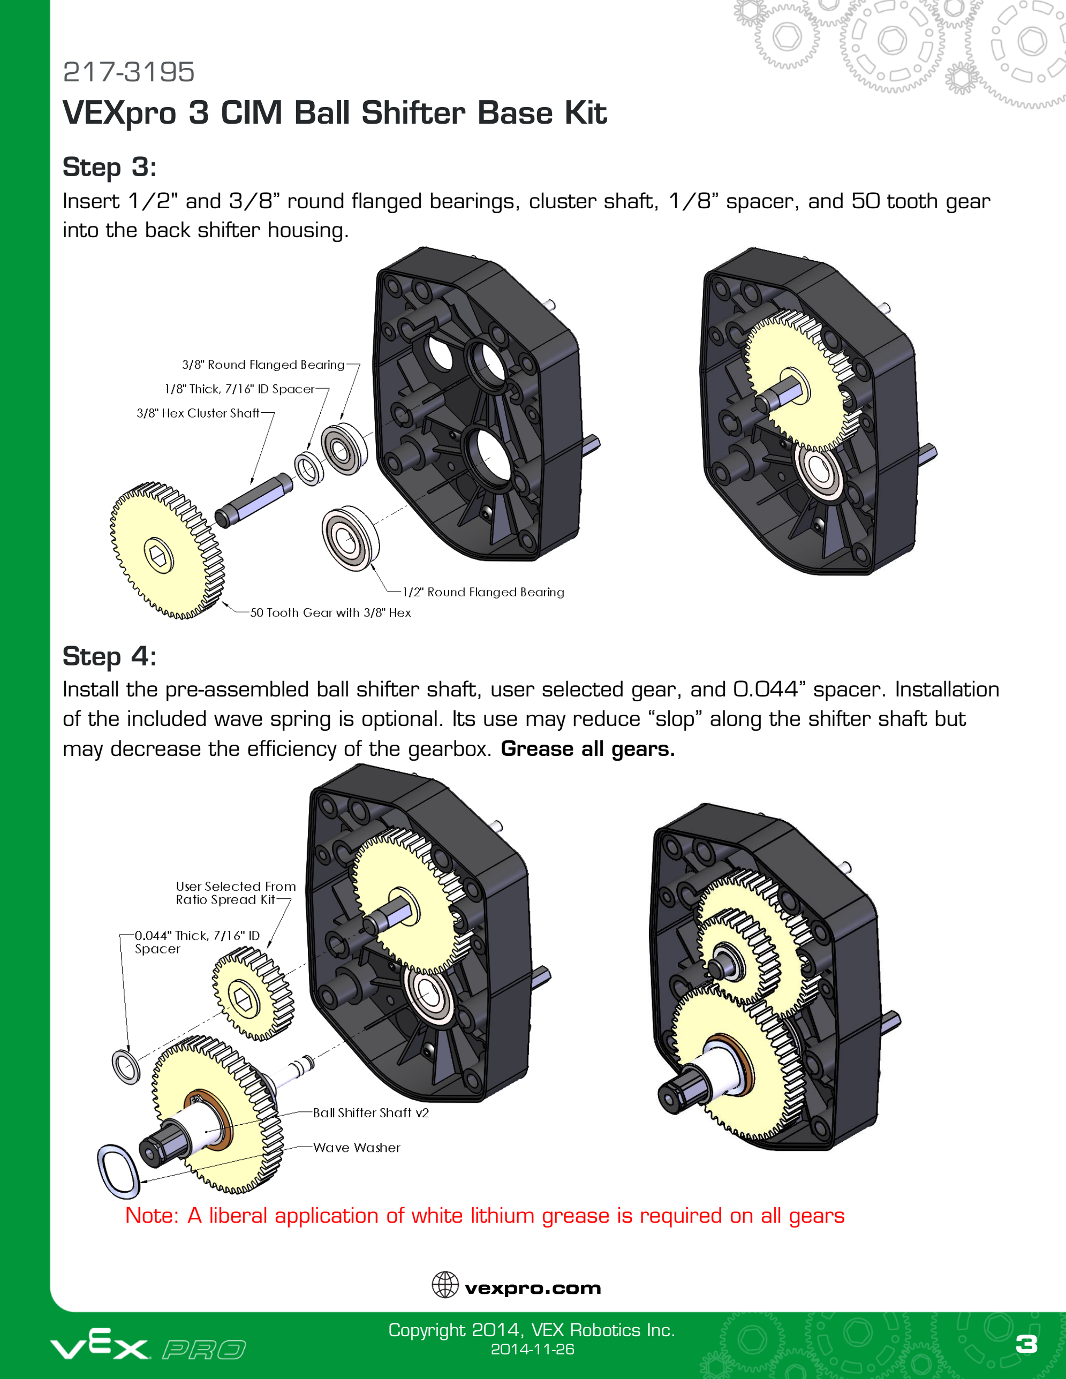
[picture p205: page 3]

Insert 1/2" and 3/8” round flanged bearings, cluster shaft, 1/8” spacer, and 50 tooth gear into the back shifter housing.

### Step 4:

Install the pre-assembled ball shifter shaft, user selected gear, and 0.044” spacer. Installation of the included wave spring is optional. Its use may reduce “slop” along the shifter shaft but may decrease the efficiency of the gearbox. Grease all gears.

Note: A liberal application of white lithium grease is required on all gears

## VEXpro 3 CIM Ball Shifter Base Kit

### Step 5:

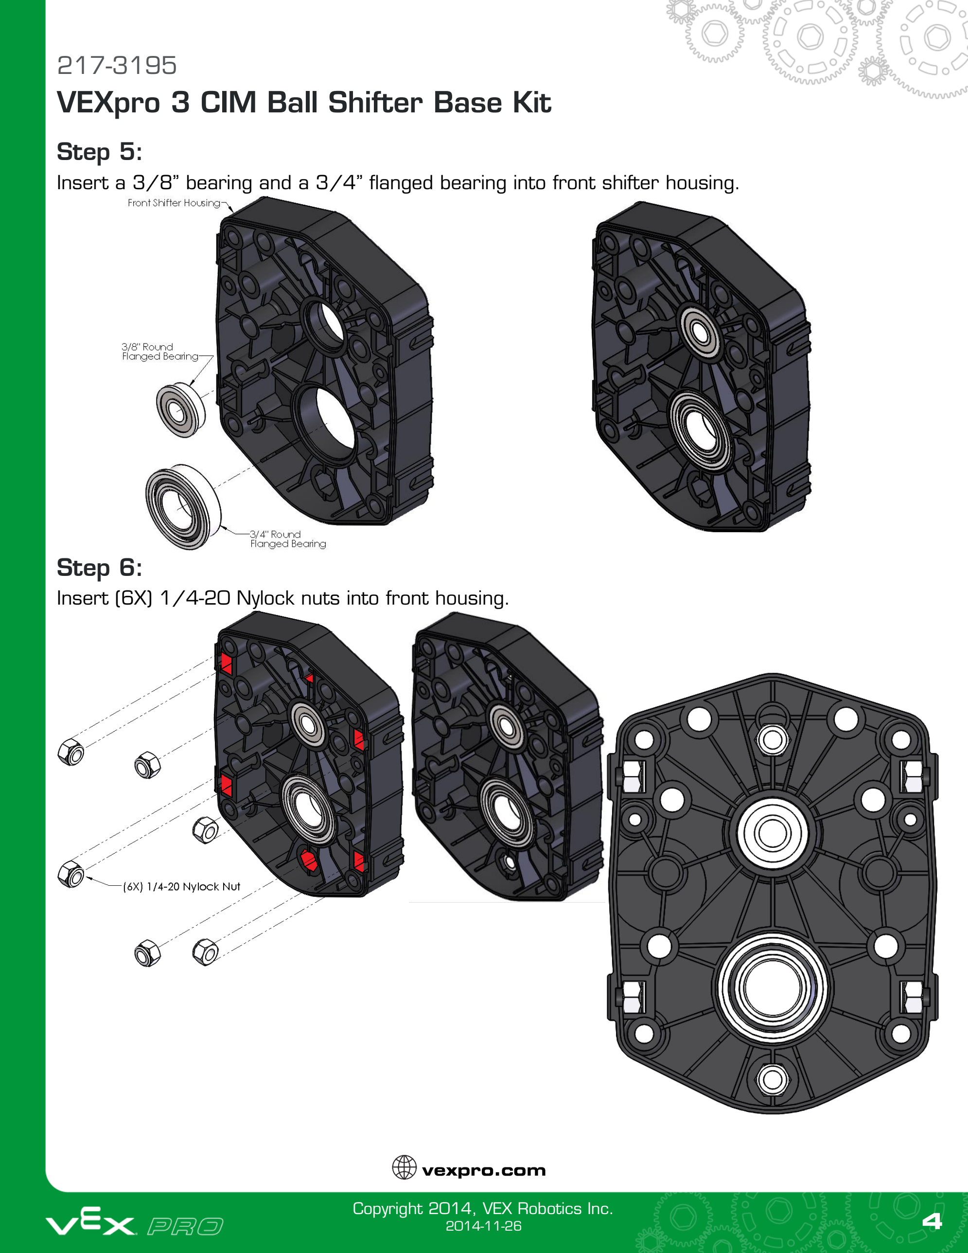
[picture p206: page 4]

Insert a 3/8” bearing and a 3/4” flanged bearing into front shifter housing.

### Step 6:

Insert (6X) 1/4-20 Nylock nuts into front housing.

## VEXpro 3 CIM Ball Shifter Base Kit

### Step 7:

Connect the Front and Back Housings using (4X) 1/4-20 x 1-5/8” screws, (4X) 1/4-20 Nylock nuts, (2X) 8-32 x 1-5/8” screws, and (2X) 8-32 Nylock nuts. Use of Locktite is not recommended with Nylock nuts.

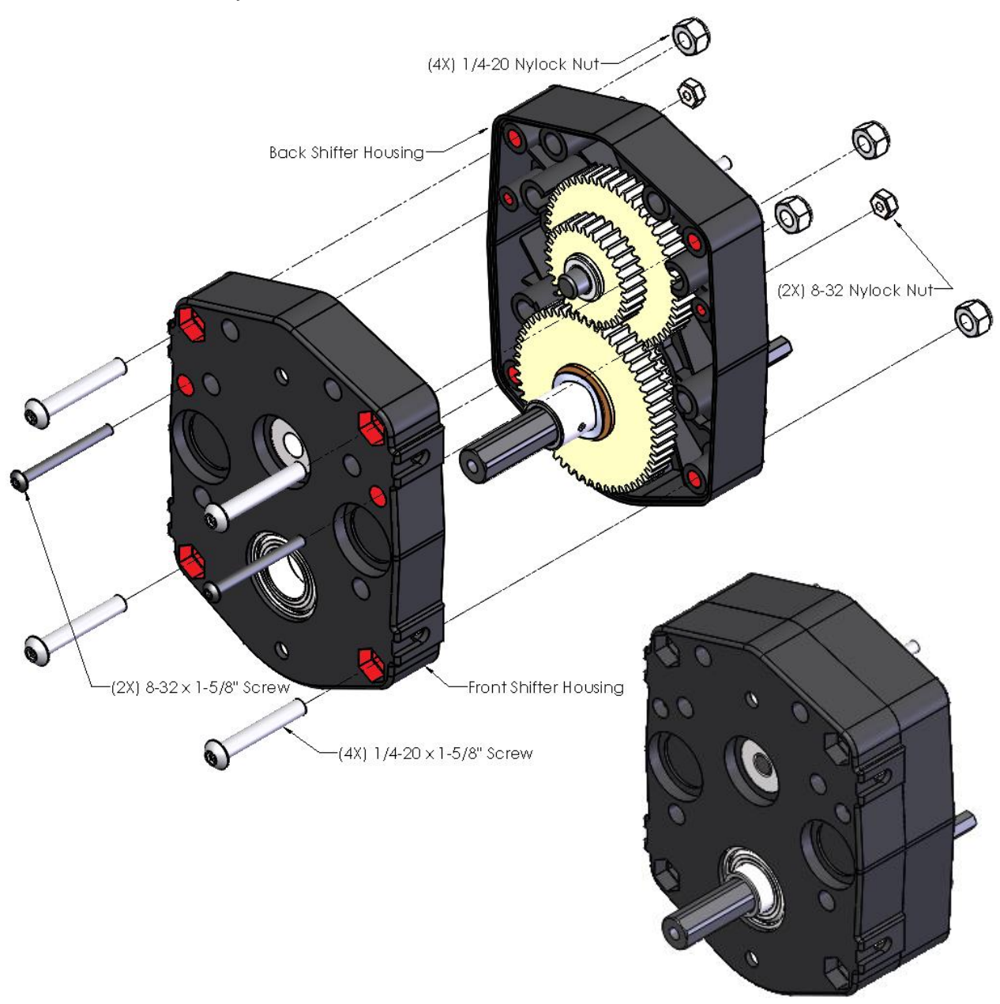
[picture p207: figure]

## VEXpro 3 CIM Ball Shifter Base Kit

### Step 8:

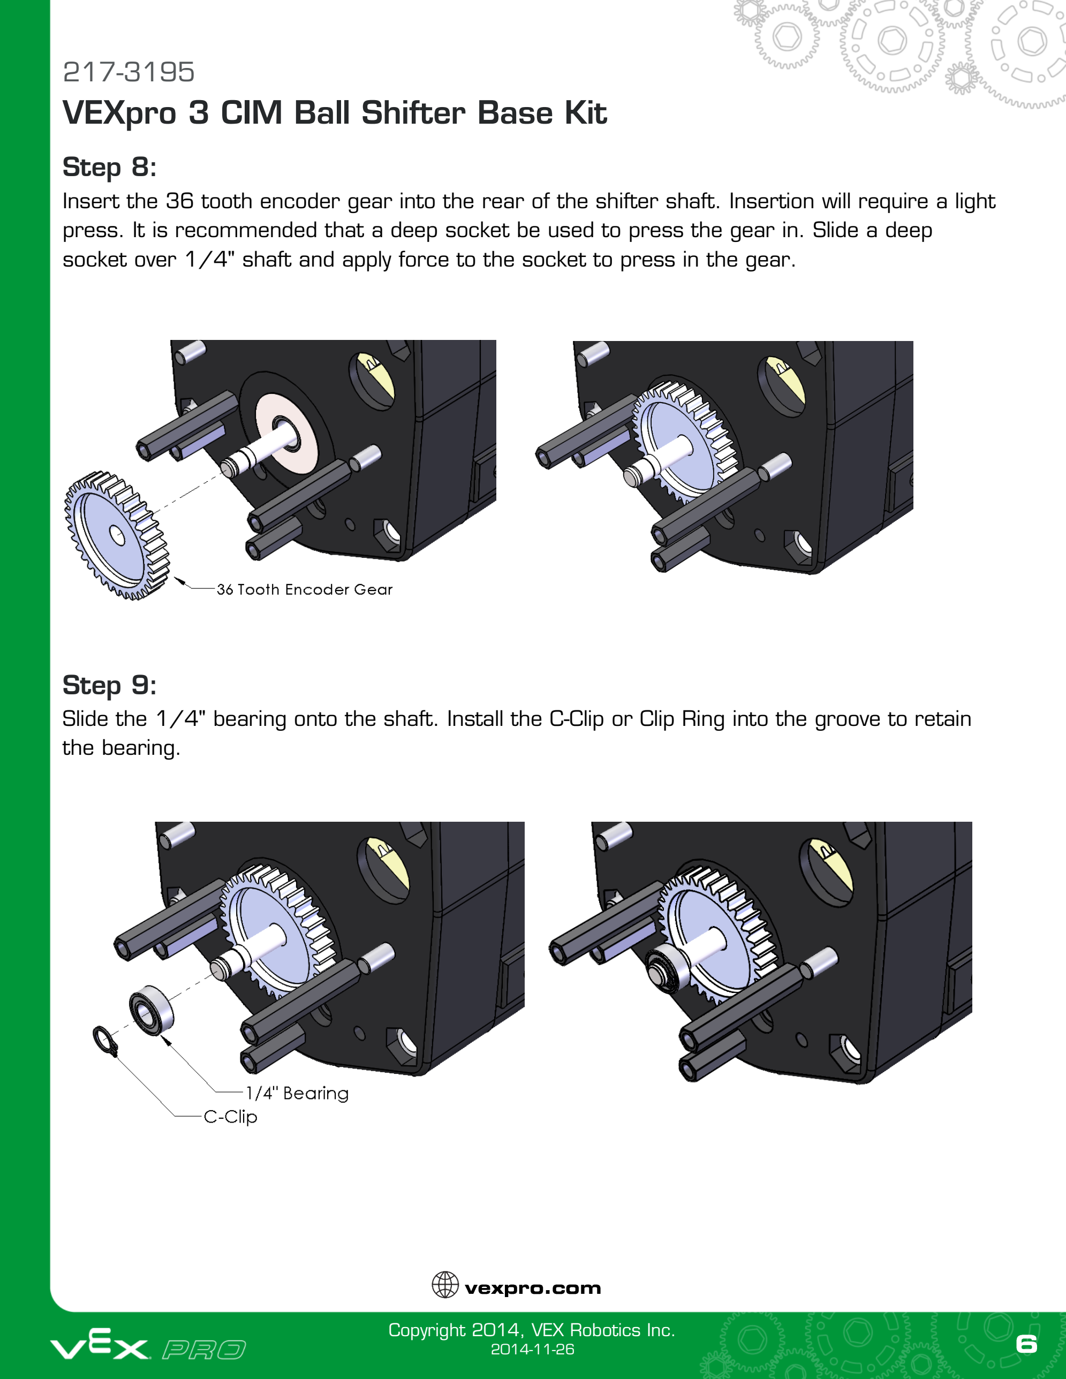
[picture p208: page 6]

Insert the 36 tooth encoder gear into the rear of the shifter shaft. Insertion will require a light press. It is recommended that a deep socket be used to press the gear in. Slide a deep socket over 1/4" shaft and apply force to the socket to press in the gear.

### Step 9:

Slide the 1/4" bearing onto the shaft. Install the C-Clip or Clip Ring into the groove to retain the bearing.

## VEXpro 3 CIM Ball Shifter Base Kit

### Step 10:

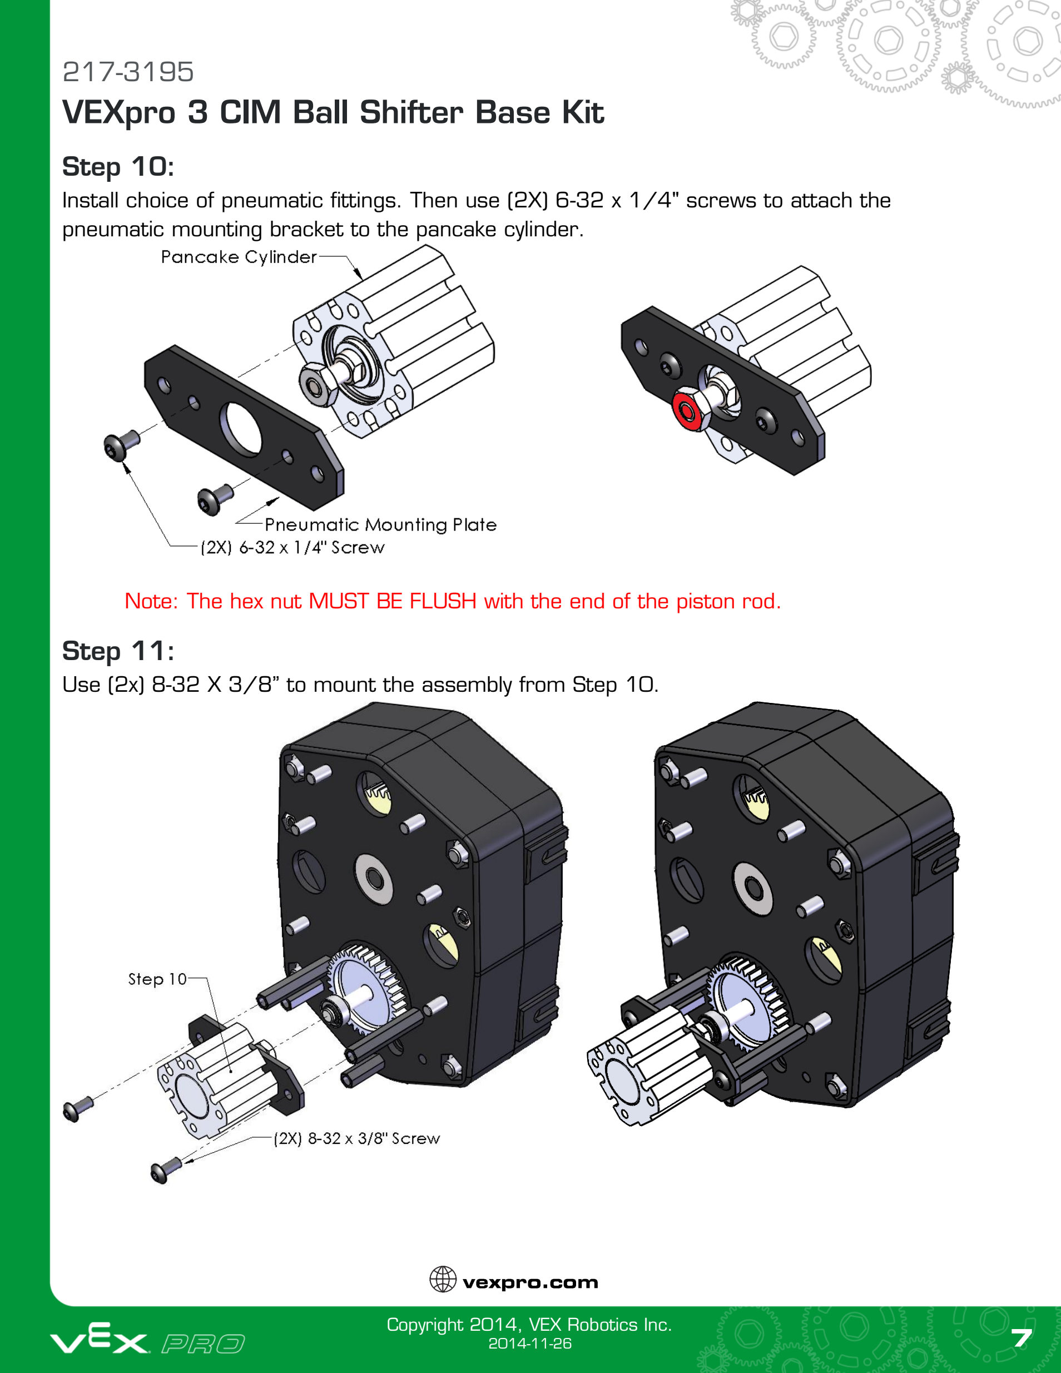
[picture p209: page 7]

Install choice of pneumatic fittings. Then use (2X) 6-32 x 1/4" screws to attach the pneumatic mounting bracket to the pancake cylinder.

Note: The hex nut MUST BE FLUSH with the end of the piston rod.

### Step 11:

Use (2x) 8-32 X 3/8” to mount the assembly from Step 10.

## VEXpro 3 CIM Ball Shifter Base Kit

### Step 12:

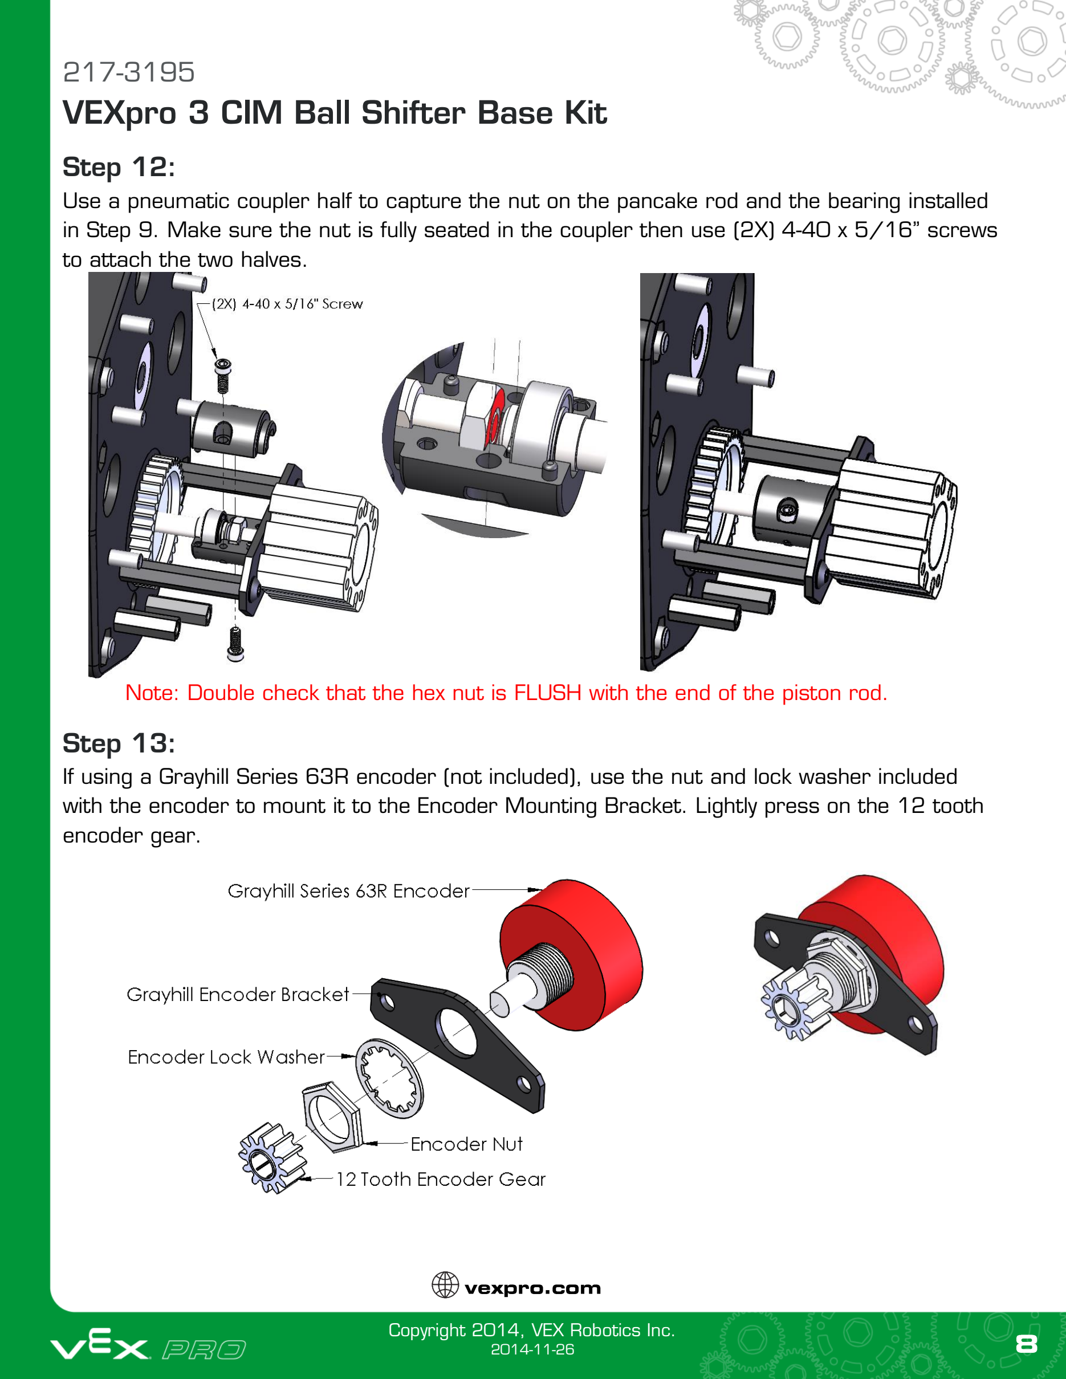
[picture p210: page 8]

Use a pneumatic coupler half to capture the nut on the pancake rod and the bearing installed in Step 9. Make sure the nut is fully seated in the coupler then use (2X) 4-40 x 5/16” screws to attach the two halves.

Note: Double check that the hex nut is FLUSH with the end of the piston rod.

### Step 13:

If using a Grayhill Series 63R encoder (not included), use the nut and lock washer included with the encoder to mount it to the Encoder Mounting Bracket. Lightly press on the 12 tooth encoder gear.

## VEXpro 3 CIM Ball Shifter Base Kit

### Step 14:

Use (2X) 8-32 x 3/8” screws to mount the encoder assembly from step 13. After the encoder is mounted, adjust the position of the 12 tooth encoder gear to ensure that it is not rubbing on the back shifter housing.

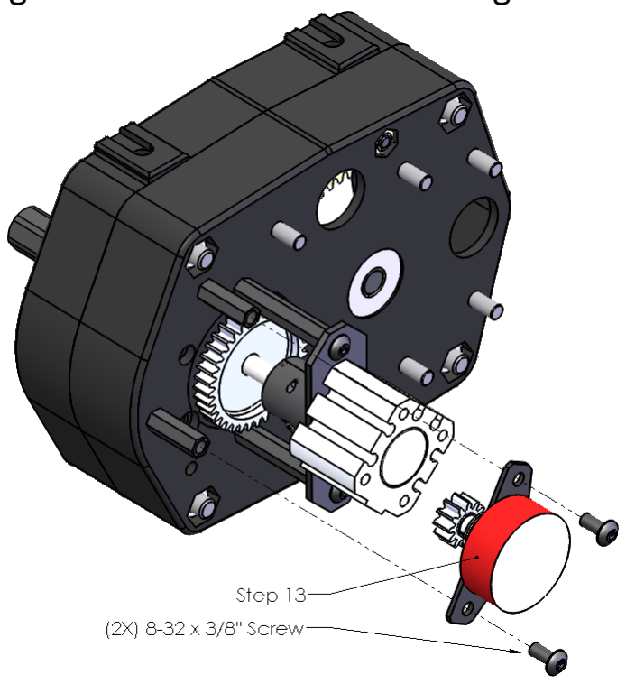
[picture p211: figure]
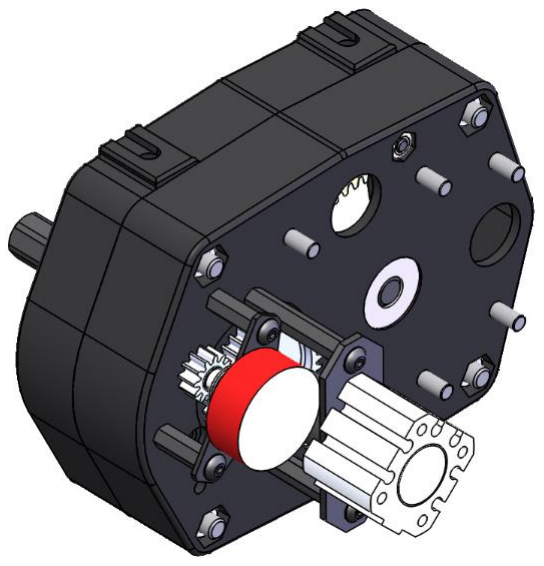
[picture p212: figure]

Note: For every 1 revolution of the output shaft the encoder will make 3 revolutions.

### Step 15:

Insert a 2mm key into the keyway of the motor and slide the 11 or 12 tooth CIM pinion gear on. The pinion gear is retained by the front and back shifter housing. Do not use a retaining ring or collar.

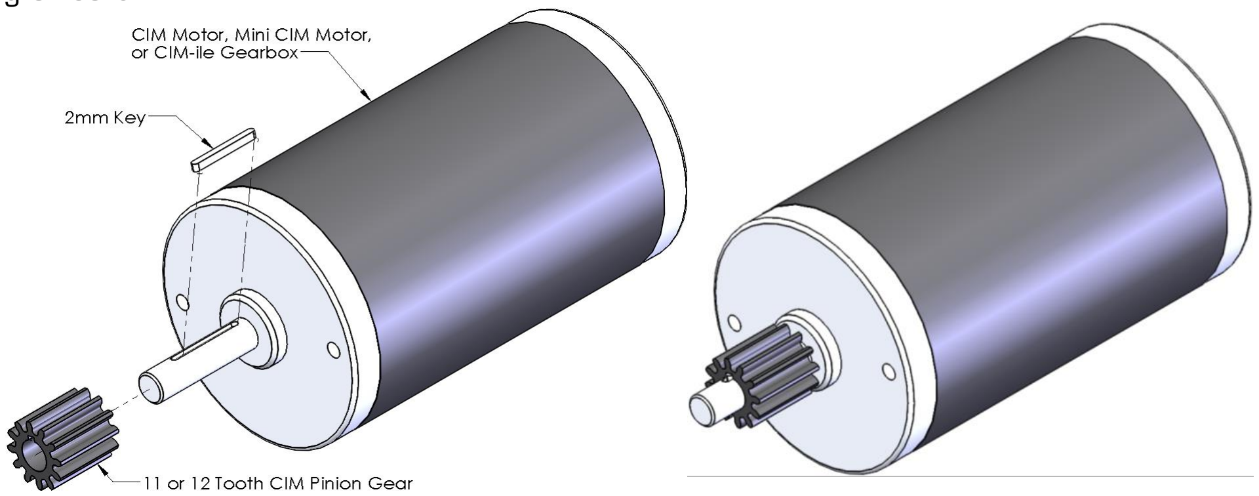
[picture p213: figure]

Note: No retaining ring or collar is needed. Using a retaining collar will bind the gearbox.

## VEXpro 3 CIM Ball Shifter Base Kit

### Step 16:

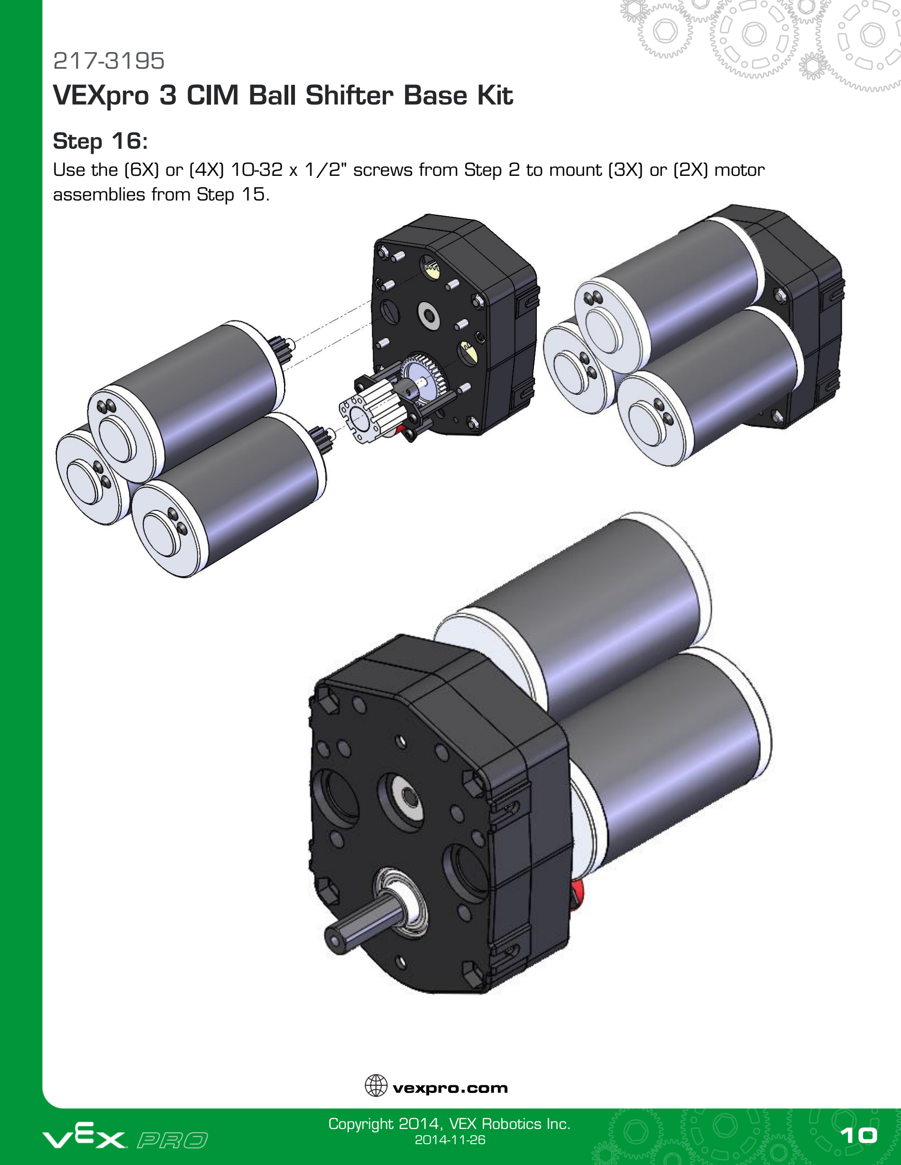
[picture p214: page 10]

Use the (6X) or (4X) 10-32 x 1/2" screws from Step 2 to mount (3X) or (2X) motor assemblies from Step 15.
