SnoBotics981/CAD-MfgResources/Andy-Mark/Linear Actuators/DART 6 in Actuator AM-3076a/am-3072_Assembly_DirectionsRev4.pdf

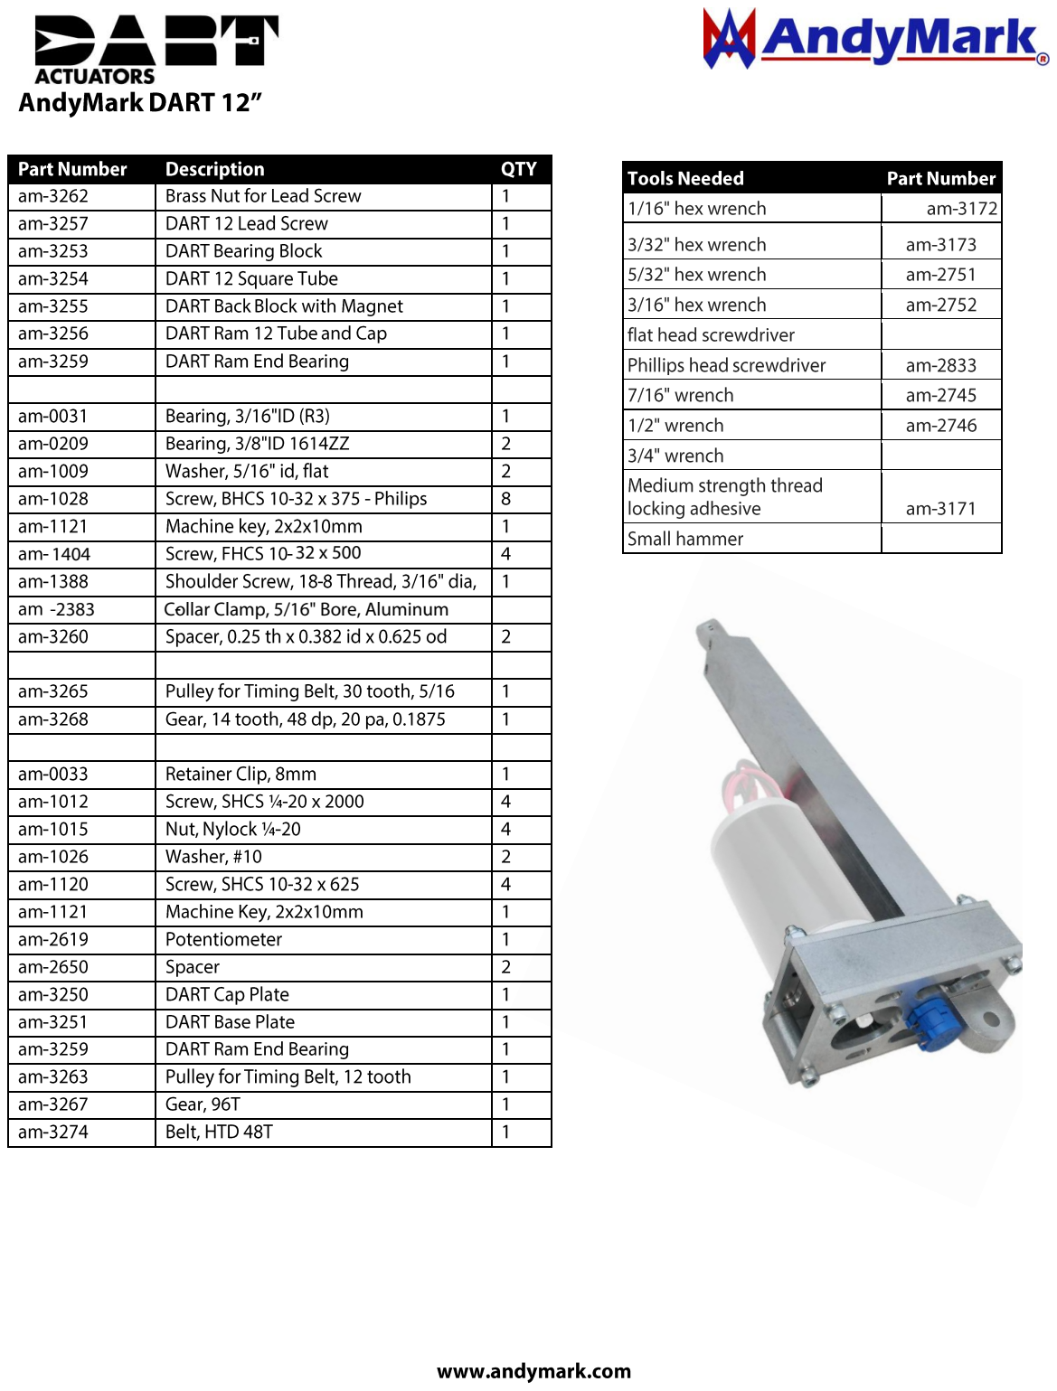
[picture p290: page 1]

-2383 | Collar Clamp, 5/16" Bore, Aluminum
1404 | 32 x 500

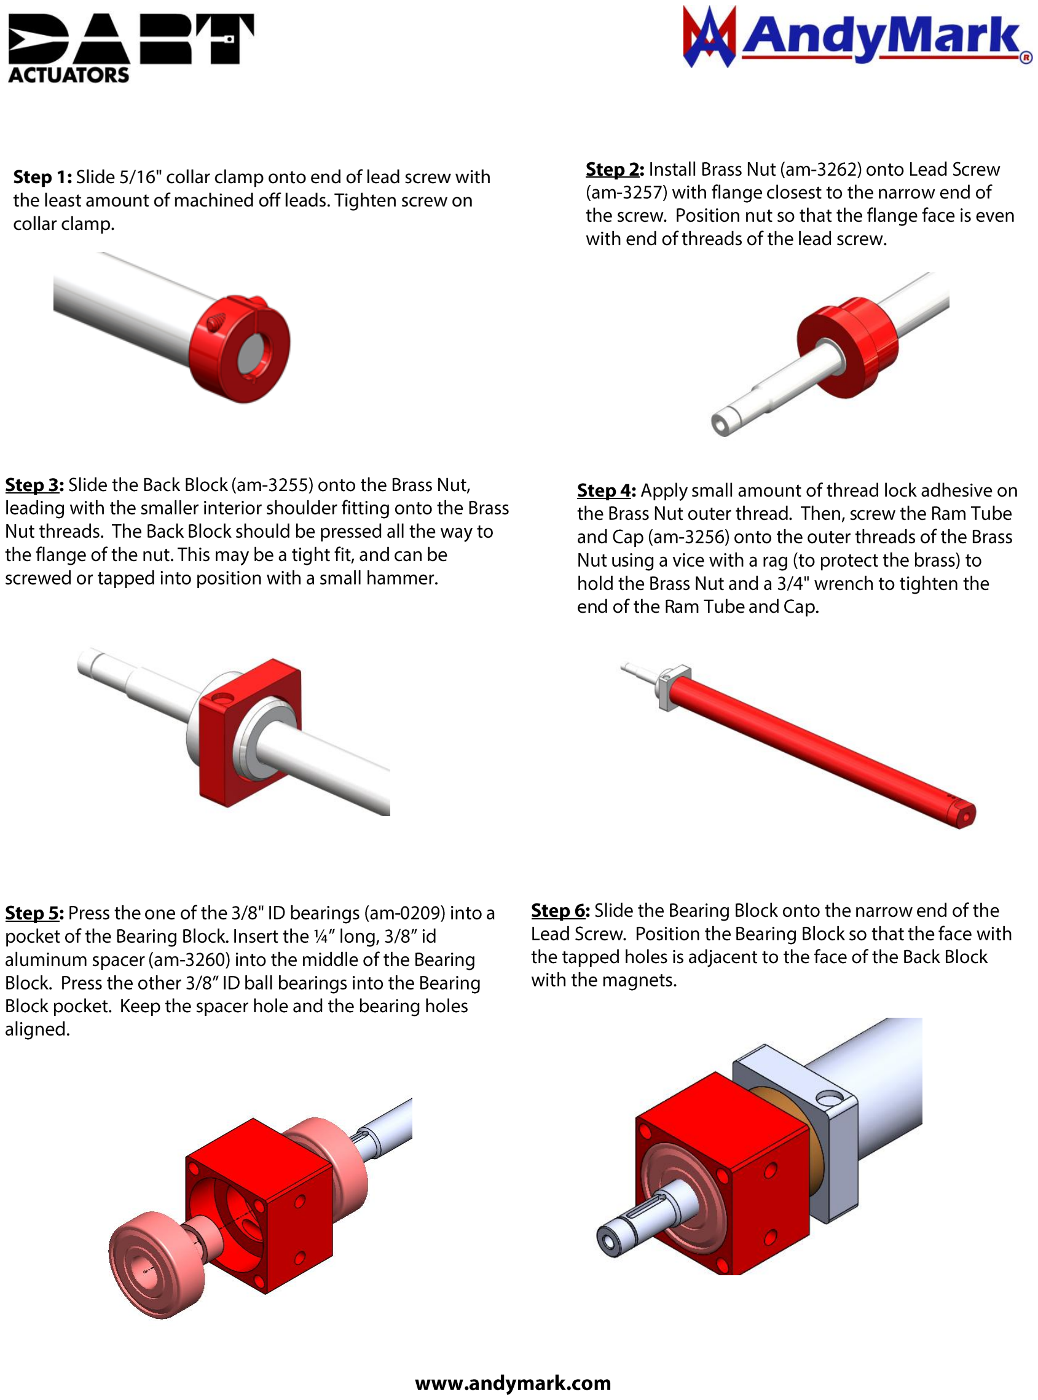
[picture p291: page 2]

Step 1: Slide 5/16" collar clamp onto end of lead screw with the least amount of machined off leads. Tighten screw on collar clamp.

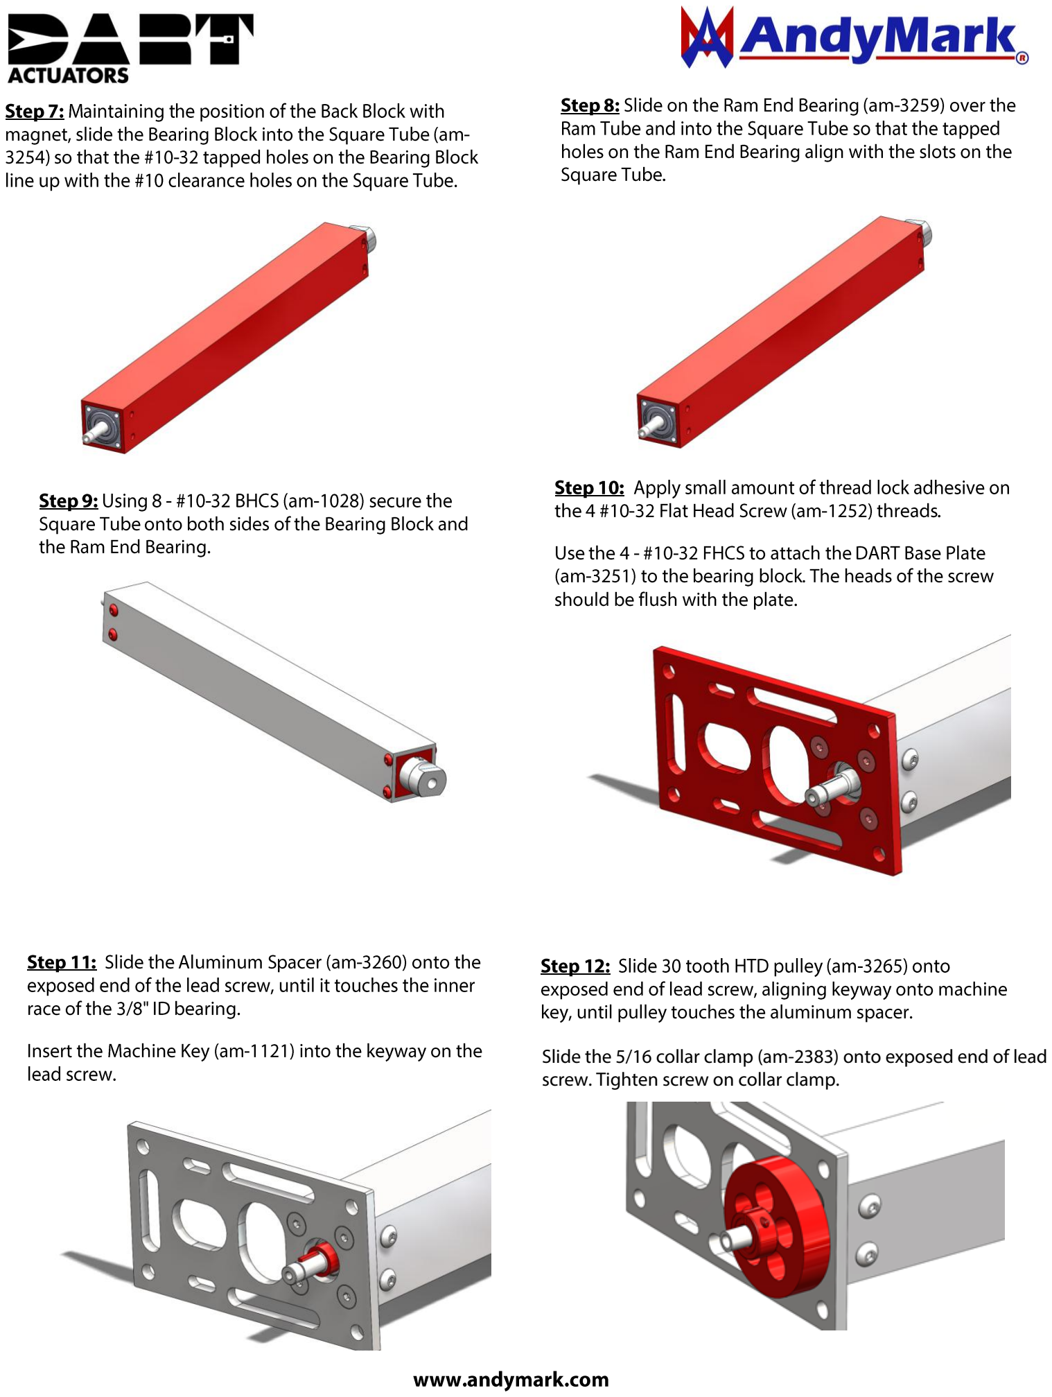
[picture p292: page 3]

Slide the 5/16 collar clamp (am-2383) onto exposed end of lead screw. Tighten screw on collar clamp.

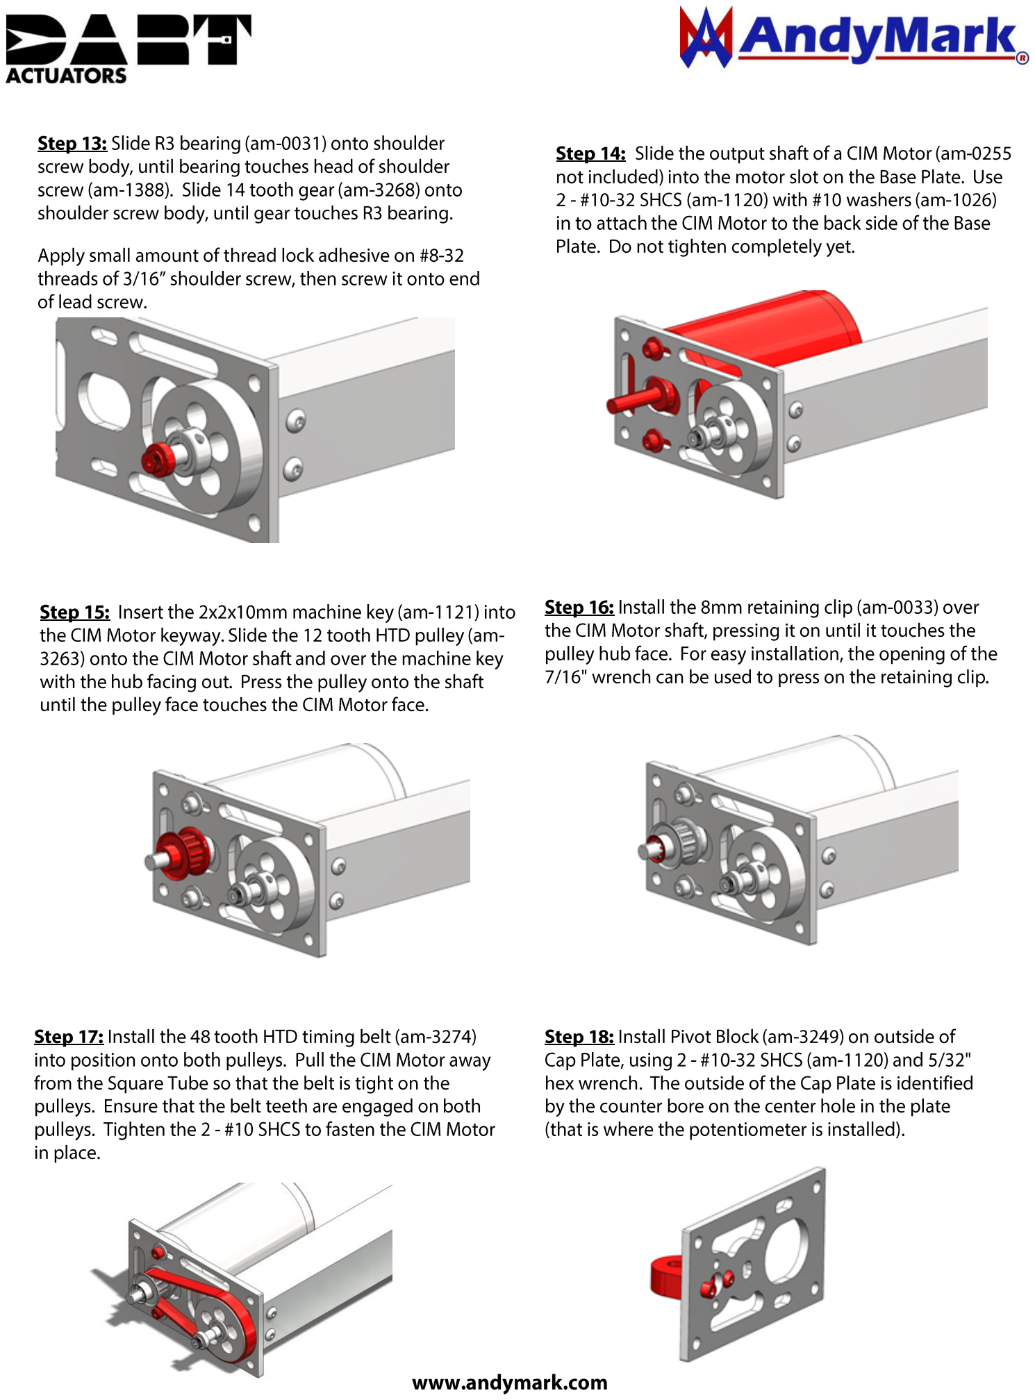
[picture p293: page 4]
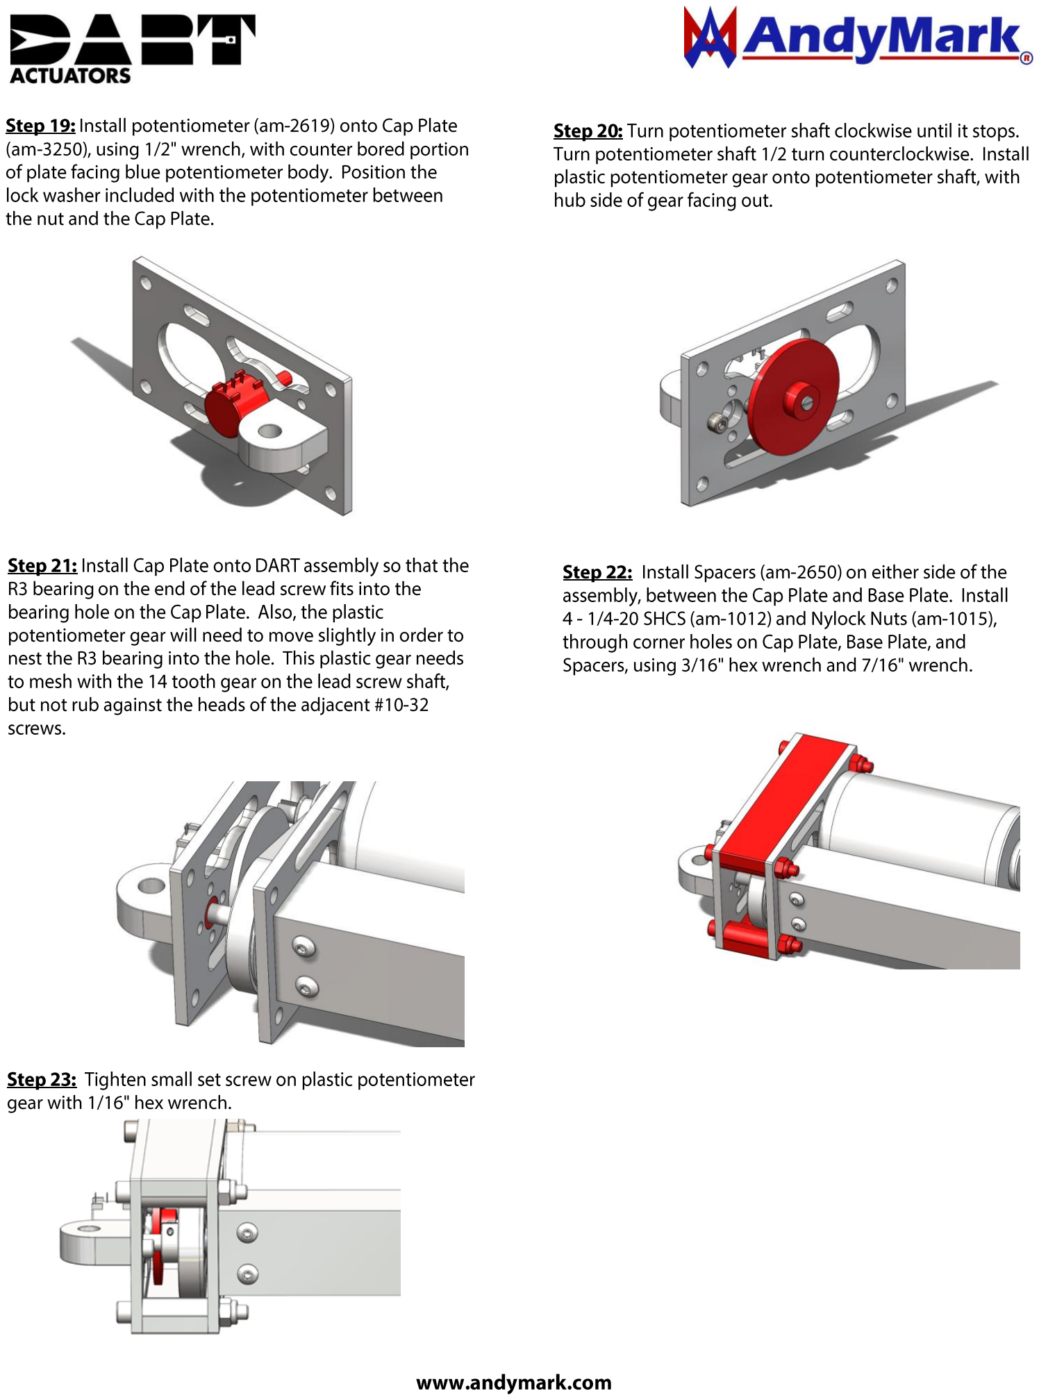
[picture p294: page 5]
