SnoBotics981/CAD-MfgResources/Andy-Mark/EncoderKit-AM-3132/am-2899+LabVIEW+Tutorial+Snippet+(Begin.vi).png

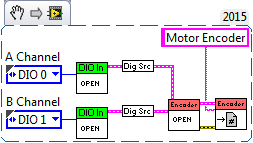
Andy-Mark/EncoderKit-AM-3132/am-2899+LabVIEW+Tutorial+Snippet+(Begin.vi).png
