SnoBotics981/CAD-MfgResources/ThingiVerse/Soldering_Iron_Stand_-_DotScott1_Remix-2088796/images/4c2e3992879bc23dd4225952afde8816_preview_featured.jpg

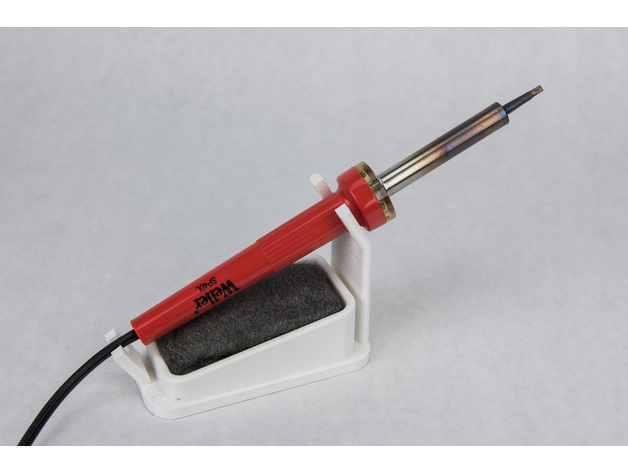
ThingiVerse/Soldering_Iron_Stand_-_DotScott1_Remix-2088796/images/4c2e3992879bc23dd4225952afde8816_preview_featured.jpg
