SnoBotics981/CAD-MfgResources/ThingiVerse/Soldering_Iron_Stand_-_DotScott1_Remix-2088796/images/dc79acff252af981a68bf14ac50eb5ad_preview_featured.jpg

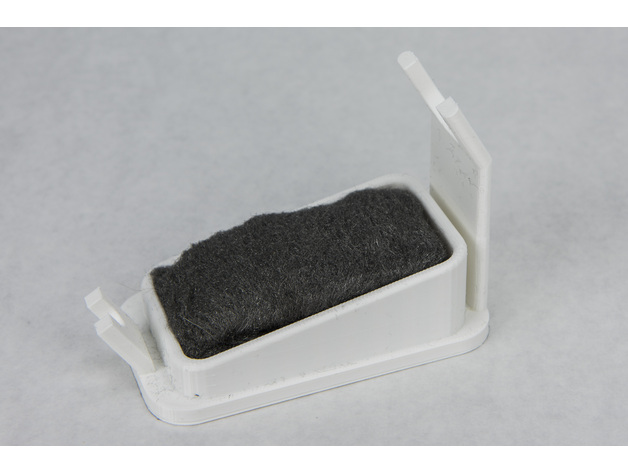
ThingiVerse/Soldering_Iron_Stand_-_DotScott1_Remix-2088796/images/dc79acff252af981a68bf14ac50eb5ad_preview_featured.jpg
