SnoBotics981/CAD-MfgResources/Andy-Mark/2017 Kit Bot Chassis/am-14u3_Cut_8inch.PDF

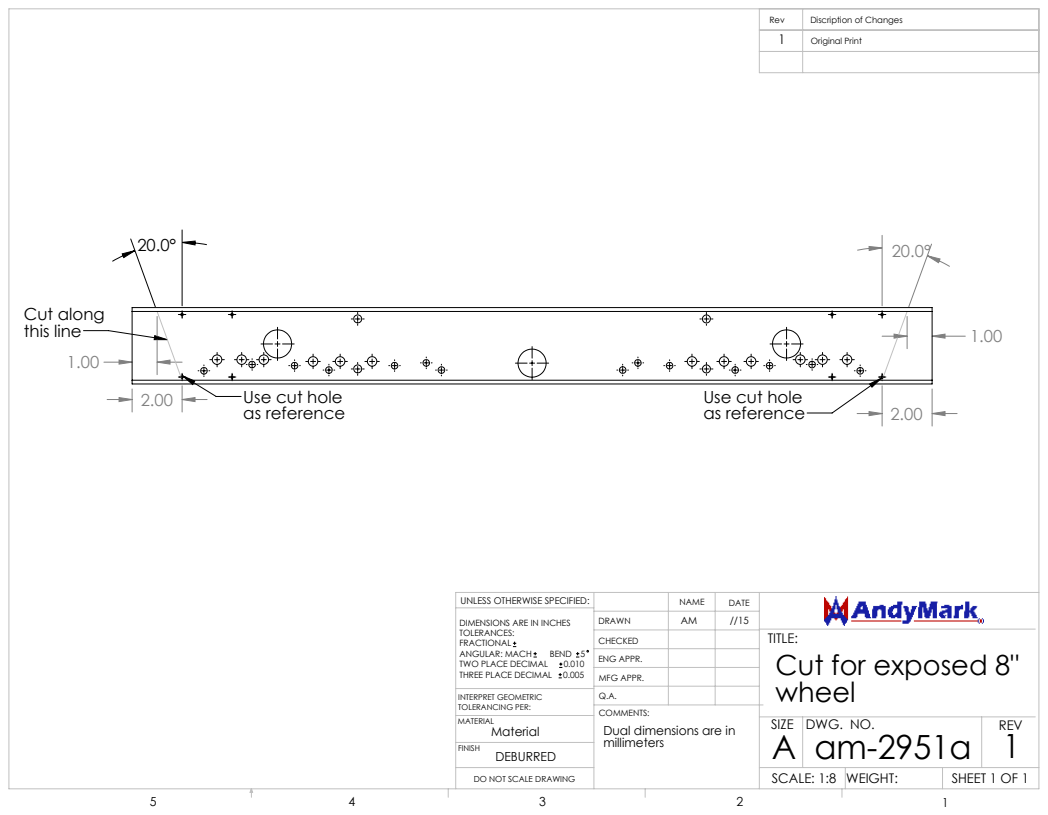
[picture p320: page 1]
Cut along this line; Cut for exposed 8"; SHEET 1 OF 1; SCALE: 1:8 WEIGHT:; DWG. NO.; REV; INTERPRET GEOMETRIC TOLERANCING PER:; ANGULAR: MACH; BEND 5; TWO PLACE DECIMAL; Rev; Discription of Changes; Original Print

Use cut hole
as reference

UNLESS OTHERWISE SPECIFIED:

DIMENSIONS ARE IN INCHES
TOLERANCES:
FRACTIONAL
THREE PLACE DECIMAL 0.005

DRAWN
CHECKED
ENG APPR.
MFG APPR.
COMMENTS:
Dual dimensions are in
millimeters

DO NOT SCALE DRAWING
