SnoBotics981/CAD-MfgResources/Andy-Mark/2017 RhinoBumperKit/am-3358 Rhino Bumper Wood Drilling Guide.PDF

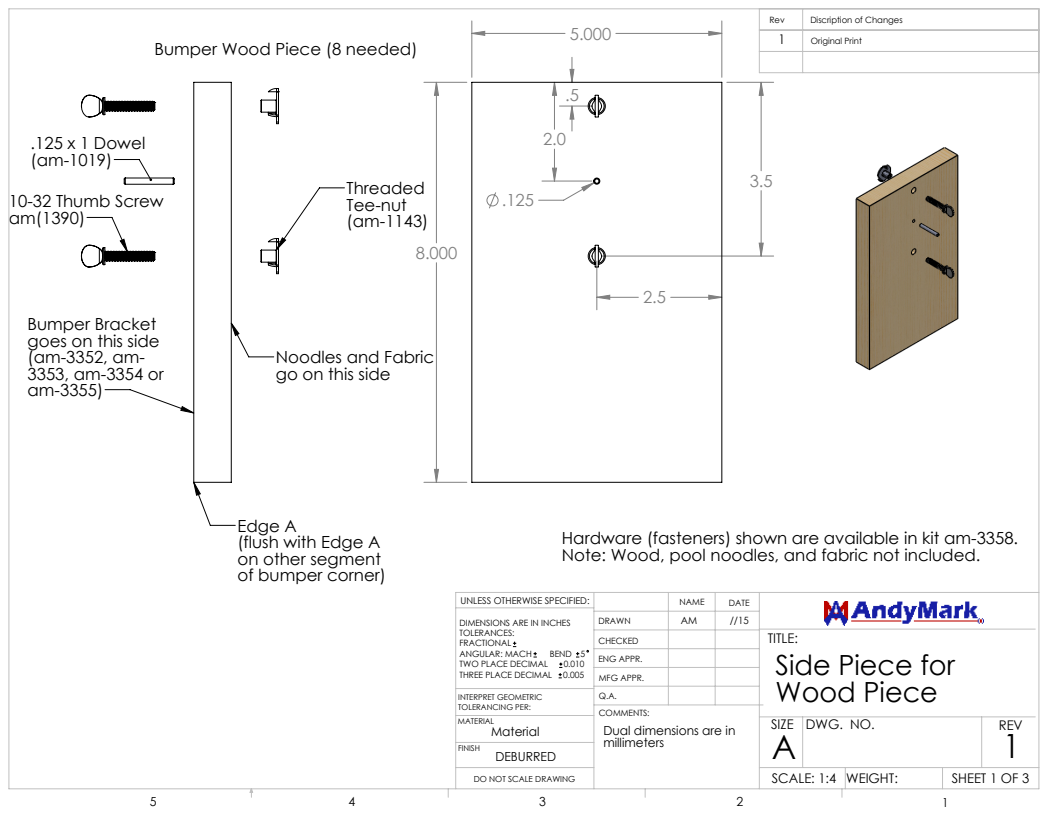
[picture p321: page 1]
10-32 Thumb Screw; .125 x 1 Dowel; SHEET 1 OF 3; SCALE: 1:4 WEIGHT:; DWG. NO.; REV; INTERPRET GEOMETRIC TOLERANCING PER:; ANGULAR: MACH; BEND 5; TWO PLACE DECIMAL; Rev; Discription of Changes; Original Print

Bumper Wood Piece (8 needed)

Bumper Bracket
goes on this side

Noodles and Fabric
go on this side

Edge A
(flush with Edge A
on other segment
of bumper corner)

Hardware (fasteners) shown are available in kit am-3358.
Note: Wood, pool noodles, and fabric not included.

UNLESS OTHERWISE SPECIFIED:

Side Piece for
Wood Piece

DIMENSIONS ARE IN INCHES
TOLERANCES:
FRACTIONAL
THREE PLACE DECIMAL 0.005

DRAWN
CHECKED
ENG APPR.
MFG APPR.
COMMENTS:
Dual dimensions are in
millimeters

DO NOT SCALE DRAWING

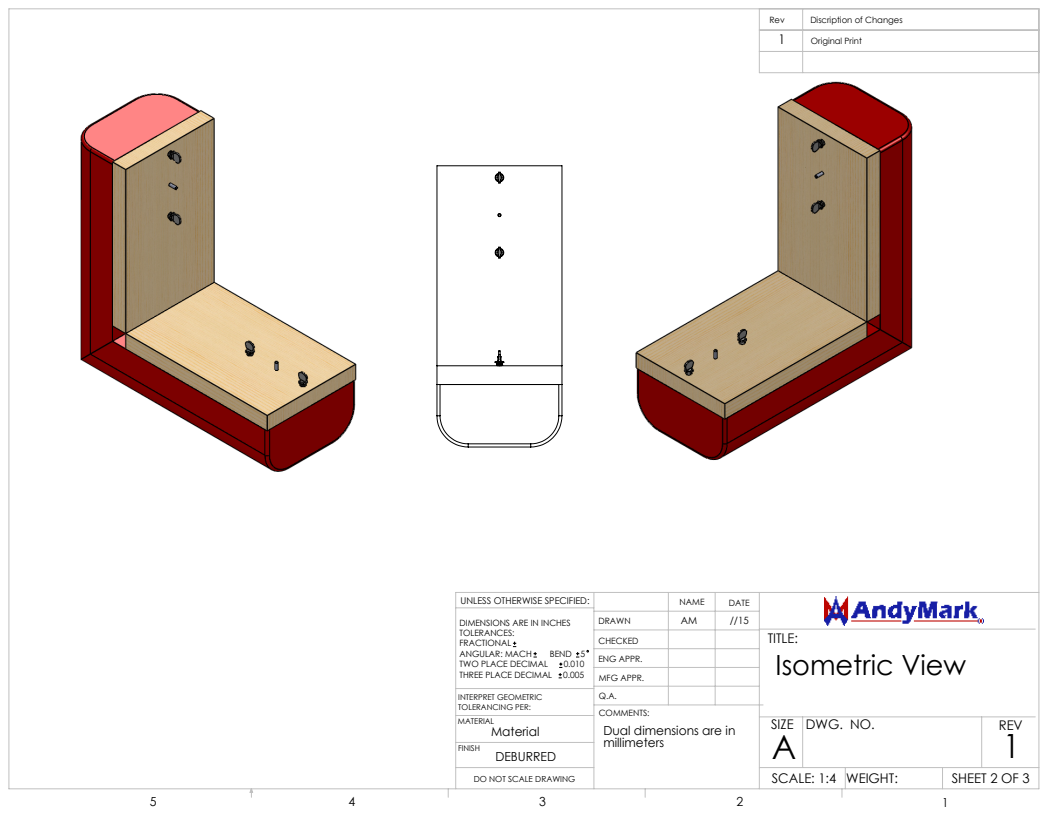
[picture p322: page 2]
Isometric View; SCALE: 1:4 WEIGHT:; DWG. NO.; REV; INTERPRET GEOMETRIC TOLERANCING PER:; ANGULAR: MACH; BEND 5; TWO PLACE DECIMAL

UNLESS OTHERWISE SPECIFIED:

DIMENSIONS ARE IN INCHES
TOLERANCES:
FRACTIONAL
THREE PLACE DECIMAL 0.005

DRAWN
CHECKED
ENG APPR.
MFG APPR.
COMMENTS:
Dual dimensions are in
millimeters

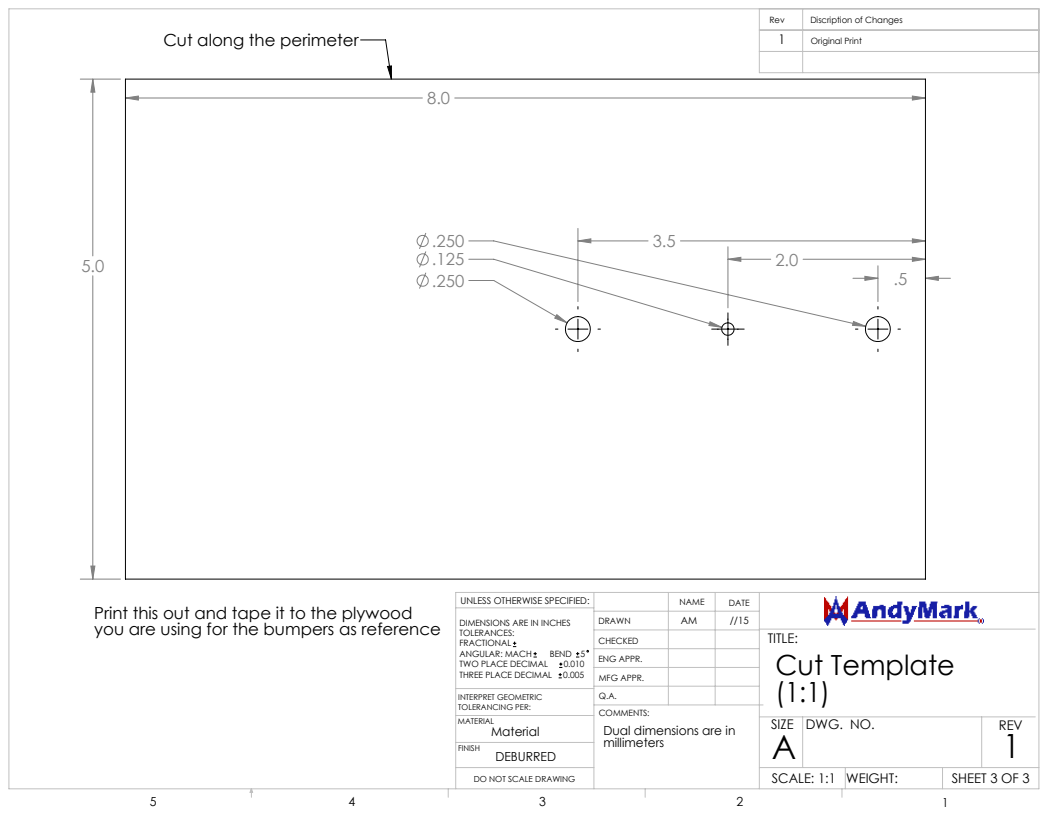
[picture p323: page 3]
Cut Template; SCALE: 1:1 WEIGHT:; DWG. NO.; REV; INTERPRET GEOMETRIC TOLERANCING PER:; ANGULAR: MACH; BEND 5; TWO PLACE DECIMAL

Cut along the perimeter

UNLESS OTHERWISE SPECIFIED:

Print this out and tape it to the plywood
you are using for the bumpers as reference

DIMENSIONS ARE IN INCHES
TOLERANCES:
FRACTIONAL
THREE PLACE DECIMAL 0.005

DRAWN
CHECKED
ENG APPR.
MFG APPR.
COMMENTS:
Dual dimensions are in
millimeters
