SnoBotics981/CAD-MfgResources/VexRobotics/PlanetaryGearboxInstructions/217-VersaPlanetary-Motor-Mounting-Procedure-20170703.PDF

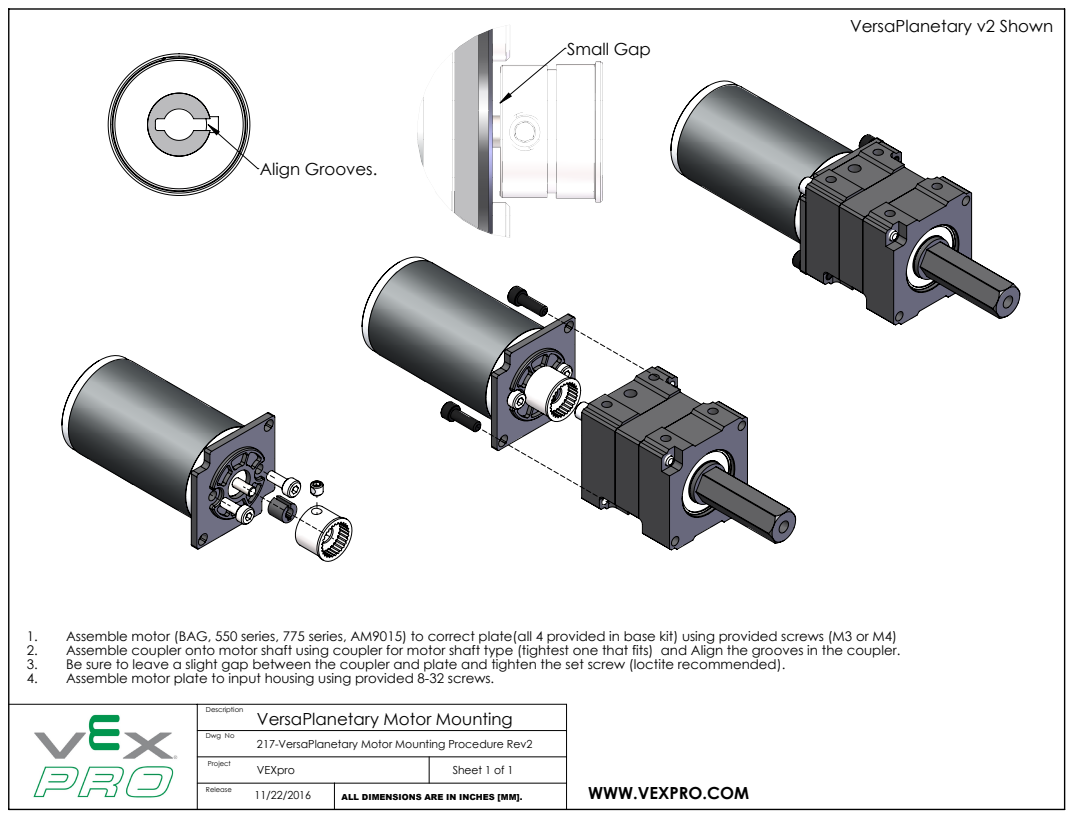
[picture p324: page 1]
Align Grooves.; VersaPlanetary v2 Shown; Small Gap

1. Assemble motor (BAG, 550 series, 775 series, AM9015) to correct plate(all 4 provided in base kit) using provided screws (M3 or M4)
2. Assemble coupler onto motor shaft using coupler for motor shaft type (tightest one that fits) and Align the grooves in the coupler.
3. Be sure to leave a slight gap between the coupler and plate and tighten the set screw (loctite recommended).
4. Assemble motor plate to input housing using provided 8-32 screws.

Description
VersaPlanetary Motor Mounting

217-VersaPlanetary Motor Mounting Procedure Rev2 Dwg No

Project VEXpro | Sheet 1 of 1
Release 11/22/2016 | ALL DIMENSIONS ARE IN INCHES [MM].

WWW.VEXPRO.COM
