SnoBotics981/CAD-MfgResources/VexRobotics/PlanetaryGearboxInstructions/VersaPlanetary-Ratio-Identification-Guide.PDF

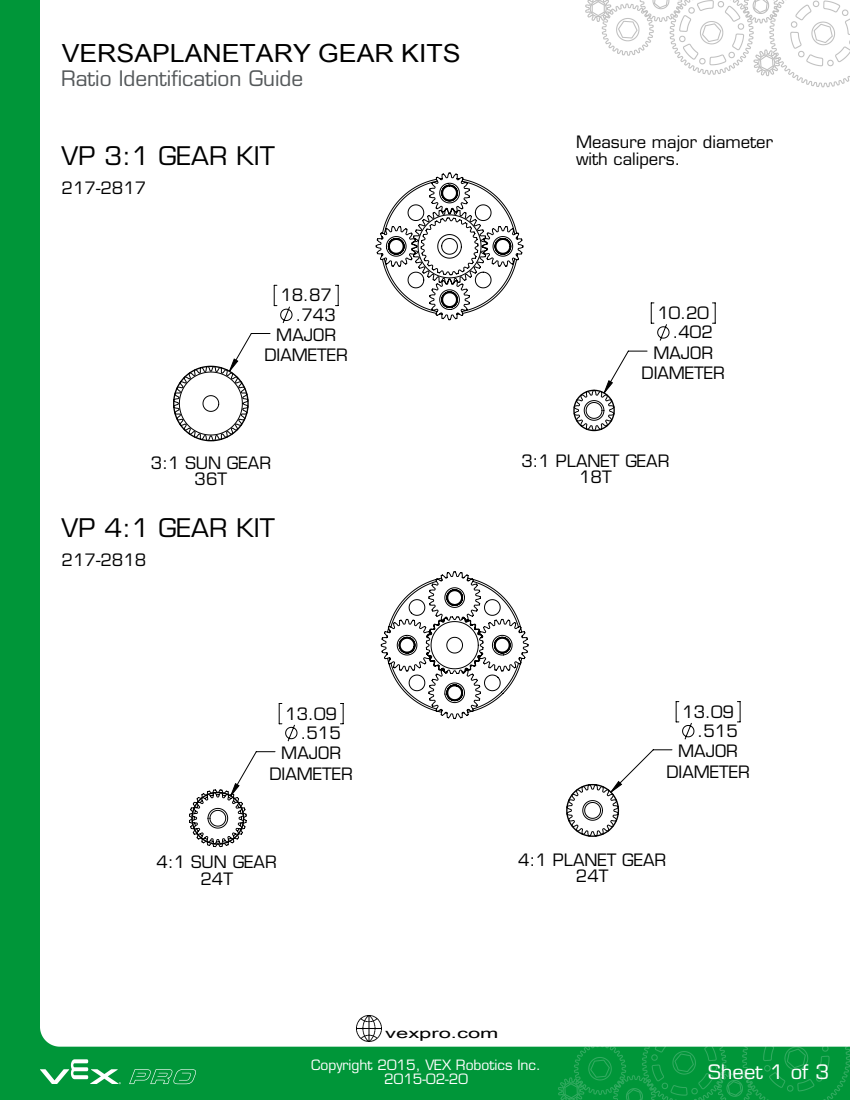
[picture p325: page 1]
3:1 SUN GEAR; 3:1 PLANET GEAR; 4:1 SUN GEAR; 4:1 PLANET GEAR

VERSAPLANETARY GEAR KITS
Ratio Identification Guide

Measure major diameter
with calipers.

VP 3:1 GEAR KIT

VP 4:1 GEAR KIT

Sheet 1 of 3 Copyright 2015, VEX Robotics Inc.

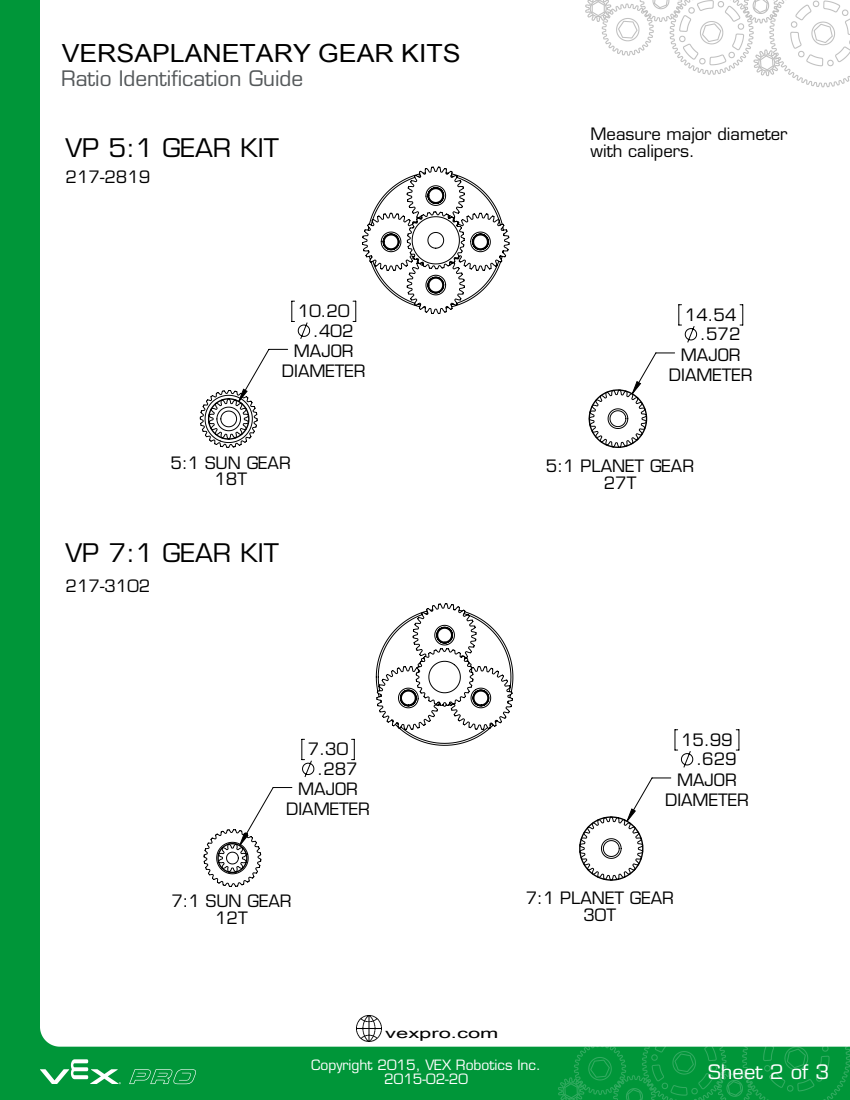
[picture p326: page 2]
5:1 SUN GEAR; 5:1 PLANET GEAR; 7:1 PLANET GEAR; 7:1 SUN GEAR

Measure major diameter
with calipers.

VP 5:1 GEAR KIT

VP 7:1 GEAR KIT

Sheet 2 of 3 Copyright 2015, VEX Robotics Inc.

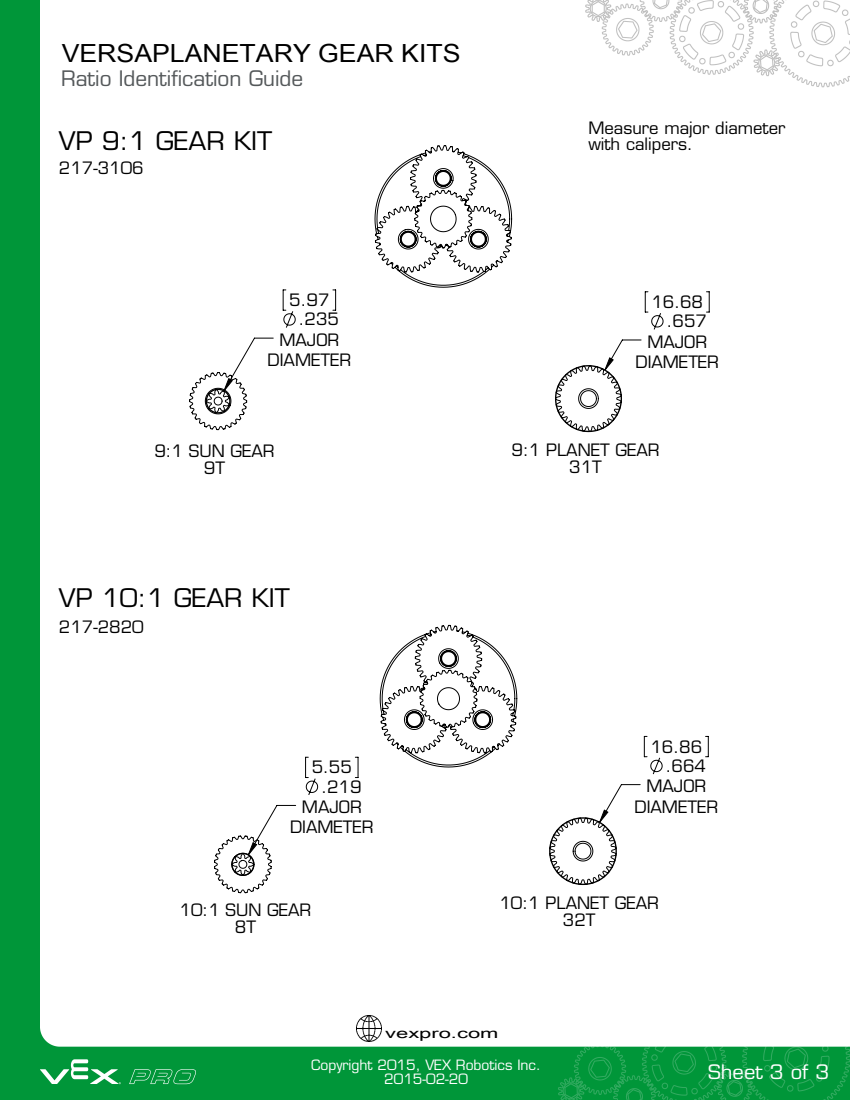
[picture p327: page 3]
9:1 SUN GEAR; 9:1 PLANET GEAR; 10:1 SUN GEAR; 10:1 PLANET GEAR

VP 9:1 GEAR KIT

Measure major diameter
with calipers.

VP 10:1 GEAR KIT

Sheet 3 of 3 Copyright 2015, VEX Robotics Inc.
