SnoBotics981/CAD-MfgResources/VexRobotics/217-2816-Drawing-20140212_2.PDF

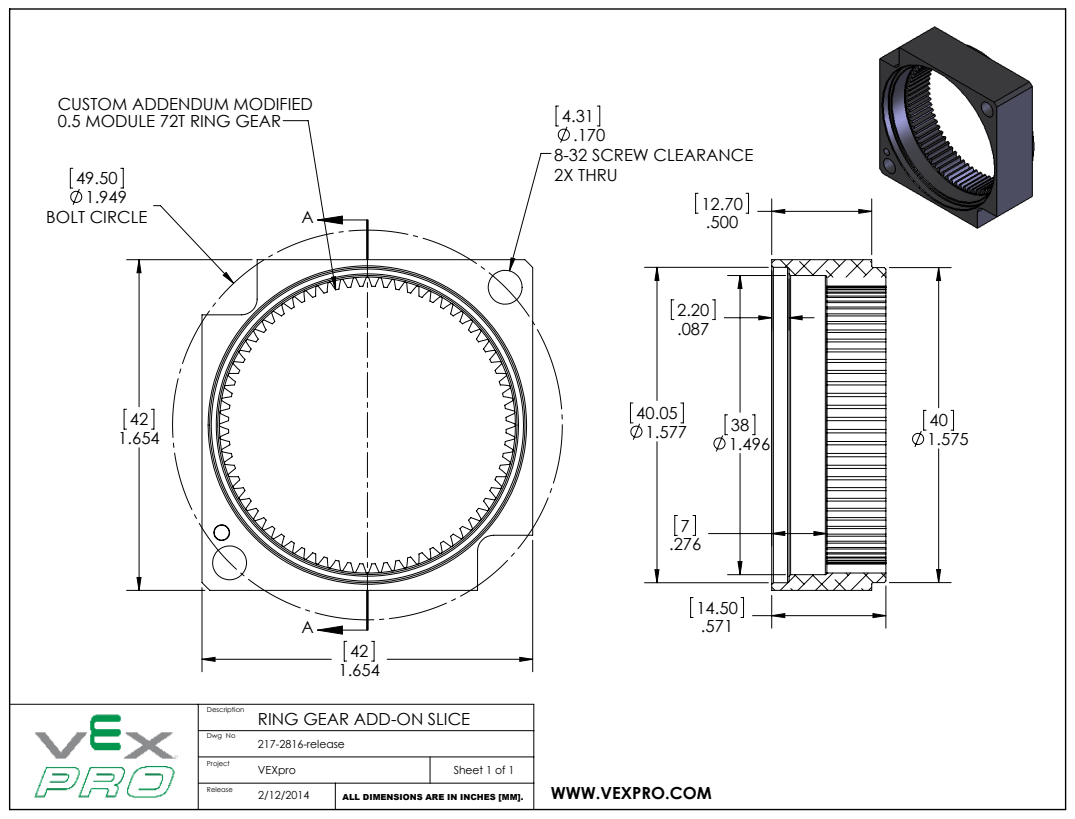
[picture p328: page 1]
8-32 SCREW CLEARANCE; 2X THRU; BOLT CIRCLE

CUSTOM ADDENDUM MODIFIED
0.5 MODULE 72T RING GEAR

Description
RING GEAR ADD-ON SLICE

217-2816-release Dwg No

Project VEXpro | Sheet 1 of 1
Release 2/12/2014 | ALL DIMENSIONS ARE IN INCHES [MM].

WWW.VEXPRO.COM
