SnoBotics981/CAD-MfgResources/VexRobotics/217-3141-Drawing-20140115.PDF

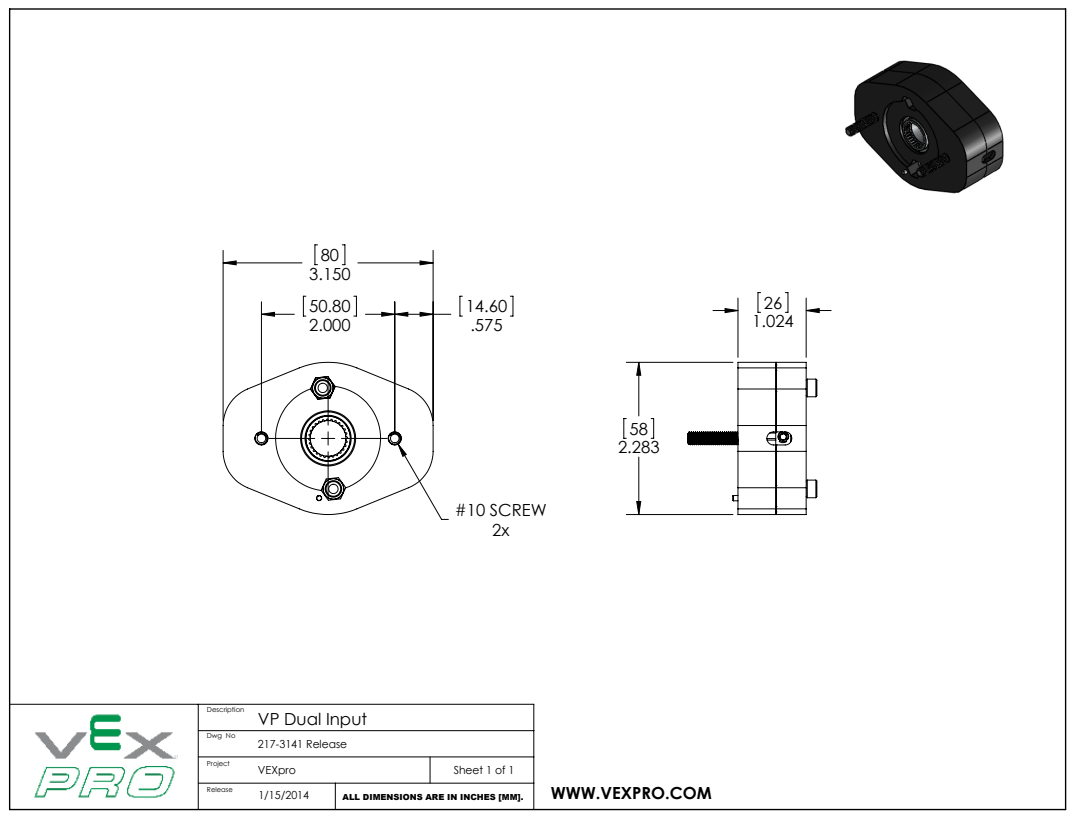
[picture p329: page 1]
#10 SCREW

Description
VP Dual Input

217-3141 Release Dwg No

Project VEXpro | Sheet 1 of 1
Release 1/15/2014 | ALL DIMENSIONS ARE IN INCHES [MM].

WWW.VEXPRO.COM
