SnoBotics981/CAD-MfgResources/VexRobotics/217-3564-Drawing-20140212.PDF

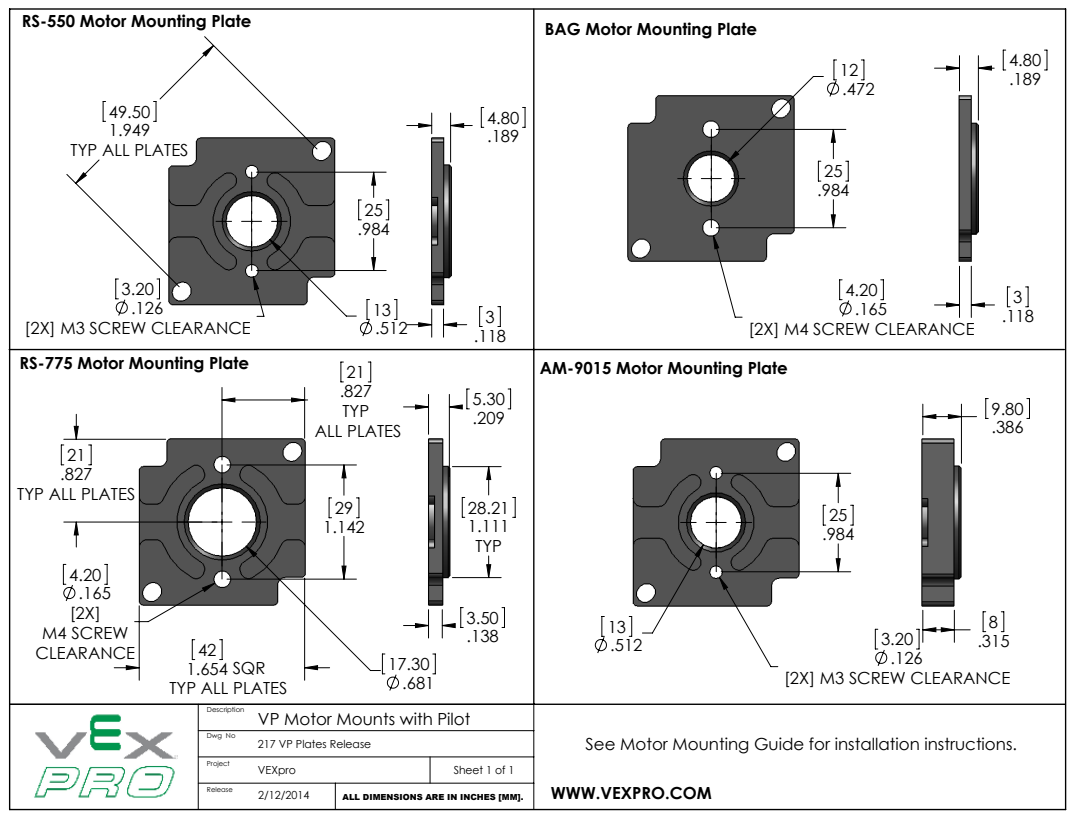
[picture p330: page 1]
TYP ALL PLATES; 1.654 SQR TYP ALL PLATES; M4 SCREW; ALL PLATES; [2X] M4 SCREW CLEARANCE; [2X] M3 SCREW CLEARANCE; AM-9015 Motor Mounting Plate; 217 VP Plates Release; See Motor Mounting Guide for installation instructions. Dwg No

RS-550 Motor Mounting Plate

BAG Motor Mounting Plate

[2X] M3 SCREW CLEARANCE
RS-775 Motor Mounting Plate

Description
VP Motor Mounts with Pilot

Project VEXpro | Sheet 1 of 1
Release 2/12/2014 | ALL DIMENSIONS ARE IN INCHES [MM].

WWW.VEXPRO.COM
