SnoBotics981/CAD-MfgResources/VexRobotics/217-4018-Drawing-20141016.PDF

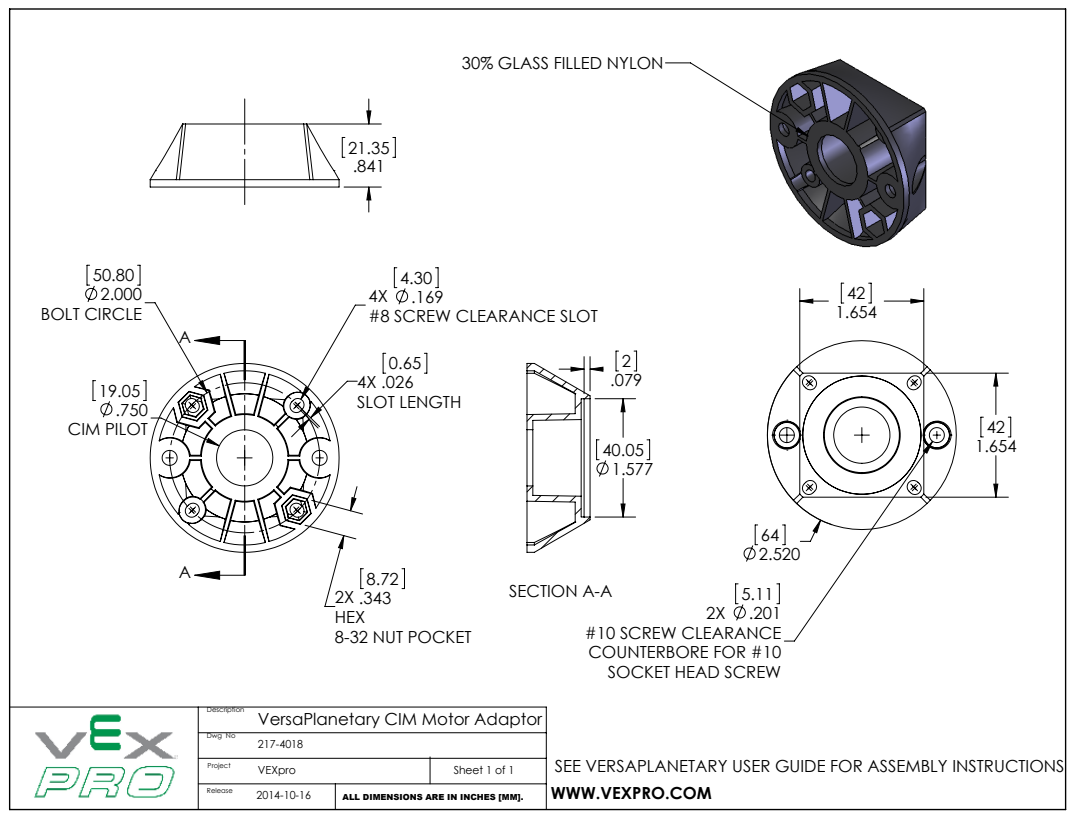
[picture p331: page 1]
CIM PILOT; #8 SCREW CLEARANCE SLOT; 8-32 NUT POCKET; SLOT LENGTH; BOLT CIRCLE; SECTION A-A; 217-4018 Dwg No

30% GLASS FILLED NYLON

#10 SCREW CLEARANCE
COUNTERBORE FOR #10
SOCKET HEAD SCREW

Description
VersaPlanetary CIM Motor Adaptor

SEE VERSAPLANETARY USER GUIDE FOR ASSEMBLY INSTRUCTIONS
WWW.VEXPRO.COM

Project VEXpro | Sheet 1 of 1
Release 2014-10-16 | ALL DIMENSIONS ARE IN INCHES [MM].
