SnoBotics981/CAD-MfgResources/VexRobotics/VersaPlanetary-Layout-Drawing-20140115.PDF

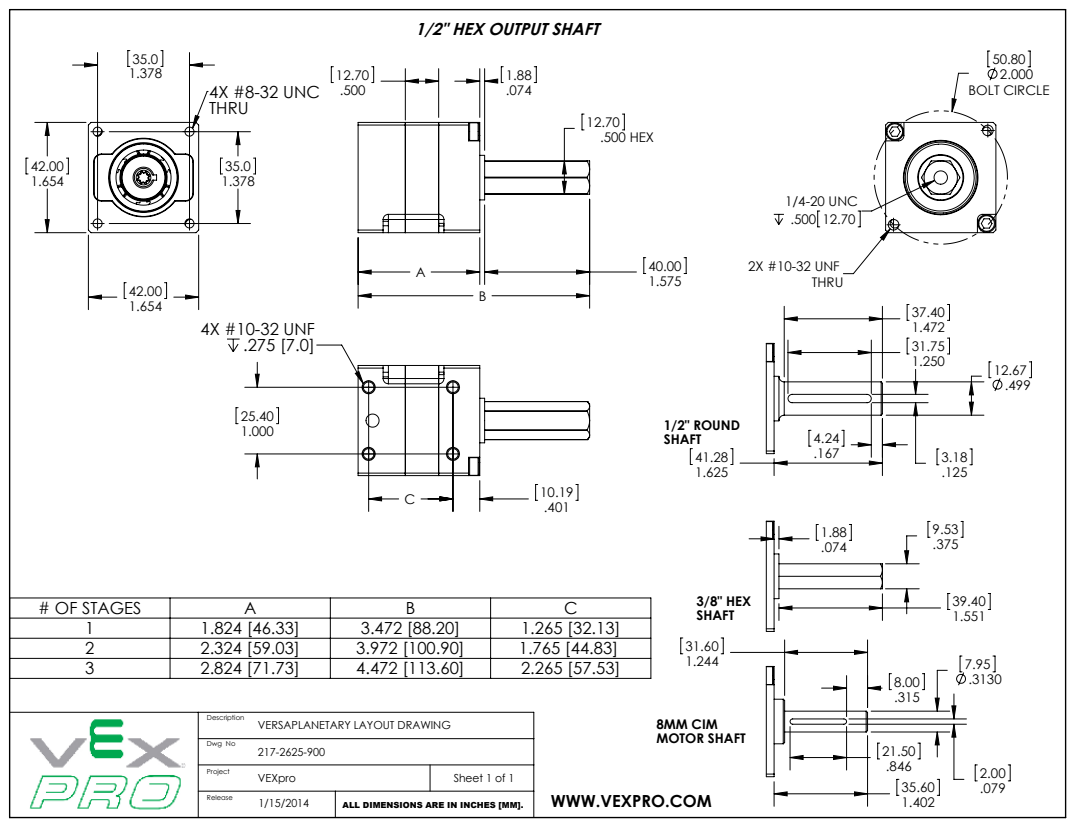
[picture p332: page 1]
.500 HEX; 4X #8-32 UNC; 2X #10-32 UNF; 1/4-20 UNC .500 12.70; BOLT CIRCLE; 4X #10-32 UNF .275 [7.0]; 1/2" ROUND; 3/8" HEX; 8MM CIM MOTOR SHAFT; Dwg No

1/2" HEX OUTPUT SHAFT

# OF STAGES | A | B | C
1 | 1.824 [46.33] | 3.472 [88.20] | 1.265 [32.13]
2 | 2.324 [59.03] | 3.972 [100.90] | 1.765 [44.83]
3 | 2.824 [71.73] | 4.472 [113.60] | 2.265 [57.53]

VERSAPLANETARY LAYOUT DRAWING

Project VEXpro | Sheet 1 of 1
Release 1/15/2014 | ALL DIMENSIONS ARE IN INCHES [MM].

WWW.VEXPRO.COM
