SnoBotics981/CAD-MfgResources/VexRobotics/VEXpro-VersaPlanetary-Output-Shafts-Drawing-20140124.PDF

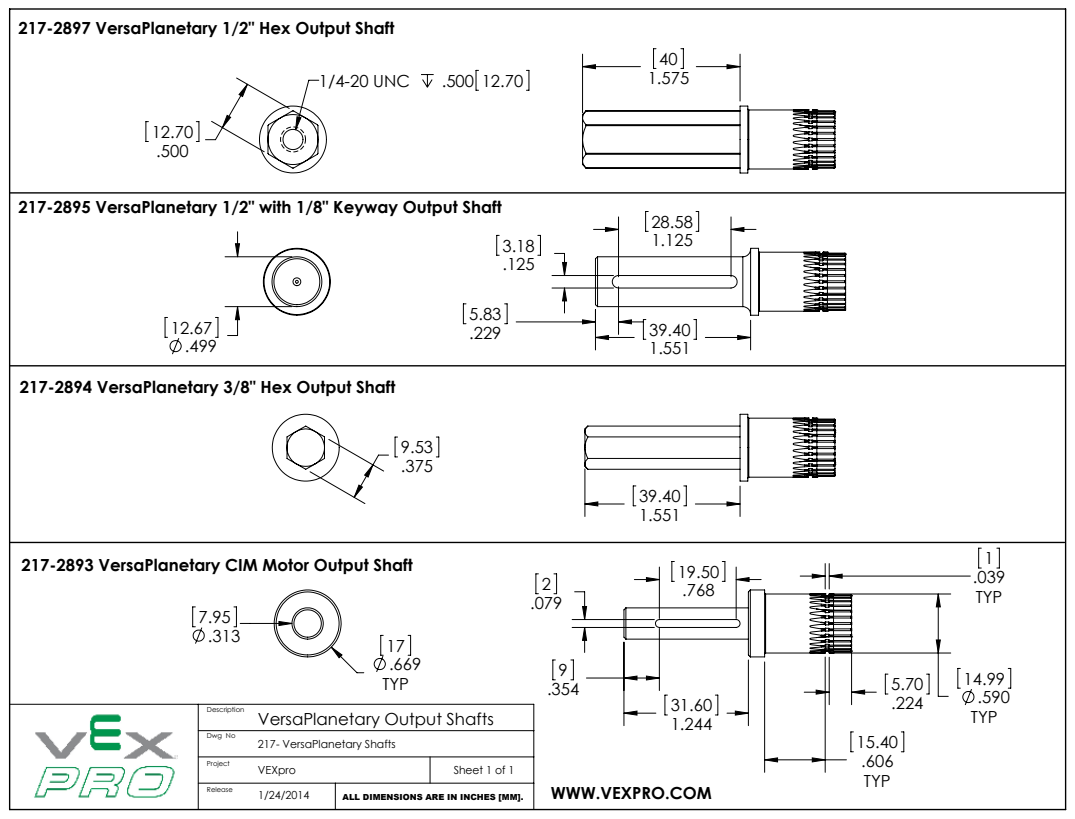
[picture p333: page 1]
1/4-20 UNC

217-2897 VersaPlanetary 1/2" Hex Output Shaft

217-2895 VersaPlanetary 1/2" with 1/8" Keyway Output Shaft

217-2894 VersaPlanetary 3/8" Hex Output Shaft

217-2893 VersaPlanetary CIM Motor Output Shaft

Description
VersaPlanetary Output Shafts

217- VersaPlanetary Shafts Dwg No

Project VEXpro | Sheet 1 of 1
Release 1/24/2014 | ALL DIMENSIONS ARE IN INCHES [MM].

WWW.VEXPRO.COM
