SnoBotics981/CAD-MfgResources/Andy-Mark/2020 Kit Bot/AM14U4_PW6 Layout.PDF

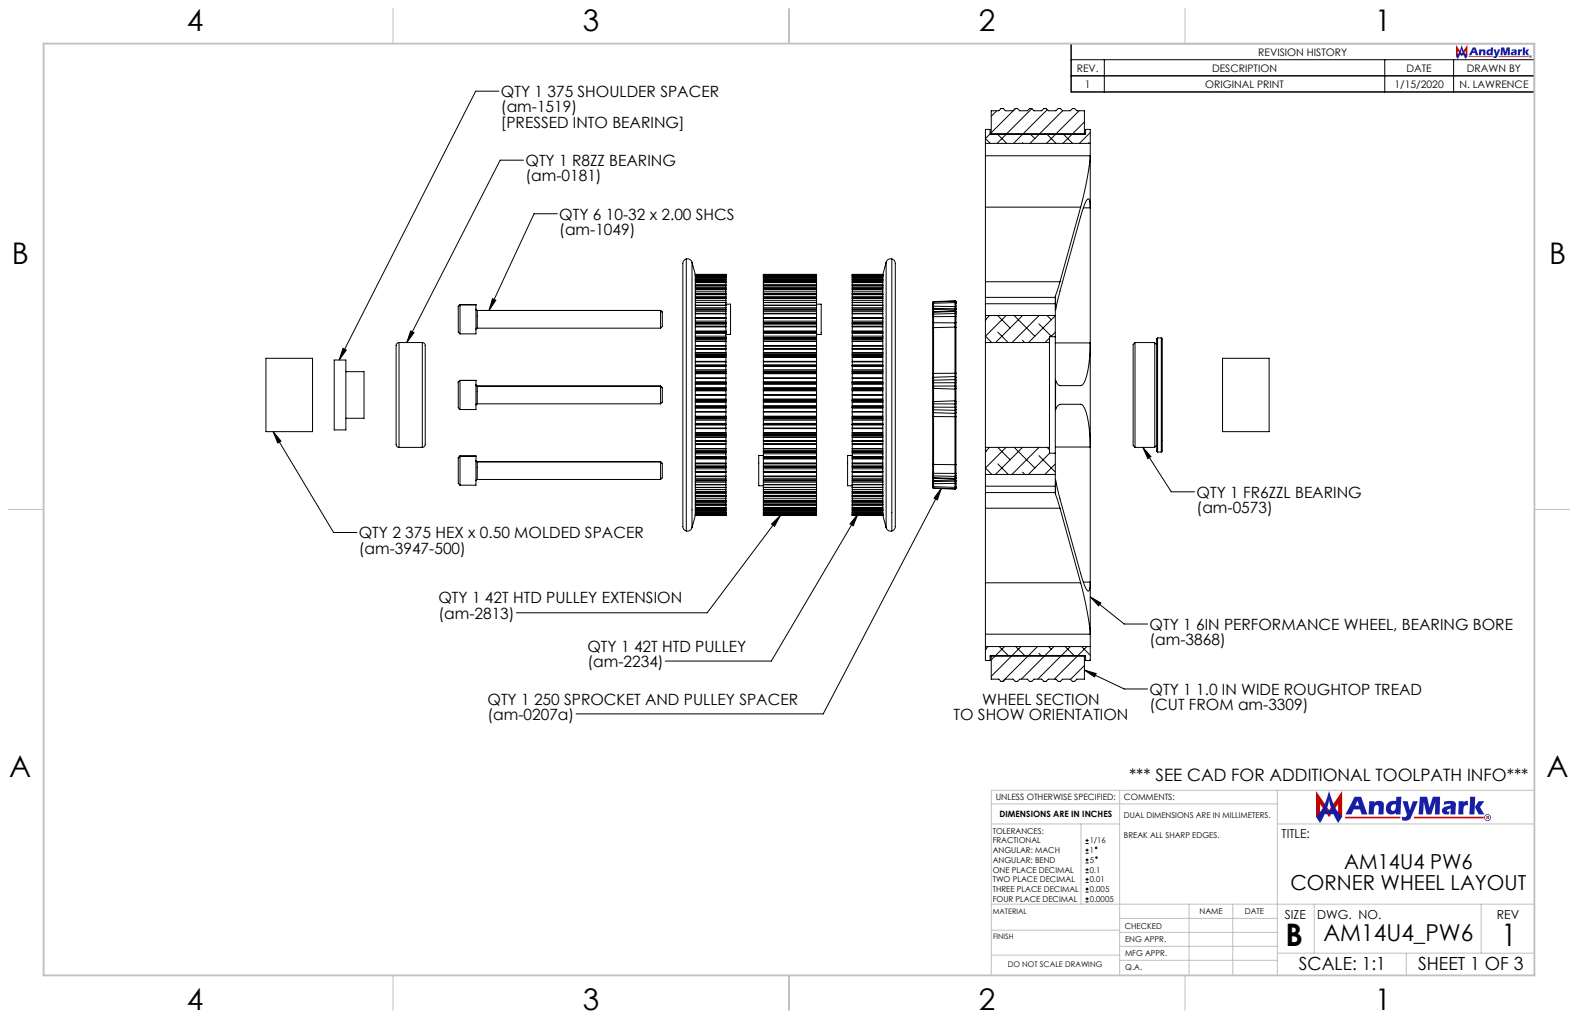
[picture p334: page 1]
QTY 1 FR6ZZL BEARING; QTY 1 1.0 IN WIDE ROUGHTOP TREAD QTY 1 250 SPROCKET AND PULLEY SPACER; (CUT FROM am-3309) (am-0207a)

REVISION HISTORY

REV. | DESCRIPTION | DATE | DRAWN BY
1 | ORIGINAL PRINT | 1/15/2020 | N. LAWRENCE

QTY 1 375 SHOULDER SPACER
[PRESSED INTO BEARING]
QTY 1 R8ZZ BEARING
QTY 6 10-32 x 2.00 SHCS

QTY 2 375 HEX x 0.50 MOLDED SPACER

QTY 1 42T HTD PULLEY EXTENSION

QTY 1 6IN PERFORMANCE WHEEL, BEARING BORE

QTY 1 42T HTD PULLEY

WHEEL SECTION
TO SHOW ORIENTATION

*** SEE CAD FOR ADDITIONAL TOOLPATH INFO***

UNLESS OTHERWISE SPECIFIED: | COMMENTS:
DIMENSIONS ARE IN INCHES | DUAL DIMENSIONS ARE IN MILLIMETERS. BREAK ALL SHARP EDGES.
TOLERANCES: FRACTIONAL ANGULAR: MACH ANGULAR: BEND ONE PLACE DECIMAL TWO PLACE DECIMAL THREE PLACE DECIMAL FOUR PLACE DECIMAL | 1/16 1 5 0.1 0.01 0.005 0.0005 | | TITLE: AM14U4 PW6 CORNER WHEEL LAYOUT

MATERIAL | | NAME | DATE | SIZE B | DWG. NO. AM14U4_PW6 | REV 1
DO NOT SCALE DRAWING | SCALE: 1:1 | SHEET 1 OF 3

CHECKED

FINISH | ENG APPR.

MFG APPR.
Q.A.

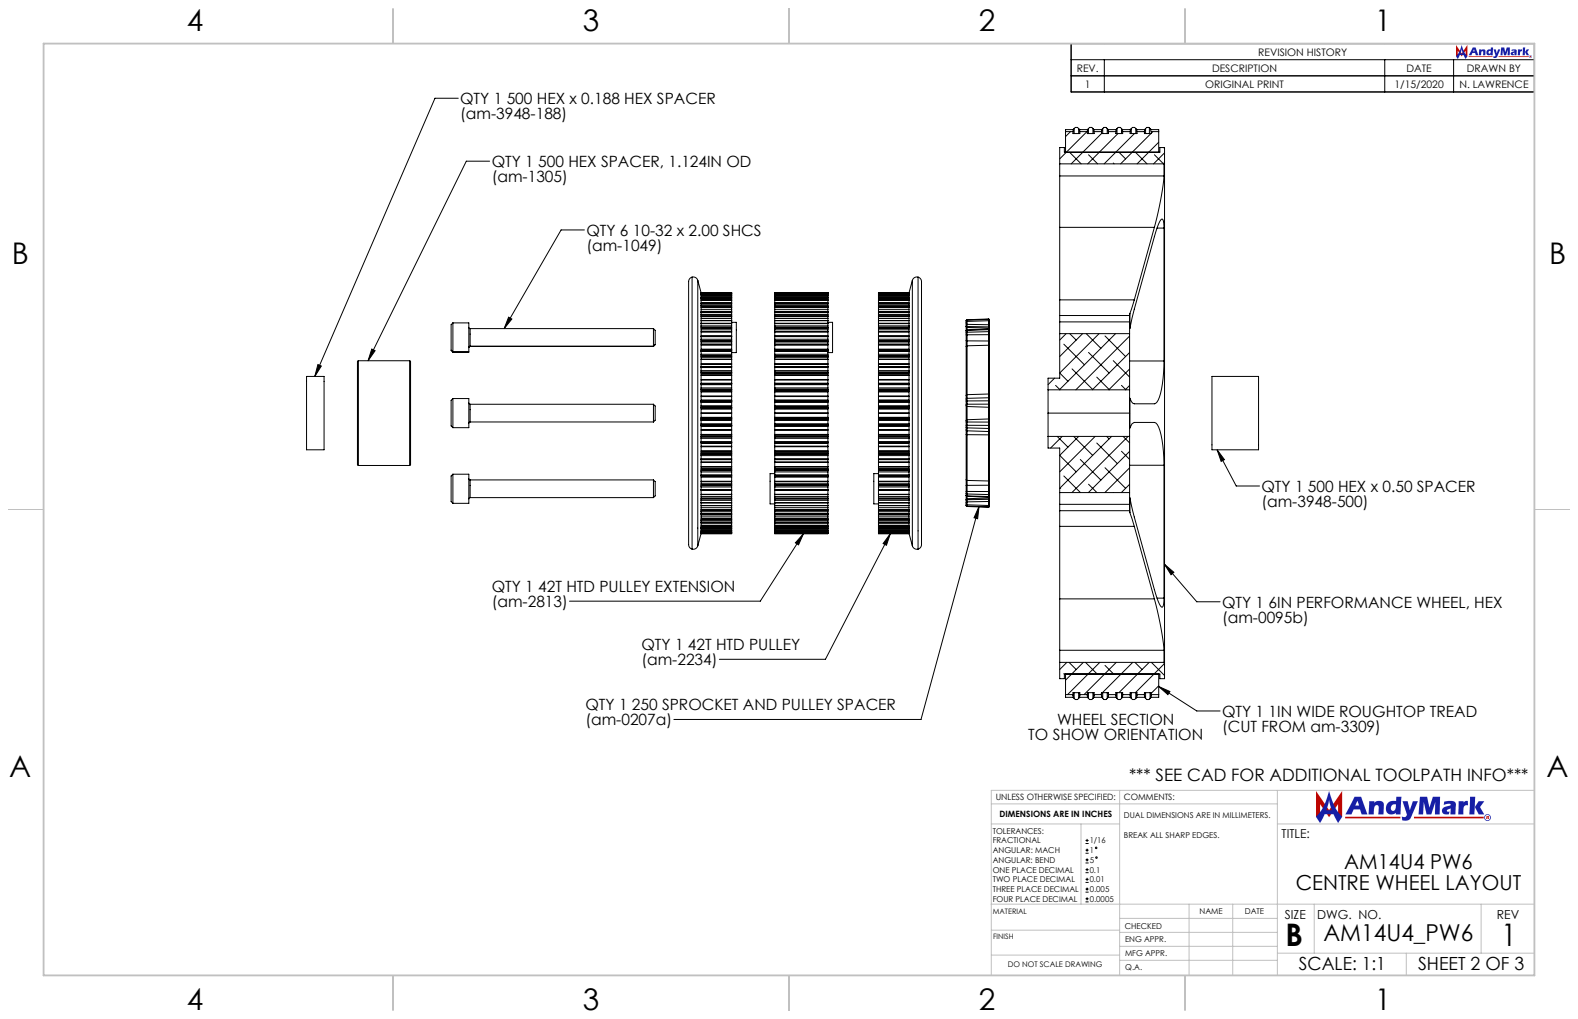
[picture p335: page 2]
QTY 6 10-32 x 2.00 SHCS; ORIGINAL PRINT; N. LAWRENCE; SCALE: 1:1

QTY 1 500 HEX x 0.188 HEX SPACER

QTY 1 500 HEX SPACER, 1.124IN OD

QTY 1 500 HEX x 0.50 SPACER

QTY 1 42T HTD PULLEY EXTENSION

QTY 1 6IN PERFORMANCE WHEEL, HEX

QTY 1 42T HTD PULLEY

QTY 1 250 SPROCKET AND PULLEY SPACER

QTY 1 1IN WIDE ROUGHTOP TREAD
(CUT FROM am-3309)

WHEEL SECTION
TO SHOW ORIENTATION

*** SEE CAD FOR ADDITIONAL TOOLPATH INFO***

UNLESS OTHERWISE SPECIFIED: | COMMENTS:
DIMENSIONS ARE IN INCHES | DUAL DIMENSIONS ARE IN MILLIMETERS. BREAK ALL SHARP EDGES.
TOLERANCES: FRACTIONAL ANGULAR: MACH ANGULAR: BEND ONE PLACE DECIMAL TWO PLACE DECIMAL THREE PLACE DECIMAL FOUR PLACE DECIMAL | 1/16 1 5 0.1 0.01 0.005 0.0005 | | TITLE: AM14U4 PW6 CENTRE WHEEL LAYOUT

MATERIAL | | NAME | DATE | SIZE B | DWG. NO. AM14U4_PW6 | REV 1

CHECKED

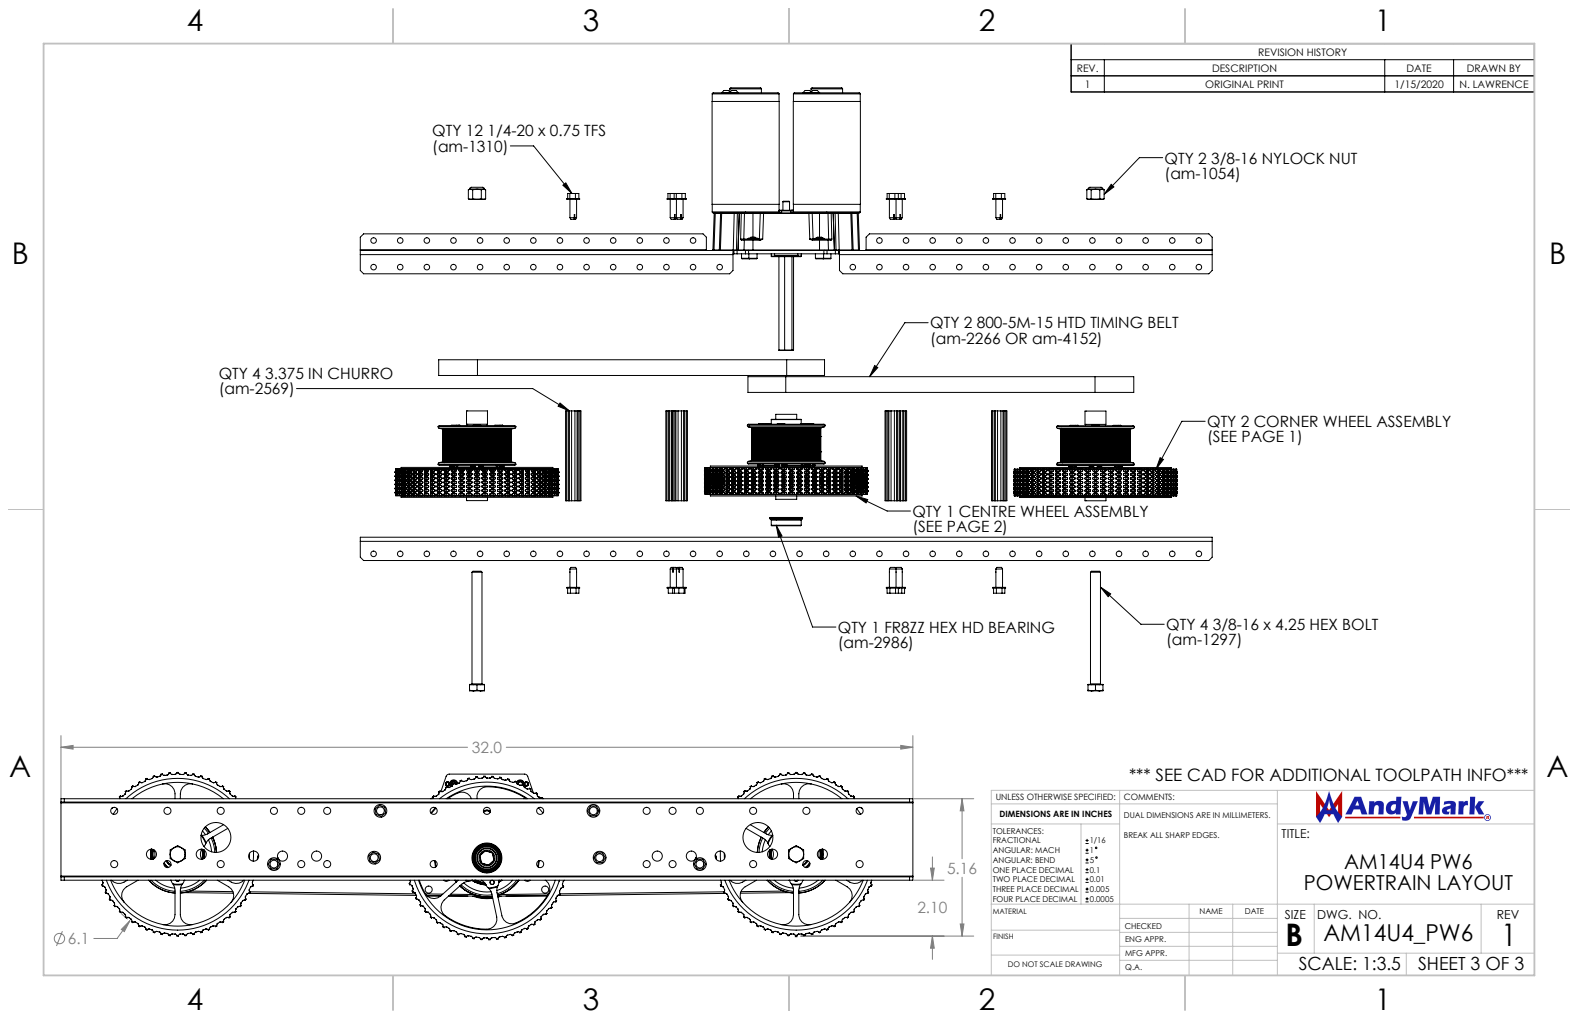
[picture p336: page 3]
QTY 12 1/4-20 x 0.75 TFS; ORIGINAL PRINT; N. LAWRENCE; SCALE: 1:3.5

QTY 2 3/8-16 NYLOCK NUT

QTY 2 800-5M-15 HTD TIMING BELT

QTY 4 3.375 IN CHURRO

QTY 2 CORNER WHEEL ASSEMBLY
(SEE PAGE 1)

QTY 1 CENTRE WHEEL ASSEMBLY
(SEE PAGE 2)

QTY 1 FR8ZZ HEX HD BEARING

QTY 4 3/8-16 x 4.25 HEX BOLT

*** SEE CAD FOR ADDITIONAL TOOLPATH INFO***

UNLESS OTHERWISE SPECIFIED: | COMMENTS:
DIMENSIONS ARE IN INCHES | DUAL DIMENSIONS ARE IN MILLIMETERS. BREAK ALL SHARP EDGES.
TOLERANCES: FRACTIONAL ANGULAR: MACH ANGULAR: BEND ONE PLACE DECIMAL TWO PLACE DECIMAL THREE PLACE DECIMAL FOUR PLACE DECIMAL | 1/16 1 5 0.1 0.01 0.005 0.0005 | | TITLE: AM14U4 PW6 POWERTRAIN LAYOUT

MATERIAL | | NAME | DATE | SIZE B | DWG. NO. AM14U4_PW6 | REV 1

CHECKED
