SnoBotics981/CAD-MfgResources/Andy-Mark/2020 Kit Bot/AM14U4_FROXL Extra Large Frame Opening Kit.PDF

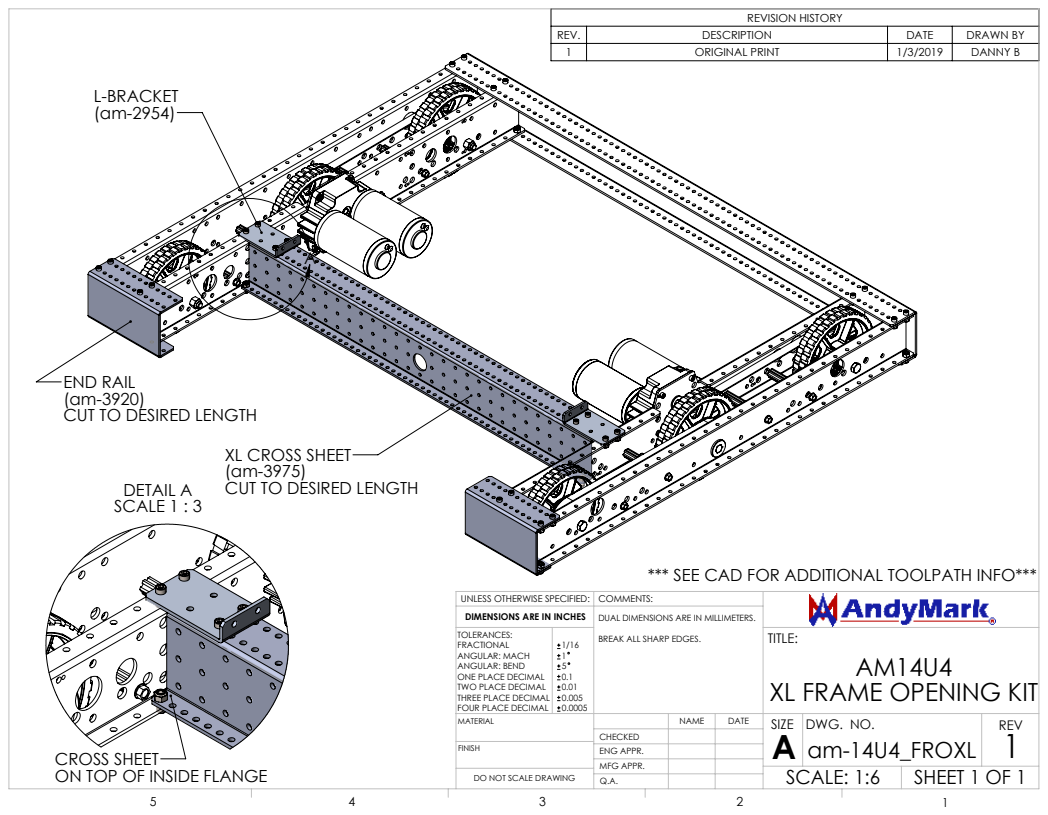
[picture p337: page 1]
DETAIL A; CUT TO DESIRED LENGTH; SCALE 1 : 3

REVISION HISTORY

REV. | DESCRIPTION | DATE | DRAWN BY
1 | ORIGINAL PRINT | 1/3/2019 | DANNY B

END RAIL
CUT TO DESIRED LENGTH

XL CROSS SHEET

*** SEE CAD FOR ADDITIONAL TOOLPATH INFO***

UNLESS OTHERWISE SPECIFIED: | COMMENTS:
DIMENSIONS ARE IN INCHES | DUAL DIMENSIONS ARE IN MILLIMETERS. BREAK ALL SHARP EDGES.
TOLERANCES: FRACTIONAL ANGULAR: MACH ANGULAR: BEND ONE PLACE DECIMAL TWO PLACE DECIMAL THREE PLACE DECIMAL FOUR PLACE DECIMAL | 1/16 1 5 0.1 0.01 0.005 0.0005 | | TITLE: AM14U4 XL FRAME OPENING KIT
MATERIAL | | NAME | DATE | SIZE A | DWG. NO. am-14U4_FROXL | REV 1

CHECKED

CROSS SHEET
ON TOP OF INSIDE FLANGE

FINISH | ENG APPR.

MFG APPR.
Q.A.

DO NOT SCALE DRAWING | SCALE: 1:6 | SHEET 1 OF 1
