SnoBotics981/CAD-MfgResources/Andy-Mark/2020 Kit Bot/am-14U4_FRO Frame Opening Kit.PDF

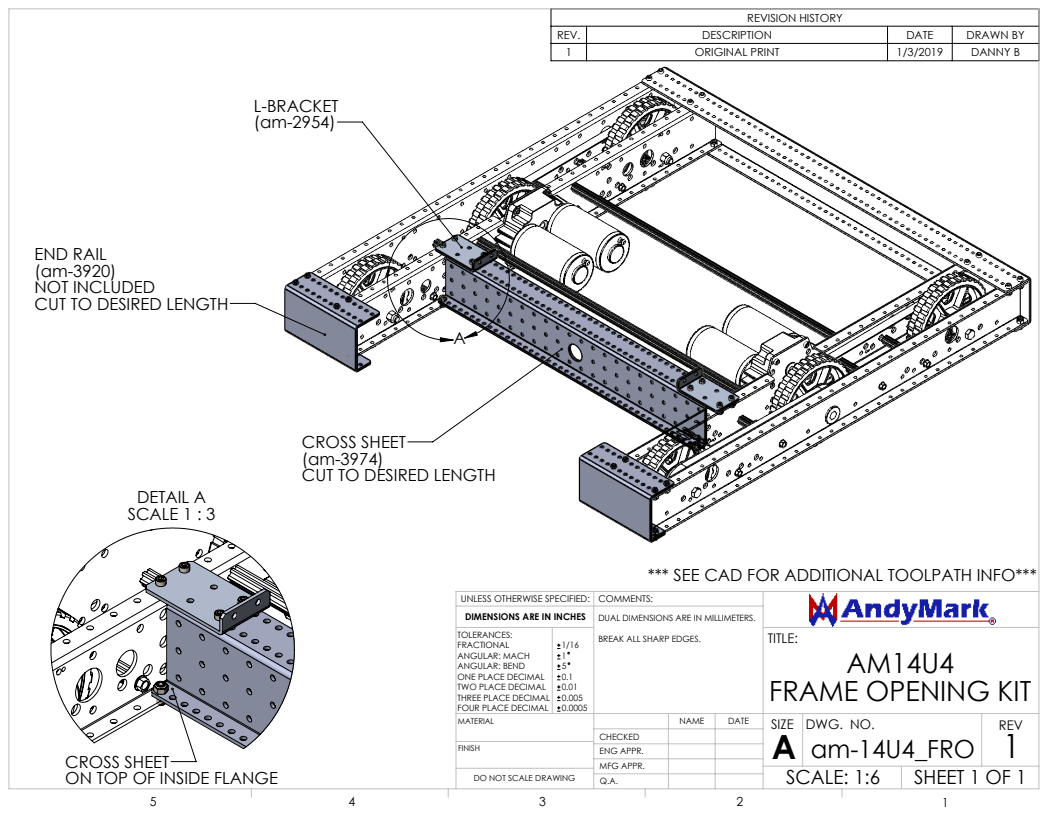
[picture p338: page 1]
DETAIL A SCALE 1 : 3

REVISION HISTORY

REV. | DESCRIPTION | DATE | DRAWN BY
1 | ORIGINAL PRINT | 1/3/2019 | DANNY B

END RAIL
NOT INCLUDED
CUT TO DESIRED LENGTH

CROSS SHEET

*** SEE CAD FOR ADDITIONAL TOOLPATH INFO***

UNLESS OTHERWISE SPECIFIED: | COMMENTS:
DIMENSIONS ARE IN INCHES | DUAL DIMENSIONS ARE IN MILLIMETERS. BREAK ALL SHARP EDGES.
TOLERANCES: FRACTIONAL ANGULAR: MACH ANGULAR: BEND ONE PLACE DECIMAL TWO PLACE DECIMAL THREE PLACE DECIMAL FOUR PLACE DECIMAL | 1/16 1 5 0.1 0.01 0.005 0.0005 | | TITLE: AM14U4 FRAME OPENING KIT
MATERIAL | | NAME | DATE | SIZE A | DWG. NO. am-14U4_FRO | REV 1

CHECKED

FINISH | ENG APPR.

ON TOP OF INSIDE FLANGE

MFG APPR.
Q.A.

DO NOT SCALE DRAWING | SCALE: 1:6 | SHEET 1 OF 1
