SnoBotics981/CAD-MfgResources/RevRobotics/LiftMechanism/REV-21-1578-DR.pdf

# 1" UNIVERSAL MOTOR BRACKET BENT

# REV-21-1578

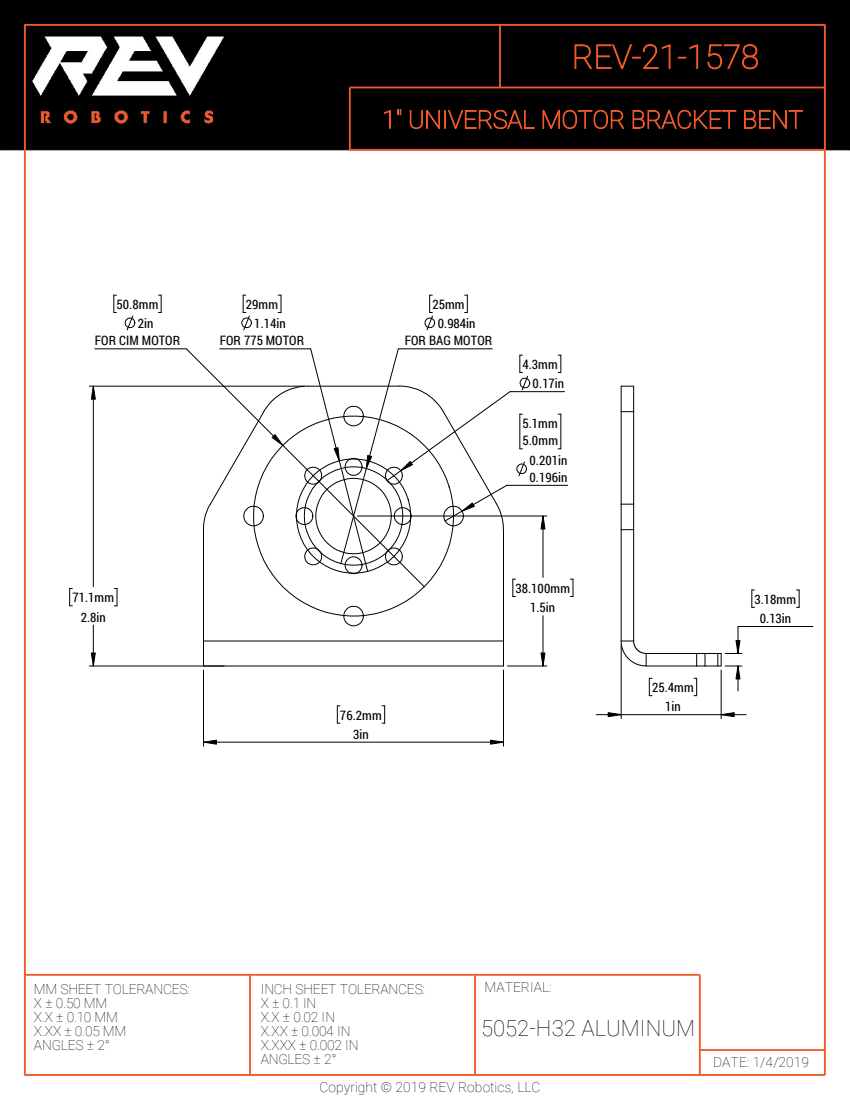
[picture p339: page 1]
29mm 1.14in FOR 775 MOTOR; DATE: 1/4/2019; MATERIAL:; 5052-H32 ALUMINUM

FOR CIM MOTOR

FOR BAG MOTOR

MM SHEET TOLERANCES:
ANGLES ± 2°

INCH SHEET TOLERANCES:
X.XXX ± 0.002 IN

Copyright © 2019 REV Robotics, LLC
