SnoBotics981/CAD-MfgResources/McMaster-Carr/BrassHeatSetInsertForPlastic/1_4-20 0_375 94459A380_BRASS HEAT-SET INSERT FOR PLASTIC.PDF

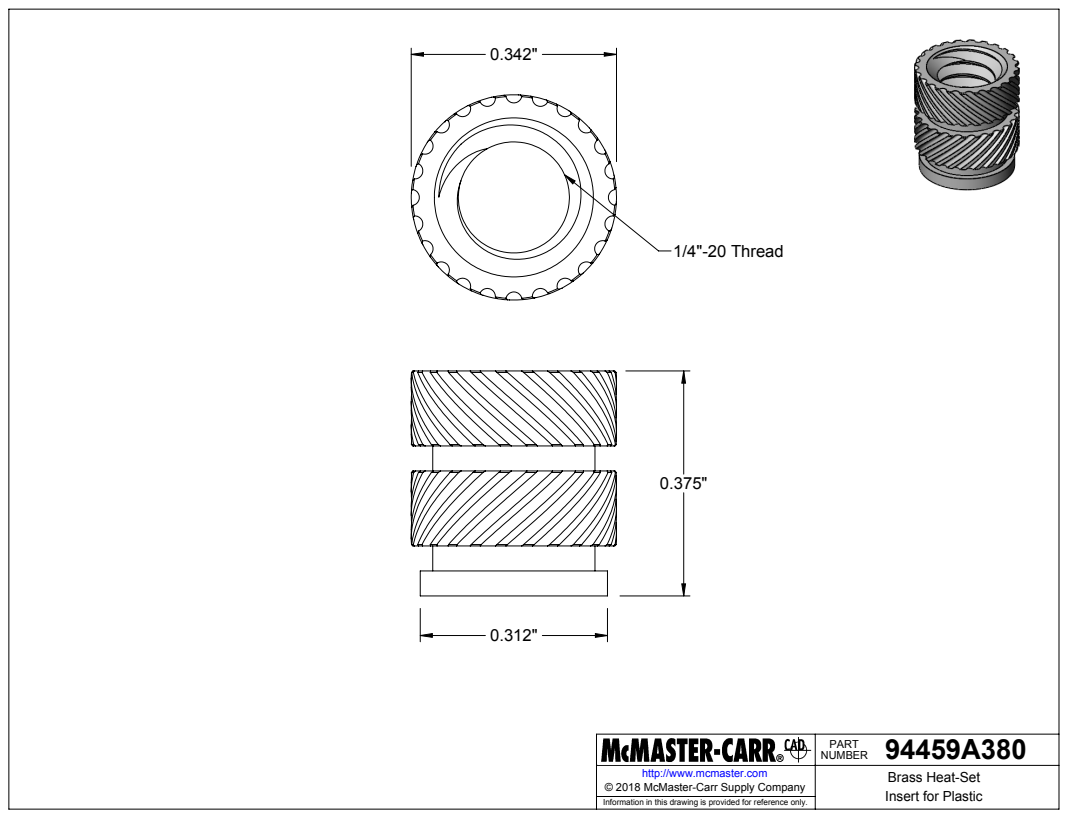
[picture p340: page 1]
1/4"-20 Thread

94459A380 PART NUMBER

http://www.mcmaster.com | Brass Heat-Set Insert for Plastic © 2018 McMaster-Carr Supply Company

Information in this drawing is provided for reference only.
