SnoBotics981/CAD-MfgResources/McMaster-Carr/Quick Release Pin/90985A113_HIGH PROFILE PUSH-BUTTON QUICK-RELEASE PIN.PDF

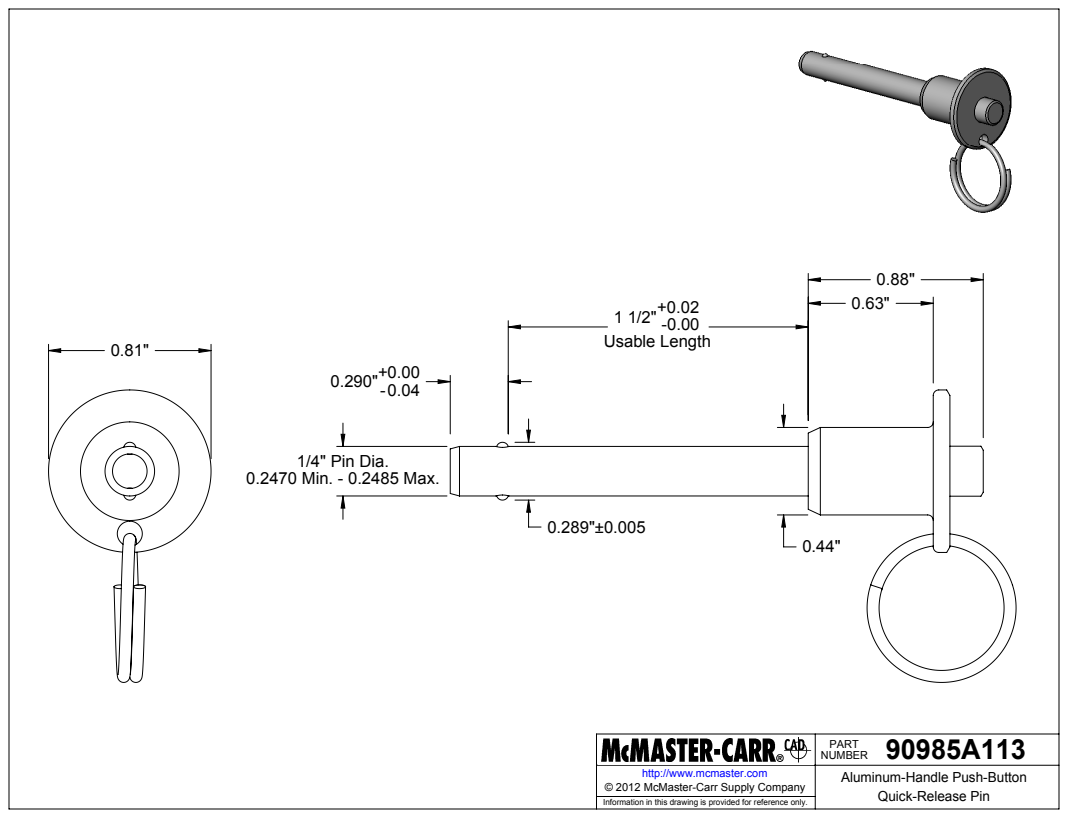
[picture p341: page 1]
1/4" Pin Dia. 0.2470 Min. - 0.2485 Max.; Usable Length 0.81"

90985A113 PART NUMBER

http://www.mcmaster.com | Aluminum-Handle Push-Button Quick-Release Pin © 2012 McMaster-Carr Supply Company

Information in this drawing is provided for reference only.
