SnoBotics981/CAD-MfgResources/McMaster-Carr/Quick Release Pin/94748A222_HIGH PROFILE PUSH-BUTTON QUICK RELEASE PIN.PDF

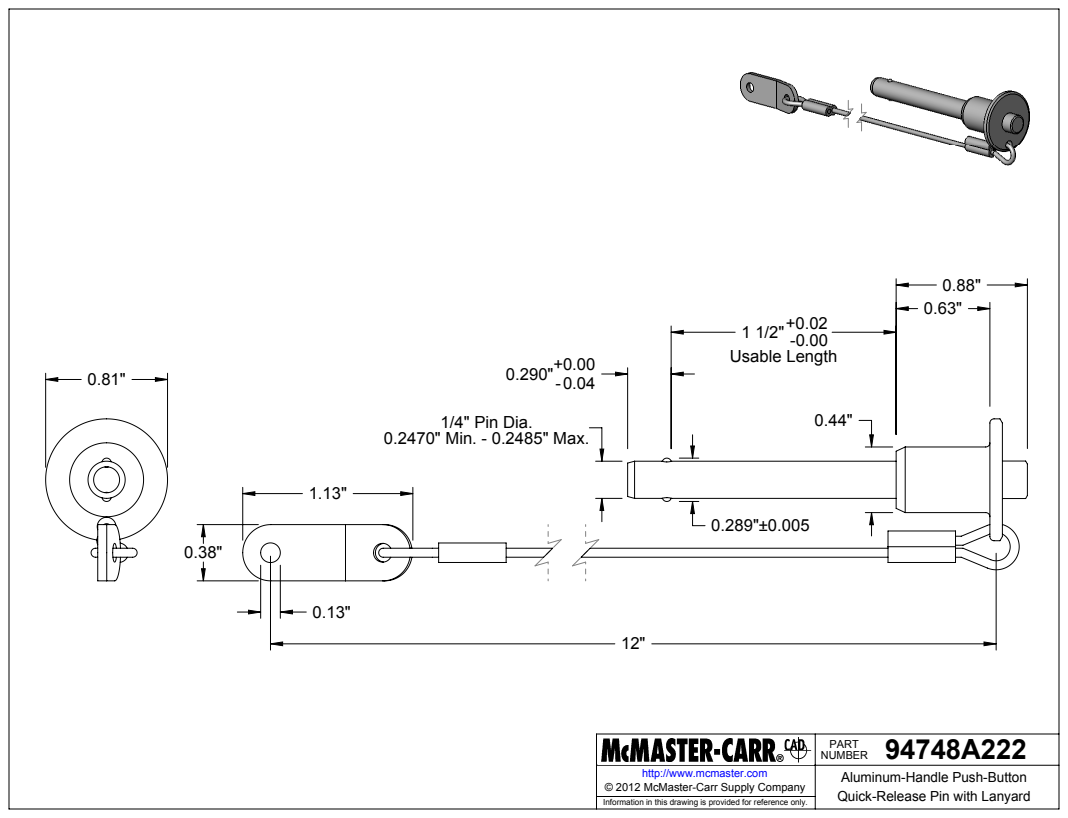
[picture p342: page 1]
1/4" Pin Dia. 0.2470" Min. - 0.2485" Max.; Usable Length

94748A222 PART NUMBER

http://www.mcmaster.com | Aluminum-Handle Push-Button Quick-Release Pin with Lanyard © 2012 McMaster-Carr Supply Company

Information in this drawing is provided for reference only.
