SnoBotics981/CAD-MfgResources/Andy-Mark/2017 RhinoBumperKit/am-3352 Front Left Bumper Bracket for Rhino Screw Callout.PDF

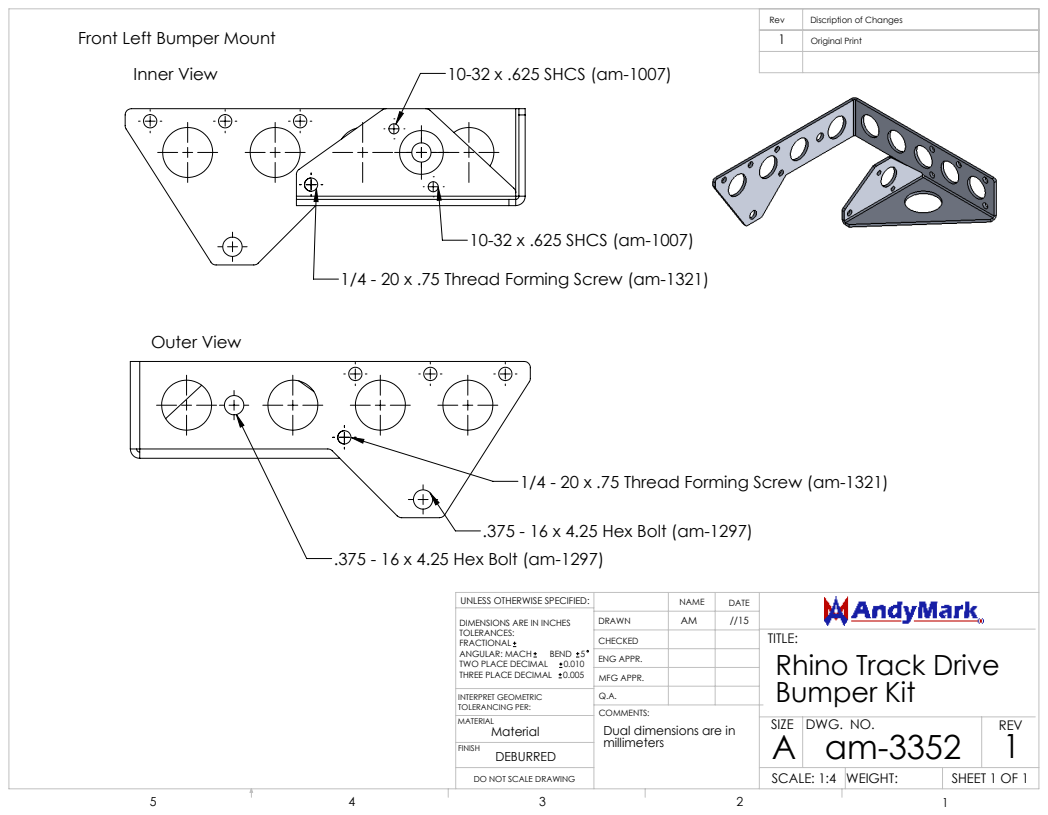
[picture p343: page 1]
10-32 x .625 SHCS (am-1007); Outer View; Rhino Track Drive Bumper Kit; SHEET 1 OF 1; SCALE: 1:4 WEIGHT:; DWG. NO.; REV; INTERPRET GEOMETRIC TOLERANCING PER:; ANGULAR: MACH; BEND 5; TWO PLACE DECIMAL; Rev; Discription of Changes; Original Print

Front Left Bumper Mount
Inner View

1/4 - 20 x .75 Thread Forming Screw (am-1321)

.375 - 16 x 4.25 Hex Bolt (am-1297)

UNLESS OTHERWISE SPECIFIED:

DIMENSIONS ARE IN INCHES
TOLERANCES:
FRACTIONAL
THREE PLACE DECIMAL 0.005

DRAWN
CHECKED
ENG APPR.
MFG APPR.
COMMENTS:
Dual dimensions are in
millimeters

DO NOT SCALE DRAWING
