SnoBotics981/CAD-MfgResources/Andy-Mark/2017 RhinoBumperKit/am-3352 Rhino Front Left Bumper Bracket.pdf

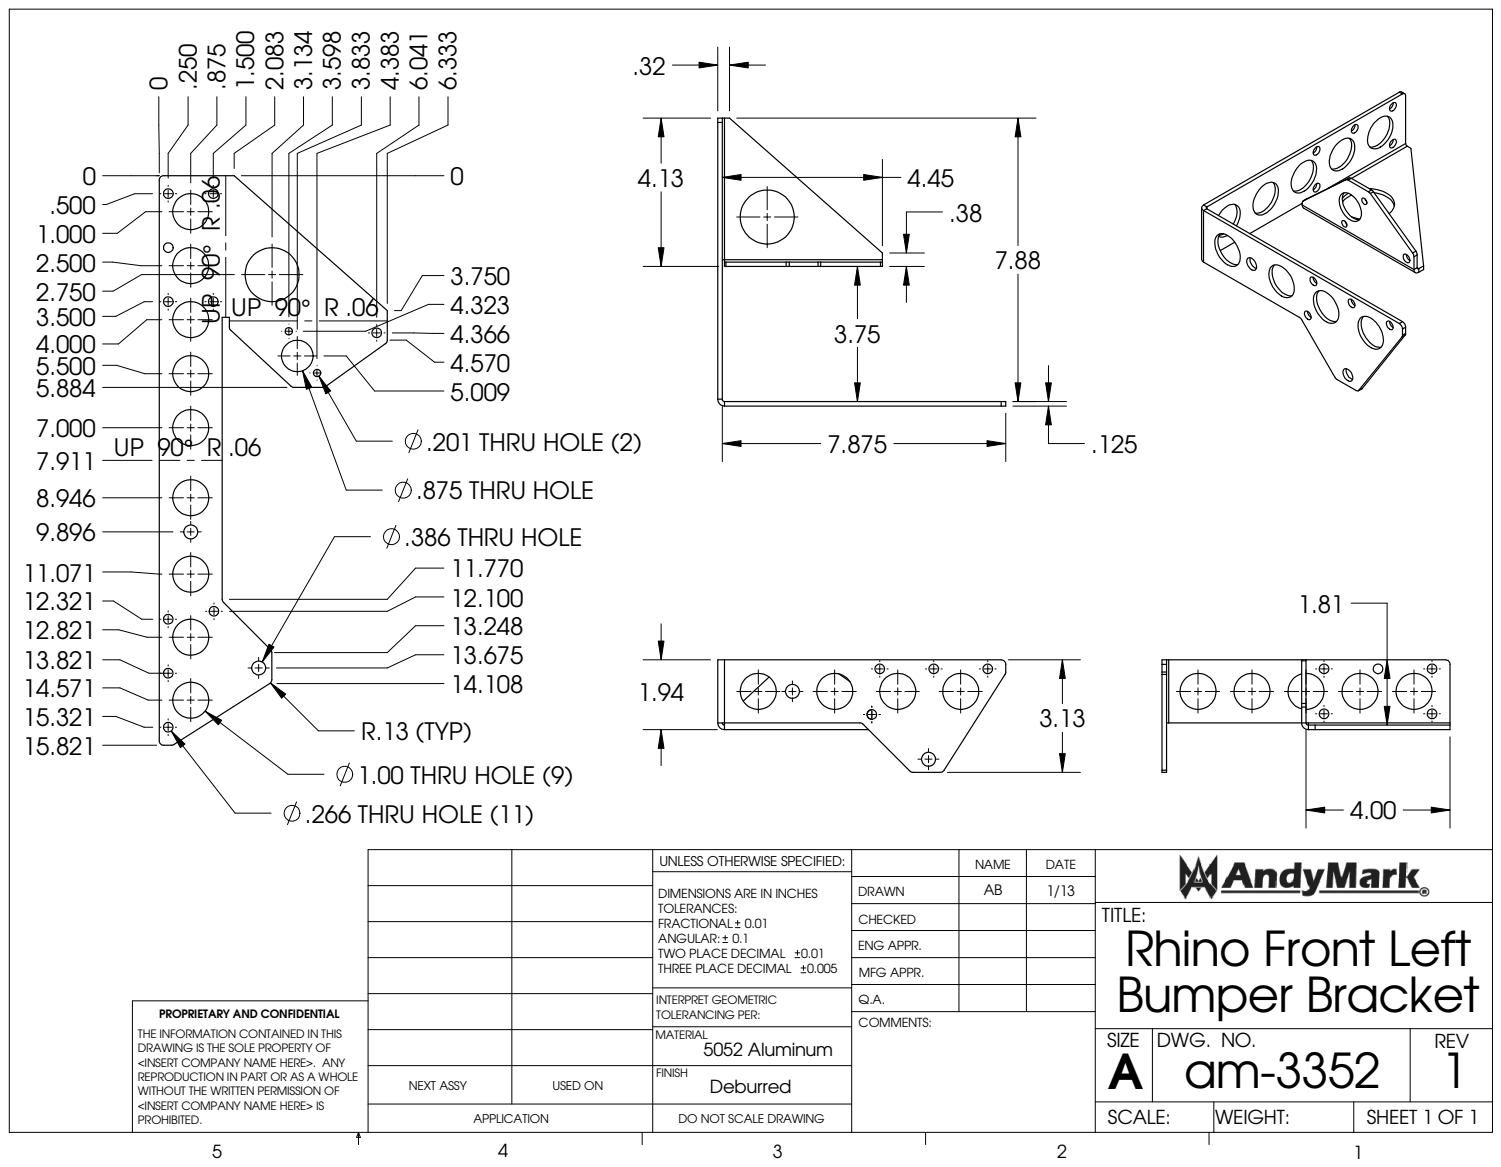
[picture p344: page 1]
COMMENTS:; THREE PLACE DECIMAL; .386 THRU HOLE; 1.00 THRU HOLE (9); .875 THRU HOLE; .201 THRU HOLE (2); .266 THRU HOLE (11); R.13 (TYP)

UNLESS OTHERWISE SPECIFIED: | | NAME | DATE

DRAWN | AB | 1/13
CHECKED | | | TITLE: Rhino Front Left Bumper Bracket

DIMENSIONS ARE IN INCHES
TOLERANCES:
FRACTIONAL 0.01
ANGULAR:
TWO PLACE DECIMAL

ENG APPR.

MFG APPR.

INTERPRET GEOMETRIC TOLERANCING PER: | Q.A.
MATERIAL 5052 Aluminum | | SIZE A | DWG. NO. am-3352 | REV 1

PROPRIETARY AND CONFIDENTIAL
THE INFORMATION CONTAINED IN THIS
DRAWING IS THE SOLE PROPERTY OF
<INSERT COMPANY NAME HERE>. ANY
REPRODUCTION IN PART OR AS A WHOLE
WITHOUT THE WRITTEN PERMISSION OF
<INSERT COMPANY NAME HERE> IS
PROHIBITED.

NEXT ASSY | USED ON | FINISH Deburred

APPLICATION | DO NOT SCALE DRAWING | | SCALE: | WEIGHT: | SHEET 1 OF 1
