SnoBotics981/CAD-MfgResources/Andy-Mark/2017 RhinoBumperKit/am-3353 Rhino Front Right Bumper Bracket.pdf

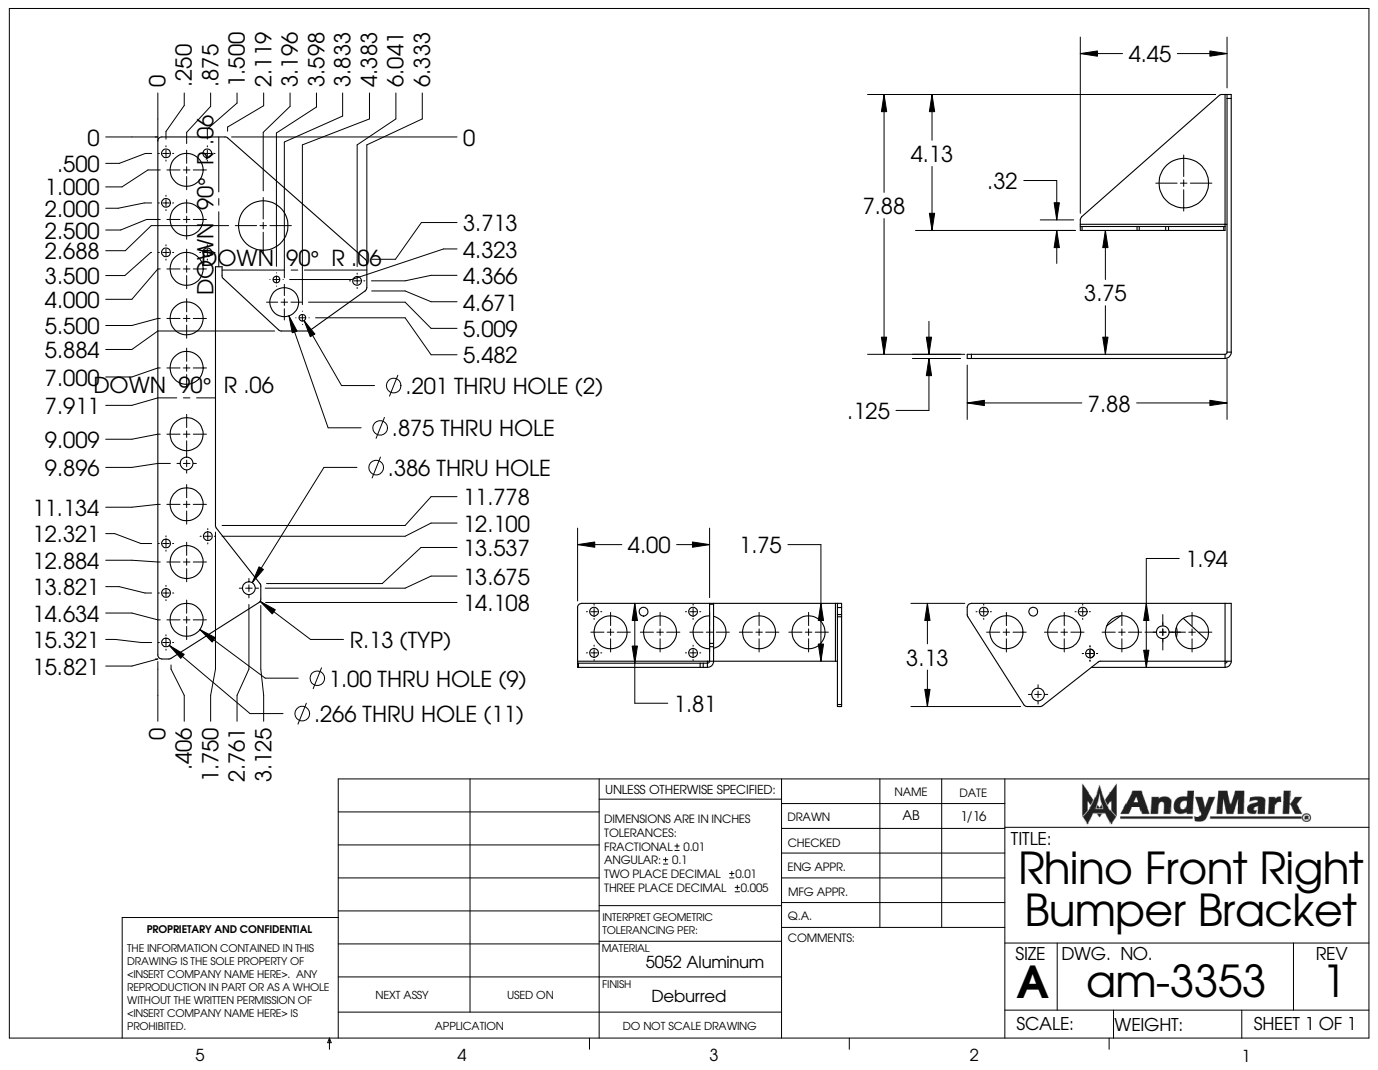
[picture p345: page 1]
DOWN 90° R .06; DOWN 90°; DOWN; 1.00 THRU HOLE (9); .386 THRU HOLE; .875 THRU HOLE; .201 THRU HOLE (2); R.13 (TYP); .266 THRU HOLE (11); COMMENTS:; THREE PLACE DECIMAL

UNLESS OTHERWISE SPECIFIED: | | NAME | DATE

DRAWN | AB | 1/16
CHECKED | | | TITLE: Rhino Front Right Bumper Bracket

DIMENSIONS ARE IN INCHES
TOLERANCES:
FRACTIONAL 0.01
ANGULAR:
TWO PLACE DECIMAL

ENG APPR.

MFG APPR.

INTERPRET GEOMETRIC TOLERANCING PER: | Q.A.
MATERIAL 5052 Aluminum | | SIZE A | DWG. NO. am-3353 | REV 1

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

NEXT ASSY | USED ON | FINISH Deburred

APPLICATION | DO NOT SCALE DRAWING | | SCALE: | WEIGHT: | SHEET 1 OF 1
