SnoBotics981/CAD-MfgResources/Andy-Mark/2017 RhinoBumperKit/am-3354 Rhino Back Left Bumper Bracket.pdf

0 0
.500

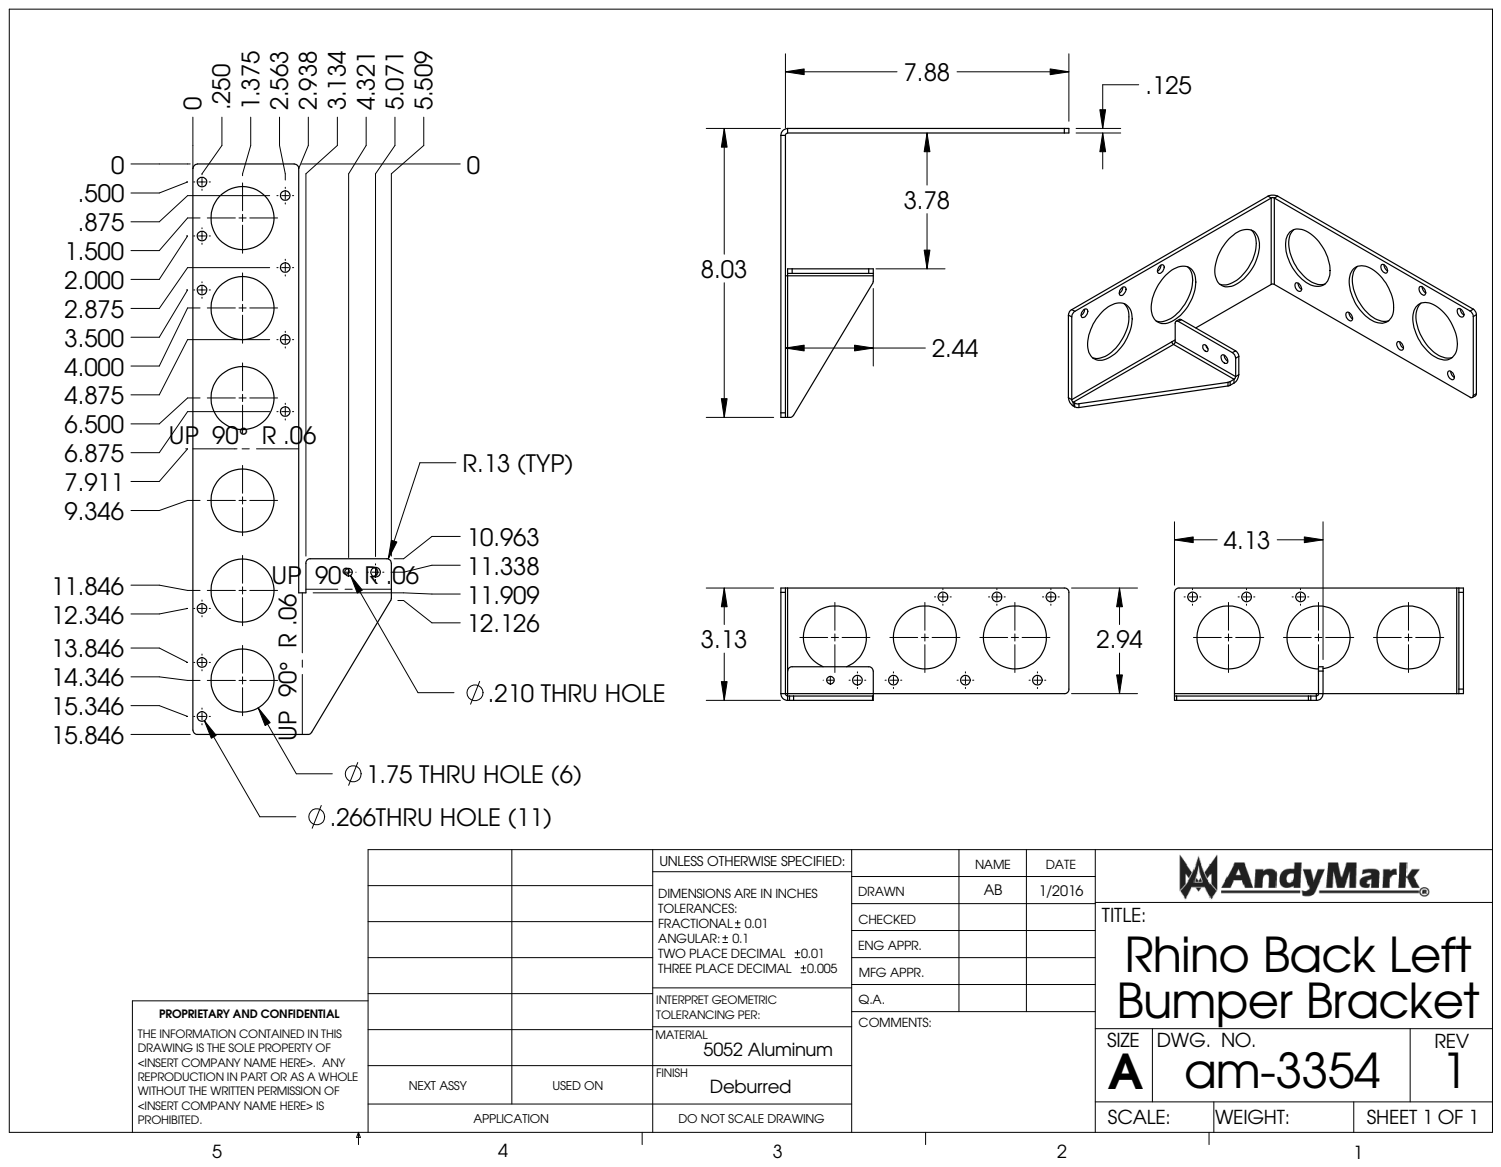
[picture p347: page 1]
COMMENTS:; THREE PLACE DECIMAL; R.13 (TYP); .266THRU HOLE (11); 1.75 THRU HOLE (6); .210 THRU HOLE

UNLESS OTHERWISE SPECIFIED: | | NAME | DATE

DRAWN | AB | 1/2016
CHECKED | | | TITLE: Rhino Back Left Bumper Bracket

DIMENSIONS ARE IN INCHES
TOLERANCES:
FRACTIONAL 0.01
ANGULAR:
TWO PLACE DECIMAL

ENG APPR.

MFG APPR.

INTERPRET GEOMETRIC TOLERANCING PER: | Q.A.
MATERIAL 5052 Aluminum | | SIZE A | DWG. NO. am-3354 | REV 1

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

NEXT ASSY | USED ON | FINISH Deburred

APPLICATION | DO NOT SCALE DRAWING | | SCALE: | WEIGHT: | SHEET 1 OF 1
