SnoBotics981/CAD-MfgResources/Andy-Mark/ArmJointForPvcPipe/am-2692+PVC+Joint+Plate.PDF

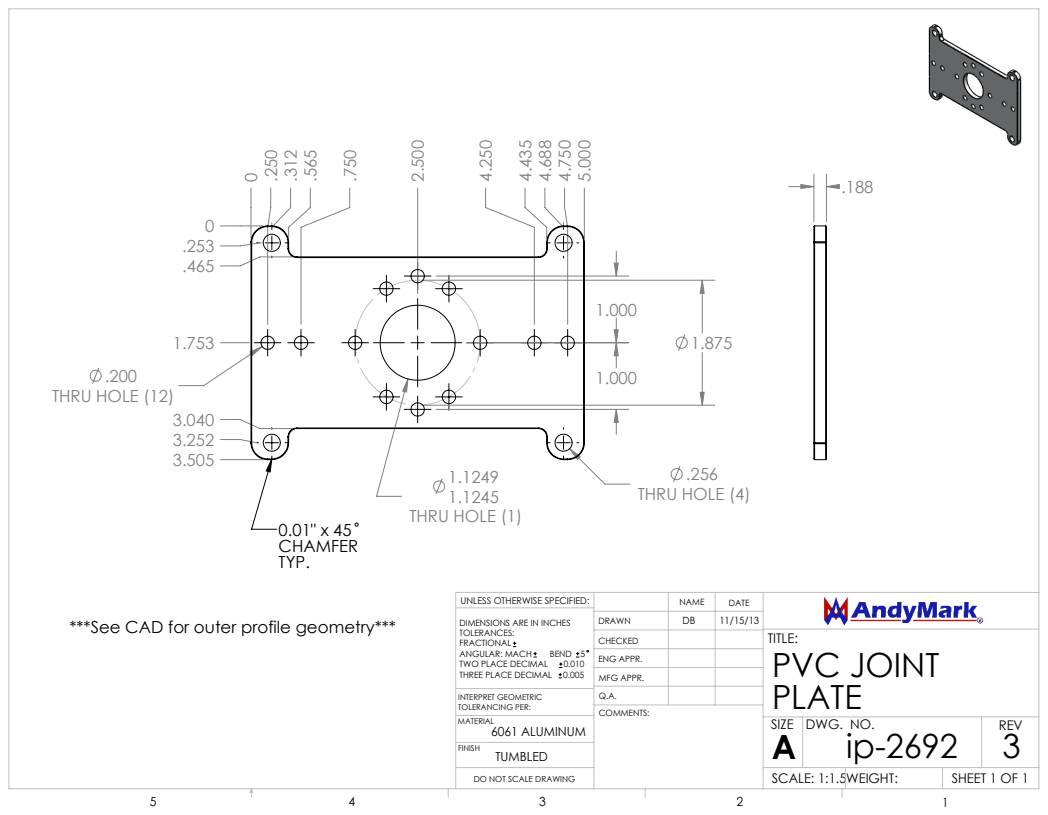
[picture p348: page 1]
THRU HOLE (12); THRU HOLE (1); THRU HOLE (4); PVC JOINT; SHEET 1 OF 1; SCALE: 1:1.5WEIGHT:; DWG. NO.; REV; MFG APPR.; ENG APPR.; 6061 ALUMINUM; INTERPRET GEOMETRIC TOLERANCING PER:; ANGULAR: MACH; BEND 5; TWO PLACE DECIMAL

UNLESS OTHERWISE SPECIFIED:

***See CAD for outer profile geometry***

DIMENSIONS ARE IN INCHES
TOLERANCES:
FRACTIONAL
THREE PLACE DECIMAL 0.005

DO NOT SCALE DRAWING
