SnoBotics981/CAD-MfgResources/Andy-Mark/ArmJointForPvcPipe/am-2693+PVC+Joint+Spacer.PDF

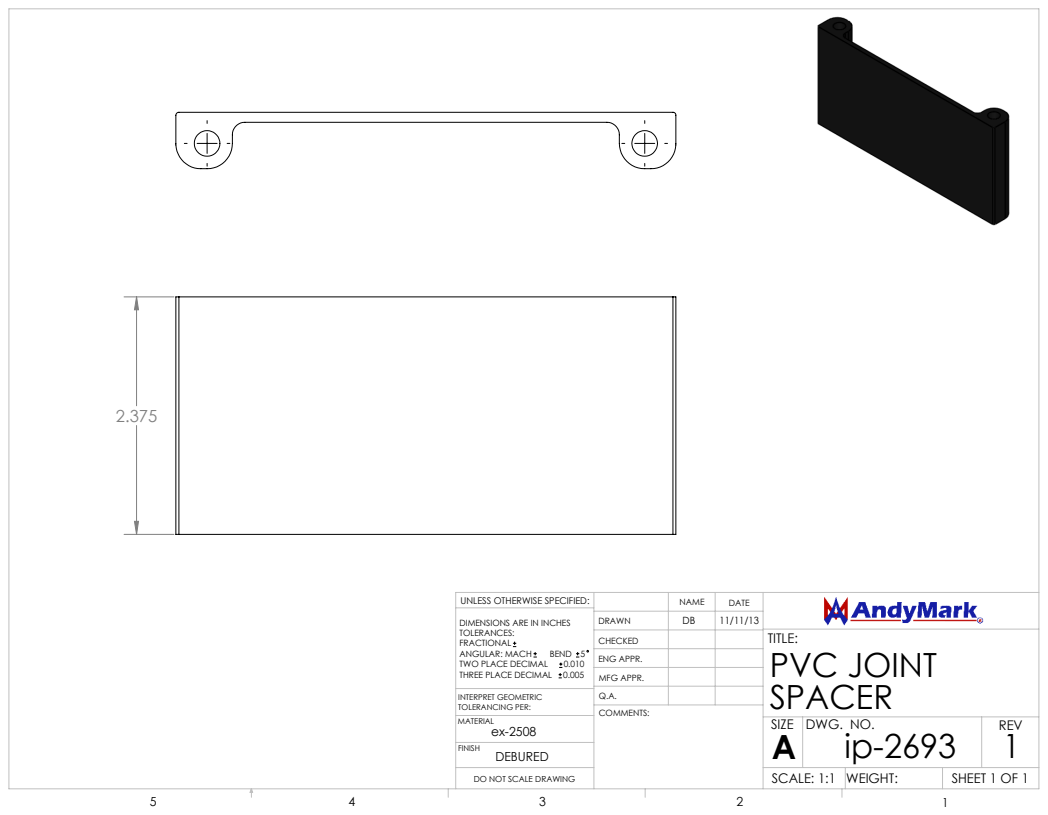
[picture p349: page 1]
PVC JOINT; SHEET 1 OF 1; SCALE: 1:1 WEIGHT:; DWG. NO.; REV; MFG APPR.; ENG APPR.; INTERPRET GEOMETRIC TOLERANCING PER:; ANGULAR: MACH; BEND 5; TWO PLACE DECIMAL

UNLESS OTHERWISE SPECIFIED:

DIMENSIONS ARE IN INCHES
TOLERANCES:
FRACTIONAL
THREE PLACE DECIMAL 0.005

DO NOT SCALE DRAWING
