SnoBotics981/CAD-MfgResources/Andy-Mark/EncoderKit-AM-3132/20465.pdf

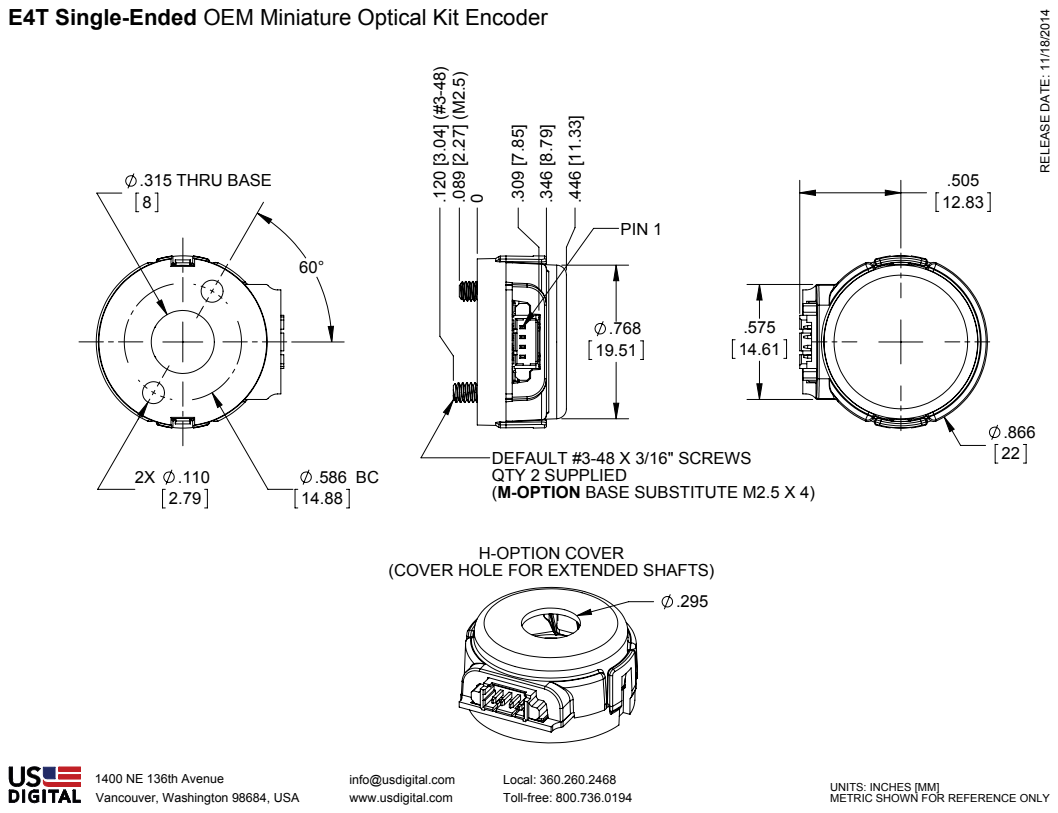
[picture p350: page 1]
Vancouver, Washington 98684, USA; www.usdigital.com; Toll-free: 800.736.0194; 1400 NE 136th Avenue; info@usdigital.com; Local: 360.260.2468; THRU BASE; PIN 1; H-OPTION COVER

E4T Single-Ended OEM Miniature Optical Kit Encoder

METRIC SHOWN FOR REFERENCE ONLYRELEASE DATE: 11/18/2014

DEFAULT #3-48 X 3/16" SCREWS
QTY 2 SUPPLIED
(M-OPTION BASE SUBSTITUTE M2.5 X 4)

(COVER HOLE FOR EXTENDED SHAFTS)

UNITS: INCHES [MM]
