SnoBotics981/CAD-MfgResources/Andy-Mark/Hubs/am-0096a_500HexHub_r2-1.PDF

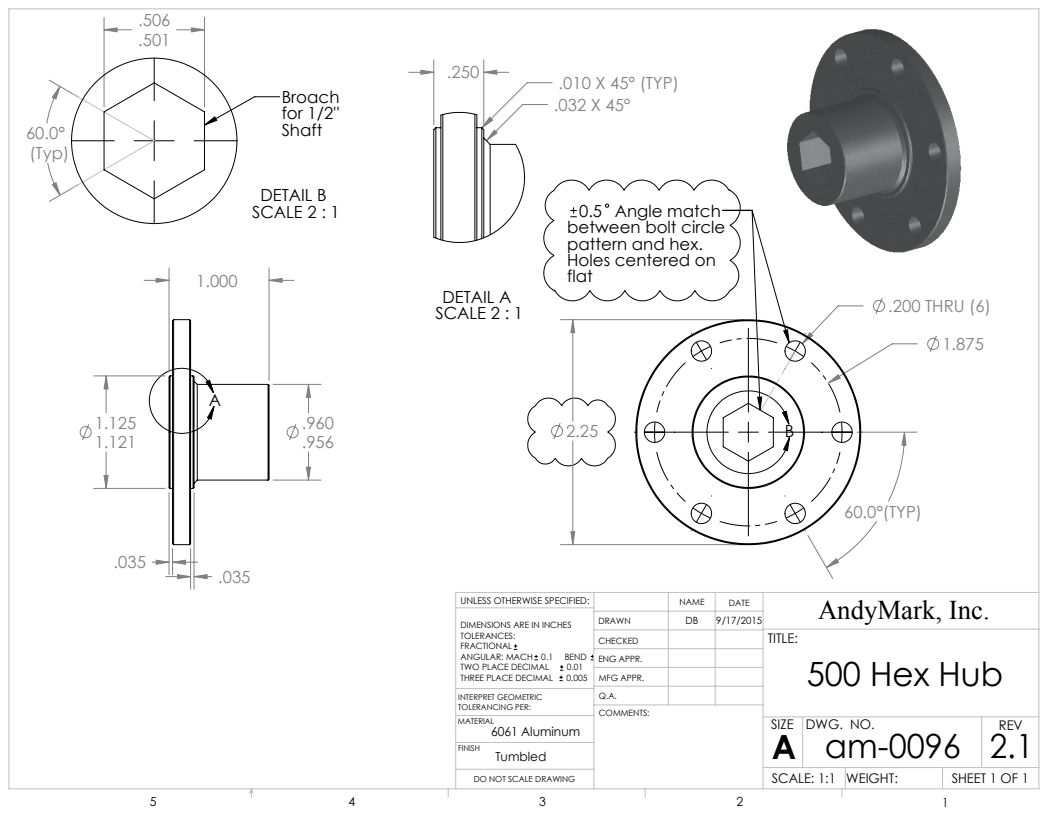
[picture p351: page 1]
.200 THRU (6); .010 X 45° (TYP); DETAIL A SCALE 2 : 1; DETAIL B SCALE 2 : 1; for 1/2''; 500 Hex Hub; SHEET 1 OF 1; SCALE: 1:1 WEIGHT:; DWG. NO.; REV; AndyMark, Inc. NAME; DATE; MFG APPR.; ENG APPR.; TWO PLACE DECIMAL

0.5 Angle match
between bolt circle
pattern and hex.
Holes centered on
flat

UNLESS OTHERWISE SPECIFIED:

DIMENSIONS ARE IN INCHES
TOLERANCES:
FRACTIONAL
ANGULAR: MACH 0.1 BEND
THREE PLACE DECIMAL 0.005
INTERPRET GEOMETRIC
TOLERANCING PER:
MATERIAL
6061 Aluminum
FINISH
Tumbled

DO NOT SCALE DRAWING
