SnoBotics981/CAD-MfgResources/(commit log)

2015-07-11 Fresh checkin.
    [10-24 Hex Washer Rolling x 1.25_93882A213.ipt, 10-32 Nylock Nut.ipt, 125 x 124 x 700 Machine Key.ipt, 14-20 Nylock Nut_97135A210.ipt, 1614Z Bearing.ipt, 1800x375 brass spacer.ipt, 185x385 washer 17W06272.ipt, 19T 20dp 375h_Inch - Spur gear 20DP 19T 14.5PA .575FW ---S19N.5H1L0.375N.ipt]
2015-07-13 Updated mc-master-carr files.
    [6498K340.0001.ipt, 6498K340.ipt]
2015-07-16 New models from McMaster-Carr.
    [90985A129.STEP, 90985A129.ipt]
2015-07-17 Added linear actuator to the parts available from AM.
2015-07-17 New models from McMaster Carr.
    [6113K132.ipt]
2015-07-19 Added quick release pin.
    [90985A127.STEP, 90985A127.ipt]
2015-07-21 Compact Air Cylinder changes.
    [90985A127.0001.ipt, 90985A127.ipt]
2015-07-21 New modesl from Andy-Mark.
    [am-0134a+375+Key+Hub+r2.0001.ipt, am-0134a+375+Key+Hub+r2.ipt]
2015-08-22 Recent updates to library data.
    [4698T310.STEP]
2015-08-28 Updates to support Rion M.
    [94505A533.STEP]
2015-10-05 Added cap screws.
    [90044A123.STEP, 90044A123.ipt]
2015-10-06 New components.
    [90044A118.STEP, VL-PLATE-5-25 RevA.STEP]
2015-11-09 Updates for vex documentation.
    [91251A345.STEP, 92141A011.STEP]
2015-11-14 New washer.
    [94744A225.STEP]
2015-11-16 2015 chassis.
    [10-24 Hex Washer Rolling x 1.25_93882A213.ipt, 10-32 Nylock Nut.ipt, 1614Z Bearing.ipt, 19T 20dp 375h_Inch - Spur gear 20DP 19T 14.5PA .575FW ---S19N.5H1L0.375N.ipt, 2014 KoP - 4 HiGrip and Double 42 HTD Pulley.0001.iam, 2014 KoP - 4 HiGrip and Double 42 HTD Pulley.iam, 2014 KoP - 4 HiGrip and Single 42 HTD Pulley.0001.iam, 2014 KoP - 4 HiGrip and Single 42 HTD Pulley.iam]
2015-11-16 removing 2915.
    [10-24 Hex Washer Rolling x 1.25_93882A213.ipt, 10-32 Nylock Nut.ipt, 1614Z Bearing.ipt, 2014 KoP - 4 HiGrip and Double 42 HTD Pulley.0001.iam, 2014 KoP - 4 HiGrip and Double 42 HTD Pulley.iam, 2014 KoP - 4 HiGrip and Single 42 HTD Pulley.0001.iam, 2014 KoP - 4 HiGrip and Single 42 HTD Pulley.iam, 3-8-16 NyLock Nut - Mcm 95615A140_95615A140.ipt]
2015-11-16 Added 2015 kit bot chassis.
    [10-24 Hex Washer Rolling x 1.25_93882A213.ipt, 10-32 Nylock Nut.ipt, 1614Z Bearing.ipt, 2014 KoP - 4 HiGrip and Double 42 HTD Pulley.0001.iam, 2014 KoP - 4 HiGrip and Double 42 HTD Pulley.iam, 2014 KoP - 4 HiGrip and Single 42 HTD Pulley.0001.iam, 2014 KoP - 4 HiGrip and Single 42 HTD Pulley.iam, 3-8-16 NyLock Nut - Mcm 95615A140_95615A140.ipt]
2015-11-16 AM battery bracket.
    [am-2718-Battery+Tray.STEP]
2015-11-19 Removed 2015 chassis files.
    [10-24 Hex Washer Rolling x 1.25_93882A213.ipt, 10-32 Nylock Nut.ipt, 1614Z Bearing.ipt, 2014 KoP - 4 HiGrip and Double 42 HTD Pulley.0001.iam, 2014 KoP - 4 HiGrip and Double 42 HTD Pulley.iam, 2014 KoP - 4 HiGrip and Single 42 HTD Pulley.0001.iam, 2014 KoP - 4 HiGrip and Single 42 HTD Pulley.iam, 3-8-16 NyLock Nut - Mcm 95615A140_95615A140.ipt]
2015-11-22 Updates for vex gripper.
    [4952K126.STEP, 4952K126.ipt, 6498K606.ipt]
2015-11-23 3 in air cylinder.
    [6498K605.ipt]
2015-11-27 Update for vex gripper.
2015-11-30 Added PTC models.
    [00090_2013.prt, 101-3002-1_2013.prt, 12129487_2013.prt, 12c_balls_2013.prt, 12c_bottom_2013.prt, 12c_top_2013.prt, 13536_2013.prt, 15-5m15-6fa3_2013.prt]
2015-12-04 removed zip file
    [BEVEL-ASSY.STEP, DIFFERENTIAL-ASSY.STEP, RACK-ASSY.STEP, SCREW-632-0250.STEP, WORM-ASSY.STEP]
2018-06-25 Add RevRobotics folder.
    [0500Hex1000ODPulley.SLDPRT, 0500Hex1000ODPulley.STEP, 0500Hex1000ODPulley.STL, MagnetOffsetPlate.SLDPRT, MagnetOffsetPlate.STEP, MagnetOffsetPlate.STL, MagneticLimitSwitchOffsetPlate.SLDPRT, MagneticLimitSwitchOffsetPlate.STEP]
2018-06-25 Add ThingiVerse folder.
    [5-16x18_wing_nut.scad, 8-32_Screw_Adapter.0001.ipt, 8-32_Screw_Adapter.stl, 8mm_wing_nut.scad, Aveeno_Lotion_Bottle_Coupling.stl, Battery_Cap_Blank.stl, KaiBolt.stl, M12.stl]
2018-06-25 Add VexRobotics folder.
    [217-2000.0001.ipt, 217-2000.0002.ipt, 217-2000.ipt, 217-2428-004 Rev3.0001.ipt, 217-2428-004 Rev3.0002.ipt, 217-2428-004 Rev3.ipt, 217-2428-005 Rev1.0001.ipt, 217-2428-005 Rev1.0002.ipt]
2018-06-25 Add WestCoastProducts folder
    [217-2000.ipt, 217-2428-027 Rev1_97414A630.ipt, 217-2614-002_98430A132.ipt, 217-2705-001_30t.ipt, 217-2731.ipt, 217-2733.ipt, 217-2734.ipt, 217-2743.ipt]
2018-06-26 Attempting to fix Andy-Mark folder
    [10-24 Hex Washer Rolling x 1.25_93882A213.ipt, 10-32 Nylock Nut.ipt, 125 x 124 x 700 Machine Key.ipt, 14-20 Nylock Nut_97135A210.ipt, 1614Z Bearing.ipt, 1800x375 brass spacer.ipt, 185x385 washer 17W06272.ipt, 19T 20dp 375h_Inch - Spur gear 20DP 19T 14.5PA .575FW ---S19N.5H1L0.375N.ipt]
2018-06-26 Attempt to add back in Andy-Mark folder.
    [#4x1.00, Plastic Thread Rolling Screw, Pan Head, Cross Recessed, Zinc Plated (Plastic Applications)_Fastenal__5E0B_15FCAA.0001.ipt, #4x1.00, Plastic Thread Rolling Screw, Pan Head, Cross Recessed, Zinc Plated (Plastic Applications)_Fastenal__5E0B_15FCAA.ipt, #4x1.00, Plastic Thread Rolling Screw, Pan Head, Cross Recessed, Zinc Plated (Plastic Applications)_Fastenal__5E0B_15FCAA_MIR.ipt, 0.1875 e-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]
2018-06-26 Attempt to fix McMaster-Carr folders.
    [1556A170.0002.ipt, 1556A170.STEP, 1556A170.ipt, 1556A170_BRACKET.STEP, 1556A170_MIR.ipt, 1556A540.STEP, 1556A550_BRACKET.STEP, 1603A700_SURFACE-MOUNT HINGE.STEP]
2018-06-26 Changed directory/folder names in McMaster-Carr to be camelCase.
    [4880K470_STANDARD-WALL WHITE PVC PIPE FITTING.STEP, 84915A210_STL RETRACTABLE SPRING PLUNGER W KNURLED KNOB.STEP, 90044A118.STEP, 90044A123.STEP, 90044A123.ipt, 91251A345.STEP, 92735A230_GROOVED CLEVIS PIN WITH RETAINING RING.STEP, 92735A230_GROOVED CLEVIS PIN WITH RETAINING RING.ipt]
2018-06-27 Updated RevRobotics 2 stage lift for 2019 version of autodesk inventor.
    [#10-32 0.5 Inch Flat-head Socket Cap Screw.0001.ipt, #10-32 0.5 Inch Flat-head Socket Cap Screw.0002.ipt, #10-32 0.5 Inch Flat-head Socket Cap Screw.ipt, 10-32 0.375 inch Long with Nut Assembly.0002.iam, 10-32 0.375 inch Long with Nut Assembly.0003.iam, 10-32 0.375 inch Long with Nut Assembly.iam, 10-32 0.375 inch Long.0001.ipt, 10-32 0.375 inch Long.0002.ipt]
2018-06-28 Adding 2016 PTC models.
    [2016_frc_fop.iam, 3c_balls.ipt, AM-0028.ipt, AM-0033.ipt, AM-0034.ipt, AM-0149.ipt, AM-0152.ipt, AM-0176.ipt]
2018-07-05 Cleaning up rhino track drive module.
    [0985x0420 PVC Spacer.0001.ipt, 0985x0420 PVC Spacer.ipt, 10-24 Hex Washer Rolling x 1.25_93882A213.0001.ipt, 10-24 Hex Washer Rolling x 1.25_93882A213.ipt, 10-32 Nylock Nut.0001.ipt, 10-32 Nylock Nut.ipt, 10-32x0625_shcs_HX-SHCS 0.19-32x1.375x1-C.0001.ipt, 10-32x0625_shcs_HX-SHCS 0.19-32x1.375x1-C.ipt]
2018-07-05 Updating rhino track models.
2018-07-05 Changed rhino track from step file to .iam and .ipt files.
    [0985x0420 PVC Spacer.ipt, 10-24 Hex Washer Rolling x 1.25_93882A213.ipt, 10-32 Nylock Nut.ipt, 10-32x0625_shcs_HX-SHCS 0.19-32x1.375x1-C.ipt, 1614Z Bearing.ipt, 16t 20dp 375h with teeth.ipt, 20T pulley back to back.iam, 3-8-16 NyLock Nut - Mcm 95615A140_95615A140.ipt]
2018-07-05 Add left and right rhino track modules to seperate files.
    [0985x0420 PVC Spacer.ipt, 10-24 Hex Washer Rolling x 1.25_93882A213.ipt, 10-32 Nylock Nut.ipt, 10-32x0625_shcs_HX-SHCS 0.19-32x1.375x1-C.ipt, 1614Z Bearing.ipt, 16t 20dp 375h with teeth.ipt, 20T pulley back to back.iam, 3-8-16 NyLock Nut - Mcm 95615A140_95615A140.ipt]
2018-07-13 Added stl, x3g, and g files for spay cap nozzels. In an attempt to repair the one I broke.
    [WD40_Cap_fixed.stl, sprayCap.g, spraycan_cap.stl, spraycan_cap_1_5mm_hole2.stl]
2018-07-29 Added some measuring spoons folder.
    [0981-rds-WA-0002-v003.ipt, 0981-rds-WA-0002-v003.stl, 100_ml.stl, 100_ml_volume_not_for_print_only_as_reference.stl, 10_ml.stl, 110_ml.stl, 120_ml.stl, 130_ml.stl]
2018-07-31 Added .g file for a 5 milli-liter measuring spoon.
    [MeasSpoon_5_ml.g]
2018-08-01 Created 5 ml measuring spoon with 100 mm handle.
    [MeasSpoon_5ml_100_handle.g, MeasSpoon_5ml_100_handle.stl]
2018-08-01 Updated for 125 mm length handle.
    [MeasSpoon_V11.scad]
2018-08-04 Added a 15 ml (1 tablespoon) measuring spoon.
    [MeasSpoon_15ml_100_handle.stl, MeasSpoon_15ml_125_handle.stl, MeasSpoon_V11.scad]
2018-08-04 Added pill grinder.
    [05_petite_roue.stl, 06_bout_bas.stl, 07_bout_haut.stl, 08_poignee.stl, 09_tirroir_v2.stl]
2018-08-28 Update CIM motor model.
    [am-0255+2.5inch+CIM+Motor.ipt]
2018-08-28 Added CIM-Sport gearbox.
    [10-32 X 375 SHCS_90128A940.ipt, 10-32 x 3.000 SHCS_90128A969.ipt, 12T Long Planet Gear.ipt, 12T Short Planet Gear.ipt, 16T Planet Gear.ipt, 24T Long Long Sun Gear.ipt, 24T Long Sun Gear.ipt, 3_1 HD Output Stage Carrier Plate.ipt]
2018-09-25 Updated pully model.
    [0500Hex1000ODPulley.dwg, 0500Hex1000ODPulley.ipt]
2018-12-05 Added files that include Raspberry Pi camera models.
    [RPi_Camera_Focus_Tool.stl, RPi_Camera_Lens_Socket_wrench.6.g, RPi_Camera_Lens_Socket_wrench.6.stl, RPi_Lens_Spanner.5.stl, raspy_cam_wrench_C.6.obj, raspy_cam_wrench_C.6a.obj, rpi-cam-cap.stl, rpi-cam-tube.stl]
2019-01-13 Added more McMaster-Carr models.
    [1_4-20 0_312 94459A370_BRASS HEAT-SET INSERT FOR PLASTIC.STEP, 1_4-20 0_312 94459A370_BRASS HEAT-SET INSERT FOR PLASTIC.ipt, 1_4-20 0_375 94459A380_BRASS HEAT-SET INSERT FOR PLASTIC.STEP, 1_4-20 0_375 94459A380_BRASS HEAT-SET INSERT FOR PLASTIC.ipt, 1_4-20_ 0_500 94459A390_BRASS HEAT-SET INSERT FOR PLASTIC.STEP, 1_4-20_ 0_500 94459A390_BRASS HEAT-SET INSERT FOR PLASTIC.ipt, 2-16 0_100 94459A230_B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]
2019-01-14 Files for raspberry pi camera from thingiverse.com.
    [rpi-cam-cap.ipt, rpi-cam-tube.dwg, rpi-cam-tube.ipt]
2019-01-23 Attempting to update the repository with models from my computer.
    [Camera Lense.ipt, Camera PCB connector.ipt, Container100x75.stl, Container20x10.stl, Container20x15.stl, Container20x20.stl, Container20x30.stl, Container20x40.stl]
2019-01-23 Added mechanical drawing of the pi and pi camera.
2019-02-06 Updates to the rev robotics lift and new parts.
    [REV-21-1578.STEP, REV-21-1578.ipt, REV-21-1578.stl]
2019-02-06 Some 2019 updates.
    [#10-32 0.5 Inch Flat-head Socket Cap Screw.ipt, 10-32 0.375 inch Long with Nut Assembly.iam, 10-32 0.375 inch Long.ipt, 10-32 0.5 inch Long countersunk flat head with Nut Assembly.iam, 10-32 0.5 inch Long with Nut Assembly.iam, 10-32 0.5 inch Long.ipt, 10-32 Slim Nylock Nut.ipt, 1in extrution inside corrner bracket.ipt]
2019-02-07 Adding cad files from the revrobotics web site.
    [Linear Motion V2 Example.STEP, REV-21-1650.STEP, REV-25-1290.STEP, REV-31-1230.STEP, REV-31-1293.STEP, REV-31-1302.STEP, REV-31-1387.STEP, REV-31-1425.STEP]
2019-02-17 Solder Iron
    [Soldering_Iron_Stand_NoSupport.STL, Soldering_Iron_Stand_NoSupport.g, Soldering_Iron_Stand_WithSupport.STL]
2019-02-25 Adding some additional parts from the RevRobotics web site.
    [REV-21-1000.STEP, REV-29-1016.STEP, REV-29-1016.ipt, REV-29-1221.STEP, REV-29-1221.ipt, revRobotics10-32x3-8inchesLong.ipt]
2019-02-25 Update to and ipt file.
    [Container150x75.ipt]
2019-03-06 Changed name of 6-32 insert to include length and changed color to brass.
    [6-32 0_281 94459A290_BRASS HEAT-SET INSERT FOR PLASTIC.STEP, 6-32 0_281 94459A290_BRASS HEAT-SET INSERT FOR PLASTIC.ipt, 6-32 94459A290_BRASS HEAT-SET INSERT FOR PLASTIC.ipt]
2019-03-06 Changed the name of the 1/4 inserts to remove an unnecessary '_'
    [1_4-20 0_500 94459A390_BRASS HEAT-SET INSERT FOR PLASTIC.STEP, 1_4-20 0_500 94459A390_BRASS HEAT-SET INSERT FOR PLASTIC.ipt]
2019-05-05 Removing files from Old Versions
    [#10-32 0.5 Inch Flat-head Socket Cap Screw.0001.ipt, #10-32 0.5 Inch Flat-head Socket Cap Screw.0002.ipt, 10-32 0.375 inch Long with Nut Assembly.0002.iam, 10-32 0.375 inch Long with Nut Assembly.0003.iam, 10-32 0.375 inch Long.0001.ipt, 10-32 0.375 inch Long.0002.ipt, 10-32 0.5 inch Long countersunk flat head with Nut Assembly.0003.iam, 10-32 0.5 inch Long with Nut Assembly.0002.iam]
2019-05-07 Fixing lift models.
    [REV-25-1238.iam, REV-25-1290.iam]
2019-05-09 Continuted cleanup
    [1in extrution inside corrner bracket.ipt, 1in extrution inside corrner bracket_Chain holes.ipt, Belt1-1^2 post lift.ipt, Belt2-2^2 post lift.ipt, Belt3-3^2 post lift.ipt, Belt4-1^2 post lift.ipt, Belt5-4^2 post lift.ipt, Container150x75.ipt]
2019-07-06 u bolt component.
    [3042T870_CLAMPING U-BOLT.STEP, 3042T870_CLAMPING U-BOLT.ipt]
2019-07-06 Removed step file.
    [6-32 94459A290_BRASS HEAT-SET INSERT FOR PLASTIC.STEP]
2019-07-18 Updated files.
    [92949A271_18-8 SS BUTTON-HEAD SOCKET CAP SCREW.ipt, AM 2488 CIM bracket.ipt, Meade-mount_plate_Spaced.stl, SmallGear_M4.stl, Soldering_Iron_Stand_NoSupport.ipt, am-0134a+375+Key+Hub+r2.ipt, customWasher.ipt]
2019-10-10 Additional heat set inserts that can be used on the light ring.
    [10-32 0_150 93365A240_HEAT-SET INSERTS FOR PLASTICS.STEP, 10-32 0_225 93365A154_HEAT-SET INSERTS FOR PLASTICS.STEP, 10-32 0_375 93365A156_HEAT-SET INSERTS FOR PLASTICS.STEP, 8-32 0_185 93365A140_HEAT-SET INSERTS FOR PLASTICS.STEP, 8-32 0_312 93365A142_HEAT-SET INSERTS FOR PLASTICS.STEP]
2019-11-12 Added light ring models.
    [am-3596LedRing.STEP, am-3596LedRing.ipt]
2019-11-12 Add LIDAR pdf and deleted old versions.
    [AM 2488 CIM bracket.0007.ipt, am-0134a+375+Key+Hub+r2.0001.ipt]
2019-11-24 Removed two unused files.
    [am-3791+-+3000+x+500+Hex+Shaft.STEP]
2019-11-24 Adding new files
    [0985x0420 PVC Spacer.0001.ipt, 0985x0420 PVC Spacer.0002.ipt, 1 Stage SD - 57 Sport.iam, 10-24 Hex Washer Rolling x 1.25_93882A213.0001.ipt, 10-24 Hex Washer Rolling x 1.25_93882A213.0002.ipt, 10-32 Nylock Nut.0001.ipt, 10-32 Nylock Nut.0002.ipt, 10-32 X 375 SHCS_90128A940.ipt]
2019-11-25 Removed OldVersions that were committed by mistake.
    [20T pulley back to back.0001.iam, 20T pulley back to back.0002.iam, 42 - 2014 tooth pulley assembly.0001.iam, 42 - 2014 tooth pulley assembly.0002.iam, 500 Hex Collar Clamp.0001.iam, 500 Hex Collar Clamp.0002.iam, AM 0255 MOT_CIM-Motor_217-2000.0002.iam, am-2598_107 2016 KOP Toughbox Mini.0001.iam]
2019-12-09 Added keyed stock and keys to the list of CAD files.
    [1497K500_FULLY KEYED 1045 STEEL DRIVE SHAFT.STEP, 98491A098_OVERSIZED STEEL MACHINE KEY STOCK.STEP, 98491A098_OVERSIZED STEEL MACHINE KEY STOCK.ipt]
2019-12-11 Added an aluminum keyed shaft.
    [1497K500_FULLY KEYED 1045 STEEL DRIVE SHAFT.STEP, 1570K330_FULLY KEYED ALUMINUM DRIVE SHAFT.STEP]
2019-12-14 Add battery holder ipt file.
    [7712K620_BATTERY HOLDER.ipt]
2019-12-20 Battery handle. One stl has been saved as a .gz file.
    [Center_Spacer.STL]
2019-12-20 Removing .print file that was larger than 50 MB, which is git's limit
2020-01-07 Parts added to support lift mechanism.
    [10-24 Hex Washer Rolling x 1.25_93882A213.ipt, 10-32 Nylock Nut 1_90631A411.ipt, 10-32 Nylock Nut.ipt, 10-32x0500_shcs_HX-SHCS 0.19-32x1.375x1-C.ipt, 1614Z Bearing.ipt, 16t 20dp 375h with teeth.ipt, 19.25in Churro.ipt, 3-8-16 NyLock Nut - Mcm 95615A140_95615A140.ipt]
2020-01-07 Added needle roller thrust bearings and the associated washers. Not converted to ipt format.
    [5909K320_THRUST NEEDLE-ROLLER BEARING.STEP, 5909K330_THRUST NEEDLE-ROLLER BEARING.STEP, 5909K450_THRUST NEEDLE-ROLLER BEARING.STEP, 5909K590_THRUST NEEDLE-ROLLER BEARING.STEP]
2020-01-07 Adding ipt files translated from the STEP files.
    [5909K320_THRUST NEEDLE-ROLLER BEARING.ipt, 5909K330_THRUST NEEDLE-ROLLER BEARING.ipt, 5909K450_THRUST NEEDLE-ROLLER BEARING.ipt, 5909K590_THRUST NEEDLE-ROLLER BEARING.ipt]
2020-01-10 Update models for 2020 robot.
    [am-14U4_FO AM14U4 Frame Only.STEP, am-2954 AM14U2 2x3 Hole Bracket.STEP, am-3311a Intake Motor Mount Bracket.STEP, am-3920 AM14U4 End Plate.STEP, am-3921 AM14U4 Outside Plate.STEP, am-3922 AM14U4 Inside Plate.STEP, am-3974 AM14U4 Cross Plate.STEP, am-3975 AM14U4 Cross Plate XL.STEP]
2020-01-10 Adding in end plate for upgrade kit.
    [am-3920 AM14U4 End Plate.ipt]
2020-01-10 PDF of the extra large frame opening kit from AM.
2020-01-15 Updating models from AM and McMaster-Carr used for 2020 robot.
    [9654K234_STEEL EXTENSION SPRING.ipt, am-2235a Snow Blower Motor With Hex Shaft.STEP]
2020-01-20 Snow blower local update.
    [AM-2235 gear cap.ipt, AM-2235 gearbox housing.ipt, AM-2235 motor.ipt, AM-2235 output shaft.ipt, AM-2235 threaded insert.ipt, AM-2235.iam]
2020-01-20 Adding the mini cim motor to the repository.
    [Mini_CIM_Motor_217-3371.STEP, Mini_CIM_Motor_217-3371.ipt]
2020-01-22 12.5 ml spoon for my trip.
    [MeasSpoon_12_5ml_100_handle.stl]
2020-01-22 Update to parts related to air tank.
    [4373K510_DIVERTING 3-PORT BRONZE BALL VALVE.STEP, 4373K510_DIVERTING 3-PORT BRONZE BALL VALVE.ipt, 4429K411_LOW-PRESSURE BRASS THREADED PIPE FITTING.STEP, 4429K411_LOW-PRESSURE BRASS THREADED PIPE FITTING.ipt, 5779K109_PUSH-TO-CONNECT TUBE FITTING FOR AIR.STEP, 5779K109_PUSH-TO-CONNECT TUBE FITTING FOR AIR.ipt]
2020-01-26 Updates to the 2020 Kit Bot from Andy-Mark
    [10-24 Hex Washer Rolling x 1.25_93882A213.ipt, 10-32 Nylock Nut 1_90631A411.ipt, 10-32 Nylock Nut.ipt, 10-32 Nylock Nut_MIR.ipt, 10-32x0500_shcs_HX-SHCS 0.19-32x1.375x1-C.ipt, 1614Z Bearing.ipt, 16t 20dp 375h with teeth.ipt, 16t 20dp 375h with teeth_MIR.ipt]
2020-01-26 Updated parts related to the toughbox mini transmission.
    [am-0153a Toughbox® Series, Keyed Output Shaft with Magnet.STEP, am-2566a Short 500 Hex Steel Output Shaft with Magnet for Toughbox Series.STEP]
2020-01-27 Removing tracked files in old versions that should not have been part of the repository.
    [AM-2235 gear cap.0001.ipt, AM-2235 gearbox housing.0001.ipt, AM-2235 motor.0001.ipt, AM-2235 output shaft.0001.ipt, AM-2235 threaded insert.0001.ipt]
2020-02-11 Added in ipt files for the 10-32 heat set inserts.
    [10-32 0_150 93365A240_HEAT-SET INSERTS FOR PLASTICS.ipt, 10-32 0_225 93365A154_HEAT-SET INSERTS FOR PLASTICS.ipt, 10-32 0_375 93365A156_HEAT-SET INSERTS FOR PLASTICS.ipt]
2022-01-15 Catching up with files from McMaster-Carr.
    [10-32 0_375 93365A156_Tapered Heat-Set Inserts for Plastic.ipt, 10-32 0_375 94459A360_Heat-Set Inserts for Plastic.STEP, 10-32 0_375 94459A360_Heat-Set Inserts for Plastic.ipt, 10-32x0_250_94459A340_BRASS HEAT-SET INSERT FOR PLASTIC.STEP, 10-32x0_250_94459A340_BRASS HEAT-SET INSERT FOR PLASTIC.ipt, 10-32x0_310_BRASS HEAT-SET INSERT FOR PLASTIC.STEP, 10-32x0_310_BRASS HEAT-SET INSERT FOR PLASTIC.i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]
2022-01-15 Store .dwg files into git repository.
    [1_4x0_375-94459A380_BRASS HEAT-SET INSERT FOR PLASTIC.dwg, 94459A310_BRASS HEAT-SET INSERT FOR PLASTIC.dwg]
2022-01-15 Updated iam and ipt files from AndyMark.
    [0985x0420 PVC Spacer.ipt, 10-24 Hex Washer Rolling x 1.25_93882A213.ipt, 10-32 Nylock Jam Nut_90633A411.ipt, 10-32 Nylock Nut.0001.ipt, 10-32 Nylock Nut.ipt, 10-32x0500 - Mcm 91251A342_91251A342.ipt, 10-32x1500_shcs_HX-SHCS 0.19-32x1.375x1-C.ipt, 1614Z Bearing.ipt]
2022-01-15 More files from McMaster-Carr.
    [1_4x0_375-94459A380_BRASS HEAT-SET INSERT FOR PLASTIC.0001.ipt, 4880K637_STANDARD-WALL WHITE PVC PIPE FITTING.STEP, 4880K637_STANDARD-WALL WHITE PVC PIPE FITTING.ipt, 6-32 x 0_250 92949A144_18-8 Stainless Steel Button Head Hex Drive Screw.STEP, 6-32 x 0_500 92949A148_18-8 Stainless Steel Button Head Hex Drive Screw.STEP, 6-32 x 0_500 92949A148_18-8 Stainless Steel Button Head Hex Drive Screw.ipt,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]
2022-01-16 Added recent version of CIM motor.
    [AM 0255 MOT_CIM-Motor_217-2000.iam, am-0255 2.5inch CIM Motor.STEP, am-0255 2.5inch CIM Motor.ipt, am-0255+2.5inch+CIM+Motor.ipt]
2022-01-17 Removed a bracket AM no long sells and added a new bracket AM is selling for CIM motors and other motors as well.
    [AM 2488 CIM bracket.ipt, AM 2488 CIM bracket_MIR.ipt, AM 2488 CIM bracket_MIR1.ipt, AM 2488 CIM bracket_MIR2.ipt, AM 2488 CIM bracket_MIR3.ipt, am-4244 1IN Bent Bearing Side Mount Gusset.STEP, am-4244 1IN Bent Bearing Side Mount Gusset.ipt]
2022-01-22 Removed unused file.
    [am-3311_IntakeMotorMountBracketRev2.ipt]
2022-03-09 Updated measuring spoon files.
    [MeasSpoon_3_5tsp_150_handle.stl, MeasSpoon_5_ml.g, MeasSpoon_5ml_100_handle.g, MeasSpoon_7tsp_150_handle.stl]
